73jn/td-fpga-developing-board/documents/Presentation_final/assembly.jpg

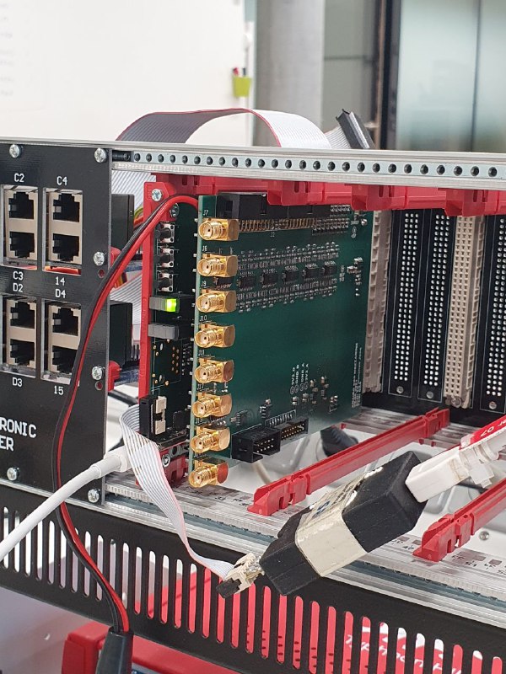
documents/Presentation_final/assembly.jpg
