73jn/td-fpga-developing-board/FPGA-POETIC/ReferenceBoards/FPGA-Rack_v1/01_Doc/Intern/Whiteboard_schematic.jpg

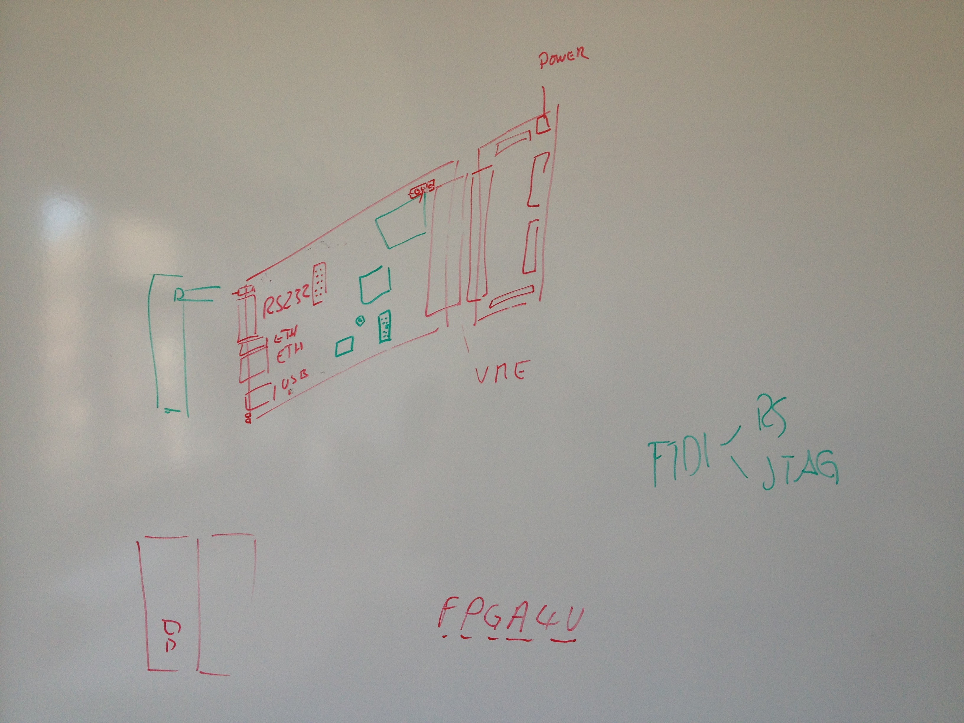
FPGA-POETIC/ReferenceBoards/FPGA-Rack_v1/01_Doc/Intern/Whiteboard_schematic.jpg
