73jn/td-fpga-developing-board/README.md

# td-fpga-developing-board
FPGA developing board for power electronics
