73jn/td-fpga-developing-board/documents/Rapport_intermédiaire/Rapport.docx

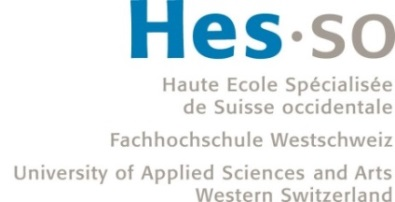
[picture p86: figure]

Filière Systèmes industriels

Orientation Infotronics

Travail de bachelor

Diplôme 2021

Alexandre Figueiredo

Cadeau

| Professeur Dr. Francesco Carrino
| Expert Alain Gruet
| Date de la remise du rapport 20.08.2021, 12 :00

Ce rapport est l'original remis par l'étudiant.
Il n'a pas été corrigé et peut donc contenir des inexactitudes ou des erreurs

HES-SO Valais-Wallis • rte du Rawil 47 • C.P. • 1950 Sion 2 +41 27 606 85 23 • info.ete@hevs.ch • www.hevs.ch/ete Page | 3

HES-SO Valais-Wallis • rte du Rawil 47 • C.P. • 1950 Sion 2 +41 27 606 85 23 • info.ete@hevs.ch • www.hevs.ch/ete
