73jn/td-fpga-developing-board/Schema_bloc/SchemaBlocV2.pdf

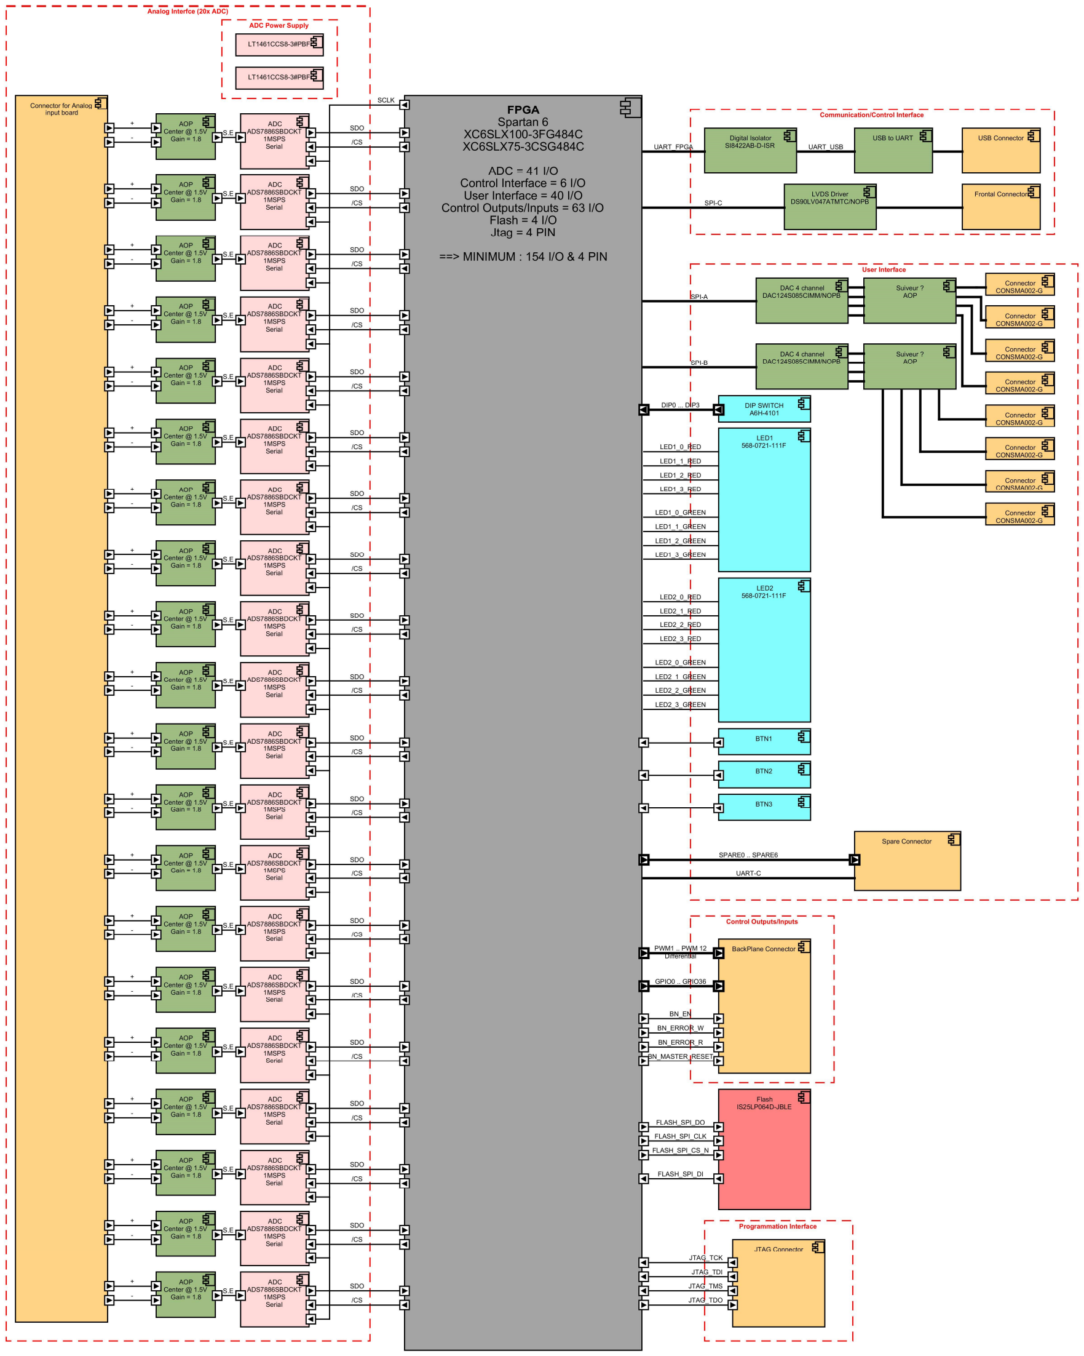
[picture p87: page 1]
