73jn/td-fpga-developing-board/Simulations/SimulationAnalogDifferential.pdf

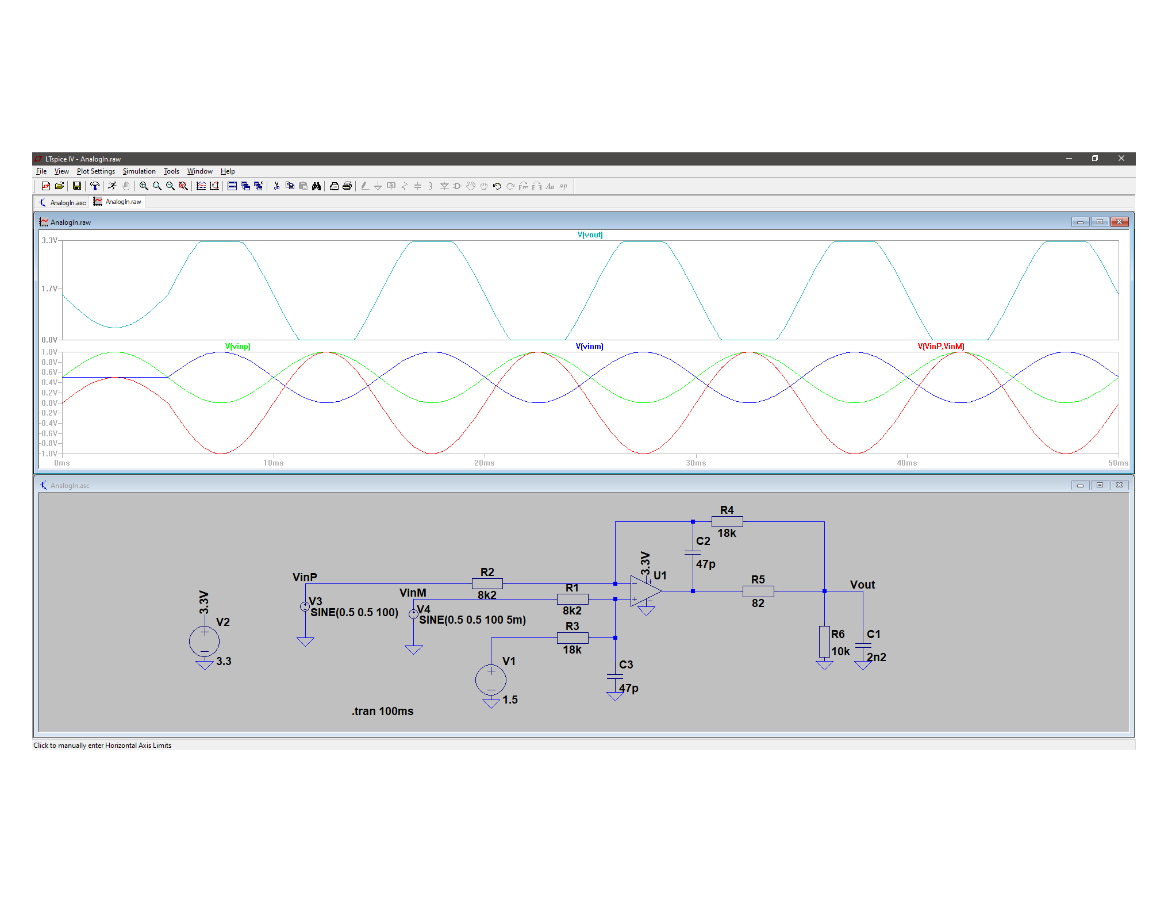
[picture p88: page 1]
