73jn/td-fpga-developing-board/Simulations/200k_0_7MSPS.pdf

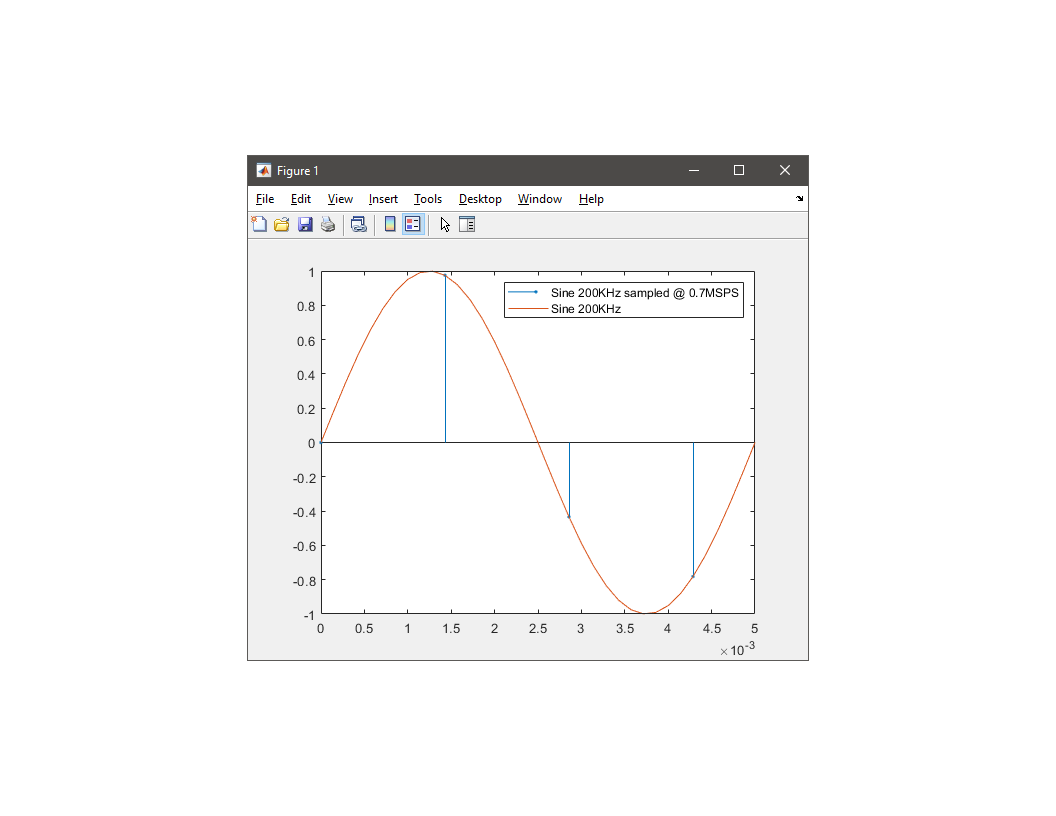
[picture p89: page 1]
