73jn/td-fpga-developing-board/Simulations/Sine200k_14MSPS.pdf

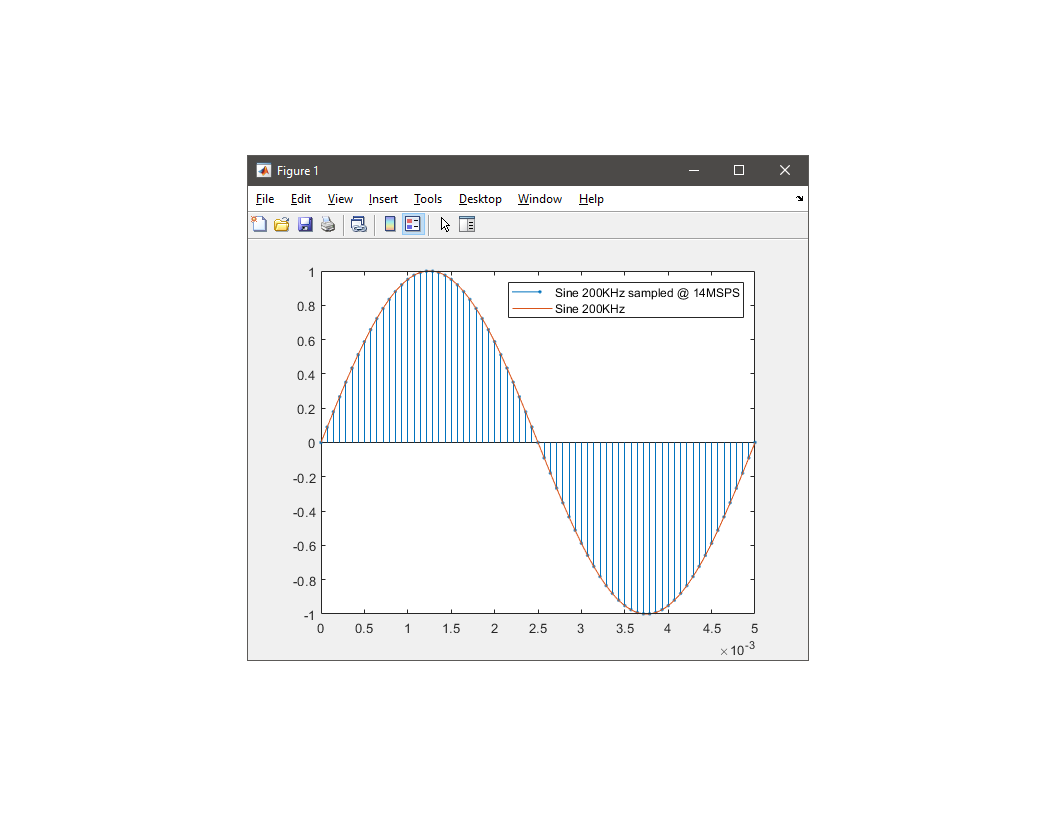
[picture p90: page 1]
