73jn/td-fpga-developing-board/Simulations/Sine200k_20MSPS.pdf

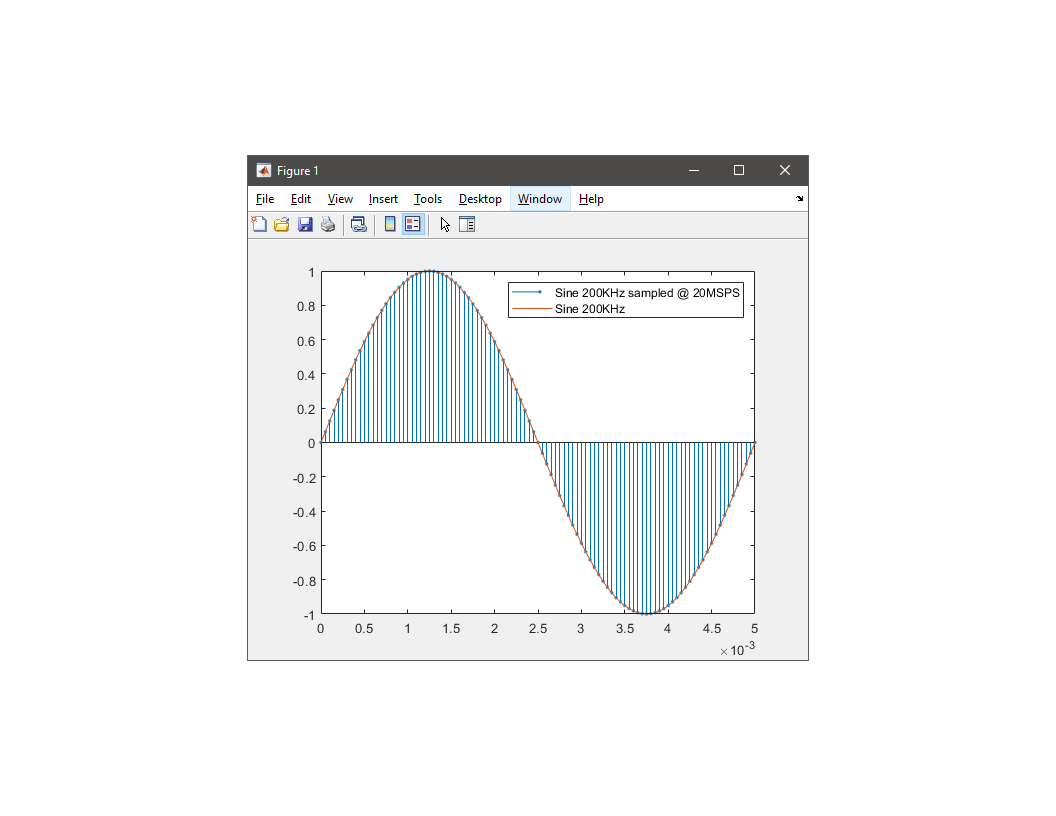
[picture p91: page 1]
