73jn/td-fpga-developing-board/Simulations/Sine200k_25MSPS.pdf

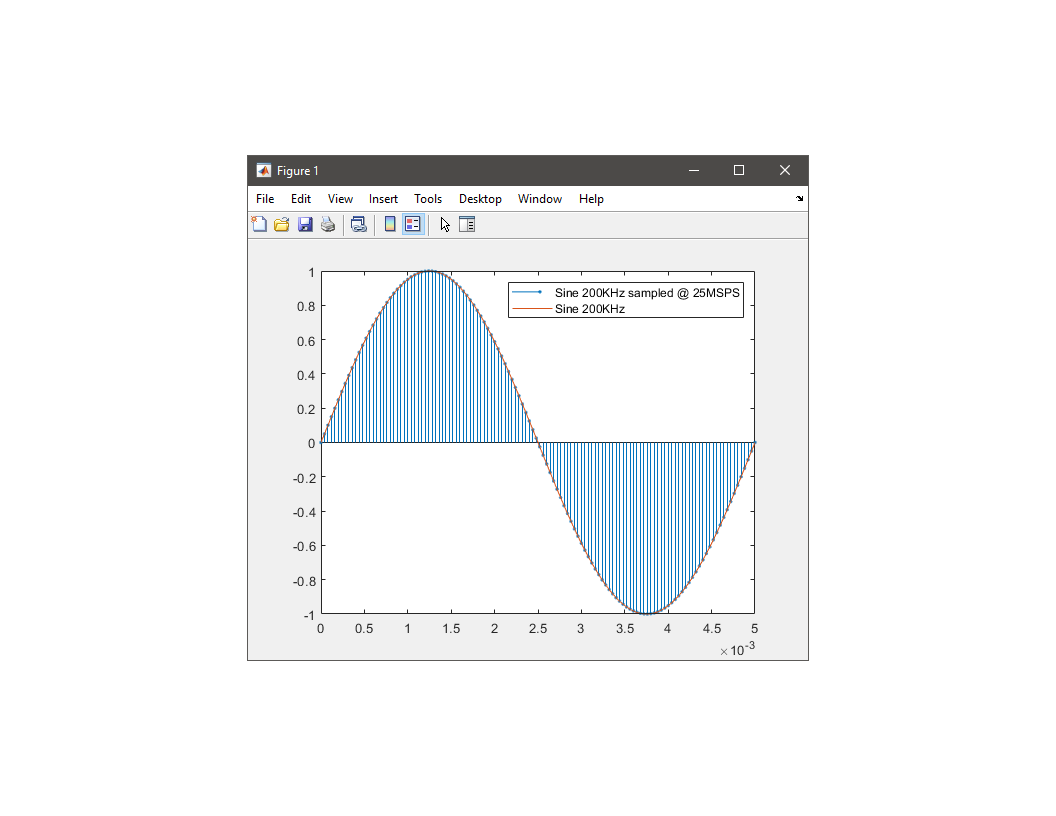
[picture p92: page 1]
