73jn/td-fpga-developing-board/Simulations/Sine200k_65MSPS.pdf

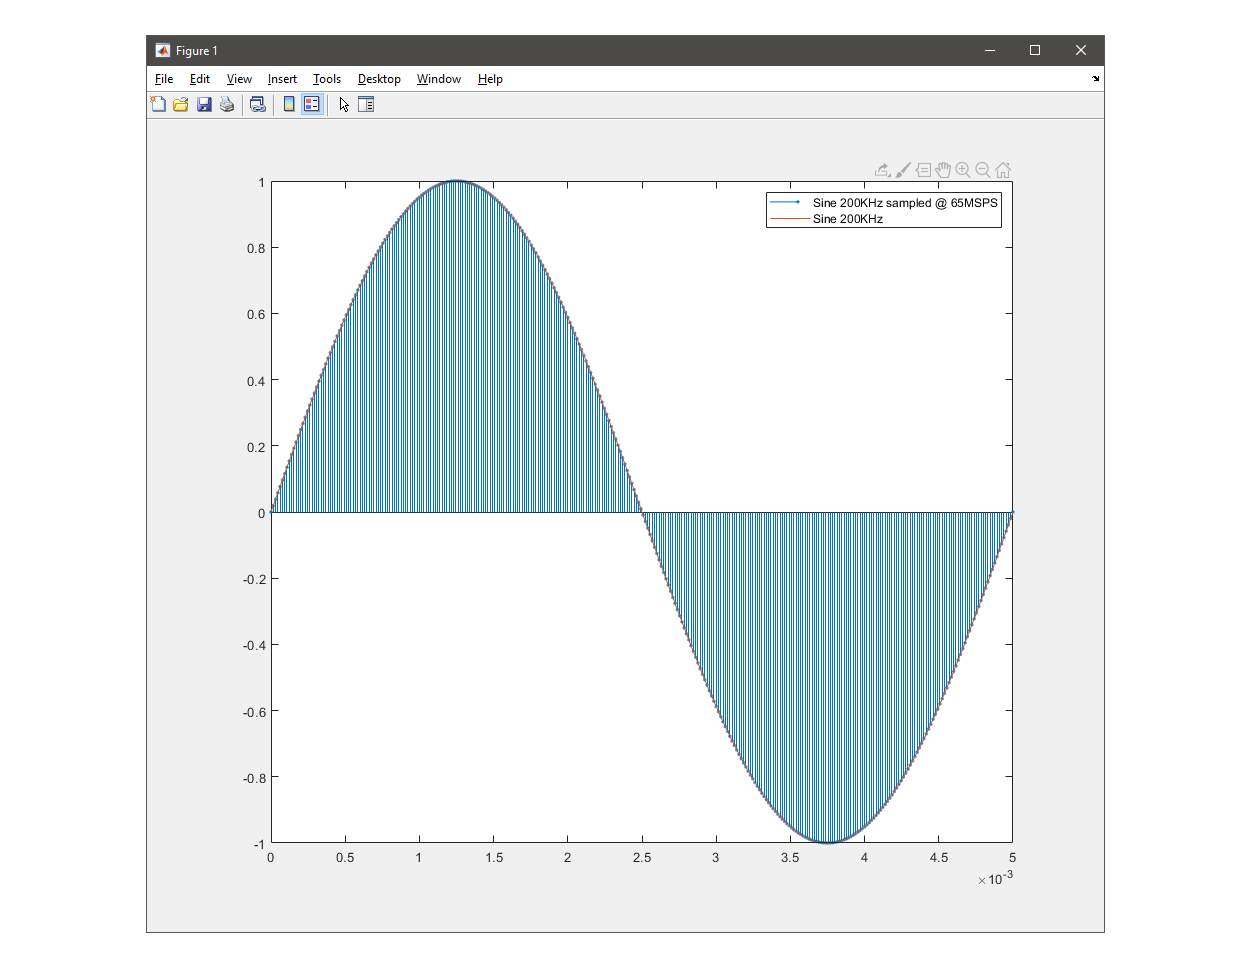
[picture p93: page 1]
