73jn/td-fpga-developing-board/Schema_bloc/SchemaBlocV1.pdf

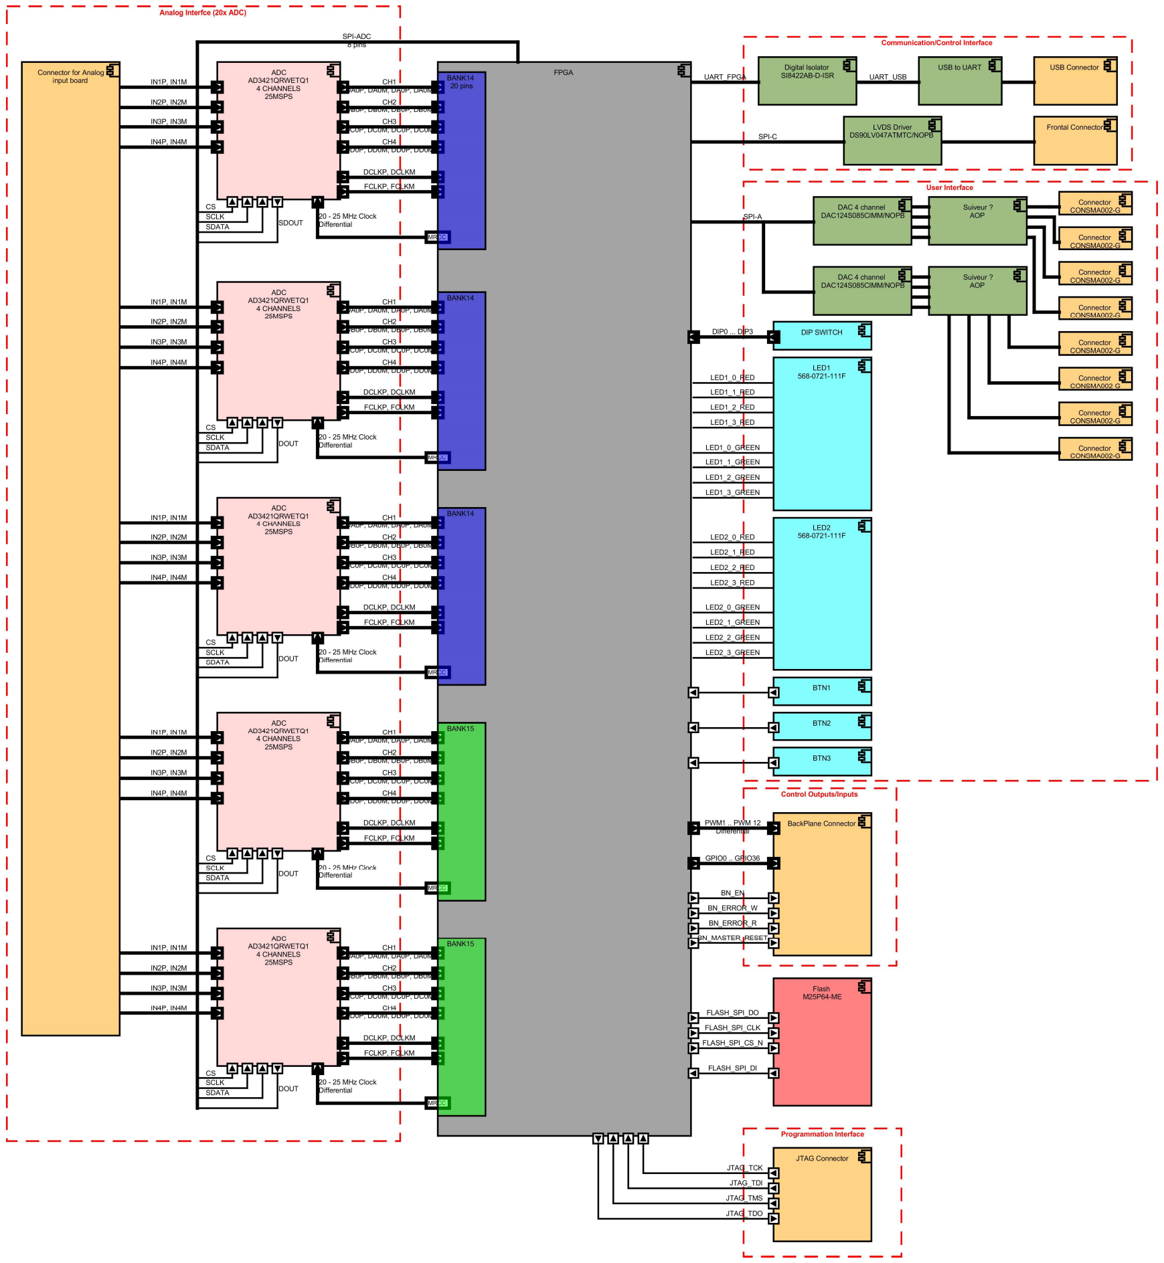
[picture p94: page 1]
