73jn/td-fpga-developing-board/documents/Presentation_final/bloc_rack.png

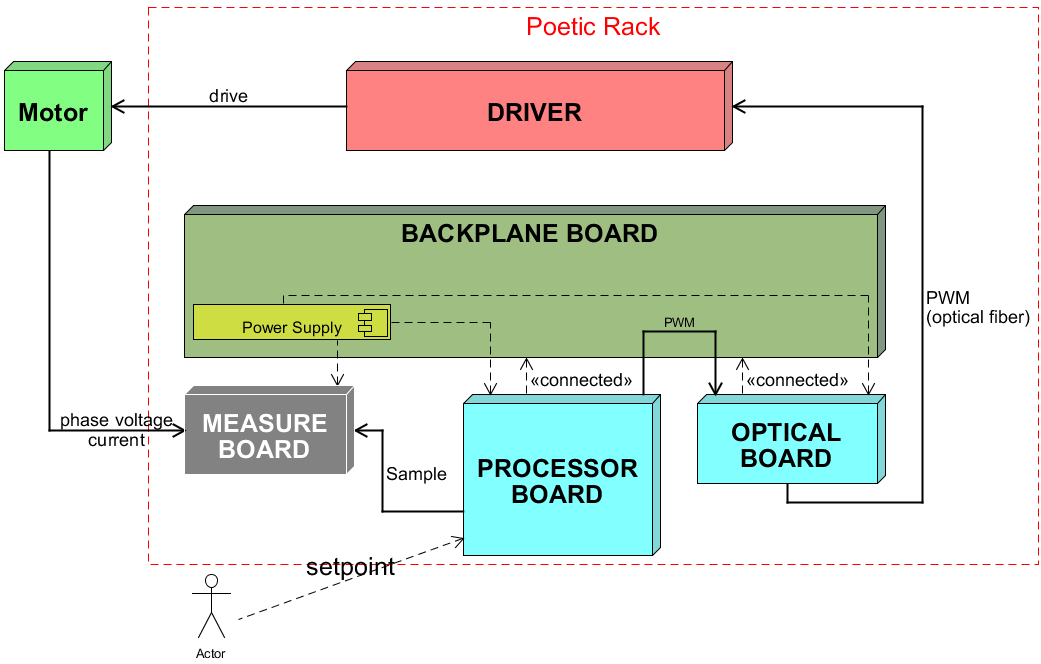
documents/Presentation_final/bloc_rack.png
