73jn/td-fpga-developing-board/documents/Presentation_final/hil.gif

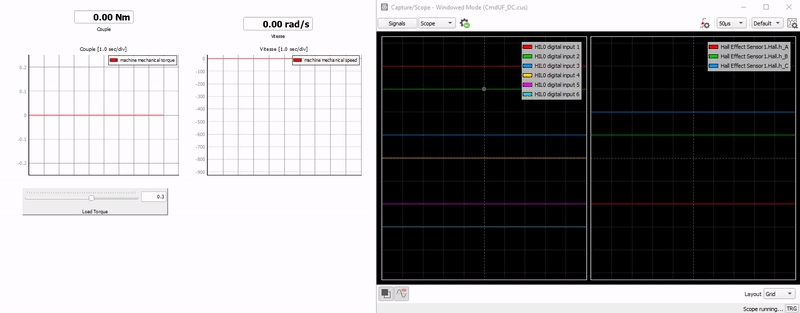
documents/Presentation_final/hil.gif
