73jn/td-fpga-developing-board/documents/Presentation_final/t1k.jpg

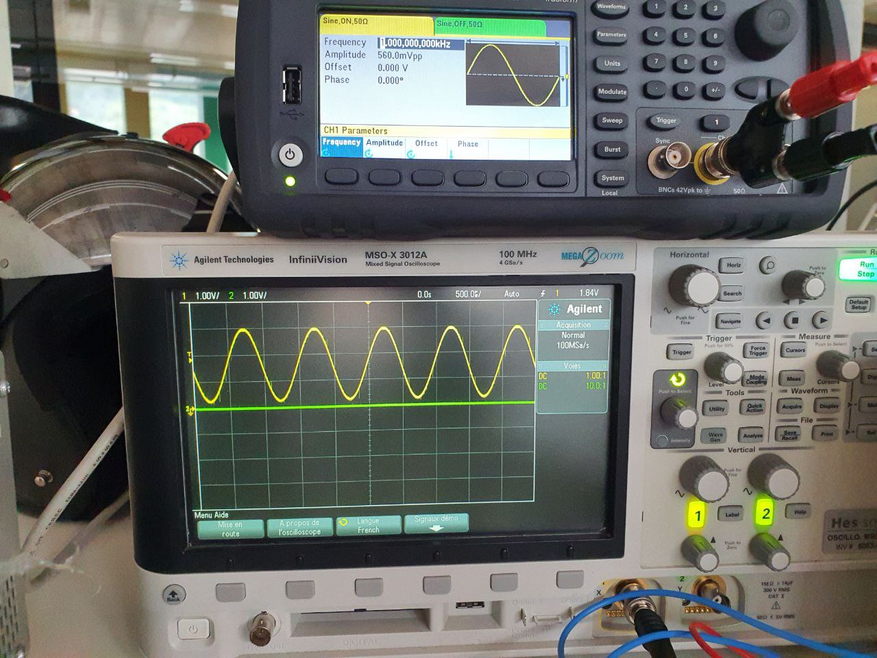
documents/Presentation_final/t1k.jpg
