73jn/td-fpga-developing-board/documents/Presentation_final/t25k.jpg

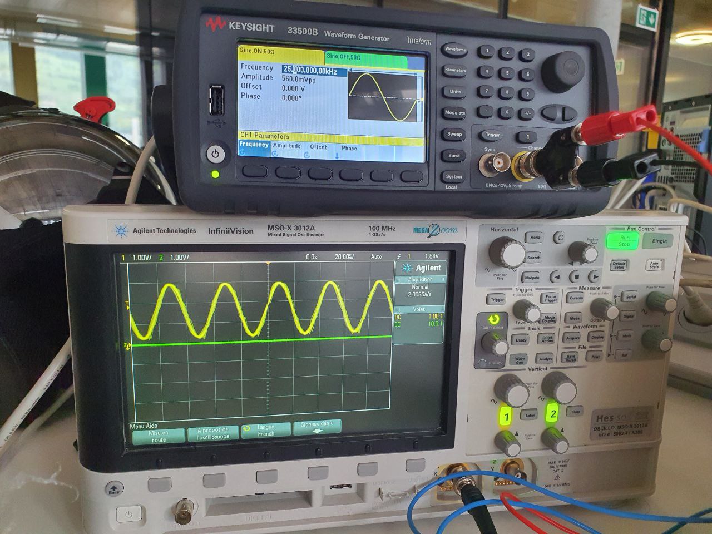
documents/Presentation_final/t25k.jpg
