73jn/td-fpga-developing-board/documents/Presentation_final/t50k.jpg

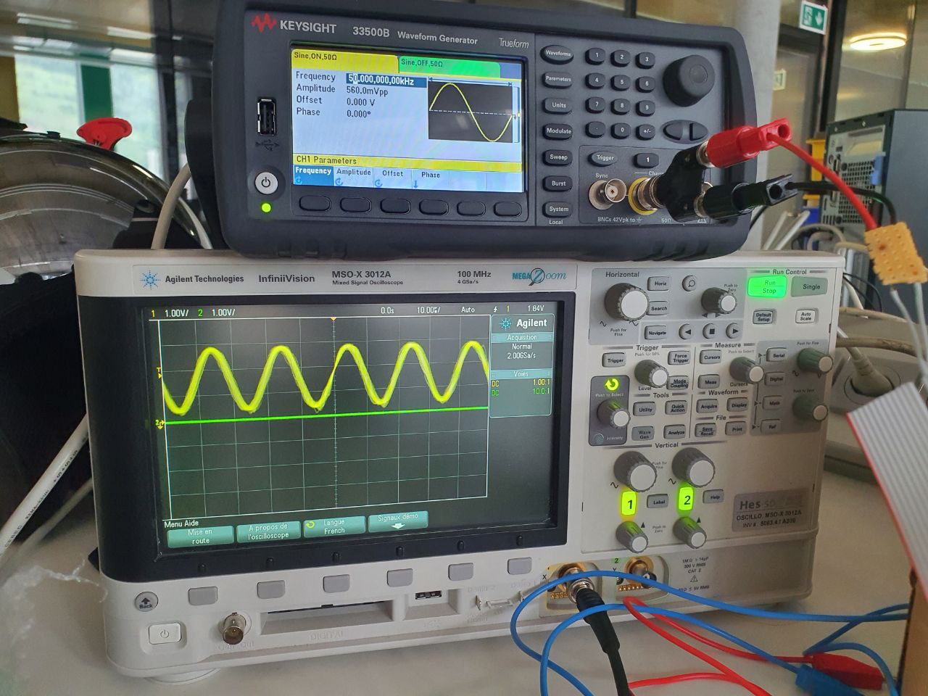
documents/Presentation_final/t50k.jpg
