73jn/td-fpga-developing-board/FPGA-POETIC/ReferenceBoards/FPGA-Rack_v1/01_Doc/Intern/fpga_rack_system.png

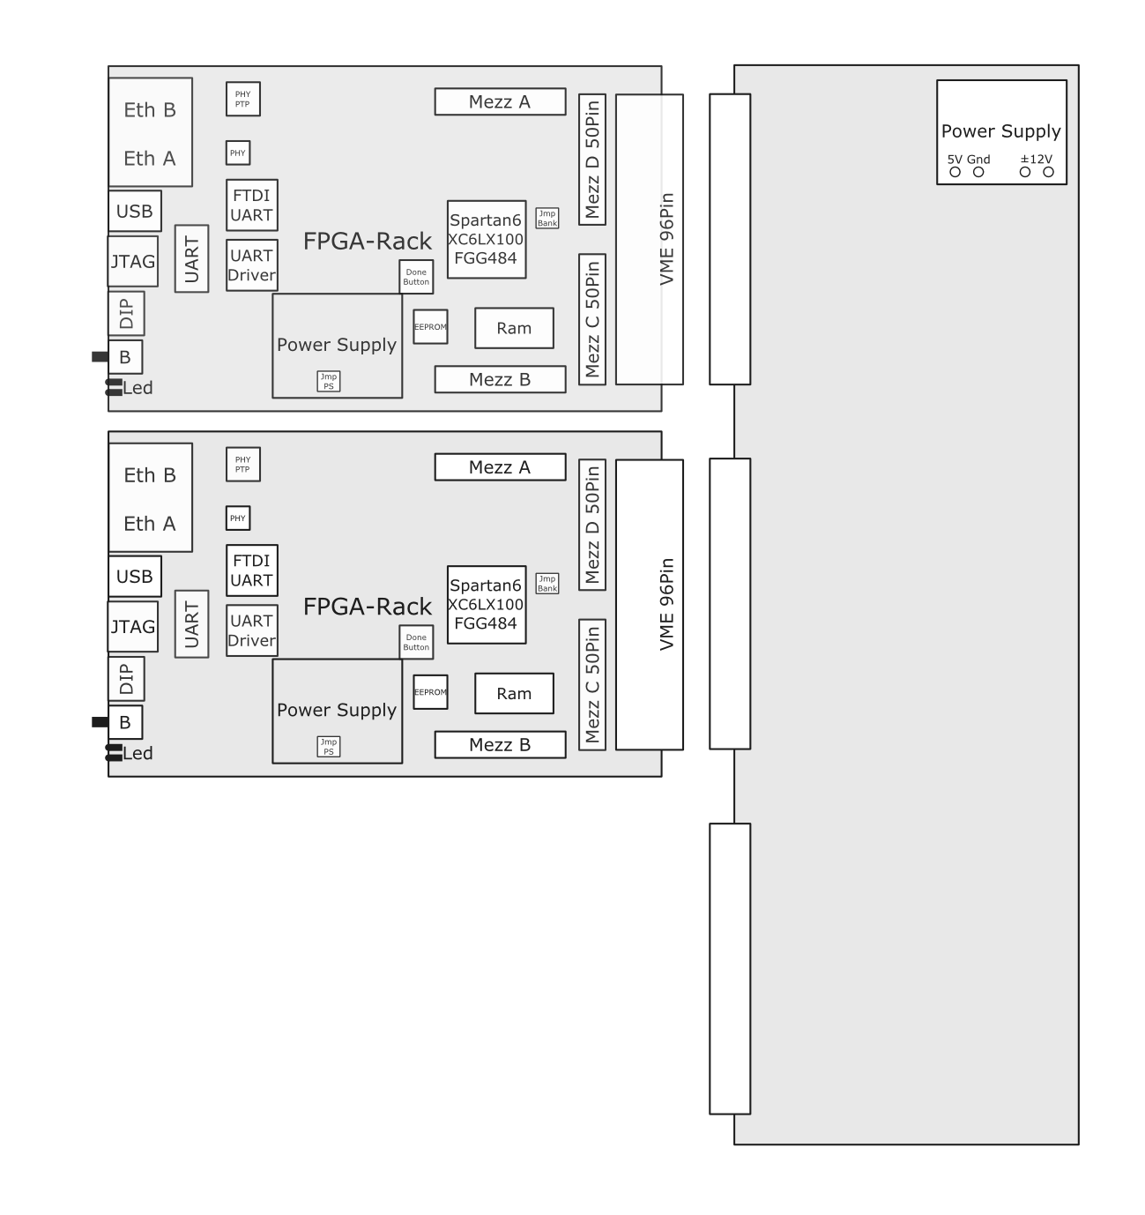
FPGA-POETIC/ReferenceBoards/FPGA-Rack_v1/01_Doc/Intern/fpga_rack_system.png
