73jn/td-fpga-developing-board/FPGA-POETIC/ReferenceBoards/FPGA-Rack_v1/04_PCB/FPGA_Rack_v1_0.jpg

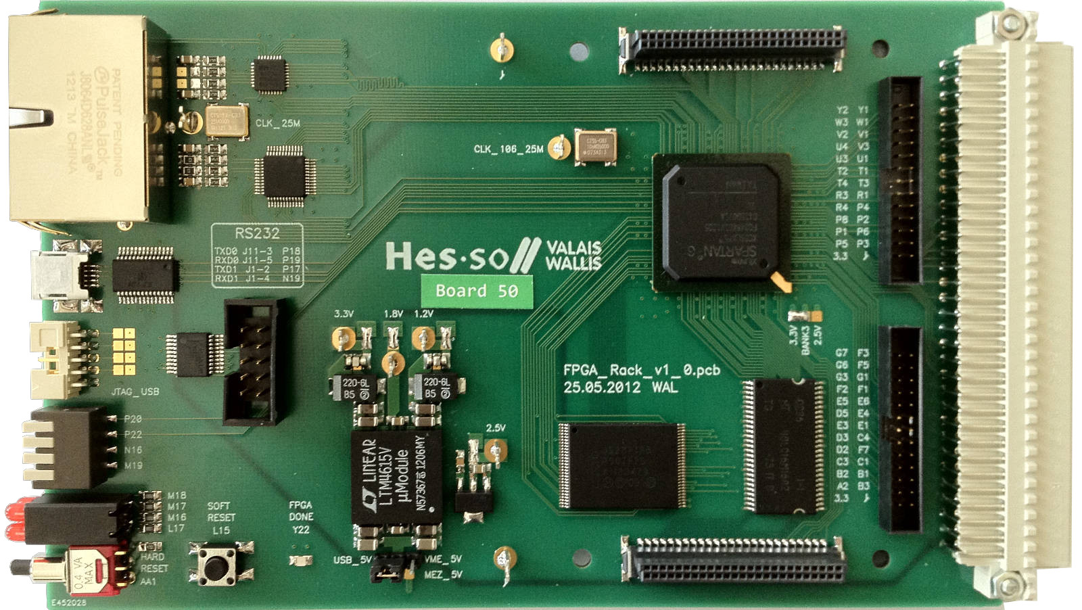
FPGA-POETIC/ReferenceBoards/FPGA-Rack_v1/04_PCB/FPGA_Rack_v1_0.jpg
