73jn/td-fpga-developing-board/FPGA-POETIC/ReferenceBoards/FPGA-Rack_v1/FPGARack_LedsnButtons.png

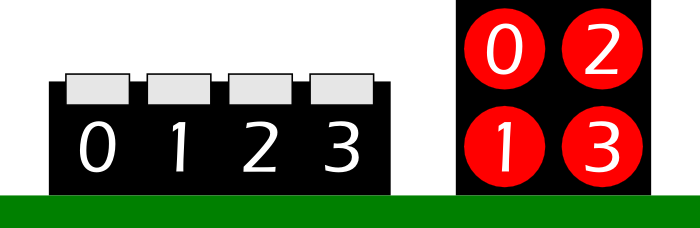
FPGA-POETIC/ReferenceBoards/FPGA-Rack_v1/FPGARack_LedsnButtons.png
