73jn/td-fpga-developing-board/FPGA-POETIC/ReferenceBoards/FPGA-Rack_v1/FPGARack_LedsnButtonspage.png

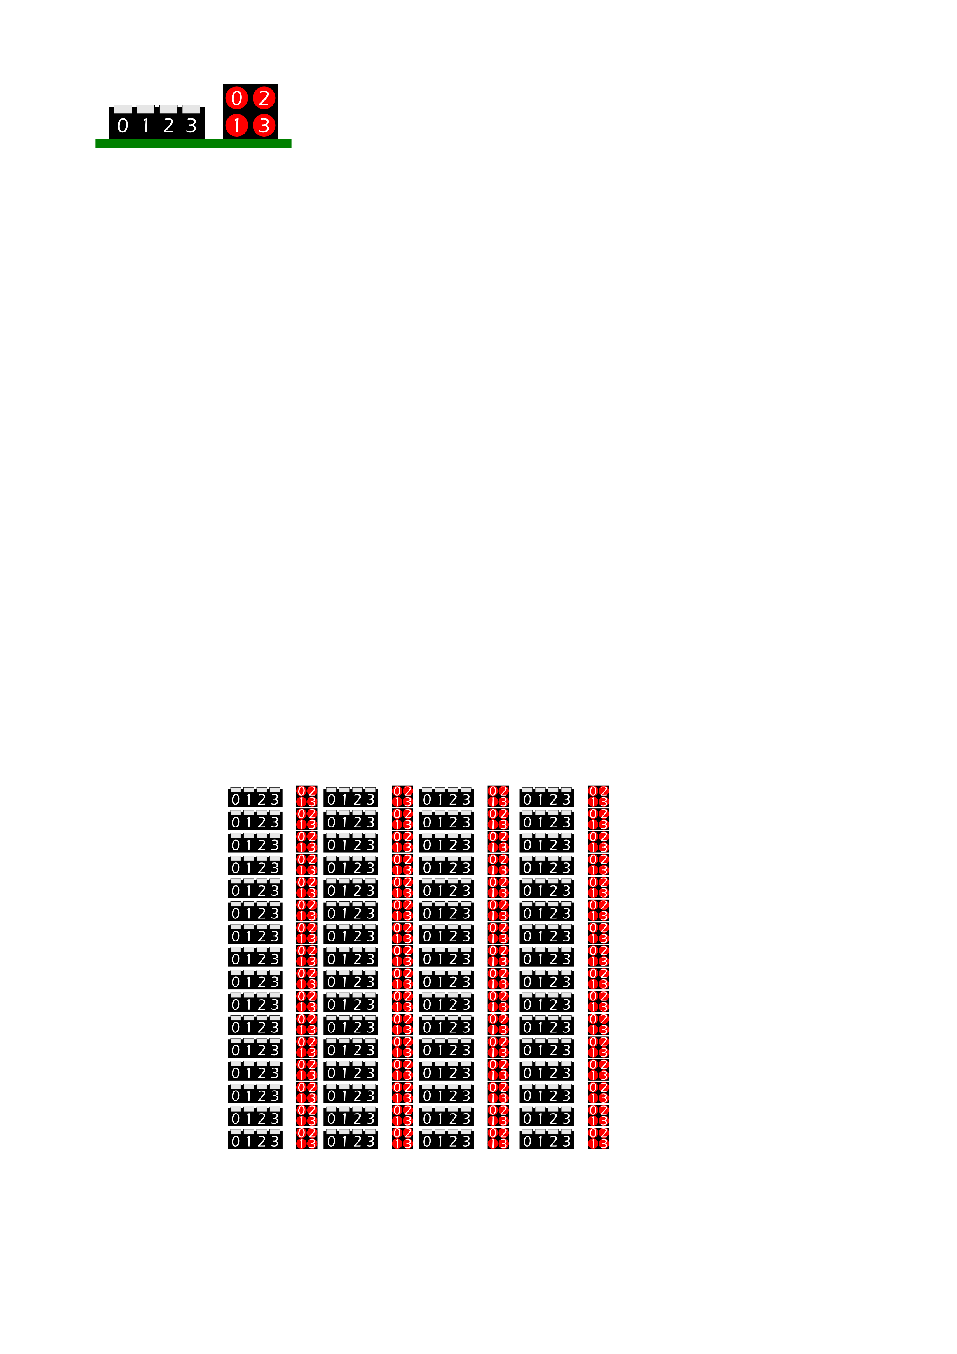
FPGA-POETIC/ReferenceBoards/FPGA-Rack_v1/FPGARack_LedsnButtonspage.png
