73jn/td-fpga-developing-board/summary.png

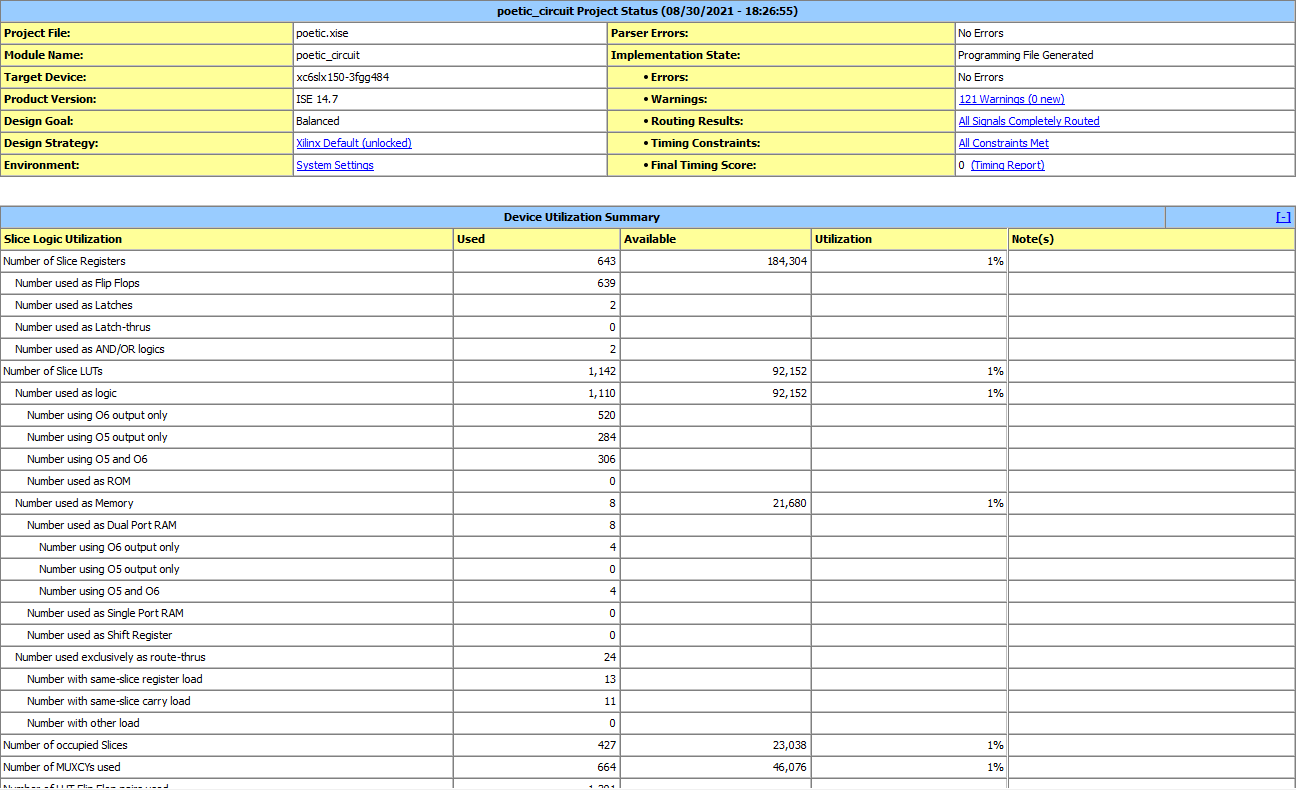
summary.png
