73jn/td-fpga-developing-board/order_files/FichierDeCommandeFpgaDevelopingBoard.xls

Sheet: Sheet1
Personne concernée: | Jean Nanchen
Mandat no.: | TD FPGA DEVELOPING BOARD | Chef de projet / professeur: | Corthay
Salle: | 321 | Délai désiré | 2021-05-19
Mouser |  |  | Monnaie
Quantity | Reference | Designation | Unit Price
1 | 217-C6SLX150-3FG484C | XC6SLX150-3FG484C | 267.00 | 267.00 | UNE LX100 OU LX75 IS OK
1 | 710-150060VS75000 | LED Verte FPGA DONE 2V 20mA | 0.14 | 0.14
2 | 653-B3U-1000P-B | Push buttons Reset | 0.90 | 1.80
1 | 710-831022731 | Quartz 100MHz FPGA | 2.43 | 2.43
1 | 998-KSZ8041TL | Ethernet PHY | 2.39 | 2.39
2 | 78-1N4148WS-HG3-08 | 1N4141 SOD323-2 | 0.36 | 0.73
1 | 710-831019170 | Quartz 25MHz ETH | 1.22 | 1.22
1 | 673-J0011D01BNL | Ethernet RJ45 Connector without EMI Fingers | 8.51 | 8.51
1 | 727-S25FL064LABMA000 | 64Mb flash | 2.20 | 2.20
3 | 506-FSMRA4JH04 | Right angle button FSMRA4JH04 | 0.23 | 0.70
1 | 653-A6H-4101 | Dip Switch | 2.20 | 2.20
1 | 848-RP402N501F-TR-FE | DC/DC 5V 800mA Boost | 1.48 | 1.48
1 | 963-NRS5020T2R2NMGJ | Bobine 2.2uH 5020 | 0.32 | 0.32
1 | 584-ADP2119ACPZ1.2R7 | DC/DC 1.2V Buck | 3.00 | 3.00
1 | 710-74437334015 | Bobine 1.5uH 5020 | 2.32 | 2.32
1 | 947-SC189ZSKTRT | DC/DC 3.3V 1.5A | 1.14 | 1.14
1 | 710-74437334022 | Bobine 2.2uH 5020 3.5A | 2.32 | 2.32
2 | 305-234199 | MEZZANINE 13.65mm FEMALE | 7.40 | 14.80 | MANQUE LA MEZZA, PAS DE STOCK
10 | 81-GRM21BZ70J226ME4L | Capa X7R 22uF 6.3V | 0.46 | 4.60
2 | 645-568-0721-111F | 4 LEDs Bipolar Red-Green Stacked | 3.88 | 7.76
1 | 617-09-03-196-6921 | Connecteur DIN 41612 Backplane | 3.98 | 3.98
2 | 604-AA1608SURSK | LED RED 1.95V | 0.43 | 0.86
1 | 649-98464-G6110ULF | JTAG Right angle Connector | 1.85 | 1.85
1 | 523-12402054M611A | USB C Right angle up | 1.60 | 1.60
1 | 895-FT232RQ | USB Interface to UART FT232RL | 4.31 | 4.31
10 | 81-GRM31CR60J107ME9K | Capa X5R 100uF 3216 | 1.00 | 10.00
15 | 80-C0805X475K9R | Capa X7R 4.7uF 6.3V 0805 | 0.70 | 10.50
30 | 80-C0402C474K9RACTU | Capa X7R 470nF 0402 | 0.46 | 13.80
2 | 754-RG1608P-6491-BT5 | 6.49kOhm 1608 | 0.40 | 0.80
5 | 754-RG1608P-49R9-BT5 | 49.9 Ohm 1608 | 0.40 | 2.00
 |  |  |  | 376.76
Eurocircuit |  |  | Monnaie | CHF
Quantity | Reference | Designation | Unit Price
3 |  | PCB | 83.33 | 250.00
 |  |  |  | 250.00

Sheet: Compatibility Report
Compatibility Report for moule_cmd.xls
Run on 18.10.2017 14:31
If the workbook is saved in an earlier file format or opened in an earlier version of Microsoft Excel, the listed features will not be available.
Minor loss of fidelity | # of occurrences | Version
Some cells or styles in this workbook contain formatting that is not supported by the selected file format. These formats will be converted to the closest format available. | 10 | Excel 97-2003
