73jn/td-fpga-developing-board/order_files/Mezza_FichierDeCommandeFpgaDevelopingBoard.xls

Sheet: Sheet1
Personne concernée: | Jean Nanchen
Mandat no.: | TD Nanchen Jean | Chef de projet / professeur: | Corthay
Salle: | 321 | Délai désiré | 2021-06-18
Mouser |  |  | Monnaie
Quantity | Reference | Designation | Unit Price
20 | 595-ADS7886SBDBVR | AD 1MSPS Serial 1CH 12bits | 4.08 | 81.60
1 | 584-LT1461CCS8-3#PBF | 3V Reference 100mA | 4.31 | 4.31
2 | 926-DAC124S085CIMMNO | DAC 4CH 12bits SPI | 6.87 | 13.74
2 | 200-TSS11004LDRA | Connecteur Cable Plat Signaux | 3.75 | 7.50
1 | 584-AD8646ARZ | AOP 2 CH Rail-to-Rail AD8646ARZ | 2.47 | 2.47
7 | 584-AD8648ARZ-R | AOP 4 CH Rail-to-Rail AD8648ARZ-REEL | 2.69 | 18.83
8 | 712-CONSMA002-G | SMA Right Angle | 5.89 | 47.12
1 | 200-TST10501GD | SPIC LVDS Connector 2.54mm | 2.43 | 2.43
1 | 200-STMM10902GDSM | Connecteur SPARE | 6.84 | 6.84
3 | 595-REF3130AIDBZR | Référence tension 3V | 2.80 | 8.40
2 | 305-244856 | Mezzanine MALE 3.65mm | 7.55 | 15.10
1 | 926-DS90LV018ATMNOPB | Receiver LVDS 1 CH | 1.68 | 1.68
1 | 926-DS90LV047ATMTCNO | Interface LVDS DS90LV047ATMTC/NOPB | 3.40 | 3.40
 |  |  |  | 213.42
Eurocircuit |  |  | Monnaie | CHF
Quantity | Reference | Designation | Unit Price
3 |  | PCB | 71.67 | 215.00
 |  |  |  | 215.00

Sheet: Compatibility Report
Compatibility Report for moule_cmd.xls
Run on 18.10.2017 14:31
If the workbook is saved in an earlier file format or opened in an earlier version of Microsoft Excel, the listed features will not be available.
Minor loss of fidelity | # of occurrences | Version
Some cells or styles in this workbook contain formatting that is not supported by the selected file format. These formats will be converted to the closest format available. | 10 | Excel 97-2003
