73jn/td-fpga-developing-board/POETIC_FILES/POETIC_AD_input_V2/POETIC_AD_Input_V2_BOM.xls

Carte | Approvisionnement | Montage | Boîtier | Name | Description | Designator | Quantity | Manufacturer 1 | Manufacturer Part Number 1 | Manufacturer Lifecycle 1 | Supplier 1 | Supplier Part Number 1 | Supplier Unit Price 1 | Supplier Subtotal 1
AD_Input | Telsa | Telsa | smd | 4p7 | Capacitor X7R 50V 2012(0805) | C1, C2, C3, C4, C5, C6, C7, C8, C9, C10, C11, C12, C13, C14, C15, C16, C17, C18, C19, C20 | 20 |  |  |  |  |  | 0 | 0
AD_Input | Telsa | Telsa | smd | 1k8 | Resistor 1% 50V 125mW 2012(0805) | R1, R2, R3, R4, R5, R6, R7, R8, R9, R10, R11, R12, R13, R14, R15, R16, R17, R18, R19, R20 | 20 |  |  |  |  |  | 0 | 0
AD_Input | Telsa | Telsa | smd | 10k | Resistor 1% 50V 125mW 2012(0805) | R21, R22, R23, R24, R25, R26, R27, R28, R29, R30, R31, R32, R33, R34, R35, R36, R37, R38, R39, R40 | 20 |  |  |  |  |  | 0 | 0
AD_Input | Hes-so | Telsa | traversant | E5908-4V0S54-L | RJ45 2X1 8P8C Ethernet Connectors CONN 30u Au THT | J1, J2, J3, J4, J5 | 5 | Pulse Electronics | E5908-4V0S54-L | Volume Production | Mouser | 673-E5908-4V0S54-L | 3.68 | 18.4
AD_Input | Hes-so | Telsa | traversant | 43045-0412 | Micro-Fit 3.0 Vertical Header, 3.00mm Pitch, Dual Row, 4 Circuits | J9 | 1 | Molex | 43045-0412 | Volume Production | Mouser | 538-43045-0412 | 1.26 | 1.26
AD_Input | Hes-so | Telsa | traversant | 61202021621 | FlatCable2x10 2.54mm Straight TH | J11 | 1 | Wurth Electronics | 61202021621 | Volume Production | Mouser | 710-61202021621 | 0.89 | 0.89
AD_Input | Hes-so | Telsa | traversant | 890-18-036-10-803 | JUMPER 2 POS | JP1, JP2, JP3, JP4, JP5, JP6, JP7, JP8, JP9, JP10, JP11, JP12, JP13, JP14, JP15, JP16, JP17, JP18, JP19, JP20 | 20 | Preci-Dip | 890-18-036-10-803 | Manual Solution | Distrelec | 143-83-920 | 1.46 | 29.2
 |  |  |  |  | Nombre de Circuit |  | 32
AD_Input | Telsa | Telsa | smd | 4p7 | Capacitor X7R 50V 2012(0805) | C1, C2, C3, C4, C5, C6, C7, C8, C9, C10, C11, C12, C13, C14, C15, C16, C17, C18, C19, C20 | 640 |  |  |  |  |  | 0 | 0
AD_Input | Telsa | Telsa | smd | 1k8 | Resistor 1% 50V 125mW 2012(0805) | R1, R2, R3, R4, R5, R6, R7, R8, R9, R10, R11, R12, R13, R14, R15, R16, R17, R18, R19, R20 | 640 |  |  |  |  |  | 0 | 0
AD_Input | Telsa | Telsa | smd | 10k | Resistor 1% 50V 125mW 2012(0805) | R21, R22, R23, R24, R25, R26, R27, R28, R29, R30, R31, R32, R33, R34, R35, R36, R37, R38, R39, R40 | 640 |  |  |  |  |  | 0 | 0
AD_Input | Hes-so | Telsa | traversant | E5908-4V0S54-L | RJ45 2X1 8P8C Ethernet Connectors CONN 30u Au THT | J1, J2, J3, J4, J5 | 160 | Pulse Electronics | E5908-4V0S54-L | Volume Production | Mouser | 673-E5908-4V0S54-L | 3.68 | 588.8
AD_Input | Hes-so | Telsa | traversant | 43045-0412 | Micro-Fit 3.0 Vertical Header, 3.00mm Pitch, Dual Row, 4 Circuits | J9 | 32 | Molex | 43045-0412 | Volume Production | Mouser | 538-43045-0412 | 1.26 | 40.32
AD_Input | Hes-so | Telsa | traversant | 61202021621 | FlatCable2x10 2.54mm Straight TH | J11 | 32 | Wurth Electronics | 61202021621 | Volume Production | Mouser | 710-61202021621 | 0.89 | 28.48
AD_Input | Hes-so | Telsa | traversant | 890-18-036-10-803 | JUMPER 2 POS | JP1, JP2, JP3, JP4, JP5, JP6, JP7, JP8, JP9, JP10, JP11, JP12, JP13, JP14, JP15, JP16, JP17, JP18, JP19, JP20 | 640 | Preci-Dip | 890-18-036-10-803 | Manual Solution | Distrelec | 143-83-920 | 1.46 | 934.4
