73jn/td-fpga-developing-board/POETIC_FILES/POETIC_Backplane_V2/POETIC_Backplane_V2_BOM.xls

Carte | Approvisionnement | Montage | Boîtier | Name | Description | Designator | Quantity | Manufacturer 1 | Manufacturer Part Number 1 | Supplier 1 | Supplier Part Number 1 | Supplier Unit Price 1 | Supplier Subtotal 1
Backplane | Hes-so | Telsa | traversant | 100u / 50V | Capacitor polarized | C1, C3, C5 | 3 | Panasonic | EEUFR1H101 | Mouser | 667-EEU-FR1H101 | 0.44 | 1.32
Backplane | Hes-so | Telsa | traversant | 100n / 35V | Capacitor | C2, C4, C6 | 3 | Vishay BCcomponents | K104K15X7RF53L2 | Mouser | 594-K104K15X7RF53L2 | 0.17 | 0.51
Backplane | Hes-so | Telsa | traversant | 22u / 50V | Capacitor polarized | C7, C8, C9 | 3 | Panasonic | EEU-FR1H220 | Mouser | 667-EEU-FR1H220 | 0.31 | 0.93
Backplane | Hes-so | Telsa | traversant | 1A | Fuse Cartridge 5x20 | F1 | 1 |  |  |  |  | 0 | 0
Backplane | Hes-so | Telsa | traversant | 09032967824 | DIN41612 FEM 3X32 ABC STRAIGHT | J3, J6, J8, J10, J18, J20, J22, J24, J26 | 9 | Harting | 9032967824 | Mouser | 617-09032967824 | 4.28 | 38.52
Backplane | Hes-so | Telsa | traversant | 1790351 | Phoenix Contact PCB terminal block - FFKDSA/H1-7,62 - 1790351 | J11, J12, J13 | 3 | Phoenix Contact | 1790351 | Mouser | 651-1790351 | 1.83 | 5.49
Backplane | Hes-so | Telsa | traversant | 43045-0412 | Micro-Fit 3.0 Vertical Header, 3.00mm Pitch, Dual Row, 4 Circuits | J14, J15, J16 | 3 | Molex | 43045-0412 | Mouser | 538-43045-0412 | 1.26 | 3.78
Backplane | Hes-so | Telsa | traversant | 98414-G06-14ULF | FlatCable2x7 | J27 | 1 | Amphenol FCI | 98414-G06-14ULF | Mouser | 649-98414-G06-14ULF | 1.35 | 1.35
Backplane | Hes-so | Telsa | traversant | 43045-0612 | Micro-Fit 3.0 Vertical Header, 3.00mm Pitch, Dual Row, 6 Circuits | J28 | 1 | Molex | 43045-0612 | Mouser | 538-43045-0612 | 1.43 | 1.43
Backplane | Hes-so | Telsa | traversant | 2u2, 6A, R=10m | Inductor | L1, L2, L3 | 3 | Fastron | 07HCP-2R2M-50 | Mouser | 434-07HCP-2R2M | 0.81713 | 2.45139
Backplane | Hes-so | Telsa | traversant | IRM20-24 | AC-DC 20W Single Output Encapsulated Type Converter | U1 | 1 | Mean Well | IRM-20-24 | Mouser | 709-IRM20-24 | 9.13 | 9.13
Backplane | Hes-so | Telsa | traversant | IRM20-3.3 | AC-DC 20W Single Output Encapsulated Type Converter | U2 | 1 | Mean Well | IRM-20-3.3 | Mouser | 709-IRM20-3.3 | 10.38 | 10.38
Backplane | Hes-so | Telsa | traversant | IRM20-5 | AC-DC 20W Single Output Encapsulated Type Converter | U3 | 1 | Mean Well | IRM-20-5 | Mouser | 709-IRM20-5 | 9.13 | 9.13
 |  |  |  |  | Nombre de Circuit |  | 12
Backplane | Hes-so | Telsa | traversant | 100u / 50V | Capacitor polarized | C1, C3, C5 | 36 | Panasonic | EEUFR1H101 | Mouser | 667-EEU-FR1H101 | 0.44 | 15.84
Backplane | Hes-so | Telsa | traversant | 100n / 35V | Capacitor | C2, C4, C6 | 36 | Vishay BCcomponents | K104K15X7RF53L2 | Mouser | 594-K104K15X7RF53L2 | 0.17 | 6.12
Backplane | Hes-so | Telsa | traversant | 22u / 50V | Capacitor polarized | C7, C8, C9 | 36 | Panasonic | EEU-FR1H220 | Mouser | 667-EEU-FR1H220 | 0.31 | 11.16
Backplane | Hes-so | Telsa | traversant | 1A | Fuse Cartridge 5x20 | F1 | 12 |  |  |  |  | 0 | 0
Backplane | Hes-so | Telsa | traversant | 09032967824 | DIN41612 FEM 3X32 ABC STRAIGHT | J3, J6, J8, J10, J18, J20, J22, J24, J26 | 108 | Harting | 9032967824 | Mouser | 617-09032967824 | 4.28 | 462.24
Backplane | Hes-so | Telsa | traversant | 1790351 | Phoenix Contact PCB terminal block - FFKDSA/H1-7,62 - 1790351 | J11, J12, J13 | 36 | Phoenix Contact | 1790351 | Mouser | 651-1790351 | 1.83 | 65.88
Backplane | Hes-so | Telsa | traversant | 43045-0412 | Micro-Fit 3.0 Vertical Header, 3.00mm Pitch, Dual Row, 4 Circuits | J14, J15, J16 | 36 | Molex | 43045-0412 | Mouser | 538-43045-0412 | 1.26 | 45.36
Backplane | Hes-so | Telsa | traversant | 98414-G06-14ULF | FlatCable2x7 | J27 | 12 | Amphenol FCI | 98414-G06-14ULF | Mouser | 649-98414-G06-14ULF | 1.35 | 16.2
Backplane | Hes-so | Telsa | traversant | 43045-0612 | Micro-Fit 3.0 Vertical Header, 3.00mm Pitch, Dual Row, 6 Circuits | J28 | 12 | Molex | 43045-0612 | Mouser | 538-43045-0612 | 1.43 | 17.16
Backplane | Hes-so | Telsa | traversant | 2u2, 6A, R=10m | Inductor | L1, L2, L3 | 36 | Fastron | 07HCP-2R2M-50 | Mouser | 434-07HCP-2R2M | 0.81713 | 29.41668
Backplane | Hes-so | Telsa | traversant | IRM20-24 | AC-DC 20W Single Output Encapsulated Type Converter | U1 | 12 | Mean Well | IRM-20-24 | Mouser | 709-IRM20-24 | 9.13 | 109.56
Backplane | Hes-so | Telsa | traversant | IRM20-3.3 | AC-DC 20W Single Output Encapsulated Type Converter | U2 | 12 | Mean Well | IRM-20-3.3 | Mouser | 709-IRM20-3.3 | 10.38 | 124.56
Backplane | Hes-so | Telsa | traversant | IRM20-5 | AC-DC 20W Single Output Encapsulated Type Converter | U3 | 12 | Mean Well | IRM-20-5 | Mouser | 709-IRM20-5 | 9.13 | 109.56
