73jn/td-fpga-developing-board/POETIC_FILES/POETIC_Processor_V2/POETIC_Processor_V2_BOM.xls

Carte | Approvisionnement | Montage | Boîtier | Name | Description | Footprint | Designator | Quantity | Manufacturer 1 | Manufacturer Part Number 1 | Manufacturer Lifecycle 1 | Supplier 1 | Supplier Part Number 1 | Supplier Unit Price 1 | Supplier Subtotal 1
PROCESSOR | Telsa | Telsa | smd | 15p | Capacitor X7R 10% 50V 1608(0603) | CAPACITOR 1608 REFLOW | C1, C2 | 2 |  |  |  |  |  | 0 | 0
PROCESSOR | Telsa | Telsa | smd | 47p | Capacitor X7R 10% 50V 1608(0603) | CAPACITOR 1608 REFLOW | C88, C89, C92, C93, C94, C95, C98, C99, C100, C101, C104, C105, C106, C107, C110, C111, C114, C115, C118, C119, C120, C121, C124, C125, C126, C127, C130, C131, C132, C133, C136, C137, C140, C142, C143, C145, C146, C148, C149, C151 | 40 |  |  |  |  |  | 0 | 0
PROCESSOR | Telsa | Telsa | smd | 2n2 | Capacitor X7R 10% 50V 1608(0603) | CAPACITOR 1608 REFLOW | C90, C91, C96, C97, C102, C103, C108, C109, C116, C117, C122, C123, C128, C129, C134, C135, C141, C144, C147, C150 | 20 |  |  |  |  |  | 0 | 0
PROCESSOR | Telsa | Telsa | smd | 100n | Capacitor X7R 10% 50V 1608(0603) | CAPACITOR 1608 REFLOW | C3, C4, C5, C6, C7, C8, C9, C10, C11, C12, C13, C19, C20, C21, C22, C23, C24, C25, C26, C27, C28, C29, C30, C31, C37, C38, C39, C59, C61, C62, C63, C64, C66, C68, C72, C73, C74, C75, C76, C77, C78, C79, C80, C81, C82, C83, C84, C85, C86, C87, C112, C113, C138, C139, C152, C161, C165, C166 | 58 |  |  |  |  |  | 0 | 0
PROCESSOR | Telsa | Telsa | smd | 2u2 | Capacitor X7R 10% 10V 1608(0603) | CAPACITOR 1608 REFLOW | C14, C15, C16, C17, C18, C32, C33, C34, C35, C36 | 10 |  |  |  |  |  | 0 | 0
PROCESSOR | Telsa | Telsa | smd | 100p | Capacitor X7R 10% 50V 2012(0805) | CAPACITOR 2012 REFLOW | C154, C156, C160, C163 | 4 |  |  |  |  |  | 0 | 0
PROCESSOR | Telsa | Telsa | smd | 150p | Capacitor X7R 10% 50V 2012(0805) | CAPACITOR 2012 REFLOW | C155, C157, C162, C164 | 4 |  |  |  |  |  | 0 | 0
PROCESSOR | Telsa | Telsa | smd | 100n | Capacitor X7R 10% 50V 2012(0805) | CAPACITOR 2012 REFLOW | C43, C48, C51, C69, C70, C71, C153, C158 | 8 |  |  |  |  |  | 0 | 0
PROCESSOR | Telsa | Telsa | smd | 1u | Capacitor X7R 10% 10V 2012(0805) | CAPACITOR 2012 REFLOW | C55, C159 | 2 |  |  |  |  |  | 0 | 0
PROCESSOR | Telsa | Telsa | smd | 3u3 | Capacitor X7R 10% 10V 2012(0805) | CAPACITOR 2012 REFLOW | C41, C45, C54 | 3 |  |  |  |  |  | 0 | 0
PROCESSOR | Telsa | Telsa | smd | 4u7 | Capacitor X7R 10% 10V 2012(0805) | CAPACITOR 2012 REFLOW | C56, C65, C67 | 3 |  |  |  |  |  | 0 | 0
PROCESSOR | Telsa | Telsa | smd | 10u | Capacitor X7R 10% 10V 2012(0805) | CAPACITOR 2012 REFLOW | C42, C44, C47, C49, C50, C53, C57, C58 | 8 |  |  |  |  |  | 0 | 0
PROCESSOR | Telsa | Telsa | smd | 4u7 | Capacitor Tantalum 10 % 10V 3528(1311-TAJ-B) | CAPACITOR POL 3528-21 REFLOW | C60 | 1 |  |  |  |  |  | 0 | 0
PROCESSOR | Telsa | Telsa | smd | nm | Resistor 1% 50V 100mW 1608(0603) | RESISTOR 1608 REFLOW | R4, R5 | 2 |  |  |  |  |  | 0 | 0
PROCESSOR | Telsa | Telsa | smd | 0 | Resistor 1% 50V 100mW 1608(0603) | RESISTOR 1608 REFLOW | R28 | 1 |  |  |  |  |  | 0 | 0
PROCESSOR | Telsa | Telsa | smd | 56R | Resistor 1% 50V 100mW 1608(0603) | RESISTOR 1608 REFLOW | R12, R19 | 2 |  |  |  |  |  | 0 | 0
PROCESSOR | Telsa | Telsa | smd | 82R | Resistor 1% 50V 100mW 1608(0603) | RESISTOR 1608 REFLOW | R51, R52, R63, R64, R75, R76, R87, R88, R99, R100, R111, R112, R123, R124, R135, R136, R145, R151, R157, R163 | 20 |  |  |  |  |  | 0 | 0
PROCESSOR | Telsa | Telsa | smd | 100R | Resistor 1% 50V 100mW 1608(0603) | RESISTOR 1608 REFLOW | R7 | 1 |  |  |  |  |  | 0 | 0
PROCESSOR | Telsa | Telsa | smd | 120R | Resistor 1% 50V 100mW 1608(0603) | RESISTOR 1608 REFLOW | R39, R40, R41, R42, R43, R44, R45, R46 | 8 |  |  |  |  |  | 0 | 0
PROCESSOR | Telsa | Telsa | smd | 220R | Resistor 1% 50V 100mW 1608(0603) | RESISTOR 1608 REFLOW | R24 | 1 |  |  |  |  |  | 0 | 0
PROCESSOR | Telsa | Telsa | smd | 560R | Resistor 1% 50V 100mW 1608(0603) | RESISTOR 1608 REFLOW | R14, R22 | 2 |  |  |  |  |  | 0 | 0
PROCESSOR | Telsa | Telsa | smd | 820R | Resistor 1% 50V 100mW 1608(0603) | RESISTOR 1608 REFLOW | R1, R2 | 2 |  |  |  |  |  | 0 | 0
PROCESSOR | Telsa | Telsa | smd | 1k | Resistor 1% 50V 100mW 1608(0603) | RESISTOR 1608 REFLOW | R25, R26, R27, R29 | 4 |  |  |  |  |  | 0 | 0
PROCESSOR | Telsa | Telsa | smd | 1k5 | Resistor 1% 50V 100mW 1608(0603) | RESISTOR 1608 REFLOW | R23 | 1 |  |  |  |  |  | 0 | 0
PROCESSOR | Telsa | Telsa | smd | 2k2 | Resistor 1% 50V 100mW 1608(0603) | RESISTOR 1608 REFLOW | R6 | 1 |  |  |  |  |  | 0 | 0
PROCESSOR | Telsa | Telsa | smd | 4k7 | Resistor 1% 50V 100mW 1608(0603) | RESISTOR 1608 REFLOW | R11, R15 | 2 |  |  |  |  |  | 0 | 0
PROCESSOR | Telsa | Telsa | smd | 8k2 | Resistor 1% 50V 100mW 1608(0603) | RESISTOR 1608 REFLOW | R49, R50, R53, R54, R61, R62, R65, R66, R73, R74, R77, R78, R85, R86, R89, R90, R97, R98, R101, R102, R109, R110, R113, R114, R121, R122, R125, R126, R133, R134, R137, R138, R144, R146, R150, R152, R156, R158, R162, R164 | 40 |  |  |  |  |  | 0 | 0
PROCESSOR | Telsa | Telsa | smd | 10k | Resistor 1% 50V 100mW 1608(0603) | RESISTOR 1608 REFLOW | R3, R9, R10, R13, R16, R20, R55, R56, R67, R68, R79, R80, R91, R92, R103, R104, R115, R116, R127, R128, R139, R140, R147, R153, R159, R165 | 26 |  |  |  |  |  | 0 | 0
PROCESSOR | Telsa | Telsa | smd | 18k | Resistor 1% 50V 100mW 1608(0603) | RESISTOR 1608 REFLOW | R47, R48, R57, R58, R59, R60, R69, R70, R71, R72, R81, R82, R83, R84, R93, R94, R95, R96, R105, R106, R107, R108, R117, R118, R119, R120, R129, R130, R131, R132, R141, R142, R143, R148, R149, R154, R155, R160, R161, R166 | 40 |  |  |  |  |  | 0 | 0
PROCESSOR | Telsa | Telsa | smd | 1Meg | Resistor 1% 50V 100mW 1608(0603) | RESISTOR 1608 REFLOW | R8 | 1 |  |  |  |  |  | 0 | 0
PROCESSOR | Telsa | Telsa | smd | 10k | Resistor 0.1% 50V 100mW 1608(0603) | RESISTOR 1608 REFLOW | R18, R21 | 2 |  |  |  |  |  | 0 | 0
PROCESSOR | Telsa | Telsa | smd | 470R | Resistor 1% 50V 125mW 2012(0805) | RESISTOR 2012 REFLOW | R30, R31, R32 | 3 |  |  |  |  |  | 0 | 0
PROCESSOR | Telsa | Telsa | smd | 3k3 | Resistor 1% 50V 125mW 2012(0805) | RESISTOR 2012 REFLOW | R167, R169, R171, R173 | 4 |  |  |  |  |  | 0 | 0
PROCESSOR | Telsa | Telsa | smd | 3k6 | Resistor 1% 50V 125mW 2012(0805) | RESISTOR 2012 REFLOW | R168, R170, R172, R174 | 4 |  |  |  |  |  | 0 | 0
PROCESSOR | Telsa | Telsa | smd | 10k | Resistor 1% 50V 125mW 2012(0805) | RESISTOR 2012 REFLOW | R33, R34, R35, R36, R37, R38 | 6 |  |  |  |  |  | 0 | 0
PROCESSOR | Tesla | Telsa | smd | Green | LED generic | LED 2012 REFLOW | LD1, LD2, LD3 | 3 |  |  |  |  |  | 0 | 0
PROCESSOR | Hes-so | Telsa | smd | DR73-2R2-R | Inductor 2u2, 4.15A, 16mΩ | DR73 | L1 | 1 | Eaton Cooper | DR73-2R2-R | Volume Production | Mouser | 704-DR73-2R2-R | 1.13 | 1.13
PROCESSOR | Hes-so | Telsa | smd | MH2029-221Y | Inductor | INDUCTOR 2012 REFLOW | L2 | 1 | Bourns | MH2029-221Y | Volume Production | Mouser | 652-MH2029-221Y | 0.1 | 0.1
PROCESSOR | Hes-so | Telsa | smd | TMS320F28377SPTPT | TMS320F28377S-176P | PQFP176 P0.5 C24.2X24.2 H1.5 | U1 | 1 | Texas Instruments | TMS320F28377SPTPT | Not Recommended for New Design | Mouser | 595-MS320F28377SPTPT | 20.29 | 20.29
PROCESSOR | Hes-so | Telsa | smd | XC2C256-7PQG208C | XC2C256 CoolRunner-II CPLD | PQFP208 P0.5 C28.0X28.0 H3.7 | U8 | 1 | Xilinx | XC2C256-7PQG208C | Volume Production | Digi-Key | 122-1411-ND | 22 | 22
PROCESSOR | Hes-so | Telsa | smd | CP2102N-A01-GQFN28 | USBXpress | QFN28 P0.5 T3.4X3.4 C5.0X5.0 H0.8 | U7 | 1 | Silicon Labs | CP2102N-A01-GQFN28 | Unknown | Mouser | 634-CP2102NA01GQFN28 | 1.77 | 1.77
PROCESSOR | Hes-so | Telsa | smd | 20MHz | Quartz HC49/4H SMX | Quartz HC49/4H SMX | X1 | 1 |  |  |  |  |  | 0 | 0
PROCESSOR | Hes-so | Telsa | smd | AD8648ARZ-REEL7 | Generic quad OPA 14 pins | SO14 P1.27 C4.0X8.8 H1.75 | U9, U10, U11, U13, U20 | 5 | Analog Devices | AD8648ARZ-REEL7 | Volume Production | Mouser | 584-AD8648ARZ-R7 | 2.58 | 12.9
PROCESSOR | Hes-so | Telsa | smd | AD8646ARZ-REEL7 | Generic dual OPA 8 pins | SO8 P1.27 C4.0X5.0 H1.75 | U3, U12, U14 | 3 | Analog Devices | AD8646ARZ-REEL7 | Volume Production | Mouser | 584-AD8646ARZ-R7 | 2.34 | 7.02
PROCESSOR | Hes-so | Telsa | smd | TPS76618DR | Ultra Low Quiescent Current 250mA, Low Dropout Regulator | SO8 P1.27 C4.0X5.0 H1.75 | U5 | 1 | Texas Instruments | TPS76618DR | Volume Production | Mouser | 595-TPS76618DR | 1.31 | 1.31
PROCESSOR | Hes-so | Telsa | smd | SI8422AB-D-ISR | Optocoupler | SO8 P1.27 C4.0X5.0 H1.75 | U6 | 1 | Silicon Labs | SI8422AB-D-ISR | Volume Production | Mouser | 634-SI8422AB-D-ISR | 1 | 1
PROCESSOR | Hes-so | Telsa | smd | REF3130AIDBZTG4 | Generic Positive Voltage Reference | SOT23 P0.95 C1.6x3.0 H1.3 | U2, U22 | 2 | Texas Instruments | REF3130AIDBZTG4 | Volume Production | Mouser | 595-REF3130AIDBZTG4 | 2.65 | 5.3
PROCESSOR | Hes-so | Telsa | smd | TPS62262DDCT | 2.25-MHz 600-mA Step Down Converter in 2 x 2 SOT Package | SOT23-5 P0.95 C1.6x3.0 H1.3 | U4 | 1 | Texas Instruments | TPS62262DDCT | Volume Production | Mouser | 595-TPS62262DDCT | 1.6 | 1.6
PROCESSOR | Hes-so | Telsa | smd | DS90LV047ATMTC/NOPB | DS90LV047A 3-V LVDS Quad CMOS Differential Line Driver | TSSOP16 P0.65 C5.0x4.5 H1.1 | U19 | 1 | TI National Semiconductor | DS90LV047ATMTC/NOPB | Volume Production | Mouser | 926-DS90LV047ATMTCNO | 3.05 | 3.05
PROCESSOR | Hes-so | Telsa | smd | DAC124S085CIMM/NOPB | DAC124S085 12-Bit Micro Power Quad Digital-to-Analog Converter With Rail-to-Rail Output | VSSOP10 P0.5 C3.1X3.1 H1.1 | U21 | 1 | TI National Semiconductor | DAC124S085CIMM/NOPB | Volume Production | Mouser | 926-DAC124S085CIMMNO | 6.28 | 6.28
PROCESSOR | Hes-so | Telsa | traversant | 09031966921 | DIN41612 MALE 3X32 ABC R90 | DIN41612 MALE 3X32 ABC R90 | J5 | 1 | HARTING Technology | 09031966921 | Volume Production | Mouser | 617-09-03-196-6921 | 3.51 | 3.51
PROCESSOR | Hes-so | Telsa | traversant | 61202021621 | FlatCable2x10 | FlatCable2x10 2.54MM Straight TH | J2, J3 | 2 | Wurth Electronics | 61202021621 | Volume Production | Mouser | 710-61202021621 | 0.89 | 1.78
PROCESSOR | Hes-so | Telsa | traversant | 61201021721 | FlatCable2x5 | FlatCable2x5 2.54MM RIGHT ANGLE TH | J9 | 1 | Wurth Electronics | 61201021721 | Volume Production | Mouser | 710-61201021721 | 0.68 | 0.68
PROCESSOR | Hes-so | Telsa | traversant | 98464-G61-10ULF | FlatCable2x5 | FlatCable2x5 2MM Right Angle TH FCI 98614-G61-10ULF | J7 | 1 | Amphenol FCI | 98464-G61-10ULF | Volume Production | Mouser | 649-98464-G6110ULF | 1.74 | 1.74
PROCESSOR | Hes-so | Telsa | traversant | 61201421621 | FlatCable2x7 | FlatCable2x7 2.54MM Straight TH | J1 | 1 | Wurth Electronics | 61201421621 | Volume Production | Mouser | 710-61201421621 | 1.17 | 1.17
PROCESSOR | Hes-so | Telsa | traversant | 98464-G61-18ULF | FlatCable2x9 | FlatCable2x9 2MM Right Angle TH FCI 98614-G61-18ULF | J8 | 1 | Amphenol FCI | 98464-G61-18ULF | Volume Production | Mouser | 649-98464-G61-18ULF | 1.66 | 1.66
PROCESSOR | Hes-so | Telsa | traversant | {Value} | JUMPER 3 POS | JUMPER3 TH | JP5, JP6, JP7, JP8, JP9, JP10 | 6 |  |  |  |  |  | 0 | 0
PROCESSOR | Hes-so | Telsa | traversant | 568-0721-111F | LED Dialight 568-0721-111F | LED Dialight 568-0721-111 | LD4, LD5 | 2 | Dialight | 568-0721-111F | Volume Production | Mouser | 645-568-0721-111F | 4.14 | 8.28
PROCESSOR | Hes-so | Telsa | traversant |  | Plug connector | PinHeader2x11 P2.54 A | J4, J10 | 2 |  |  |  |  |  | 0 | 0
PROCESSOR | Hes-so | Telsa | traversant | FSM2JSMA | Push Button, 4 pins, 2 poles parrallèle | Push Button C6.0x6.0 TE FSM-2J-SMA | S1 | 1 | TE Connectivity | FSM2JSMA | Volume Production | Mouser | 506-FSM2JSMA | 0.29 | 0.29
PROCESSOR | Hes-so | Telsa | traversant | FSMRA4JH04 | Push Button, 2 pins | Push Button C7.1x3.7 TE FSMRA4JH | S2, S3, S4 | 3 | TE Connectivity | FSMRA4JH04 | Volume Production | Arrow | FSMRA4JH04 | 0.2113 | 0.6339
PROCESSOR | Hes-so | Telsa | traversant | CONSMA002-G | SMA TH RIGHT ANGLE LINX CONSMA002 | SMA TH Right Angle Linx CONSMA002 | J11, J12, J13, J14 | 4 | Linx | CONSMA002-G | Volume Production | Mouser | 712-CONSMA002-G | 6.14 | 24.56
PROCESSOR | Hes-so | Telsa | traversant |  | Test Point | Test Point Keystone Miniature BLACK | TP1, TP2, TP4 | 3 |  |  |  |  |  | 0 | 0
PROCESSOR | Hes-so | Telsa | traversant | UE27-BC54-130 | USB-B-TH-AMPHENOL UE27-BC54-130 | USB-B TH AMPHENOL UE27-BC54-130 | J6 | 1 |  |  |  |  |  | 0 | 0
 |  |  |  |  | Nombre de Circuit |  |  | 13
PROCESSOR | Telsa | Telsa | smd | 15p | Capacitor X7R 10% 50V 1608(0603) | CAPACITOR 1608 REFLOW | C1, C2 | 26 |  |  |  |  |  | 0 | 0
PROCESSOR | Telsa | Telsa | smd | 47p | Capacitor X7R 10% 50V 1608(0603) | CAPACITOR 1608 REFLOW | C88, C89, C92, C93, C94, C95, C98, C99, C100, C101, C104, C105, C106, C107, C110, C111, C114, C115, C118, C119, C120, C121, C124, C125, C126, C127, C130, C131, C132, C133, C136, C137, C140, C142, C143, C145, C146, C148, C149, C151 | 520 |  |  |  |  |  | 0 | 0
PROCESSOR | Telsa | Telsa | smd | 2n2 | Capacitor X7R 10% 50V 1608(0603) | CAPACITOR 1608 REFLOW | C90, C91, C96, C97, C102, C103, C108, C109, C116, C117, C122, C123, C128, C129, C134, C135, C141, C144, C147, C150 | 260 |  |  |  |  |  | 0 | 0
PROCESSOR | Telsa | Telsa | smd | 100n | Capacitor X7R 10% 50V 1608(0603) | CAPACITOR 1608 REFLOW | C3, C4, C5, C6, C7, C8, C9, C10, C11, C12, C13, C19, C20, C21, C22, C23, C24, C25, C26, C27, C28, C29, C30, C31, C37, C38, C39, C59, C61, C62, C63, C64, C66, C68, C72, C73, C74, C75, C76, C77, C78, C79, C80, C81, C82, C83, C84, C85, C86, C87, C112, C113, C138, C139, C152, C161, C165, C166 | 754 |  |  |  |  |  | 0 | 0
PROCESSOR | Telsa | Telsa | smd | 2u2 | Capacitor X7R 10% 10V 1608(0603) | CAPACITOR 1608 REFLOW | C14, C15, C16, C17, C18, C32, C33, C34, C35, C36 | 130 |  |  |  |  |  | 0 | 0
PROCESSOR | Telsa | Telsa | smd | 100p | Capacitor X7R 10% 50V 2012(0805) | CAPACITOR 2012 REFLOW | C154, C156, C160, C163 | 52 |  |  |  |  |  | 0 | 0
PROCESSOR | Telsa | Telsa | smd | 150p | Capacitor X7R 10% 50V 2012(0805) | CAPACITOR 2012 REFLOW | C155, C157, C162, C164 | 52 |  |  |  |  |  | 0 | 0
PROCESSOR | Telsa | Telsa | smd | 100n | Capacitor X7R 10% 50V 2012(0805) | CAPACITOR 2012 REFLOW | C43, C48, C51, C69, C70, C71, C153, C158 | 104 |  |  |  |  |  | 0 | 0
PROCESSOR | Telsa | Telsa | smd | 1u | Capacitor X7R 10% 10V 2012(0805) | CAPACITOR 2012 REFLOW | C55, C159 | 26 |  |  |  |  |  | 0 | 0
PROCESSOR | Telsa | Telsa | smd | 3u3 | Capacitor X7R 10% 10V 2012(0805) | CAPACITOR 2012 REFLOW | C41, C45, C54 | 39 |  |  |  |  |  | 0 | 0
PROCESSOR | Telsa | Telsa | smd | 4u7 | Capacitor X7R 10% 10V 2012(0805) | CAPACITOR 2012 REFLOW | C56, C65, C67 | 39 |  |  |  |  |  | 0 | 0
PROCESSOR | Telsa | Telsa | smd | 10u | Capacitor X7R 10% 10V 2012(0805) | CAPACITOR 2012 REFLOW | C42, C44, C47, C49, C50, C53, C57, C58 | 104 |  |  |  |  |  | 0 | 0
PROCESSOR | Telsa | Telsa | smd | 4u7 | Capacitor Tantalum 10 % 10V 3528(1311-TAJ-B) | CAPACITOR POL 3528-21 REFLOW | C60 | 13 |  |  |  |  |  | 0 | 0
PROCESSOR | Telsa | Telsa | smd | nm | Resistor 1% 50V 100mW 1608(0603) | RESISTOR 1608 REFLOW | R4, R5 | 26 |  |  |  |  |  | 0 | 0
PROCESSOR | Telsa | Telsa | smd | 0 | Resistor 1% 50V 100mW 1608(0603) | RESISTOR 1608 REFLOW | R28 | 13 |  |  |  |  |  | 0 | 0
PROCESSOR | Telsa | Telsa | smd | 56R | Resistor 1% 50V 100mW 1608(0603) | RESISTOR 1608 REFLOW | R12, R19 | 26 |  |  |  |  |  | 0 | 0
PROCESSOR | Telsa | Telsa | smd | 82R | Resistor 1% 50V 100mW 1608(0603) | RESISTOR 1608 REFLOW | R51, R52, R63, R64, R75, R76, R87, R88, R99, R100, R111, R112, R123, R124, R135, R136, R145, R151, R157, R163 | 260 |  |  |  |  |  | 0 | 0
PROCESSOR | Telsa | Telsa | smd | 100R | Resistor 1% 50V 100mW 1608(0603) | RESISTOR 1608 REFLOW | R7 | 13 |  |  |  |  |  | 0 | 0
PROCESSOR | Telsa | Telsa | smd | 120R | Resistor 1% 50V 100mW 1608(0603) | RESISTOR 1608 REFLOW | R39, R40, R41, R42, R43, R44, R45, R46 | 104 |  |  |  |  |  | 0 | 0
PROCESSOR | Telsa | Telsa | smd | 220R | Resistor 1% 50V 100mW 1608(0603) | RESISTOR 1608 REFLOW | R24 | 13 |  |  |  |  |  | 0 | 0
PROCESSOR | Telsa | Telsa | smd | 560R | Resistor 1% 50V 100mW 1608(0603) | RESISTOR 1608 REFLOW | R14, R22 | 26 |  |  |  |  |  | 0 | 0
PROCESSOR | Telsa | Telsa | smd | 820R | Resistor 1% 50V 100mW 1608(0603) | RESISTOR 1608 REFLOW | R1, R2 | 26 |  |  |  |  |  | 0 | 0
PROCESSOR | Telsa | Telsa | smd | 1k | Resistor 1% 50V 100mW 1608(0603) | RESISTOR 1608 REFLOW | R25, R26, R27, R29 | 52 |  |  |  |  |  | 0 | 0
PROCESSOR | Telsa | Telsa | smd | 1k5 | Resistor 1% 50V 100mW 1608(0603) | RESISTOR 1608 REFLOW | R23 | 13 |  |  |  |  |  | 0 | 0
PROCESSOR | Telsa | Telsa | smd | 2k2 | Resistor 1% 50V 100mW 1608(0603) | RESISTOR 1608 REFLOW | R6 | 13 |  |  |  |  |  | 0 | 0
PROCESSOR | Telsa | Telsa | smd | 4k7 | Resistor 1% 50V 100mW 1608(0603) | RESISTOR 1608 REFLOW | R11, R15 | 26 |  |  |  |  |  | 0 | 0
PROCESSOR | Telsa | Telsa | smd | 8k2 | Resistor 1% 50V 100mW 1608(0603) | RESISTOR 1608 REFLOW | R49, R50, R53, R54, R61, R62, R65, R66, R73, R74, R77, R78, R85, R86, R89, R90, R97, R98, R101, R102, R109, R110, R113, R114, R121, R122, R125, R126, R133, R134, R137, R138, R144, R146, R150, R152, R156, R158, R162, R164 | 520 |  |  |  |  |  | 0 | 0
PROCESSOR | Telsa | Telsa | smd | 10k | Resistor 1% 50V 100mW 1608(0603) | RESISTOR 1608 REFLOW | R3, R9, R10, R13, R16, R20, R55, R56, R67, R68, R79, R80, R91, R92, R103, R104, R115, R116, R127, R128, R139, R140, R147, R153, R159, R165 | 338 |  |  |  |  |  | 0 | 0
PROCESSOR | Telsa | Telsa | smd | 18k | Resistor 1% 50V 100mW 1608(0603) | RESISTOR 1608 REFLOW | R47, R48, R57, R58, R59, R60, R69, R70, R71, R72, R81, R82, R83, R84, R93, R94, R95, R96, R105, R106, R107, R108, R117, R118, R119, R120, R129, R130, R131, R132, R141, R142, R143, R148, R149, R154, R155, R160, R161, R166 | 520 |  |  |  |  |  | 0 | 0
PROCESSOR | Telsa | Telsa | smd | 1Meg | Resistor 1% 50V 100mW 1608(0603) | RESISTOR 1608 REFLOW | R8 | 13 |  |  |  |  |  | 0 | 0
PROCESSOR | Telsa | Telsa | smd | 10k | Resistor 0.1% 50V 100mW 1608(0603) | RESISTOR 1608 REFLOW | R18, R21 | 26 |  |  |  |  |  | 0 | 0
PROCESSOR | Telsa | Telsa | smd | 470R | Resistor 1% 50V 125mW 2012(0805) | RESISTOR 2012 REFLOW | R30, R31, R32 | 39 |  |  |  |  |  | 0 | 0
PROCESSOR | Telsa | Telsa | smd | 3k3 | Resistor 1% 50V 125mW 2012(0805) | RESISTOR 2012 REFLOW | R167, R169, R171, R173 | 52 |  |  |  |  |  | 0 | 0
PROCESSOR | Telsa | Telsa | smd | 3k6 | Resistor 1% 50V 125mW 2012(0805) | RESISTOR 2012 REFLOW | R168, R170, R172, R174 | 52 |  |  |  |  |  | 0 | 0
PROCESSOR | Telsa | Telsa | smd | 10k | Resistor 1% 50V 125mW 2012(0805) | RESISTOR 2012 REFLOW | R33, R34, R35, R36, R37, R38 | 78 |  |  |  |  |  | 0 | 0
PROCESSOR | Telsa | Telsa | smd | Green | LED generic | LED 2012 REFLOW | LD1, LD2, LD3 | 39 |  |  |  |  |  | 0 | 0
PROCESSOR | Hes-so | Telsa | smd | DR73-2R2-R | Inductor 2u2, 4.15A, 16mΩ | DR73 | L1 | 13 | Eaton Cooper | DR73-2R2-R | Volume Production | Mouser | 704-DR73-2R2-R | 1.13 | 14.69
PROCESSOR | Hes-so | Telsa | smd | MH2029-221Y | Inductor | INDUCTOR 2012 REFLOW | L2 | 13 | Bourns | MH2029-221Y | Volume Production | Mouser | 652-MH2029-221Y | 0.1 | 1.3
PROCESSOR | Hes-so | Telsa | smd | TMS320F28377SPTPT | TMS320F28377S-176P | PQFP176 P0.5 C24.2X24.2 H1.5 | U1 | 13 | Texas Instruments | TMS320F28377SPTPT | Not Recommended for New Design | Mouser | 595-MS320F28377SPTPT | 20.29 | 263.77
PROCESSOR | Hes-so | Telsa | smd | XC2C256-7PQG208C | XC2C256 CoolRunner-II CPLD | PQFP208 P0.5 C28.0X28.0 H3.7 | U8 | 13 | Xilinx | XC2C256-7PQG208C | Volume Production | Digi-Key | 122-1411-ND | 22 | 286
PROCESSOR | Hes-so | Telsa | smd | CP2102N-A01-GQFN28 | USBXpress | QFN28 P0.5 T3.4X3.4 C5.0X5.0 H0.8 | U7 | 13 | Silicon Labs | CP2102N-A01-GQFN28 | Unknown | Mouser | 634-CP2102NA01GQFN28 | 1.77 | 23.01
PROCESSOR | Hes-so | Telsa | smd | 20MHz | Quartz HC49/4H SMX | Quartz HC49/4H SMX | X1 | 13 |  |  |  |  |  | 0 | 0
PROCESSOR | Hes-so | Telsa | smd | AD8648ARZ-REEL7 | Generic quad OPA 14 pins | SO14 P1.27 C4.0X8.8 H1.75 | U9, U10, U11, U13, U20 | 65 | Analog Devices | AD8648ARZ-REEL7 | Volume Production | Mouser | 584-AD8648ARZ-R7 | 2.58 | 167.7
PROCESSOR | Hes-so | Telsa | smd | AD8646ARZ-REEL7 | Generic dual OPA 8 pins | SO8 P1.27 C4.0X5.0 H1.75 | U3, U12, U14 | 39 | Analog Devices | AD8646ARZ-REEL7 | Volume Production | Mouser | 584-AD8646ARZ-R7 | 2.34 | 91.26
PROCESSOR | Hes-so | Telsa | smd | TPS76618DR | Ultra Low Quiescent Current 250mA, Low Dropout Regulator | SO8 P1.27 C4.0X5.0 H1.75 | U5 | 13 | Texas Instruments | TPS76618DR | Volume Production | Mouser | 595-TPS76618DR | 1.31 | 17.03
PROCESSOR | Hes-so | Telsa | smd | SI8422AB-D-ISR | Optocoupler | SO8 P1.27 C4.0X5.0 H1.75 | U6 | 13 | Silicon Labs | SI8422AB-D-ISR | Volume Production | Mouser | 634-SI8422AB-D-ISR | 1 | 13
PROCESSOR | Hes-so | Telsa | smd | REF3130AIDBZTG4 | Generic Positive Voltage Reference | SOT23 P0.95 C1.6x3.0 H1.3 | U2, U22 | 26 | Texas Instruments | REF3130AIDBZTG4 | Volume Production | Mouser | 595-REF3130AIDBZTG4 | 2.65 | 68.9
PROCESSOR | Hes-so | Telsa | smd | TPS62262DDCT | 2.25-MHz 600-mA Step Down Converter in 2 x 2 SOT Package | SOT23-5 P0.95 C1.6x3.0 H1.3 | U4 | 13 | Texas Instruments | TPS62262DDCT | Volume Production | Mouser | 595-TPS62262DDCT | 1.6 | 20.8
PROCESSOR | Hes-so | Telsa | smd | DS90LV047ATMTC/NOPB | DS90LV047A 3-V LVDS Quad CMOS Differential Line Driver | TSSOP16 P0.65 C5.0x4.5 H1.1 | U19 | 13 | TI National Semiconductor | DS90LV047ATMTC/NOPB | Volume Production | Mouser | 926-DS90LV047ATMTCNO | 3.05 | 39.65
PROCESSOR | Hes-so | Telsa | smd | DAC124S085CIMM/NOPB | DAC124S085 12-Bit Micro Power Quad Digital-to-Analog Converter With Rail-to-Rail Output | VSSOP10 P0.5 C3.1X3.1 H1.1 | U21 | 13 | TI National Semiconductor | DAC124S085CIMM/NOPB | Volume Production | Mouser | 926-DAC124S085CIMMNO | 6.28 | 81.64
PROCESSOR | Hes-so | Telsa | traversant | 09031966921 | DIN41612 MALE 3X32 ABC R90 | DIN41612 MALE 3X32 ABC R90 | J5 | 13 | HARTING Technology | 09031966921 | Volume Production | Mouser | 617-09-03-196-6921 | 3.51 | 45.63
PROCESSOR | Hes-so | Telsa | traversant | 61202021621 | FlatCable2x10 | FlatCable2x10 2.54MM Straight TH | J2, J3 | 26 | Wurth Electronics | 61202021621 | Volume Production | Mouser | 710-61202021621 | 0.89 | 23.14
PROCESSOR | Hes-so | Telsa | traversant | 61201021721 | FlatCable2x5 | FlatCable2x5 2.54MM RIGHT ANGLE TH | J9 | 13 | Wurth Electronics | 61201021721 | Volume Production | Mouser | 710-61201021721 | 0.68 | 8.84
PROCESSOR | Hes-so | Telsa | traversant | 98464-G61-10ULF | FlatCable2x5 | FlatCable2x5 2MM Right Angle TH FCI 98614-G61-10ULF | J7 | 13 | Amphenol FCI | 98464-G61-10ULF | Volume Production | Mouser | 649-98464-G6110ULF | 1.74 | 22.62
PROCESSOR | Hes-so | Telsa | traversant | 61201421621 | FlatCable2x7 | FlatCable2x7 2.54MM Straight TH | J1 | 13 | Wurth Electronics | 61201421621 | Volume Production | Mouser | 710-61201421621 | 1.17 | 15.21
PROCESSOR | Hes-so | Telsa | traversant | 98464-G61-18ULF | FlatCable2x9 | FlatCable2x9 2MM Right Angle TH FCI 98614-G61-18ULF | J8 | 13 | Amphenol FCI | 98464-G61-18ULF | Volume Production | Mouser | 649-98464-G61-18ULF | 1.66 | 21.58
PROCESSOR | Hes-so | Telsa | traversant | {Value} | JUMPER 3 POS | JUMPER3 TH | JP5, JP6, JP7, JP8, JP9, JP10 | 78 |  |  |  |  |  | 0 | 0
PROCESSOR | Hes-so | Telsa | traversant | 568-0721-111F | LED Dialight 568-0721-111F | LED Dialight 568-0721-111 | LD4, LD5 | 26 | Dialight | 568-0721-111F | Volume Production | Mouser | 645-568-0721-111F | 4.14 | 107.64
PROCESSOR | Hes-so | Telsa | traversant |  | Plug connector | PinHeader2x11 P2.54 A | J4, J10 | 26 |  |  |  |  |  | 0 | 0
PROCESSOR | Hes-so | Telsa | traversant | FSM2JSMA | Push Button, 4 pins, 2 poles parrallèle | Push Button C6.0x6.0 TE FSM-2J-SMA | S1 | 13 | TE Connectivity | FSM2JSMA | Volume Production | Mouser | 506-FSM2JSMA | 0.29 | 3.77
PROCESSOR | Hes-so | Telsa | traversant | FSMRA4JH04 | Push Button, 2 pins | Push Button C7.1x3.7 TE FSMRA4JH | S2, S3, S4 | 39 | TE Connectivity | FSMRA4JH04 | Volume Production | Arrow | FSMRA4JH04 | 0.2113 | 8.2407
PROCESSOR | Hes-so | Telsa | traversant | CONSMA002-G | SMA TH RIGHT ANGLE LINX CONSMA002 | SMA TH Right Angle Linx CONSMA002 | J11, J12, J13, J14 | 52 | Linx | CONSMA002-G | Volume Production | Mouser | 712-CONSMA002-G | 6.14 | 319.28
PROCESSOR | Hes-so | Telsa | traversant |  | Test Point | Test Point Keystone Miniature BLACK | TP1, TP2, TP4 | 39 |  |  |  |  |  | 0 | 0
PROCESSOR | Hes-so | Telsa | traversant | UE27-BC54-130 | USB-B-TH-AMPHENOL UE27-BC54-130 | USB-B TH AMPHENOL UE27-BC54-130 | J6 | 13 |  |  |  |  |  | 0 | 0
