73jn/td-fpga-developing-board/FPGA-POETIC/ReferenceBoards/FPGA-Rack_v1/01_Doc/Commandes/component_list.xlsx

Sheet: Component List
Quant. | Description | Package | Manufacturer | Supplier | Command Nbr | Unit Price [Euro] | Total Price [SFr.] | Sum Total [SFr.] | In Stock @ HESSO
0 | development board LX45
1 | development board LX100
0 | development board LX150
Power |  |  |  |  |  |  | 50.65 | 50.65
1 | LTM4615EV Triple DC-DC | 144LGA | Linear Technology | Digikey | LTM4615EV#PBF-ND (http://www.digikey.ch/product-detail/de/LTM4615EV%23PBF/LTM4615EV%23PBF-ND/2136229) | 31.96 | 38.45
1 | LDO 2.5V LD1117S25TR | SOT-223 | STMicroelectronics | Digikey | 497-7309-1-ND (http://www.digikey.ch/product-detail/de/LD1117S25TR/497-7309-1-ND/1883984) | 0.40 | 0.48
1 | RES 1.43k 1% | 0603 | Panasonic | Digikey | P1.43KHCT-ND (http://www.digikey.ch/product-detail/de/ERJ-3EKF1431V/P1.43KHCT-ND/198086) | 0.03 | 0.04
2 | RES 1.6k 1% | 0603 | Panasonic | Digikey | P1.60KHCT-ND (http://www.digikey.ch/product-detail/en/ERJ-3EKF1601V/P1.60KHCT-ND/1746732) | 0.03 | 0.07
4 | RES 10k 1% | 0805 | Panasonic | Digikey | P10.0KHCT-ND (http://www.digikey.ch/product-detail/en/ERJ-3EKF1002V/P10.0KHCT-ND/198102) | 0.03 | 0.14 |  | yes
3 | CAP 10uF 6.3V | 0805 | Murata | Digikey | 490-1718-1-ND (http://www.digikey.ch/product-detail/en/GRM21BR60J106ME19L/490-1718-1-ND/587425) | 0.27 | 0.97 |  | yes
3 | CAP 100nF | 0805 | Murata | Digikey | 490-1726-1-ND (http://www.digikey.ch/product-detail/en/GRM216F51E104ZA01D/490-1726-1-ND/587612) | 0.07 | 0.25 |  | yes
2 | CAP 100uF | 1206 | Murata | Digikey | 490-4539-1-ND (http://www.digikey.ch/product-detail/en/GRM31CR60J107ME39L/490-4539-1-ND/1033313) | 0.84 | 2.02
6 | CAP 22uF X7R | 1206 | Taiyo Yuden | Digikey | 587-1334-1-ND (http://www.digikey.ch/product-detail/en/JMK316B7226ML-T/587-1334-1-ND/931111) | 0.48 | 3.46
2 | CAP 220uF 6.3V low esr | 2917 | Vishay Spranque | Digikey | 718-1106-1-ND (http://www.digikey.ch/product-detail/en/593D227X96R3D2TE3/718-1106-1-ND/1559600) | 1.41 | 3.39
2 | FILTER LC HIGH FREQ 2200PF NFE31PT222Z1E9L | 1206 | Murata | Digikey | 490-2547-1-ND (http://www.digikey.ch/product-detail/de/NFE31PT222Z1E9L/490-2547-1-ND/600020) | 0.57 | 1.37
FPGA Power & 1 & 2 & Config |  |  |  |  |  |  | 155.73 | 206.38
0 | FPGA Spartan 6 XC6SLX45-2FGG484C | 484-FBGA | Xilinx | Digikey | 122-1674-ND (http://www.digikey.ch/product-detail/de/XC6SLX45-2FGG484C/122-1674-ND/2408284) | 50.00 | 0.00
1 | FPGA Spartan 6 XC6SLX100-3FGG484C | 484-FBGA | Xilinx | Digikey | 122-1759-ND (http://www.digikey.ch/product-detail/de/XC6SLX100-3FGG484C/122-1759-ND/2339779) | 107.93 | 129.84
0 | FPGA Spartan 6 XC6SLX150-2FGG484C | 484-FBGA | Xilinx | Digikey | 122-1750-ND | 132.19 | 0.00
7 | CAP 100uF 20% X5R GRM31CR60J107ME39L | 1206 | Murata | Digikey | 490-4539-1-ND (http://www.digikey.ch/product-detail/en/GRM31CR60J107ME39L/490-4539-1-ND/1033313) | 0.84 | 7.07
9 | CAP 4.7uF 10% X5R | 0805 | AVX Corporation | Digikey | 478-1416-1-ND (http://www.digikey.ch/product-detail/en/08056D475KAT2A/478-1416-1-ND/564448) | 0.15 | 1.62 |  | yes
22 | CAP 0.47uF 10% X5R | 0603 | TDK Corporation | Digikey | 445-1320-1-ND (http://www.digikey.ch/product-detail/en/C1608X5R1A474K/445-1320-1-ND/567693) | 0.05 | 1.32
1 | Oscillator 106.25MHz +/-50ppm CB3LV-3I-106M2500 | 4-SMD | CTS Frequency Controls | Digikey | CTX718LVCT-ND (http://www.digikey.ch/product-detail/de/CB3LV-3I-106M2500/CTX718LVCT-ND/1638173) | 2.78 | 3.34
1 | CONN HEADER 2x5PoS DL 2MM | 2x5 2mm | Minitek | Digikey | 609-2961-ND | 1.40 | 1.68
1 | SWITCH PUSH SPST-NO 0.4VA 20V TPB11CGRA004 |  | Te Connectivity | Digikey | 450-1376-ND (http://www.digikey.ch/product-detail/de/TPB11CGRA004/450-1376-ND/969186) | 4.19 | 5.04
1 | Pushbutton | SMD | Schurter 1301.9315 | Farnell | 1217764 | 0.860 | 1.03 |  | yes
1 | LED green 20mA 2.2V | 0805 | Lumex Opto | Digikey | 67-1687-1-ND (http://www.digikey.ch/product-detail/de/SML-LX0805SUGC-TR/67-1687-1-ND/467621) | 0.360 | 0.43 |  | yes
1 | LED 2X2 3MM HI DENSITY RED PCMNT |  | Dialight | Digikey | 350-1778-ND (http://www.digikey.ch/product-detail/de/569-0101-111F/350-1778-ND/809174) | 2.49 | 3.00
1 | SWITCH DIP 4POS SIDE ACT SMT | SMD | CTS Electrocomponents | Digikey | CT1934MS-ND (http://www.digikey.ch/product-detail/de/193-4MS/CT1934MS-ND/267293) | 1.02 | 1.23
1 | RES 0 | 0805 |  |  |  |  | 0.00 |  | yes
1 | RES 27 | 0805 |  |  |  |  | 0.00 |  | yes
1 | RES 100 | 0805 |  |  |  |  | 0.00 |  | yes
1 | RES 330 | 0805 |  |  |  |  | 0.00 |  | yes
2 | RES 4.7k | 0805 |  |  |  |  | 0.00 |  | yes
3 | RES 10k | 0805 | Panasonic | Digikey | P10.0KHCT-ND (http://www.digikey.ch/product-detail/en/ERJ-3EKF1002V/P10.0KHCT-ND/198102) | 0.03 | 0.11 |  | yes
1 | CAP 100nF | 0805 |  |  |  |  | 0.00 |  | yes
Memory |  |  |  |  |  |  | 17.38 | 223.76
1 | SDRAM MT48LC16M16A2P 256MBit 133MHz | 54-TSOP | Micron | Digikey | 557-1059-1-ND (http://www.digikey.ch/product-detail/en/MT48LC16M16A2P-75:D%20TR/557-1059-1-ND/721979) | 6.41 | 7.71 |  | yes
1 | IC FLASH 128MBIT 65NM 56TSOP 75ns | 56-TFSOP | Axcell | Digikey | JS28F128P30TF75A-ND (http://www.digikey.ch/product-detail/de/JS28F128P30TF75A/JS28F128P30TF75A-ND/2552508) | 6.19 | 7.45
7 | RES 1k | 0805 |  |  |  |  | 0.00 |  | yes
1 | RES 10k | 0805 | Panasonic | Digikey | P10.0KHCT-ND (http://www.digikey.ch/product-detail/en/ERJ-3EKF1002V/P10.0KHCT-ND/198102) | 0.03 | 0.04 |  | yes
2 | CAP 10uF 6.3V | 0805 | Murata | Digikey | 490-1718-1-ND (http://www.digikey.ch/product-detail/en/GRM21BR60J106ME19L/490-1718-1-ND/587425) | 0.27 | 0.65 |  | yes
11 | CAP 100nF | 0805 | Murata | Digikey | 490-1726-1-ND (http://www.digikey.ch/product-detail/en/GRM216F51E104ZA01D/490-1726-1-ND/587612) | 0.07 | 0.93 |  | yes
1 | IC GATE AND 2-INPUT UHS SC70-5 | SC-70-5 | Fairchild | Digikey | NC7SZ08P5XCT-ND (http://www.digikey.ch/product-detail/de/NC7SZ08P5X/NC7SZ08P5XCT-ND/673391) | 0.51 | 0.61
Mezzanine & VME |  |  |  |  |  |  | 55.58 | 279.34
2 | Mezzanine Female | 2x25Pos | Erni | Distrelec | 120627 | 11.12 | 26.75 |  | x
2 | Mezzanine Male | 2x25Pos | Erni | Distrelec | 120636 | 8.75 | 21.05 |  | yes 7boards
1 | VME DIN41612 Female Right Angle 96Pin Connector | 3x32Pos | Te Connectivity | Digikey | A29038-ND (http://www.digikey.ch/product-detail/de/650461-4/A29038-ND/297683) | 4.50 | 5.41
2 | Conn Header 26PS 2mm | 2*13Pos | ASSmann | Digikey | AE10565-ND (http://www.digikey.ch/product-detail/de/AWHW2-26G-0202-T-R/AE10565-ND/2272523) | 0.98 | 2.36
Ethernet |  |  |  |  |  |  | 37.67 | 317.02
1 | CONN PULSEJACK 1x2 Port 10/100B-TX |  | PulseJack | Digikey | 553-1353-ND (http://www.digikey.ch/product-detail/de/J8064D628ANL/553-1353-ND/1036969) | 9.15 | 11.01
1 | IC TXRX PHY 10/100 LV/LP | 32-MLF | Micrel Inc | Digikey | 576-1645-2-ND (http://www.digikey.ch/product-detail/de/KSZ8041NL%20TR/576-1645-2-ND/1616707) | 1.06 | 1.28
1 | TXRX PHY IEEE 1PORT 1588 48-LQFP | 48-LQFP | National Semiconductor | Digikey | DP83640TVV-ND (http://www.digikey.ch/product-detail/de/DP83640TVV%2FNOPB/DP83640TVV-ND/1870790) | 10.27 | 12.35
1 | OSC 25.0000MHZ 3.3V | SMD | CTS Frequency | Digikey | CTX308LVCT-ND (http://www.digikey.ch/product-detail/en/CB3LV-3I-25M0000/CTX308LVCT-ND/663683) | 2.45 | 2.95
3 | RES 10k | 0805 | Panasonic | Digikey | P10.0KHCT-ND (http://www.digikey.ch/product-detail/en/ERJ-3EKF1002V/P10.0KHCT-ND/198102) | 0.03 | 0.11 |  | yes
2 | CAP 10uF 6.3V | 0805 | Murata | Digikey | 490-1718-1-ND (http://www.digikey.ch/product-detail/en/GRM21BR60J106ME19L/490-1718-1-ND/587425) | 0.27 | 0.65 |  | yes
13 | CAP 100nF | 0805 | Murata | Digikey | 490-1726-1-ND (http://www.digikey.ch/product-detail/en/GRM216F51E104ZA01D/490-1726-1-ND/587612) | 0.07 | 1.09 |  | yes
2 | CAP 22uF X7R | 1206 | Taiyo Yuden | Digikey | 587-1334-1-ND (http://www.digikey.ch/product-detail/en/JMK316B7226ML-T/587-1334-1-ND/931111) | 0.48 | 1.15
2 | L 1uH 150mA | 0805 | Abracon Corporation | Digikey | 535-10513-1-ND (http://www.digikey.ch/product-detail/de/AISC-0805-1R0J-T/535-10513-1-ND/2335470) | 0.20 | 0.48
2 | Diode BAS16 1N4148 | SOT-23 | FAIRCHILD SEMICONDUCTOR | Farnell | 9843957 | 0.258 | 0.62 |  | yes 5boards
8 | RES 49.9 1% | 0805 | Panasonic | Digikey | P49.9CCT-ND (http://www.digikey.ch/product-detail/de/ERJ-6ENF49R9V/P49.9CCT-ND/118581) | 0.06 | 0.58
1 | RES 4.87k 1% | 0805 | Panasonic | Digikey | P4.87KCCT-ND (http://www.digikey.ch/product-detail/de/ERJ-6ENF4871V/P4.87KCCT-ND/119158) | 0.06 | 0.07
1 | RES 6.49k 1% | 0805 | Panasonic | Digikey | P6.49KCCT-ND (http://www.digikey.ch/product-detail/de/ERJ-6ENF6491V/P6.49KCCT-ND/110962) | 0.06 | 0.07 |  | yes 9boards
2 | CAP 10nF 50V | 0805 | Taiyo Yuden | Digikey | 587-2238-1-ND (http://www.digikey.ch/product-detail/de/UMK105B7103KV-F/587-2238-1-ND/2002936) | 0.07 | 0.17 |  | yes
2 | CAP 100nF 50V | 0805 | TDK Corporation | Digikey | 445-7534-1-ND (http://www.digikey.ch/product-detail/de/C2012X7R1H104K%2F0.85/445-7534-1-ND/2733606) | 0.06 | 0.13 |  | yes
4 | CAP 10uF Tantalum | 0805 | AVX Corporation | Digikey | 478-3273-1-ND (http://www.digikey.ch/product-detail/de/TAJR106K006RNJ/478-3273-1-ND/930065) | 1.03 | 4.96
4 | RES 180 | 0805 |  |  |  |  | 0.00 |  | yes
UART & FTDI |  |  |  |  |  |  | 14.04 | 331.05
1 | FT232RL USB UART JTAG | 28-SSOP | FTDI | Digikey | 768-1007-1-ND (http://www.digikey.ch/product-detail/de/FT232RL-REEL/768-1007-1-ND/1836402) | 3.75 | 4.51
1 | MAX3224ECAP | SSOP20 | MAXIM | Digikey | MAX3224ECAP+-ND (http://www.digikey.ch/product-detail/en/MAX3224ECAP%2B/MAX3224ECAP%2B-ND/947900) | 4.49 | 5.40
1 | USB Mini CONN RECEPT MINI USB2.0 5POS | 5 POS | Hirose Electric | Digikey | H2959CT-ND (http://www.digikey.ch/product-detail/de/UX60-MB-5ST/H2959CT-ND/597538) | 1.03 | 1.24
1 | FERRITE CHIP 120 OHM 2000MA BLM18PG121SN1D | 0603 | Murata | Digikey | 490-1037-1-ND (http://www.digikey.ch/product-detail/de/BLM18PG121SN1D/490-1037-1-ND/584485) | 0.27 | 0.32
3 | CAP 4.7uF 10V | 0805 | Taiyo Yuden | Digikey | 587-1311-1-ND (http://www.digikey.ch/product-detail/en/LMK212F475ZG-T/587-1311-1-ND/931088) | 0.32 | 1.15 |  | yes
1 | CAP 100pF | 0805 |  |  |  |  | 0.00 |  | yes
5 | CAP 100nF | 0805 | Murata | Digikey | 490-1726-1-ND (http://www.digikey.ch/product-detail/en/GRM216F51E104ZA01D/490-1726-1-ND/587612) | 0.07 | 0.42 |  | yes
1 | CONNB 2x5Pos 2.54mm | 2x5 | Te Connectivity | Digieky | OR896-ND (http://www.digikey.ch/product-detail/en/XG4C-1031/OR896-ND/1787190) | 0.82 | 0.99
TOTAL |  |  |  |  |  |  |  | 331.05

Sheet: Component Choice
Quant. | Description | Package | Manufacturer | Supplier | Command Nbr | Schema Nbr | Unit Price [Euro] | Total Price [SFr.] | Sum Total [SFr.]
1 | development boards
FPGA |  |  |  |  |  |  |  | 374.52 | 374.52
1 | FPGA Spartan 6 XC6SLX45-2FGG484C | 484-FBGA | Xilinx | Digikey | 122-1674-ND (http://www.digikey.ch/product-detail/de/XC6SLX45-2FGG484C/122-1674-ND/2408284) |  | 50.00 | 60.15
1 | FPGA Spartan 6 XC6SLX75-3FGG484I | 484-FBGA | Xilinx | Digikey | 122-1739-ND (http://www.digikey.ch/product-detail/de/XC6SLX75-3FGG484I/122-1739-ND/2339901) |  | 98.60 | 118.62
1 | FPGA Spartan 6 XC6SLX45-2FGG646C | 676-FGBGA | Xilinx | Digikey | 122-1675-ND (http://www.digikey.ch/product-detail/de/XC6SLX45-2FGG676C/122-1675-ND/2408285) |  | 56.72 | 68.23
1 | FPGA Spartan 6 XC6SLX75-3FGG676I | 676-FGBGA | Xilnx | Digikey | 122-1740-ND (http://www.digikey.ch/product-detail/de/XC6SLX75-3FGG676I/122-1740-ND/2339903) |  | 106.00 | 127.52
Memory |  |  |  |  |  |  |  | 41.76 | 416.28
1 | Platform Flash 32Mb XCF32P | 48-TSOP | Xilinx | Digikey | 122-1458-ND (http://www.digikey.ch/product-detail/de/XCF32PVOG48C/122-1458-ND/966639) |  | 21.65 | 26.04
1 | SDRAM MT48LC8M16A2P 128MBit 133MHz | 54-TSOP | Micron | Digikey | 557-1100-2-ND |  | 3.07 | 3.69
1 | IC FLASH 256MBIT 100NS 64EZBGA | 64-EZBGA | Axcell non-Stocking | Digikey | RC28F256P30TFA-ND (http://www.digikey.ch/product-detail/de/RC28F256P30TFA/RC28F256P30TFA-ND/1996835) |  | 9.99 | 12.02
1 | IC FLASH 128MBIT 65NM 56TSOP 75ns | 56-TFSOP | Axcell | Digikey | JS28F128P30TF75A-ND (http://www.digikey.ch/product-detail/de/JS28F128P30TF75A/JS28F128P30TF75A-ND/2552508)
Connectors |  |  |  |  |  |  |  | 42.14 | 458.42
1 | USB Mini CONN RECEPT MINI USB2.0 5POS | 5 POS | Hirose Electric | Digikey | H2959CT-ND (http://www.digikey.ch/product-detail/de/UX60-MB-5ST/H2959CT-ND/597538) |  | 1.03 | 1.24
1 | CONN PULSEJACK 1x2 Port 10/100B-TX |  | PulseJack | Digikey | 553-1353-ND (http://www.digikey.ch/product-detail/de/J8064D628ANL/553-1353-ND/1036969) |  | 9.15 | 9.90
1 | CONN HEADER 2x5PoS DL 2MM | 2x5 2mm | Minitek | Digikey | 609-2961-ND |  | 1.40 | 1.68
1 | Mezzanine Female | 2x25Pos | Erni | Distrelec | 120627 |  | 11.12 | 13.38
1 | Mezzanine Male | 2x25Pos | Erni | Distrelec | 120636 |  | 8.75 | 10.53
1 | VME DIN41612 Female Right Angle 96Pin Connector | 3x96Pos | Te Connectivity | Digikey | A29038-ND (http://www.digikey.ch/product-detail/de/650461-4/A29038-ND/297683) |  | 4.50 | 5.41
1 |  |  |  |  |  |  |  | 0.00
1 |  |  |  |  |  |  |  | 0.00
1 |  |  |  |  |  |  |  | 0.00
 |  |  |  |  |  |  |  | 0.00
Switch & Leds |  |  |  |  |  |  |  | 9.26 | 467.68
1 | SWITCH PUSH SPST-NO 0.4VA 20V |  | Te Connectivity | Digikey | 450-1376-ND (http://www.digikey.ch/product-detail/de/TPB11CGRA004/450-1376-ND/969186) |  | 4.19 | 5.04
1 | LED 2X2 3MM HI DENSITY RED PCMNT |  | Dialight | Digikey | 350-1778-ND (http://www.digikey.ch/product-detail/de/569-0101-111F/350-1778-ND/809174) |  | 2.49 | 3.00
1 | SWITCH DIP 4POS SIDE ACT SMT | SMD | CTS Electrocomponents | Digikey | CT1934MS-ND (http://www.digikey.ch/product-detail/de/193-4MS/CT1934MS-ND/267293) |  | 1.02 | 1.23
 |  |  |  |  |  |  |  | 0.00
Power |  |  |  |  |  |  |  | 38.45 | 506.13
1 | LTM4615EV Triple DC-DC | 144LGA | Linear Technology | Digikey | LTM4615EV#PBF-ND (http://www.digikey.ch/product-detail/de/LTM4615EV%23PBF/LTM4615EV%23PBF-ND/2136229) |  | 31.96 | 38.45
Driver |  |  |  |  |  |  |  | 23.20 | 529.32
1 | FT232HQ IC HS USB TO UART/FIFO | 48-LQFP | FTDI | Digikey | 768-1101-2-ND (http://www.digikey.ch/product-detail/de/FT232HL-REEL/768-1101-2-ND/2614627) |  | 2.24 | 2.69
1 | FT230XQ-R IC USB SERIAL BASIC UART | 16-SSOP | FTDI | Digikey | 768-1135-1-ND (http://www.digikey.ch/product-detail/de/FT230XS-R/768-1135-1-ND/3029155) |  | 1.96 | 2.36
1 | FT232RL USB UART JTAG | 28-SSOP | FTDI | Digikey | 768-1007-1-ND (http://www.digikey.ch/product-detail/de/FT232RL-REEL/768-1007-1-ND/1836402) |  | 3.75 | 4.51
1 | IC TXRX PHY 10/100 LV/LP | 32-MLF | Micrel Inc | Digikey | 576-1645-2-ND (http://www.digikey.ch/product-detail/de/KSZ8041NL%20TR/576-1645-2-ND/1616707) |  | 1.06 | 1.28
1 | TXRX PHY IEEE 1PORT 1588 48-LQFP | 48-LQFP | National Semiconductor | Digikey | DP83640TVV-ND (http://www.digikey.ch/product-detail/de/DP83640TVV%2FNOPB/DP83640TVV-ND/1870790) |  | 10.27 | 12.35
Total |  |  |  |  |  |  |  |  | 529.32
