73jn/td-fpga-developing-board/FPGA-POETIC/ReferenceBoards/FPGA-Rack_v1/01_Doc/Commandes/20120427_FPGARack_command1.xls

Personne concernée: | Zahno Silvan / Walpen Oliver
Mandat no.: | 26145 | Chef de projet / professeur: | Moerschell Joseph
Salle: | A307 / AE01
Digikey |  |  | Monnaie | CHF
Quantity | Reference | Designation | Unit Price [EUR]
2 | 122-1674-ND (http://www.digikey.ch/product-detail/de/XC6SLX45-2FGG484C/122-1674-ND/2408284) | FPGA Spartan 6 XC6SLX45-2FGG484C | EUR 50.00 | CHF 120.00
3 | 122-1759-ND (http://www.digikey.ch/product-detail/de/XC6SLX100-3FGG484C/122-1759-ND/2339779) | FPGA Spartan 6 XC6SLX100-3FGG484C | EUR 107.93 | CHF 388.55
1 | 122-1759-ND (http://www.digikey.ch/product-detail/de/XC6SLX100-3FGG484C/122-1759-ND/2339779) | FPGA Spartan 6 XC6SLX150-2FGG484C | EUR 132.19 | CHF 158.63
10 | LTM4615EV#PBF-ND (http://www.digikey.ch/product-detail/de/LTM4615EV%23PBF/LTM4615EV%23PBF-ND/2136229) | LTM4615EV Triple DC-DC | EUR 31.96 | CHF 383.52
10 | 497-7309-1-ND (http://www.digikey.ch/product-detail/de/LD1117S25TR/497-7309-1-ND/1883984) | LDO 2.5V LD1117S25TR | EUR 0.40 | CHF 4.80
1 | P10.0KCTR-ND (http://www.digikey.ch/product-detail/en/ERJ-6ENF1002V/P10.0KCTR-ND/111474) | Res 10k 1% 0805 5000pcs | EUR 18.99 | CHF 22.79
1 | P1.00KCTR-ND (http://www.digikey.ch/product-detail/en/ERJ-6ENF1001V/P1.00KCTR-ND/111281) | Res 1k 1% 0805 5000pcs | EUR 18.99 | CHF 22.79
15 | P1.43KHCT-ND (http://www.digikey.ch/product-detail/de/ERJ-3EKF1431V/P1.43KHCT-ND/198086) | RES 1.43k 1% | EUR 0.03 | CHF 0.54
20 | P1.60KHCT-ND (http://www.digikey.ch/product-detail/en/ERJ-3EKF1601V/P1.60KHCT-ND/1746732) | RES 1.6k 1% | EUR 0.08 | CHF 1.92
70 | P49.9CCT-ND | RES 49.9 1% | EUR 0.02 | CHF 1.93
15 | P4.87KCCT-ND | RES 4.87k 1% | EUR 0.06 | CHF 1.08
100 | 490-4539-1-ND (http://www.digikey.ch/product-detail/en/GRM31CR60J107ME39L/490-4539-1-ND/1033313) | CAP 100uF | EUR 0.74 | CHF 88.80
60 | 587-1334-1-ND (http://www.digikey.ch/product-detail/en/JMK316B7226ML-T/587-1334-1-ND/931111) | CAP 22uF X7R | EUR 0.28 | CHF 20.16
20 | 718-1106-1-ND (http://www.digikey.ch/product-detail/en/593D227X96R3D2TE3/718-1106-1-ND/1559600) | CAP 220uF 6.3V low esr | EUR 1.16 | CHF 27.72
160 | 445-1320-1-ND (http://www.digikey.ch/product-detail/en/C1608X5R1A474K/445-1320-1-ND/567693) | CAP 0.47uF 10% X5R | EUR 0.02 | CHF 4.40
30 | 478-3273-1-ND | CAP 10uF Tantalum | EUR 0.86 | CHF 30.96
20 | 490-2547-1-ND (http://www.digikey.ch/product-detail/de/NFE31PT222Z1E9L/490-2547-1-ND/600020) | FILTER LC HIGH FREQ 2200PF NFE31PT222Z1E9L | EUR 0.51 | CHF 12.24
20 | 535-10513-1-ND | L 1uH 150mA | EUR 0.19 | CHF 4.56
8 | CTX718LVCT-ND (http://www.digikey.ch/product-detail/de/CB3LV-3I-106M2500/CTX718LVCT-ND/1638173) | Oscillator 106.25MHz +/-50ppm CB3LV-3I-106M2500 | EUR 2.78 | CHF 26.69
10 | 609-2961-ND | CONN HEADER 2x5PoS DL 2MM | EUR 1.09 | CHF 13.08
8 | 350-1778-ND | LED 2X2 3MM HI DENSITY RED PCMNT | EUR 2.49 | CHF 23.90
10 | CT1934MS-ND (http://www.digikey.ch/product-detail/de/193-4MS/CT1934MS-ND/267293) | SWITCH DIP 4POS SIDE ACT SMT | EUR 1.02 | CHF 12.24
10 | JS28F128P30TF75A-ND | IC FLASH 128MBIT 65NM 56TSOP 75ns | EUR 5.67 | CHF 68.04
10 | NC7SZ08P5XCT-ND | IC GATE AND 2-INPUT UHS SC70-5 | EUR 0.28 | CHF 3.36
8 | A29038-ND | VME DIN41612 Female Right Angle 96Pin Connector | EUR 4.50 | CHF 43.20
20 | AE10565-ND | Conn Header 26PS 2mm | EUR 0.86 | CHF 20.64
8 | 553-1353-ND | CONN PULSEJACK 1x2 Port 10/100B-TX | EUR 9.15 | CHF 87.84
8 | 576-1645-2-ND | IC TXRX PHY 10/100 LV/LP | EUR 1.06 | CHF 10.20
8 | DP83640TVV-ND | TXRX PHY IEEE 1PORT 1588 48-LQFP | EUR 10.27 | CHF 98.59
8 | CTX308LVCT-ND | OSC 25.0000MHZ 3.3V | EUR 1.54 | CHF 14.78
10 | 768-1007-1-ND | FT232RL USB UART JTAG | EUR 3.38 | CHF 40.50
10 | H2959CT-ND | USB Mini CONN RECEPT MINI USB2.0 5POS | EUR 0.85 | CHF 10.20
10 | 490-1037-1-ND | FERRITE CHIP 120 OHM 2000MA BLM18PG121SN1D | EUR 0.19 | CHF 2.24
10 | BAS16FSCT-ND | BAS16 DIODE ULTRAFAST HI COND SOT-23 | EUR 0.14 | CHF 1.73
10 | OR896-ND | CONNB 2x5Pos 2.54mm | EUR 0.82 | CHF 9.84
 |  |  |  | CHF 1782.46
