73jn/td-fpga-developing-board/FPGA-POETIC/ReferenceBoards/FPGA-Rack_v1/01_Doc/Intern/FPGA_comparison.xlsx

Manufacturer | Chip | Package | Farnell | Farnell Price | Digikey | Digikey Price | Description | Cells | I/O
Spartan 3
Xilinx | XC3S500E | FGG320 |  |  | 122-1526-ND | 28.85 |  | 500000 Gates ~= 10476 | 232
Xilinx | XC3S1200E | FGG320 | 1605832 | 94 | 122-1516-ND | 39.99 |  | 1200000 Gates ~= 19512 | 250
Xilinx | XC3S1600E | FGG484 | 1762480 | 205.15 | XC3S1600E-4FGG320I-ND | 64 |  | 1600000 ~= 33192 | 250
Spartan 6
Xilinx | XC6SLX45 | 324CSBGA | 1762496 | 178.85 | 122-1732-ND | 47.18 |  | 24051 | 190
Xilinx | XC6SLX45T | 324CSBGA |  |  | 122-1774-ND | 55.02 | With Transceiver & PCI Express | 43661 | 190
Xilinx | XC6SLX45T | FGG484 | 1762498 | 274 | 122-1737-ND | 69 | With Transceiver & PCI Express | 43661 | 296
Xilinx | XC6SLX75 | FGG484 |  |  | 122-1739-ND | 98 |  | 74637 | 280
Xilinx | XC6SLX75T | FGG484 |  |  | 122-1777-ND | 93 | With Transceiver & PCI Express | 74637 | 268
Xilinx | XC6SLX100T | FGG484C |  |  | 122-1761-ND | 117 | With Transceiver & PCI Express | 101261 | 296
Artix7 | not yet available
Zynq | not yet available
