73jn/td-fpga-developing-board/FPGA-POETIC/ReferenceBoards/FPGA-Rack_v1/04_PCB/Commandes/20140714_FPGARack_command.xls

Personne concernée: | Oliver Gubler
Mandat no.: | Réparation | Chef de projet / professeur: | Corthay François
Salle: | A306
Digikey |  |  | Monnaie | USD
Quantity | Reference | Designation | Unit Price
1 | 122-1674-ND (http://www.digikey.ch/product-detail/de/XC6SLX45-2FGG484C/122-1674-ND/2408284) | FPGA Spartan 6 XC6SLX45-2FGG484C | USD 59.78 | USD 59.78
4 | 122-1759-ND (http://www.digikey.ch/product-detail/de/XC6SLX100-3FGG484C/122-1759-ND/2339779) | FPGA Spartan 6 XC6SLX100-3FGG484C | USD 129.61 | USD 518.44
3 | 122-1526-ND (http://www.digikey.ch/product-detail/en/XC3S500E-4FGG320C/122-1526-ND/1642502) | FPGA Spartan 3 XC3S55E-4FGG320C | USD 28.18 | USD 84.54
 |  |  |  | USD 662.76
