73jn/td-fpga-developing-board/FPGA-POETIC/ToBeDeleted/AltiumLib/User Guide/Exercice/Exercice.docx

Exercice Altium Designer

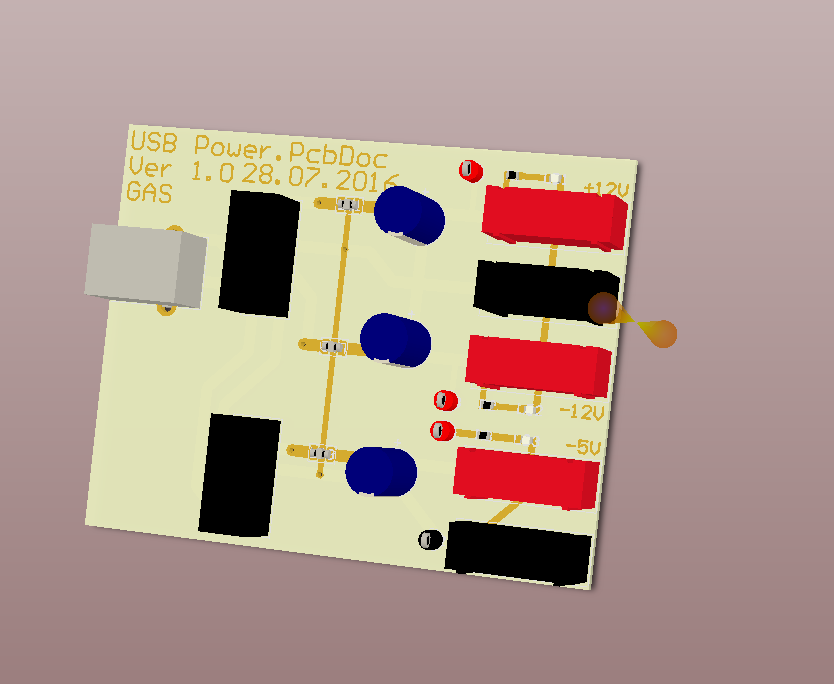
[picture p105: figure]

# 1. Schematic

## Schematic Redraw exactly this 2 sheets of schematic.

# 2. PCB

## Routing Route all the nets of the board, run Design rules check and observe the pcb.

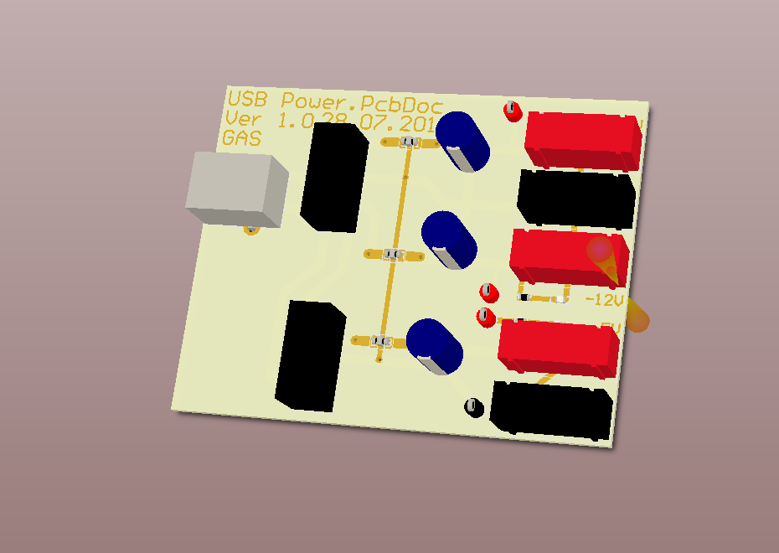
[picture p106: figure]

# 3. Net identifier scope

## Net identifier scope

Try the different connection method in Project->Project Options->Options->Net Identifier Scope

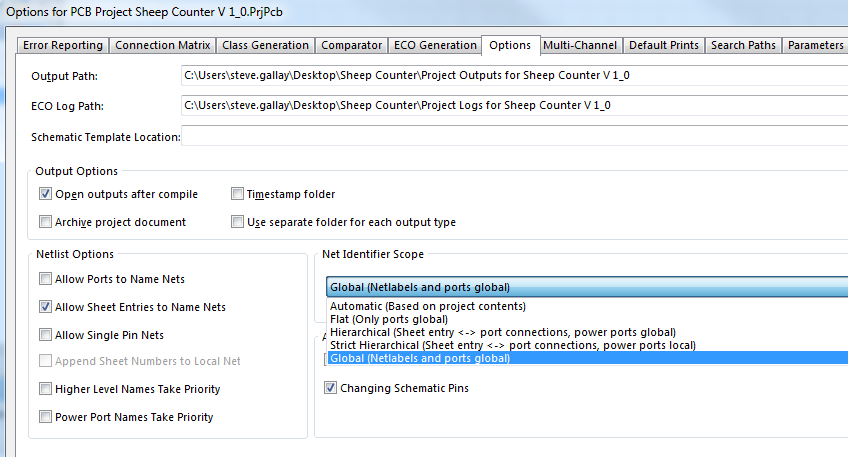
[picture p107: figure]

# 4. Hierarchical schematic

## Hierarchical schematic

Add a new sheet and make a hierarchical schematic.

Document Version 1.0 6 /6

Altium Designer
