73jn/td-fpga-developing-board/FPGA-POETIC/ToBeDeleted/AltiumLib/User Guide/Exercice.pdf

# Exercice Altium Designer

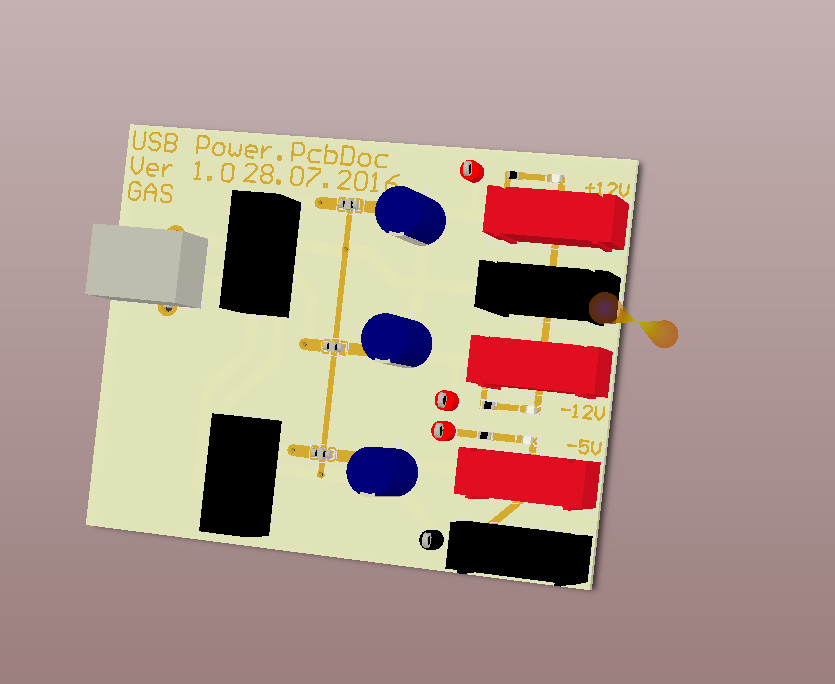
[picture p108: figure]
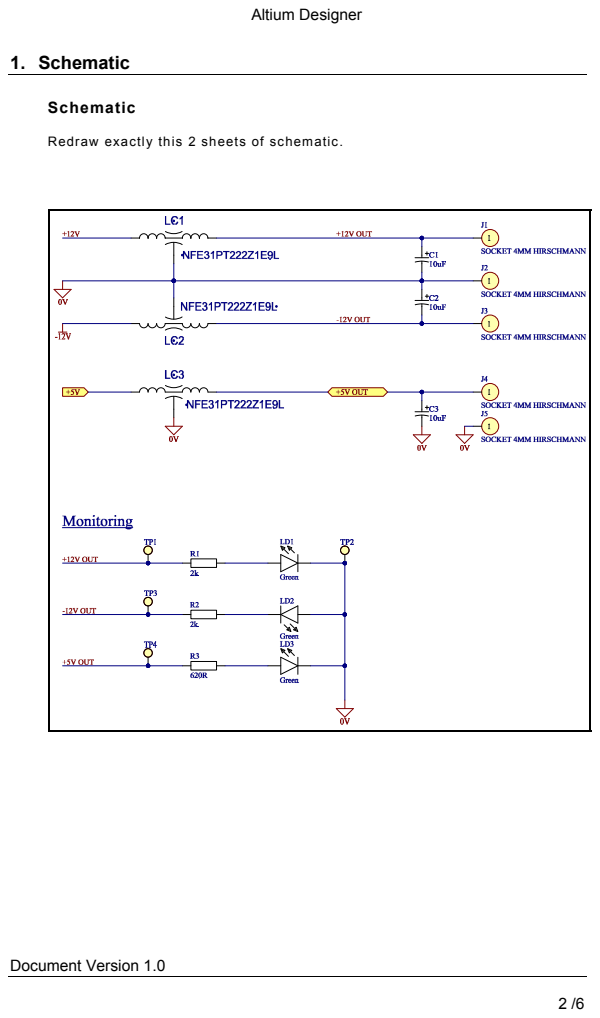
[picture p109: page 2]
Altium Designer; Document Version 1.0; 1. Schematic; Schematic

Redraw exactly this 2 sheets of schematic.

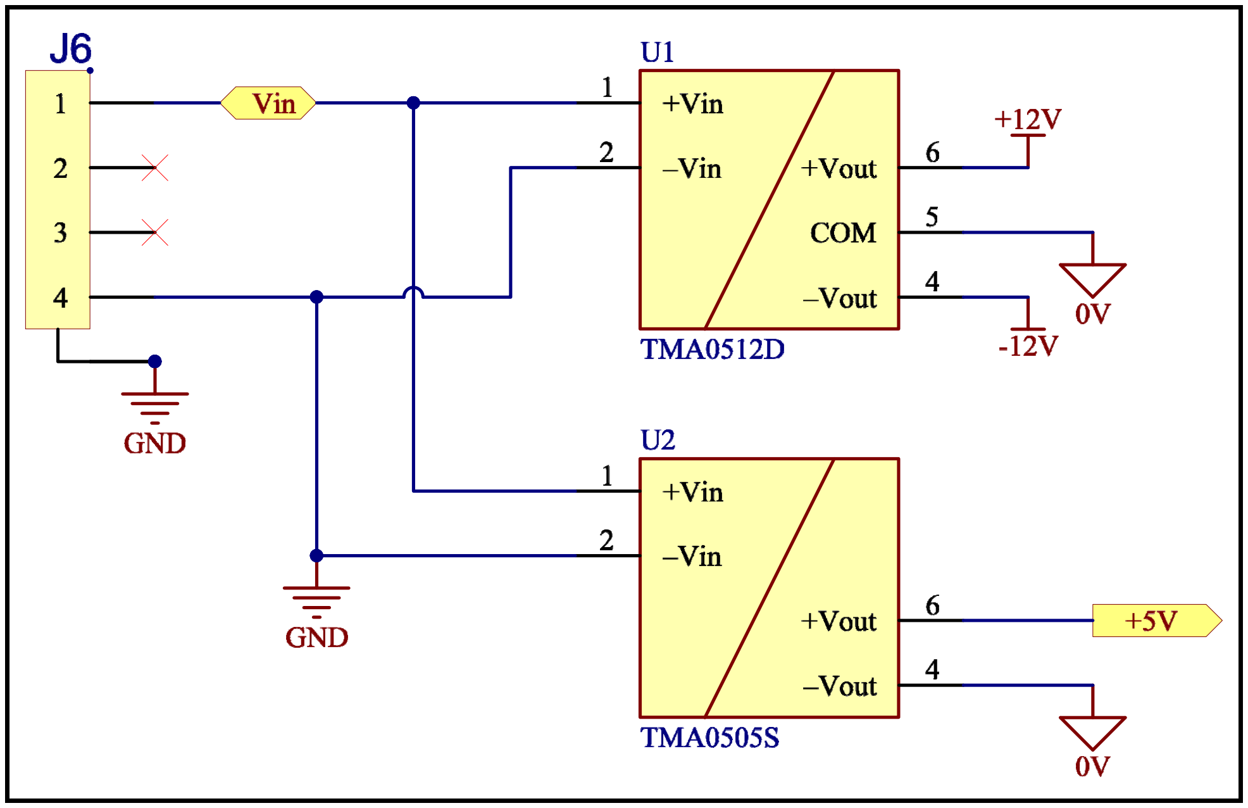
[picture p110: figure]

Document Version 1.0

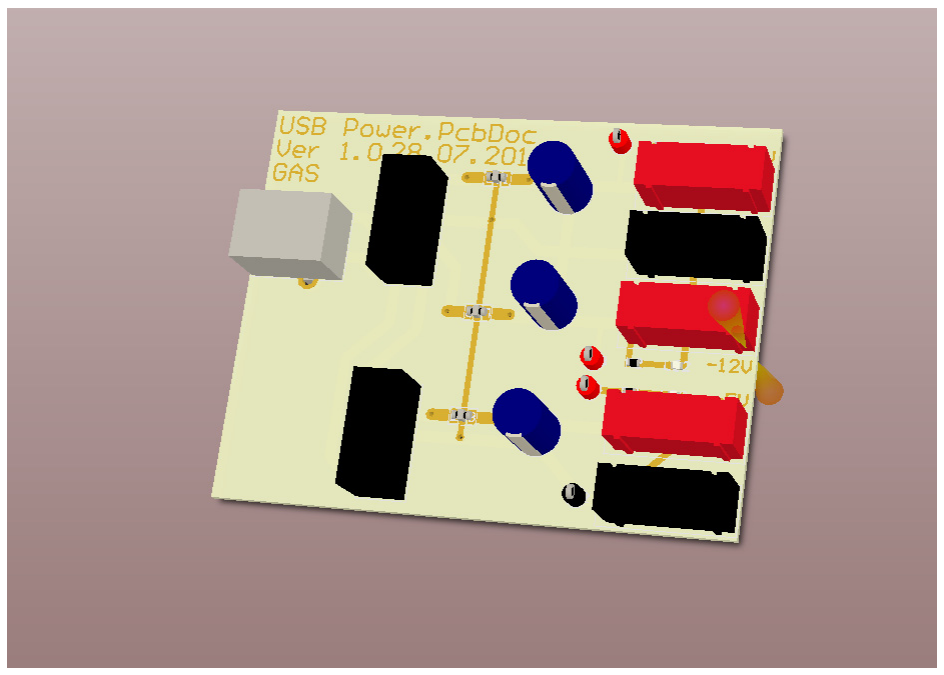
[picture p111: figure]

Document Version 1.0

### 2. PCB

### 2.1 Routing

Route all the nets of the board, run Design rules check and observe the pcb.

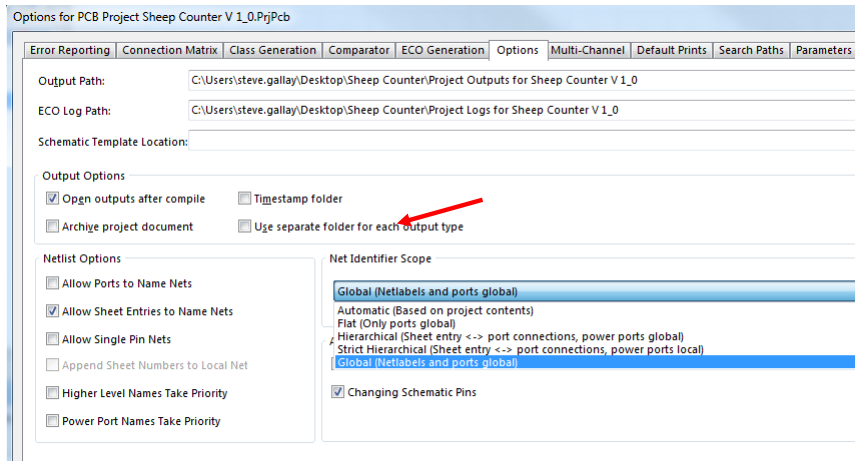
[picture p112: figure]

Document Version 1.0

3. Net identifier scope

### 3.1 Net identifier scope

Try the different connection method in Project->Project Options->Options->Net Identifier Scope

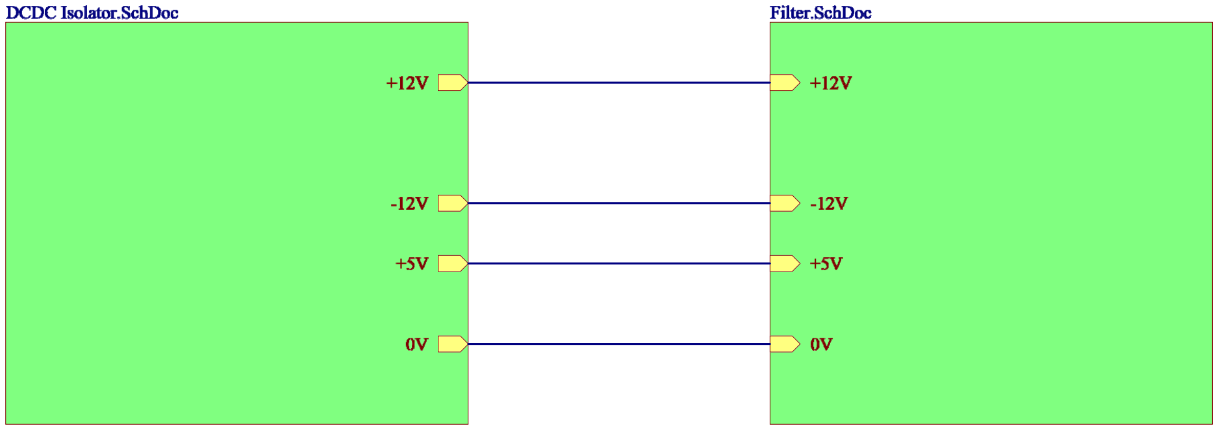
[picture p113: figure]

Document Version 1.0

### 4. Hierarchical schematic

### 4.1 Hierarchical schematic

Add a new sheet and make a hierarchical schematic.
