73jn/td-fpga-developing-board/FPGA/Board/ise/poetic/par_usage_statistics.html

Par Statistics

Total Non-vccgnd Signals=1717

Total Non-vccgnd Design Pins=4697

Total Non-vccgnd Conns=4697

Total Non-vccgnd Timing Constrained Conns=4579

Phase 1 CPU=7.5 sec

Phase 2 CPU=9.2 sec

Phase 3 CPU=11.7 sec

Phase 4 CPU=15.5 sec

Phase 5 CPU=17.5 sec

Phase 6 CPU=17.5 sec

Phase 7 CPU=17.5 sec

Phase 8 CPU=17.5 sec

Phase 9 CPU=17.5 sec

Phase 10 CPU=17.8 sec

AvgWirelenPerPin Fanout 1=5.0

AvgWirelenPerPin Fanout 2=5.5

AvgWirelenPerPin Fanout 3=2.7

AvgWirelenPerPin Fanout 4=3.3

AvgWirelenPerPin Fanout 10=3.4

AvgWirelenPerPin Fanout 50=3.8

AvgWirelenPerPin Fanout 100=8.1

AvgWirelenPerPin Fanout 500=11.5

AvgWirelenPerPin Fanout 5000=0.0

AvgWirelenPerPin Fanout 20000=0.0

AvgWirelenPerPin Fanout 50000=0.0

AvgWirelenPerPin Fanout 100000=0.0

IRR Gamma=1.0976
