73jn/td-fpga-developing-board/FPGA/Board/ise/poetic/usage_statistics_webtalk.html

### Device Usage Page (usage_statistics_webtalk.html)

This HTML page displays the device usage statistics that will be sent to Xilinx.

Software Version and Target Device
Product Version: | ISE:14.7 (ISE) - P.20131013 | Target Family: | Spartan6
OS Platform: | NT64 | Target Device: | xc6slx150
Project ID (random number) | a0b00f1d05e14e2f90e3da3fe5e04dc6.A054BAA6162249A7B48F4653C0F18C4E.82 | Target Package: | fgg484
Registration ID | 174116386_174116387_210720312_167 | Target Speed: | -3
Date Generated | 2021-08-30T18:26:53 | Tool Flow | ISE

User Environment
OS Name | Microsoft , 64-bit | OS Release | major release (build 9200)
CPU Name | Intel(R) Core(TM) i7-8700 CPU @ 3.20GHz | CPU Speed | 3192 MHz
OS Name | Microsoft , 64-bit | OS Release | major release (build 9200)
CPU Name | Intel(R) Core(TM) i7-8700 CPU @ 3.20GHz | CPU Speed | 3192 MHz

Device Usage Statistics
Macro Statistics | Miscellaneous Statistics | Net Statistics | Site Usage

Accumulators=1

33-bit up accumulator=1

Adders/Subtractors=20

13-bit subtractor=1

14-bit adder=1

19-bit adder=1

3-bit adder=1

32-bit adder=14

32-bit subtractor=2

Comparators=12

10-bit comparator greater=1

12-bit comparator greater=1

19-bit comparator greater=2

3-bit comparator equal=1

30-bit comparator greater=3

32-bit comparator equal=2

32-bit comparator greater=2

Counters=11

10-bit up counter=1

11-bit up counter=1

12-bit up counter=1

14-bit up counter=1

2-bit up counter=1

3-bit up counter=2

30-bit up counter=3

4-bit up counter=1

FSMs=6 Multiplexers=108

1-bit 12-to-1 multiplexer=2

1-bit 2-to-1 multiplexer=49

10-bit 2-to-1 multiplexer=1

12-bit 2-to-1 multiplexer=2

14-bit 2-to-1 multiplexer=2

3-bit 2-to-1 multiplexer=1

32-bit 2-to-1 multiplexer=25

8-bit 12-to-1 multiplexer=1

8-bit 2-to-1 multiplexer=25

Multipliers=11

32x5-bit multiplier=10

33x3-bit multiplier=1

RAMs=1

8x8-bit dual-port distributed RAM=1

Registers=550

Flip-Flops=550

Xors=1

1-bit xor2=1

MiscellaneousStatistics

AGG_BONDED_IO=21

AGG_IO=21

AGG_LOCED_IO=21

AGG_SLICE=427

NUM_BONDED_IOB=21

NUM_BSFULL=377

NUM_BSLUTONLY=765

NUM_BSREGONLY=159

NUM_BSUSED=1301

NUM_BUFG=1

NUM_DPRAM_O5ANDO6=4

NUM_DPRAM_O6ONLY=4

NUM_DSP48A1=10

NUM_LOCED_IOB=21

NUM_LOGIC_O5ANDO6=306

NUM_LOGIC_O5ONLY=284

NUM_LOGIC_O6ONLY=520

NUM_LUT_RT_DRIVES_CARRY4=11

NUM_LUT_RT_DRIVES_FLOP=13

NUM_LUT_RT_EXO5=13

NUM_LUT_RT_EXO6=11

NUM_LUT_RT_O6=284

NUM_SLICEL=192

NUM_SLICEM=2

NUM_SLICEX=233

NUM_SLICE_CARRY4=166

NUM_SLICE_CONTROLSET=40

NUM_SLICE_CYINIT=1766

NUM_SLICE_F7MUX=26

NUM_SLICE_FF=639

NUM_SLICE_LATCH=2

NUM_SLICE_LATCHLOGIC=2

NUM_SLICE_UNUSEDCTRL=232

NUM_UNUSABLE_FF_BELS=99

NetStatistics

NumNets_Active=1739

NumNets_Gnd=1

NumNets_Vcc=1

NumNodesOfType_Active_BOUNCEACROSS=20

NumNodesOfType_Active_BOUNCEIN=150

NumNodesOfType_Active_BUFGOUT=1

NumNodesOfType_Active_BUFHINP2OUT=10

NumNodesOfType_Active_CLKPIN=193

NumNodesOfType_Active_CLKPINFEED=10

NumNodesOfType_Active_CNTRLPIN=321

NumNodesOfType_Active_DOUBLE=2112

NumNodesOfType_Active_GENERIC=26

NumNodesOfType_Active_GLOBAL=106

NumNodesOfType_Active_INPUT=306

NumNodesOfType_Active_IOBIN2OUT=19

NumNodesOfType_Active_IOBOUTPUT=19

NumNodesOfType_Active_LUTINPUT=3542

NumNodesOfType_Active_OUTBOUND=1774

NumNodesOfType_Active_OUTPUT=1764

NumNodesOfType_Active_PADINPUT=13

NumNodesOfType_Active_PADOUTPUT=7

NumNodesOfType_Active_PINBOUNCE=852

NumNodesOfType_Active_PINFEED=4071

NumNodesOfType_Active_QUAD=2332

NumNodesOfType_Active_REGINPUT=322

NumNodesOfType_Active_SINGLE=2502

NumNodesOfType_Vcc_CLKPIN=2

NumNodesOfType_Vcc_CNTRLPIN=2

NumNodesOfType_Vcc_HVCCOUT=173

NumNodesOfType_Vcc_INPUT=30

NumNodesOfType_Vcc_KVCCOUT=18

NumNodesOfType_Vcc_LUTINPUT=598

NumNodesOfType_Vcc_PINBOUNCE=16

NumNodesOfType_Vcc_PINFEED=630

NumNodesOfType_Vcc_REGINPUT=14

SiteStatistics

BUFG-BUFGMUX=1

IOB-IOBM=8

IOB-IOBS=13

SLICEL-SLICEM=113

SLICEX-SLICEL=44

SLICEX-SLICEM=39

SiteSummary

BUFG=1

BUFG_BUFG=1

CARRY4=166

DSP48A1=10

DSP48A1_DSP48A1=10

FF_SR=137

HARD0=21

HARD1=9

INVERTER=1

IOB=21

IOB_IMUX=7

IOB_INBUF=7

IOB_OUTBUF=14

LUT5=603

LUT6=1121

LUT_OR_MEM5=4

LUT_OR_MEM6=8

PAD=21

PULL_OR_KEEP1=1

REG_SR=506

SELMUX2_1=26

SLICEL=192

SLICEM=2

SLICEX=233

Configuration Data

DSP48A1

CEA=[CEA_INV:0] [CEA:10]

CEB=[CEB_INV:0] [CEB:10]

CEC=[CEC:10] [CEC_INV:0]

CECARRYIN=[CECARRYIN_INV:0] [CECARRYIN:10]

CED=[CED_INV:0] [CED:10]

CEM=[CEM_INV:0] [CEM:10]

CEOPMODE=[CEOPMODE_INV:0] [CEOPMODE:10]

CEP=[CEP:10] [CEP_INV:0]

CLK=[CLK:10] [CLK_INV:0]

RSTA=[RSTA:10] [RSTA_INV:0]

RSTB=[RSTB:10] [RSTB_INV:0]

RSTC=[RSTC_INV:0] [RSTC:10]

RSTCARRYIN=[RSTCARRYIN_INV:0] [RSTCARRYIN:10]

RSTD=[RSTD_INV:0] [RSTD:10]

RSTM=[RSTM:10] [RSTM_INV:0]

RSTOPMODE=[RSTOPMODE_INV:0] [RSTOPMODE:10]

RSTP=[RSTP_INV:0] [RSTP:10]

DSP48A1_DSP48A1

A0REG=[0:10]

A1REG=[0:10]

B0REG=[0:10]

B1REG=[0:10]

B_INPUT=[DIRECT:10]

CARRYINREG=[0:10]

CARRYINSEL=[OPMODE5:10]

CARRYOUTREG=[0:10]

CEA=[CEA_INV:0] [CEA:10]

CEB=[CEB_INV:0] [CEB:10]

CEC=[CEC:10] [CEC_INV:0]

CECARRYIN=[CECARRYIN_INV:0] [CECARRYIN:10]

CED=[CED_INV:0] [CED:10]

CEM=[CEM_INV:0] [CEM:10]

CEOPMODE=[CEOPMODE_INV:0] [CEOPMODE:10]

CEP=[CEP:10] [CEP_INV:0]

CLK=[CLK:10] [CLK_INV:0]

CREG=[0:10]

DREG=[0:10]

MREG=[0:10]

OPMODEREG=[0:10]

PREG=[0:10]

RSTA=[RSTA:10] [RSTA_INV:0]

RSTB=[RSTB:10] [RSTB_INV:0]

RSTC=[RSTC_INV:0] [RSTC:10]

RSTCARRYIN=[RSTCARRYIN_INV:0] [RSTCARRYIN:10]

RSTD=[RSTD_INV:0] [RSTD:10]

RSTM=[RSTM:10] [RSTM_INV:0]

RSTOPMODE=[RSTOPMODE_INV:0] [RSTOPMODE:10]

RSTP=[RSTP_INV:0] [RSTP:10]

RSTTYPE=[SYNC:10]

FF_SR

CK=[CK:137] [CK_INV:0]

SRINIT=[SRINIT0:132] [SRINIT1:5]

SYNC_ATTR=[ASYNC:137]

IOB_OUTBUF

DRIVEATTRBOX=[12:14]

SLEW=[SLOW:14]

SUSPEND=[3STATE:14]

LUT_OR_MEM5

CLK=[CLK:4] [CLK_INV:0]

LUT_OR_MEM=[RAM:4]

RAMMODE=[DPRAM32:4]

LUT_OR_MEM6

CLK=[CLK:8] [CLK_INV:0]

LUT_OR_MEM=[RAM:8]

RAMMODE=[DPRAM32:4] [DPRAM64:4]

PULL_OR_KEEP1

PULLTYPE=[PULLUP:1]

REG_SR

CK=[CK:502] [CK_INV:4]

LATCH_OR_FF=[FF:502] [LATCH:2] [AND2L:2]

SRINIT=[SRINIT0:478] [SRINIT1:28]

SYNC_ATTR=[ASYNC:506]

SLICEL

CLK=[CLK:47] [CLK_INV:2]

SLICEM

CLK=[CLK:2] [CLK_INV:0]

SLICEX

CLK=[CLK:142] [CLK_INV:2]

Pin Data

BUFG

I0=1

O=1

BUFG_BUFG

I0=1

O=1

CARRY4

CIN=132

CO0=2

CO1=2

CO2=3

CO3=132

CYINIT=34

DI0=155

DI1=146

DI2=143

DI3=131

O0=145

O1=137

O2=130

O3=130

S0=166

S1=156

S2=147

S3=143

DSP48A1

A0=10

A1=10

A10=10

A11=10

A12=10

A13=10

A14=10

A15=10

A16=10

A17=10

A2=10

A3=10

A4=10

A5=10

A6=10

A7=10

A8=10

A9=10

B0=10

B1=10

B10=10

B11=10

B12=10

B13=10

B14=10

B15=10

B16=10

B17=10

B2=10

B3=10

B4=10

B5=10

B6=10

B7=10

B8=10

B9=10

C0=10

C1=10

C10=10

C11=10

C12=10

C13=10

C14=10

C15=10

C16=10

C17=10

C18=10

C19=10

C2=10

C20=10

C21=10

C22=10

C23=10

C24=10

C25=10

C26=10

C27=10

C28=10

C29=10

C3=10

C30=10

C31=10

C32=10

C33=10

C34=10

C35=10

C36=10

C37=10

C38=10

C39=10

C4=10

C40=10

C41=10

C42=10

C43=10

C44=10

C45=10

C46=10

C47=10

C5=10

C6=10

C7=10

C8=10

C9=10

CEA=10

CEB=10

CEC=10

CECARRYIN=10

CED=10

CEM=10

CEOPMODE=10

CEP=10

CLK=10

D0=10

D1=10

D10=10

D11=10

D12=10

D13=10

D14=10

D15=10

D16=10

D17=10

D2=10

D3=10

D4=10

D5=10

D6=10

D7=10

D8=10

D9=10

M0=10

M1=10

M10=10

M11=10

M12=10

M13=10

M14=10

M15=10

M16=10

M2=10

M3=10

M4=10

M5=10

M6=10

M7=10

M8=10

M9=10

OPMODE0=10

OPMODE1=10

OPMODE2=10

OPMODE3=10

OPMODE4=10

OPMODE5=10

OPMODE6=10

OPMODE7=10

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

par -w -intstyle ise -ol high -mt off <fname>.ncd <fname>.ncd <fname>.pcf

trce -intstyle ise -v 3 -s 3 -n 3 -fastpaths -xml <fname>.twx <fname>.ncd -o <fname>.twr <fname>.pcf

bitgen -intstyle ise -f <fname>.ut <fname>.ncd

xst -intstyle ise -ifn <ise_file>

ngdbuild -intstyle ise -dd _ngo -nt timestamp -uc <fname>.ucf -p xc6slx150-fgg484-3 <fname>.ngc <fname>.ngd

map -intstyle ise -p xc6slx150-fgg484-3 -w -logic_opt off -ol high -t 1 -xt 0 -register_duplication off -r 4 -global_opt off -mt off -ir off -pr off -lc off -power off -o <fname>.ncd <fname>.ngd <fname>.pcf

par -w -intstyle ise -ol high -mt off <fname>.ncd <fname>.ncd <fname>.pcf

trce -intstyle ise -v 3 -s 3 -n 3 -fastpaths -xml <fname>.twx <fname>.ncd -o <fname>.twr <fname>.pcf

bitgen -intstyle ise -f <fname>.ut <fname>.ncd

xst -intstyle ise -ifn <ise_file>

ngdbuild -intstyle ise -dd _ngo -nt timestamp -uc <fname>.ucf -p xc6slx150-fgg484-3 <fname>.ngc <fname>.ngd

map -intstyle ise -p xc6slx150-fgg484-3 -w -logic_opt off -ol high -t 1 -xt 0 -register_duplication off -r 4 -global_opt off -mt off -ir off -pr off -lc off -power off -o <fname>.ncd <fname>.ngd <fname>.pcf

par -w -intstyle ise -ol high -mt off <fname>.ncd <fname>.ncd <fname>.pcf

trce -intstyle ise -v 3 -s 3 -n 3 -fastpaths -xml <fname>.twx <fname>.ncd -o <fname>.twr <fname>.pcf

bitgen -intstyle ise -f <fname>.ut <fname>.ncd

xst -intstyle ise -ifn <ise_file>

ngdbuild -intstyle ise -dd _ngo -nt timestamp -uc <fname>.ucf -p xc6slx150-fgg484-3 <fname>.ngc <fname>.ngd

map -intstyle ise -p xc6slx150-fgg484-3 -w -logic_opt off -ol high -t 1 -xt 0 -register_duplication off -r 4 -global_opt off -mt off -ir off -pr off -lc off -power off -o <fname>.ncd <fname>.ngd <fname>.pcf

par -w -intstyle ise -ol high -mt off <fname>.ncd <fname>.ncd <fname>.pcf

trce -intstyle ise -v 3 -s 3 -n 3 -fastpaths -xml <fname>.twx <fname>.ncd -o <fname>.twr <fname>.pcf

bitgen -intstyle ise -f <fname>.ut <fname>.ncd

Software Quality
Run Statistics
Program Name | Runs Started | Runs Finished | Errors | Fatal Errors | Internal Errors | Exceptions | Core Dumps
_impact | 42 | 30 | 0 | 0 | 0 | 0 | 0
bitgen | 129 | 129 | 0 | 0 | 0 | 0 | 0
map | 145 | 138 | 0 | 0 | 0 | 0 | 0
ngdbuild | 149 | 149 | 0 | 0 | 0 | 0 | 0
par | 138 | 138 | 0 | 0 | 0 | 0 | 0
trce | 137 | 137 | 0 | 0 | 0 | 0 | 0
xps | 1 | 1 | 0 | 0 | 0 | 0 | 0
xst | 158 | 158 | 0 | 0 | 0 | 0 | 0

Help Statistics
Help files

/doc/usenglish/isehelp/ise_c_overview.htm ( 1 )

Project Statistics
PROP_Enable_Message_Filtering=false | PROP_FitterReportFormat=HTML
PROP_LastAppliedGoal=Balanced | PROP_LastAppliedStrategy=Xilinx Default (unlocked)
PROP_ManualCompileOrderImp=false | PROP_PropSpecInProjFile=Store non-default values only
PROP_Simulator=Modelsim-SE VHDL | PROP_SynthTopFile=changed
PROP_Top_Level_Module_Type=HDL | PROP_UseSmartGuide=false
PROP_UserConstraintEditorPreference=Text Editor | PROP_VHDLSourceAnalysisStandard=VHDL-200X
PROP_intProjectCreationTimestamp=2021-07-14T15:49:25 | PROP_intWbtProjectID=A054BAA6162249A7B48F4653C0F18C4E
PROP_intWbtProjectIteration=82 | PROP_intWorkingDirLocWRTProjDir=Same
PROP_intWorkingDirUsed=No | PROP_AutoTop=true
PROP_DevFamily=Spartan6 | PROP_DevDevice=xc6slx150
PROP_DevFamilyPMName=spartan6 | PROP_DevPackage=fgg484
PROP_Synthesis_Tool=XST (VHDL/Verilog) | PROP_DevSpeed=-3
PROP_PreferredLanguage=VHDL | FILE_UCF=1

FILE_VHDL=1

Unisim Statistics
NGDBUILD_PRE_UNISIM_SUMMARY
NGDBUILD_NUM_BUFGP=1 | NGDBUILD_NUM_DSP48A1=10 | NGDBUILD_NUM_FD=6 | NGDBUILD_NUM_FDC=133
NGDBUILD_NUM_FDCE=469 | NGDBUILD_NUM_FDE=3 | NGDBUILD_NUM_FDP=7 | NGDBUILD_NUM_FDPE=21
NGDBUILD_NUM_GND=1 | NGDBUILD_NUM_IBUF=6 | NGDBUILD_NUM_INV=129 | NGDBUILD_NUM_LD=2
NGDBUILD_NUM_LUT1=298 | NGDBUILD_NUM_LUT2=234 | NGDBUILD_NUM_LUT3=132 | NGDBUILD_NUM_LUT4=100
NGDBUILD_NUM_LUT5=125 | NGDBUILD_NUM_LUT6=268 | NGDBUILD_NUM_MUXCY=585 | NGDBUILD_NUM_MUXF7=26
NGDBUILD_NUM_OBUF=14 | NGDBUILD_NUM_RAM16X1D=2 | NGDBUILD_NUM_RAM32M=1 | NGDBUILD_NUM_VCC=1

NGDBUILD_NUM_XORCY=541
NGDBUILD_POST_UNISIM_SUMMARY
NGDBUILD_NUM_BUFG=1 | NGDBUILD_NUM_DSP48A1=10 | NGDBUILD_NUM_FD=6 | NGDBUILD_NUM_FDC=133
NGDBUILD_NUM_FDCE=469 | NGDBUILD_NUM_FDE=3 | NGDBUILD_NUM_FDP=7 | NGDBUILD_NUM_FDPE=21
NGDBUILD_NUM_GND=1 | NGDBUILD_NUM_IBUF=6 | NGDBUILD_NUM_IBUFG=1 | NGDBUILD_NUM_INV=129
NGDBUILD_NUM_LD=2 | NGDBUILD_NUM_LUT1=298 | NGDBUILD_NUM_LUT2=234 | NGDBUILD_NUM_LUT3=132
NGDBUILD_NUM_LUT4=100 | NGDBUILD_NUM_LUT5=125 | NGDBUILD_NUM_LUT6=268 | NGDBUILD_NUM_MUXCY=585
NGDBUILD_NUM_MUXF7=26 | NGDBUILD_NUM_OBUF=14 | NGDBUILD_NUM_PULLUP=1 | NGDBUILD_NUM_RAM32M=1
NGDBUILD_NUM_VCC=1 | NGDBUILD_NUM_XORCY=541

XST Command Line Options
XST_OPTION_SUMMARY
-ifn=<fname>.prj | -ofn=<design_top> | -ofmt=NGC | -p=xc6slx150-3-fgg484
-top=<design_top> | -opt_mode=Speed | -opt_level=1 | -power=NO
-iuc=NO | -keep_hierarchy=No | -netlist_hierarchy=As_Optimized | -rtlview=Yes
-glob_opt=AllClockNets | -read_cores=YES | -write_timing_constraints=NO | -cross_clock_analysis=NO
-bus_delimiter=<> | -slice_utilization_ratio=100 | -bram_utilization_ratio=100 | -dsp_utilization_ratio=100
-reduce_control_sets=Auto | -fsm_extract=YES | -fsm_encoding=Auto | -safe_implementation=No
-fsm_style=LUT | -ram_extract=Yes | -ram_style=Auto | -rom_extract=Yes
-shreg_extract=YES | -rom_style=Auto | -auto_bram_packing=NO | -resource_sharing=YES
-async_to_sync=NO | -use_dsp48=Auto | -iobuf=YES | -max_fanout=100000
-bufg=16 | -register_duplication=YES | -register_balancing=No | -optimize_primitives=NO
-use_clock_enable=Auto | -use_sync_set=Auto | -use_sync_reset=Auto | -iob=Auto
-equivalent_register_removal=YES | -slice_utilization_ratio_maxmargin=5
