73jn/td-fpga-developing-board/FPGA-POETIC/ToBeDeleted/AltiumLib/Altium_launching_with_copy_lib/Install_Altium_launching_with_copy_lib.docx

Copier le répertoire : AltiumLib

P:\Public\Altium_launching_with_copy_lib

Sous C:\

Modifiez les droits pour qu’il soit en « Full control »

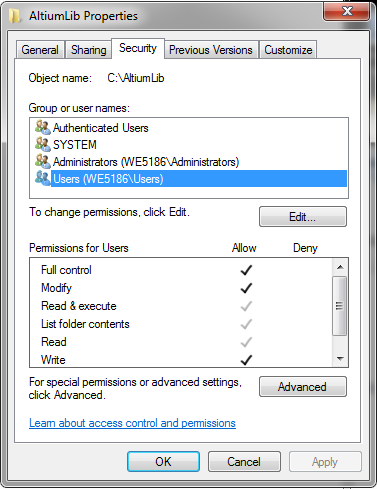
[picture p114: figure]

Sélectionnez le raccourci Altium Designer

Clic droit, Sélectionner Properties

Copier, coller la ligne suivante dans le champ target selon la photo ci-dessous

C:\AltiumLib\Copy_Library.cmd

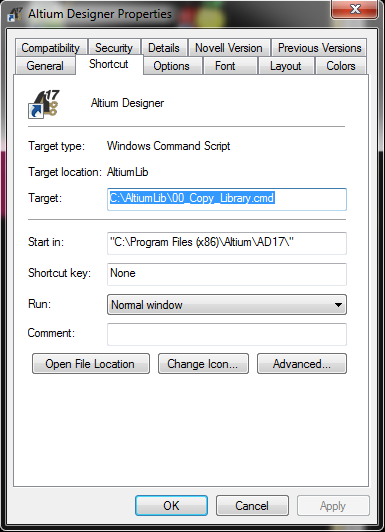
[picture p115: figure]

Modifier l’Icone

Lancez Altium Designer, une copie des librairies doit se faire sous

C:\AltiumLib\
