73jn/td-fpga-developing-board/JournalDeBord.md

# Journal de Bord
## 10.05.2021
Séance avec Mr. Corthay. Revue du schéma de la board FPGA de l'école. Entretien avec Alain Germanier pour discuter du schéma de la carte processeur, il veut plus que 4 DAC, FPGA doit être énorme. Entretien avec Steve Gallay.
Googler les FPGA, j'ai compris les bank. Il faudrait prendre la version SPARTAN 7. Il y a un processeur dans le SPARTAN 7 incroyable !

## 11.05.2021
J'ai été voir Carmine, il faut échantillonner des signaux de 200KHz, ==> ADC rapides !
Donc ca part sur 20 ADC LTC1420 ou 12 et 8 autres sur les entrées analogiques du spartan 7. Les LTC1420 echantillonnes a 10MHz (10MSPS) et sortent du parallele donc 20 x (12 bits de data + 1 bit overflow + 1 bit de clock) = 280 bits pour des ADC !

Finalement on part sur un ADS805 pour que ce soit enorme ! 20MSPS

La il va falloir partir sur le spartant 7 avec 400 IO minimum !

## 12.05.2021
J'ai discuté avec Corthay. Il faudrait connecter tous les ADC sur le même bus ==> OUTPUT ENABLE (tri state). Le problème c'est que l'ADS805 à un TOE de 40ns ce qui est bien trop long !
Je regarde alors pour partir sur un ADC12020, plus récent avec un TOE de 4ns.

Plot twist !
Le ADC12020 indique (j'imagine que c'est la même chose pour l'ADS805) qu'il faut utiliser un driver de ligne externe !
SN74ABT5402A pour le driver de ligne !
74LVC16241A ==> Fastest
==> Cooooooooooooooool
==> Plus besoin d'une grosse FPGA !
J'ai effectué des calculs. On peut au MAX regroupper 3 ADC avec le 74LVC16241A... Car il y a des delais dans les portes TRI-STATE. On commence a parler de nano secondes...
Donc la FPGA devrais tourner encore plus vite pour être plus précise. Ce n'est pas la bonne solution.

Plot plot twist !
LVDS est un bus série bas voltage. Souvent utilisé pour transmettre des infos a haute vitesse.
ADC12QS065 Quad 12-Bit 65 MSPS A/D Converter with LVDS Serialized Outputs datasheet (Rev. I)

## 13.05.2021
ferié (brunière)

## 14.05.2021
Plot plot plot twist :AD3421QRWETQ1, 25MSPS, 4 channel, spi, output en LVDS ! Il est en 2 wire LVDS de base !
Le ADC12QS065 n'est pas en stock !

Selon : https://www.reddit.com/r/FPGA/comments/kryxny/how_to_interface_an_lvds_adc_with_a_zynq_fpga/
Il faut connecter le clock de l'ADC sur une pin de la FPGA.
Il faut aussi connecter le clock des data qui vient depuis l'ADC sur un clock capable pin, donc un MRCC (multiple region clock capable) ou un SRCC (single region clock capable) (https://forums.xilinx.com/t5/Implementation/How-to-find-clock-compatible-pin/td-p/767038)
Le DFO (celui qui indique quand une nouvelle trame de data est envoyé) doit être connecté sur la même bank

## 17.05.2021

Schéma bloc le matin ! Ca rends bien. Les CLOCKs des ADC sont en différentiel.
Il faut que j'aille voir Alain !
Il faut mettre une flash, une ram je pense pour stocker les valeurs mesurées peut etre

Alors, 25MSPS est beaucoup trop. Chaque 400ns le processeur effectues 4 mesures ou une, ==> donc il faudrait echantillonner 500KSPS par canal au minimum.
==>>>>>>>>>>ADS7886SBDCKT, 1MSPS, 1 canal, serie ==> peu de connexions
en stock sur mouser, environ 4CHF/pce

## 18.05.2021

J'ai commencé a refaire le schéma block avec ADS7886SBDCKT.
J'ai connecté les clocks ensemble car ils ont tous besoin de 20MHz constamment.
Pour leur alimentation, il faut utiliser une référence de tension de préférence. J'ai trouvé LT1461CCS8-3#PBF sur mouser qui est ultra précis et qui pourrait alimenter tous les chips. Un chip consomme 1.5mA. Il faut donc 30mA en tout.
Il en faudrait deux en tout pour limiter les erreurs de tensions.
Il faut l'alimenter en 5V !
Mettre pleins de condos !

Pour les 8 sorties DAC, on peut intervertir des connecteurs SMA traversant; un fois au top une fois au bot. Il faudra peut etre changer l'USBA en micro USB

J'ai cherché des FPGA, aucun stock pour les SPARTAN 7...
Chez mouser il n'y a que le 
XC6SLX100-3FG484C (n° mouser : 217-C6SLX100-3FG484C)
en stock...

https://octopart.com/search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

La FPGA drive 24mA au max !

## 19.05.2021
J'ai cherché FPGA, discuté avec Alain, Fabien Matter, Silvan Zahno

## 20.05.2021
Les référence de 3V doivent être alimentés en 5V
La FPGA doit avoir du 1.2V et le 3.3V des banks
Les Ampli-Op doivent être alimenté en 3.3V
Les AD sont alimenté par la référence de tension et le niveau n'a pas besoin d'être adapté : https://datasheet.lcsc.com/szlcsc/XILINX-XC6SLX16-2FTG256C_C39313.pdf

J'ai fait la schématique

## 21.05.2021
Il faut ajouter un 3.3 to 1.2 : https://www.mouser.ch/ProductDetail/Texas-Instruments/LM2852YMXAX-12-NOPB?qs=X1J7HmVL2ZHkGMFREL3tMQ%3D%3D
LM2852YMXAX-1.2/NOPB

## 25.05.2021
 Oscillateur 
831022731
HCMOS, 100MHz, 5.2mm * 7.2mm

DEMANDER A STEVE DE FAIRE LE SC189CULTRT EN SOCKET RELOU A SOUDER
C'est le seul, 2.5MHz switching ==> Plus petits composants, moins de noise
1.2V, la bobine est indiquée dans le dataaaaasheeezt

mettre deS trous avec des entretoises
garder les autres trous fpga rack
Attention mezzannines espacement

## 26.01.2021
Schématique finie de la mezzanine
Connecteur mezzanine : https://www.erni.com/de/produkte-und-loesungen/detail/234208/
On peut passer dessus le connecteur 

LVDS to TTL : SN65LVDS2DR  https://www.mouser.ch/ProductDetail/Texas-Instruments/SN65LVDS2DR?qs=QViXGNcIEAuNo4UJspnA0g%3D%3D
ou bien
DS90LV018ATMX/NOPB : https://www.mouser.ch/ProductDetail/Texas-Instruments/DS90LV018ATMX-NOPB?qs=X1J7HmVL2ZGhGuL83KQT5g%3D%3D

## 27.05.2021
J'ai ajouté le receiver LVDS (DS90LV018ATMX)
J'ai été voir Steve
Et maintenant je fais la schématique de la board FPGA

Alors :
- 3V3 to 5V : RP402N501F-TR-FE    800mA ==> bobine environ 1A - 1.5A
- 5V to 3V3 : SC189ZSKTRT      1.5A

bobine : 74437334022 (2.2uH en 5020)

- 5V - 3V3 to 1V2 : SC189CULTRT      1.5A   ==> Remplacé par ADP2119ACPZ-1.2-R7

ADP2119
The inductor value is determined by the operating frequency,
input voltage, output voltage, and ripple current. A small inductor
value leads to a larger inductor current ripple and provides a
faster transient response; however, it degrades efficiency. A
large inductor value leads to a smaller current ripple and good
efficiency but slows the transient response. As a guideline, the
inductor current ripple, ΔIL, is typically set to 1/3 of the maximum
load current trade-off between the transient response and efficiency.
The inductor value can be calculated using the following equation:

En gros : petite inductance, temps de réponse rapide mais efficence = nul

Il faut 1.5uH j'ai calculé dans le datasheet ! (3v3 et 5V)
Bobine => 74437334015, 5020

## 28.05.2021
Les buck et les boost

998-KSZ8041TL SUR MOUSER !!!

## 31.05.2021

Je fais l'ethernet
831019170 pour le quartz 25 MHz
1N4148 en SOD323

Je dois modifier le pinout du connecteur des mezzanines... Car il faut séparer analog et digital

## 01.06.2021
Demander a Alain pourquoi jumper sur les spares.
## 02.06.2021
rapport
## 04.06.2021
planning et rapport

## 07.06.2021
Présentation des copaîns

## 08.06.2021
Présentation de Jean Nanchen

## 10.06.2021
Placement des connecteurs sur le PCB
Modif de la schematique
Mettre ca : https://www.mouser.ch/ProductDetail/Amphenol-Commercial-Products/12402054M611A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
Un USB C UPRight
J'ai fait un assemblage sur fusion pour bien tout contrôler si ca joue les connecteurs, ca passe au poil *****

## 11.06.2021
Commande des composants, il n'y a plus de deac j'ai de prendre rapidement un autre en 8bit mais il y avait des 10 bits fuck
Vendredi de la honte

# Sources
Passe bas 2 ème ordre  http://www.bedwani.ch/electro/ch9/

ADC AD3421QRWETQ1 : https://www.ti.com/lit/ds/symlink/adc3421-q1.pdf

# Pour le rapport
Mesure sur la référence de tension !
Expliquer pourquoi pas besoin d'un adapteur de tension entre AD et FPGA

Dire qu'on utilise toutes les pins dans le rapport

https://www.xilinx.com/support/documentation/user_guides/ug385.pdf
P92 : On voit que le LX75 et le LX100 et le LX150 sont compatible : il n'y a jamais nc LX100 tout seul ==> Compatible

Buck : différence entre une petite et grosse bobine.

https://www.xilinx.com/support/documentation/user_guides/ug393.pdf
https://resources.ultralibrarian.com/wp-content/uploads/2020/06/0402-table-750x339.png
COMMANDER LES CONDOS
P15-16 capacitor
Ils peuvent etre plus petit mais pas plus grands....
1005 pour les 470nF
2012 pour 4.7uF
3216 pour les 100uF

ADC TI : https://www.ti.com/europe/downloads/Choose%20the%20right%20data%20converter%20for%20your%20application.pdf

## presentation

- C'est quoi le projet ?
- Expliquer comment fonctionne le RACK en gros (photos), comment sont connectés les modules entre eux
- Faire un tour de la carte processeur
- Expliquer que je dois remplacer le processeur par un FPGA
- Je dois rajouter des ADC, plus de DAC
- J'i fait en sorte que la mezzanine peut se clipper sur la board de l'école
- Ce que j'ai fait durant ces 4 semaines
-
