73jn/td-fpga-developing-board/FPGA-POETIC/FPGA_Board/FPGA_POETIC_V1_01.pdf

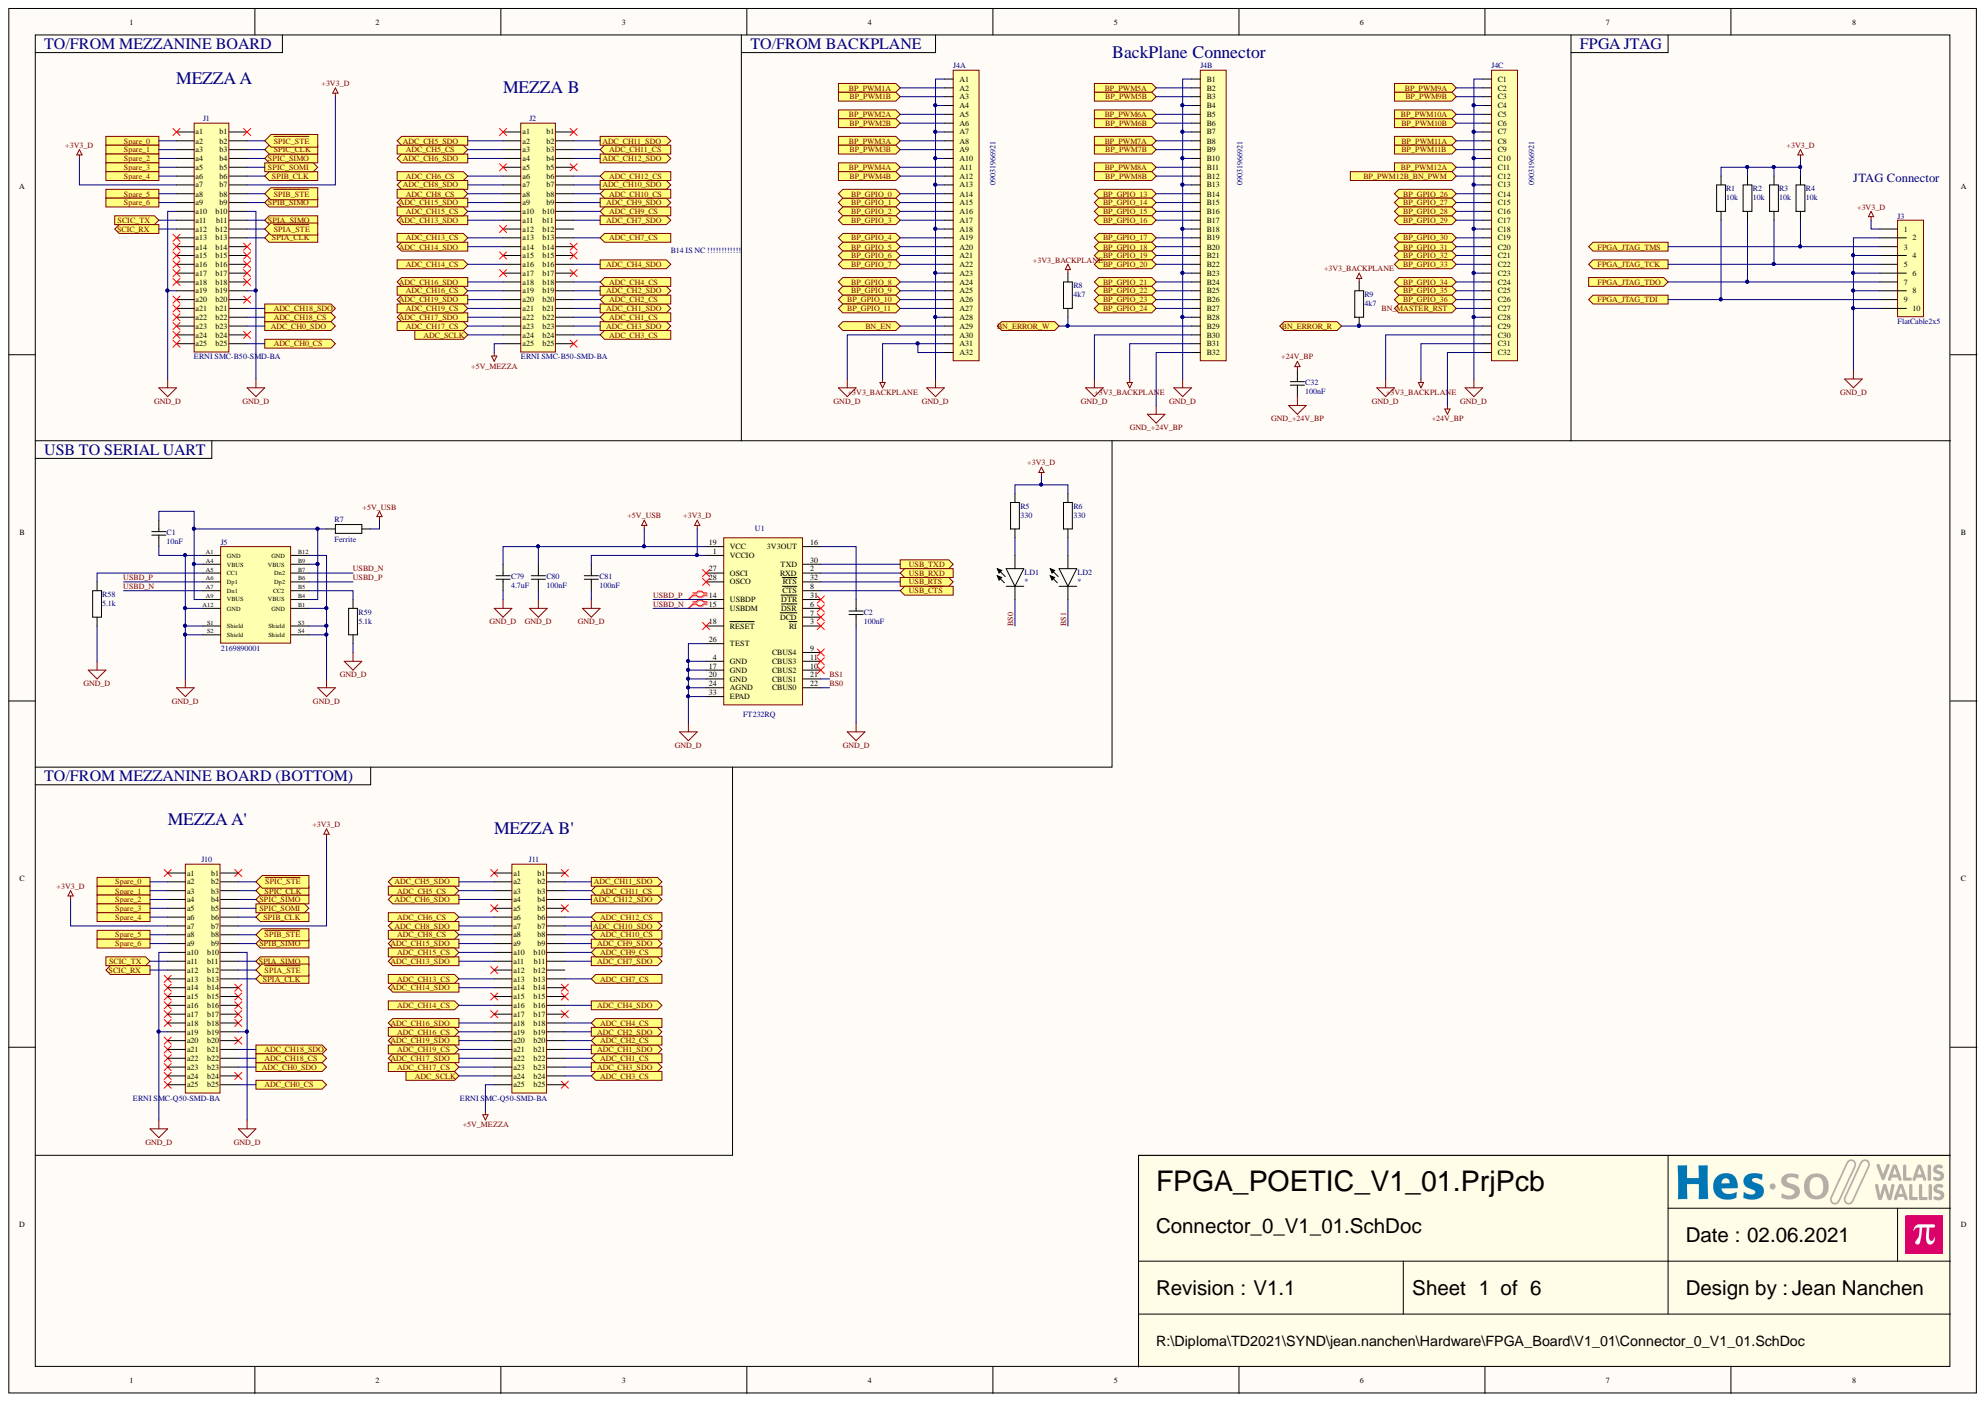
[picture p120: page 1]

USB TO SERIAL UART

TO/FROM MEZZANINE BOARD (BOTTOM)

ERNI SMC-Q50-SMD-BA

FPGA_POETIC_V1_01.PrjPcb Connector_0_V1_01.SchDoc

Date : 02.06.2021

Revision : V1.1 | Sheet 1 of 6 | Design by : Jean Nanchen

R:\Diploma\TD2021\SYND\jean.nanchen\Hardware\FPGA_Board\V1_01\Connector_0_V1_01.SchDoc

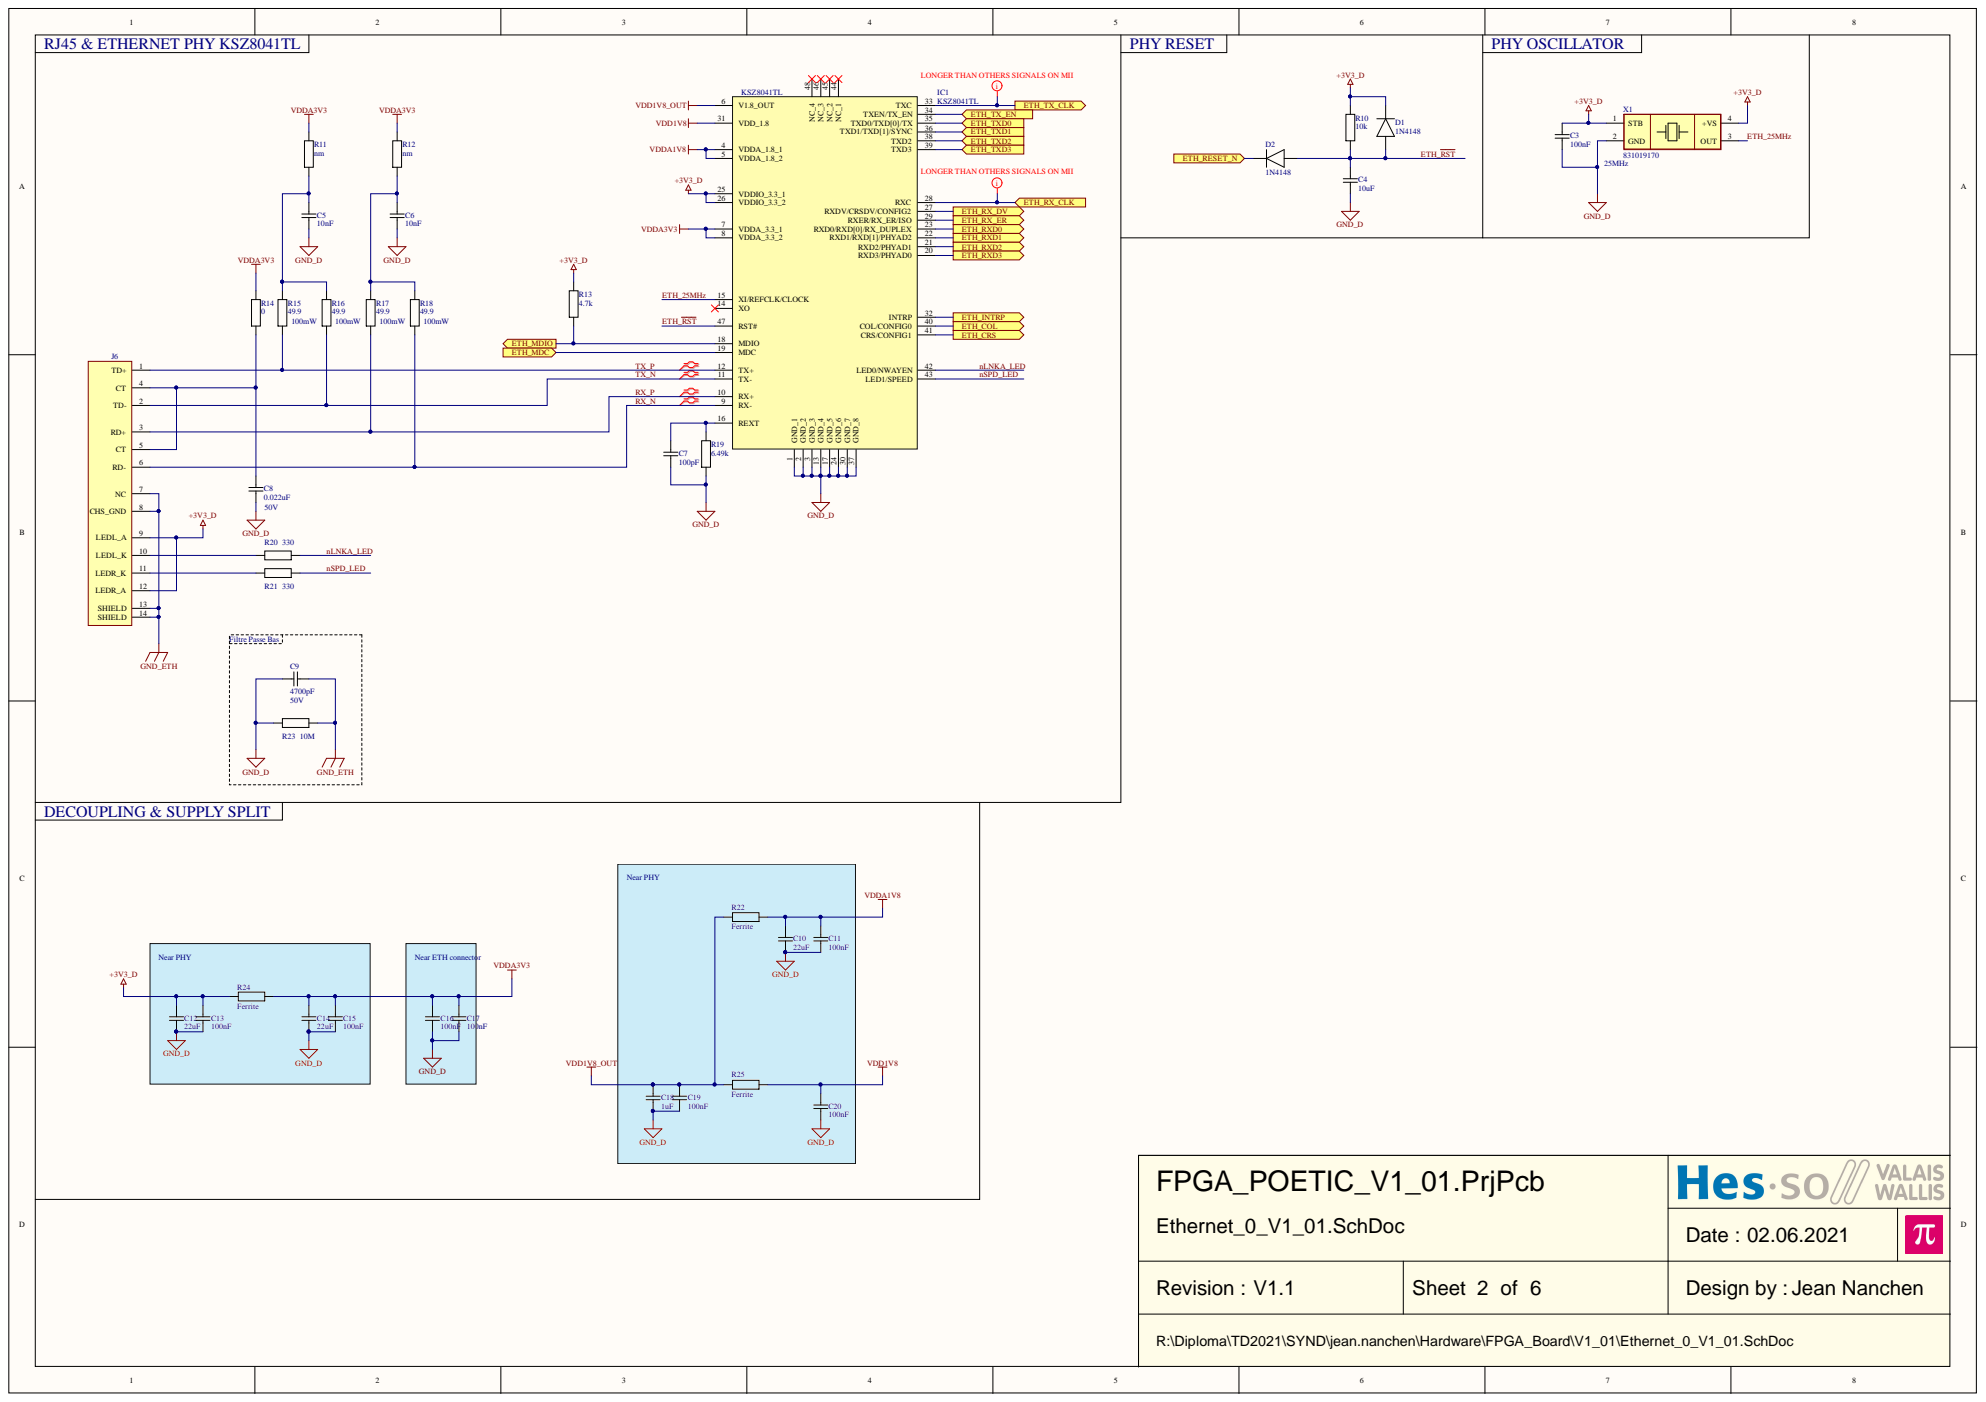
[picture p121: page 2]

LONGER THAN OTHERS SIGNALS ON MII

GND_6 24 TXD1/TXD[1]/SYNC 36 TXD0/TXD[0]/TX 35 TXEN/TX_EN 34 TXC 33

RX_P | RX- 9 RX+ 10
RX_N

FPGA_POETIC_V1_01.PrjPcb Ethernet_0_V1_01.SchDoc

Date : 02.06.2021

Revision : V1.1 | Sheet 2 of 6 | Design by : Jean Nanchen

R:\Diploma\TD2021\SYND\jean.nanchen\Hardware\FPGA_Board\V1_01\Ethernet_0_V1_01.SchDoc

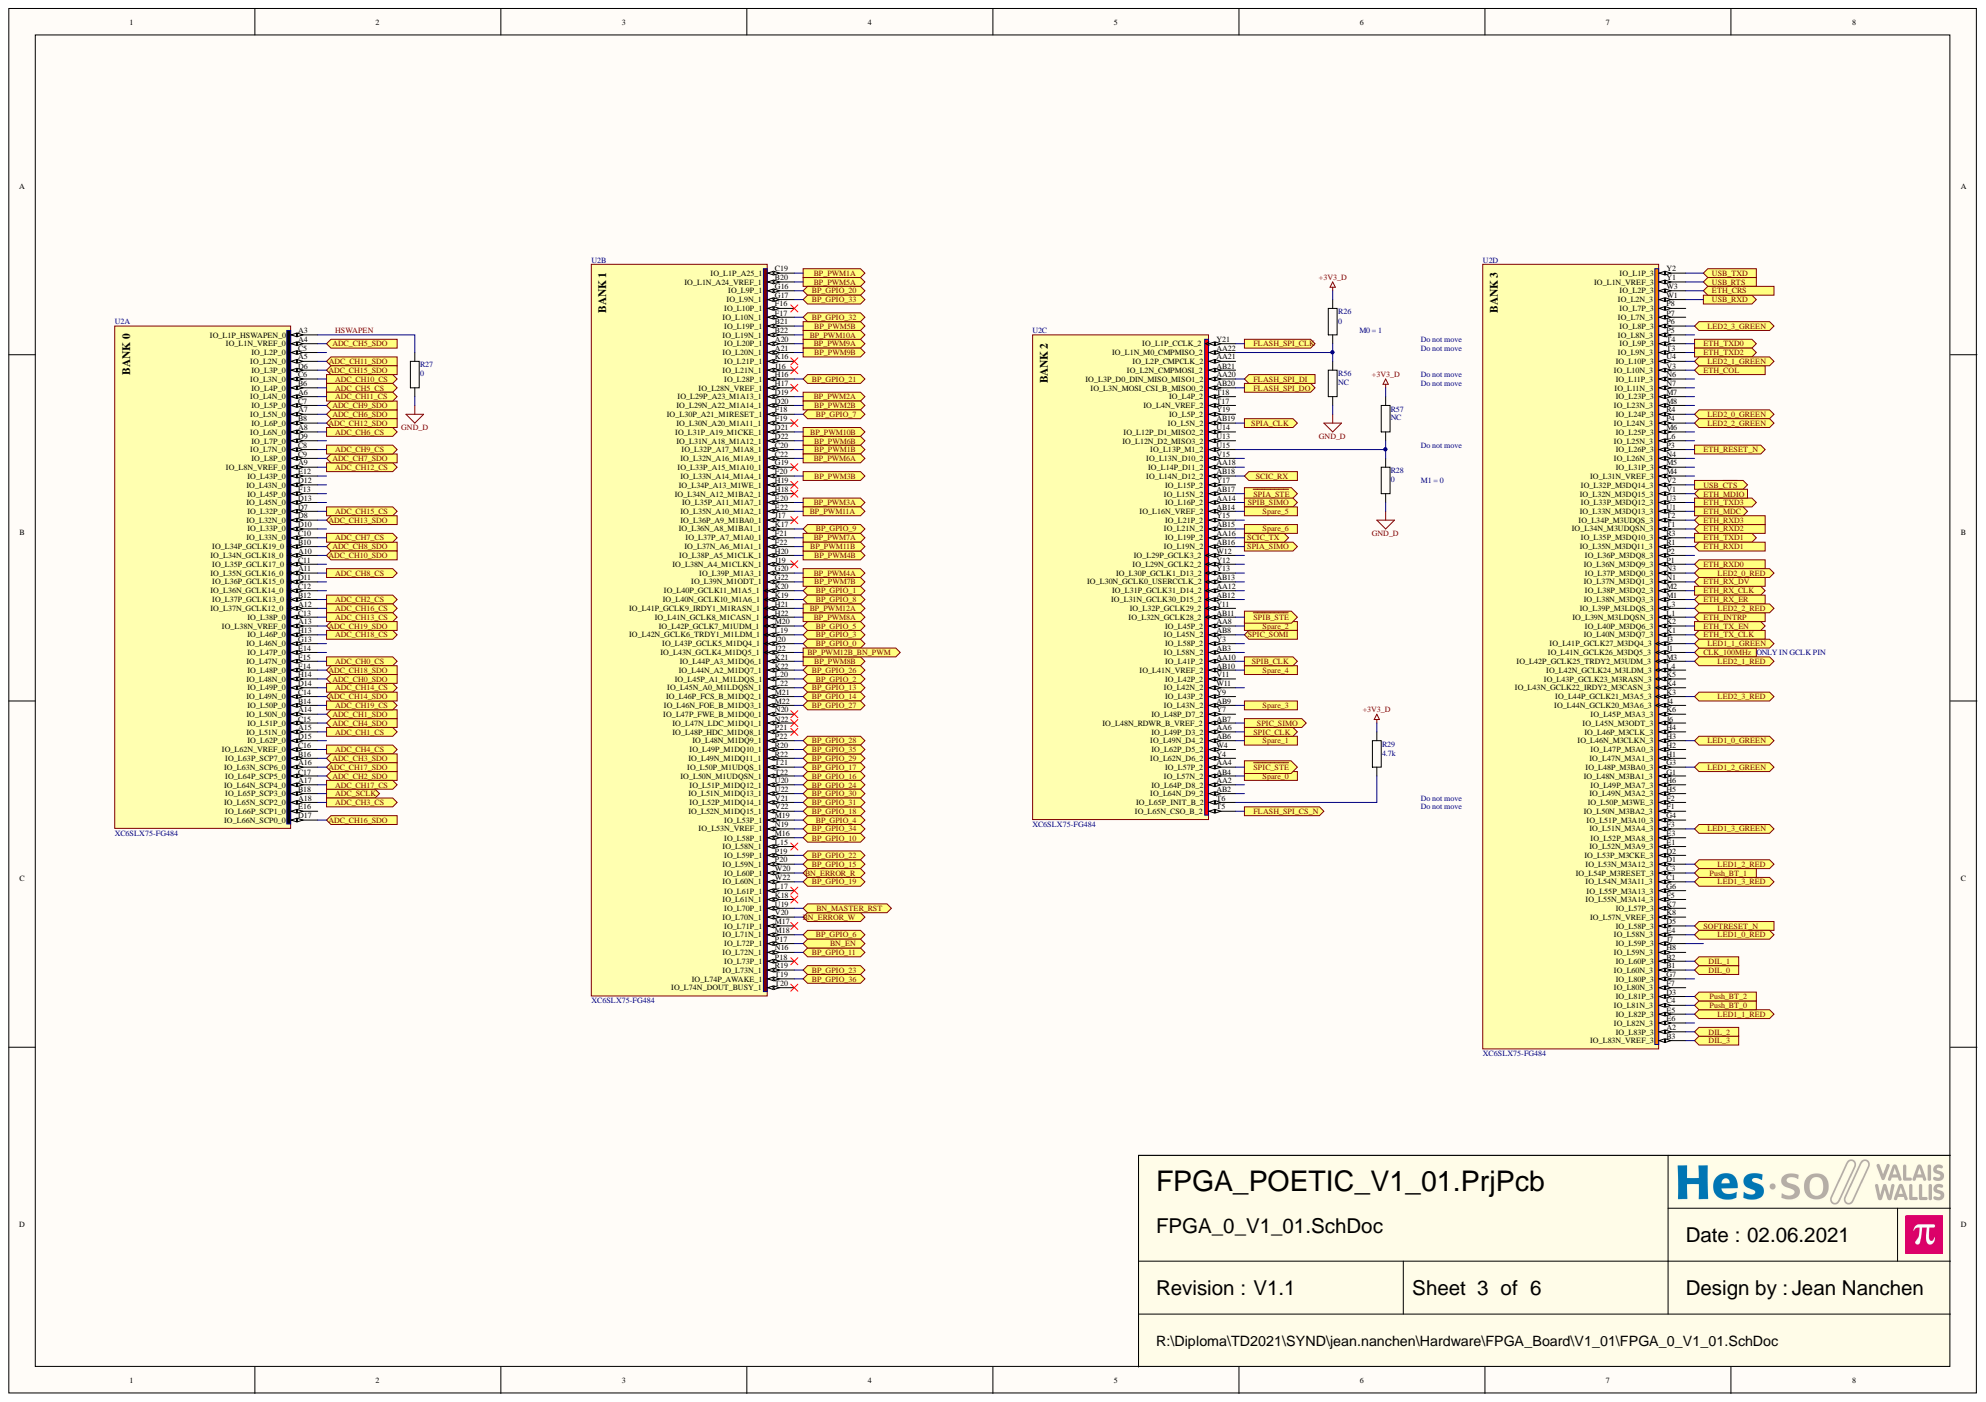
[picture p122: page 3]

FPGA_POETIC_V1_01.PrjPcb FPGA_0_V1_01.SchDoc

Date : 02.06.2021

Revision : V1.1 | Sheet 3 of 6 | Design by : Jean Nanchen

YND\jean.nanchen\Hardware\F

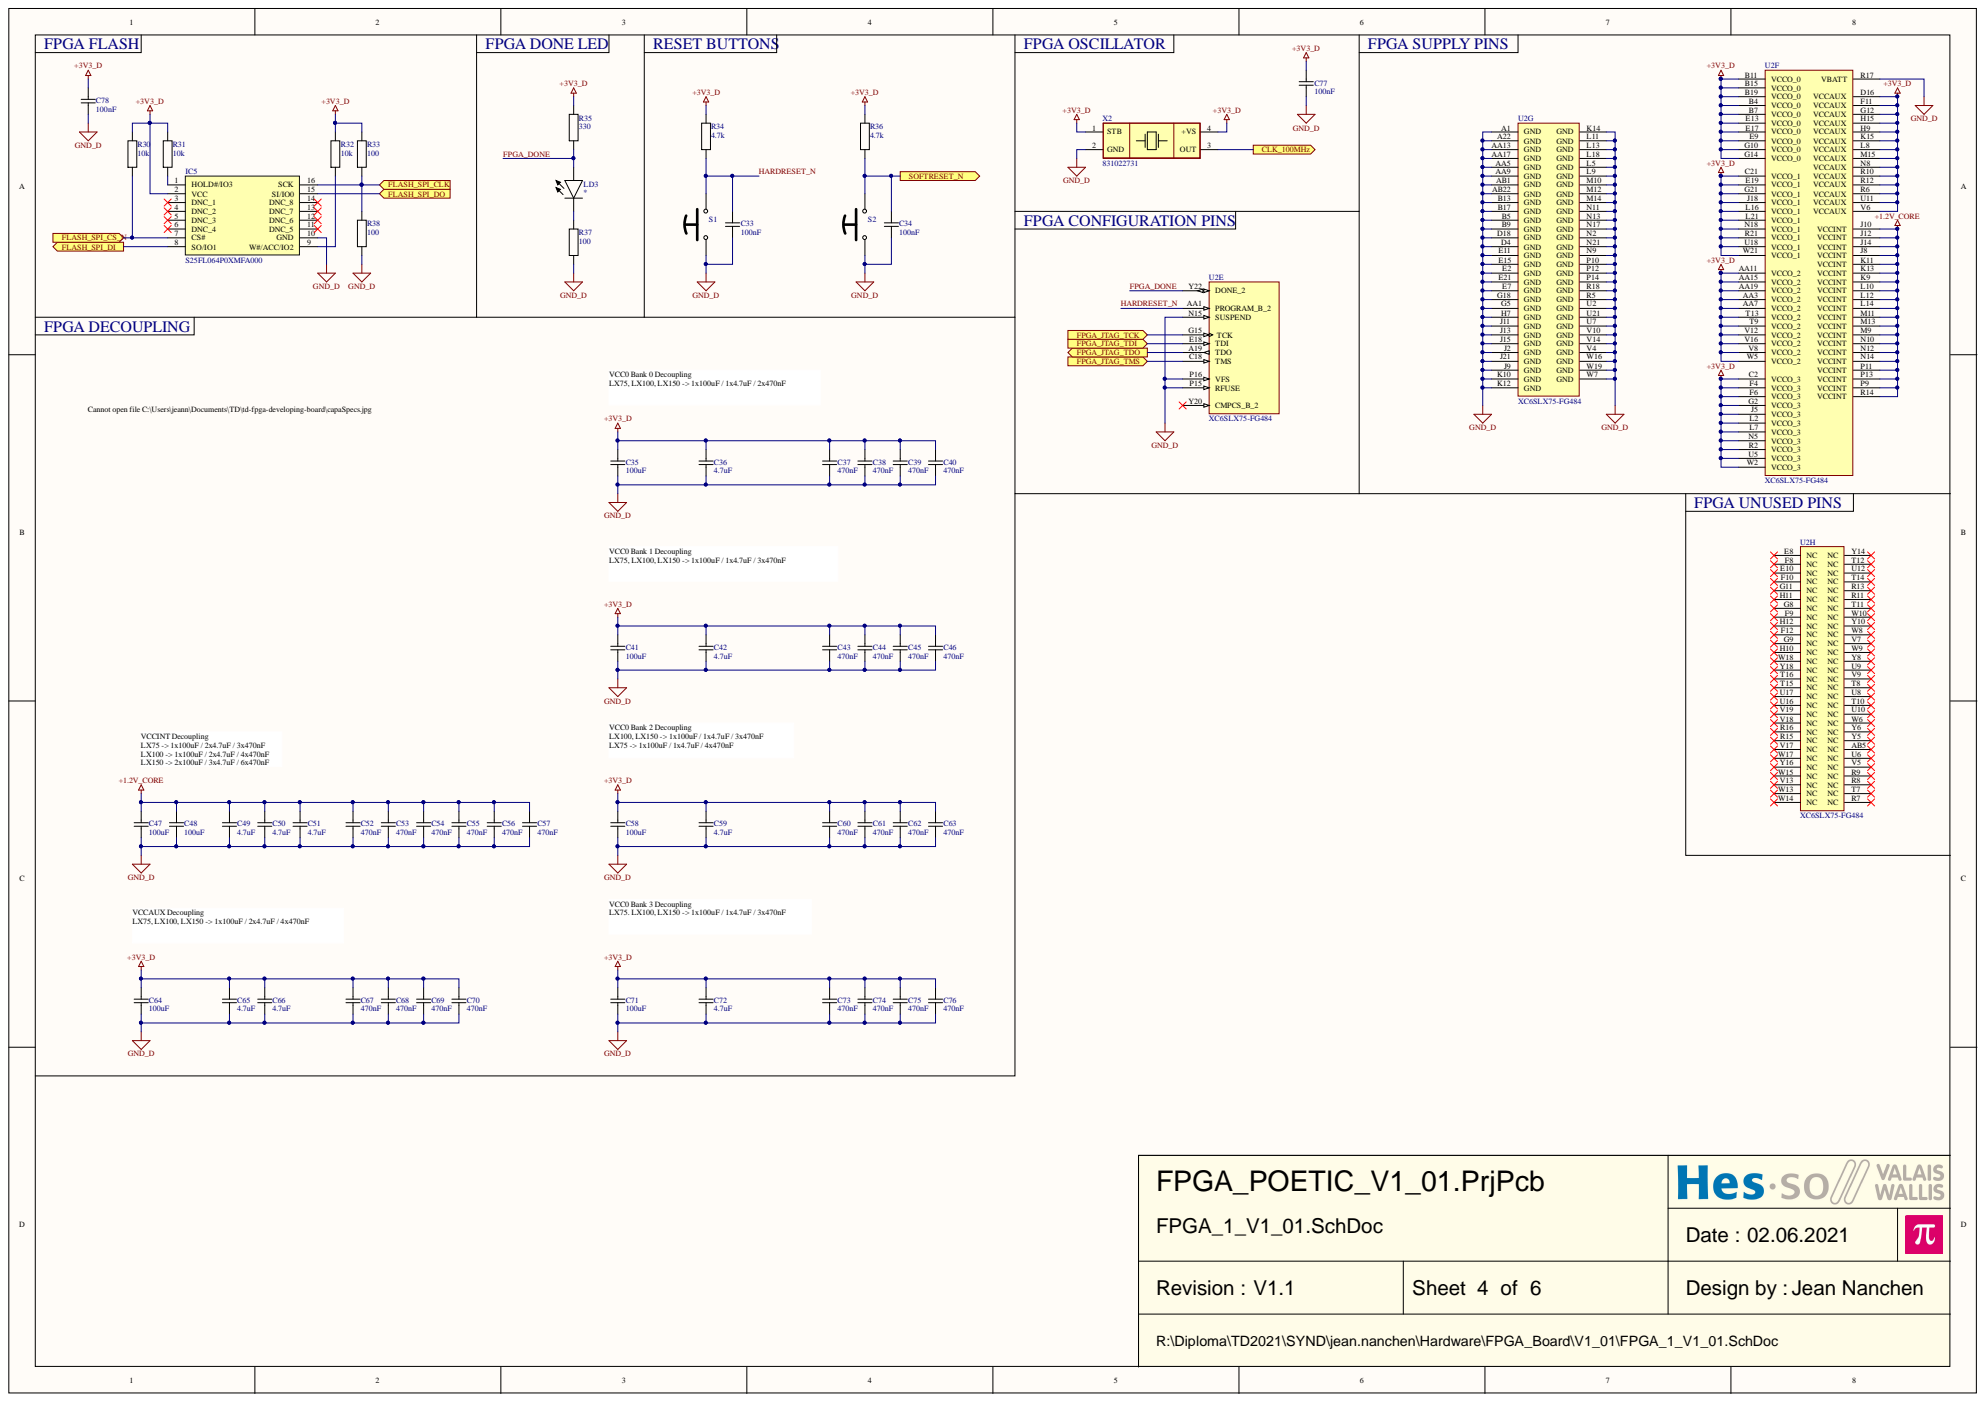
[picture p123: page 4]

FPGA FLASH | FPGA DONE LED | RESET BUTTONS | FPGA OSCILLATOR | C77 100nF +3V3_D | FPGA SUPPLY PINS

C78 100nF | LD3 * | | +3V3_D X2 GND_D SOFTRESET_N

Cannot open file C:\Users\jeann\Documents\TD\td-fpga-developing-board\capaSpecs.jpg

FPGA_POETIC_V1_01.PrjPcb FPGA_1_V1_01.SchDoc

Date : 02.06.2021

Revision : V1.1 | Sheet 4 of 6 | Design by : Jean Nanchen

R:\Diploma\TD2021\SYND\jean.nanchen\Hardware\FPGA_Board\V1_01\FPGA_1_V1_01.SchDoc

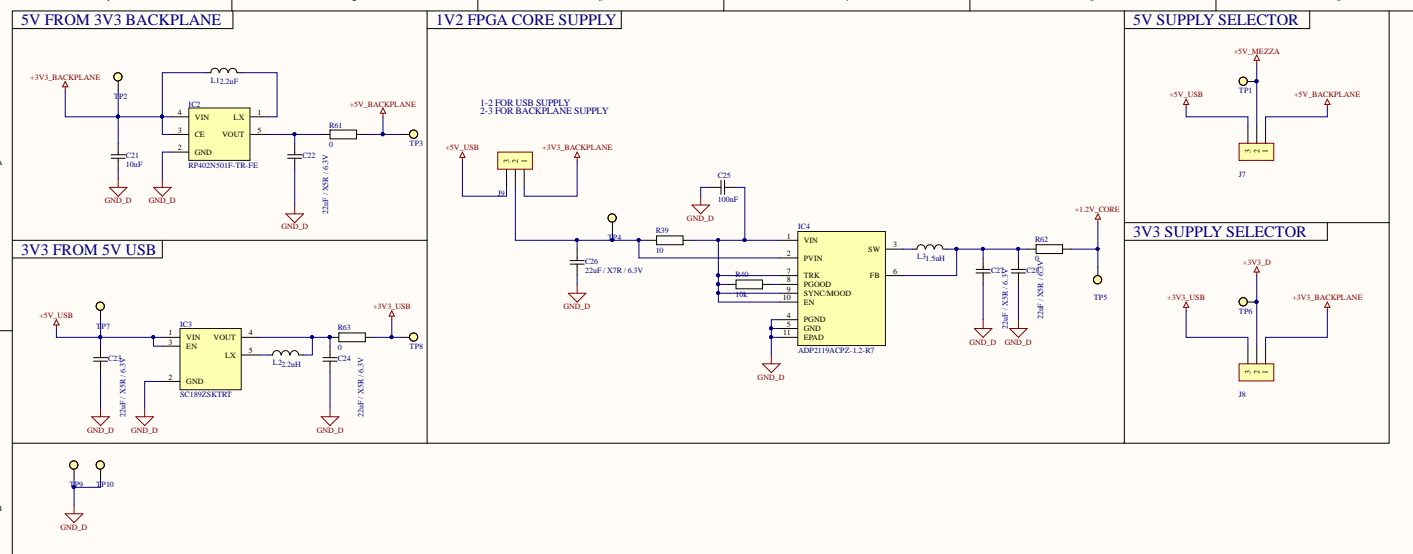
[picture p124: page 5]

5V F ROM 3V3 BACKPLANE | | 1V2 F PGA CORE SUP P LY | 5V SUP P LY SELECTOR

1 -2 F O R U S B S U P PLY 2 -3 F O R B A C KPL A N E S U P PLY +5V_US B +3V3_BACKP LANE | +5V_M | E Z Z A

3 | C E GND

FPGA_POETIC_V1_01.PrjPcb Supply_0_V1_01.SchDoc

Date : 02.06.2021

Revision : V1.1 | Sheet 5 of 6 | Design by : Jean Nanchen

YND\jean.nanchen\Hardware\F

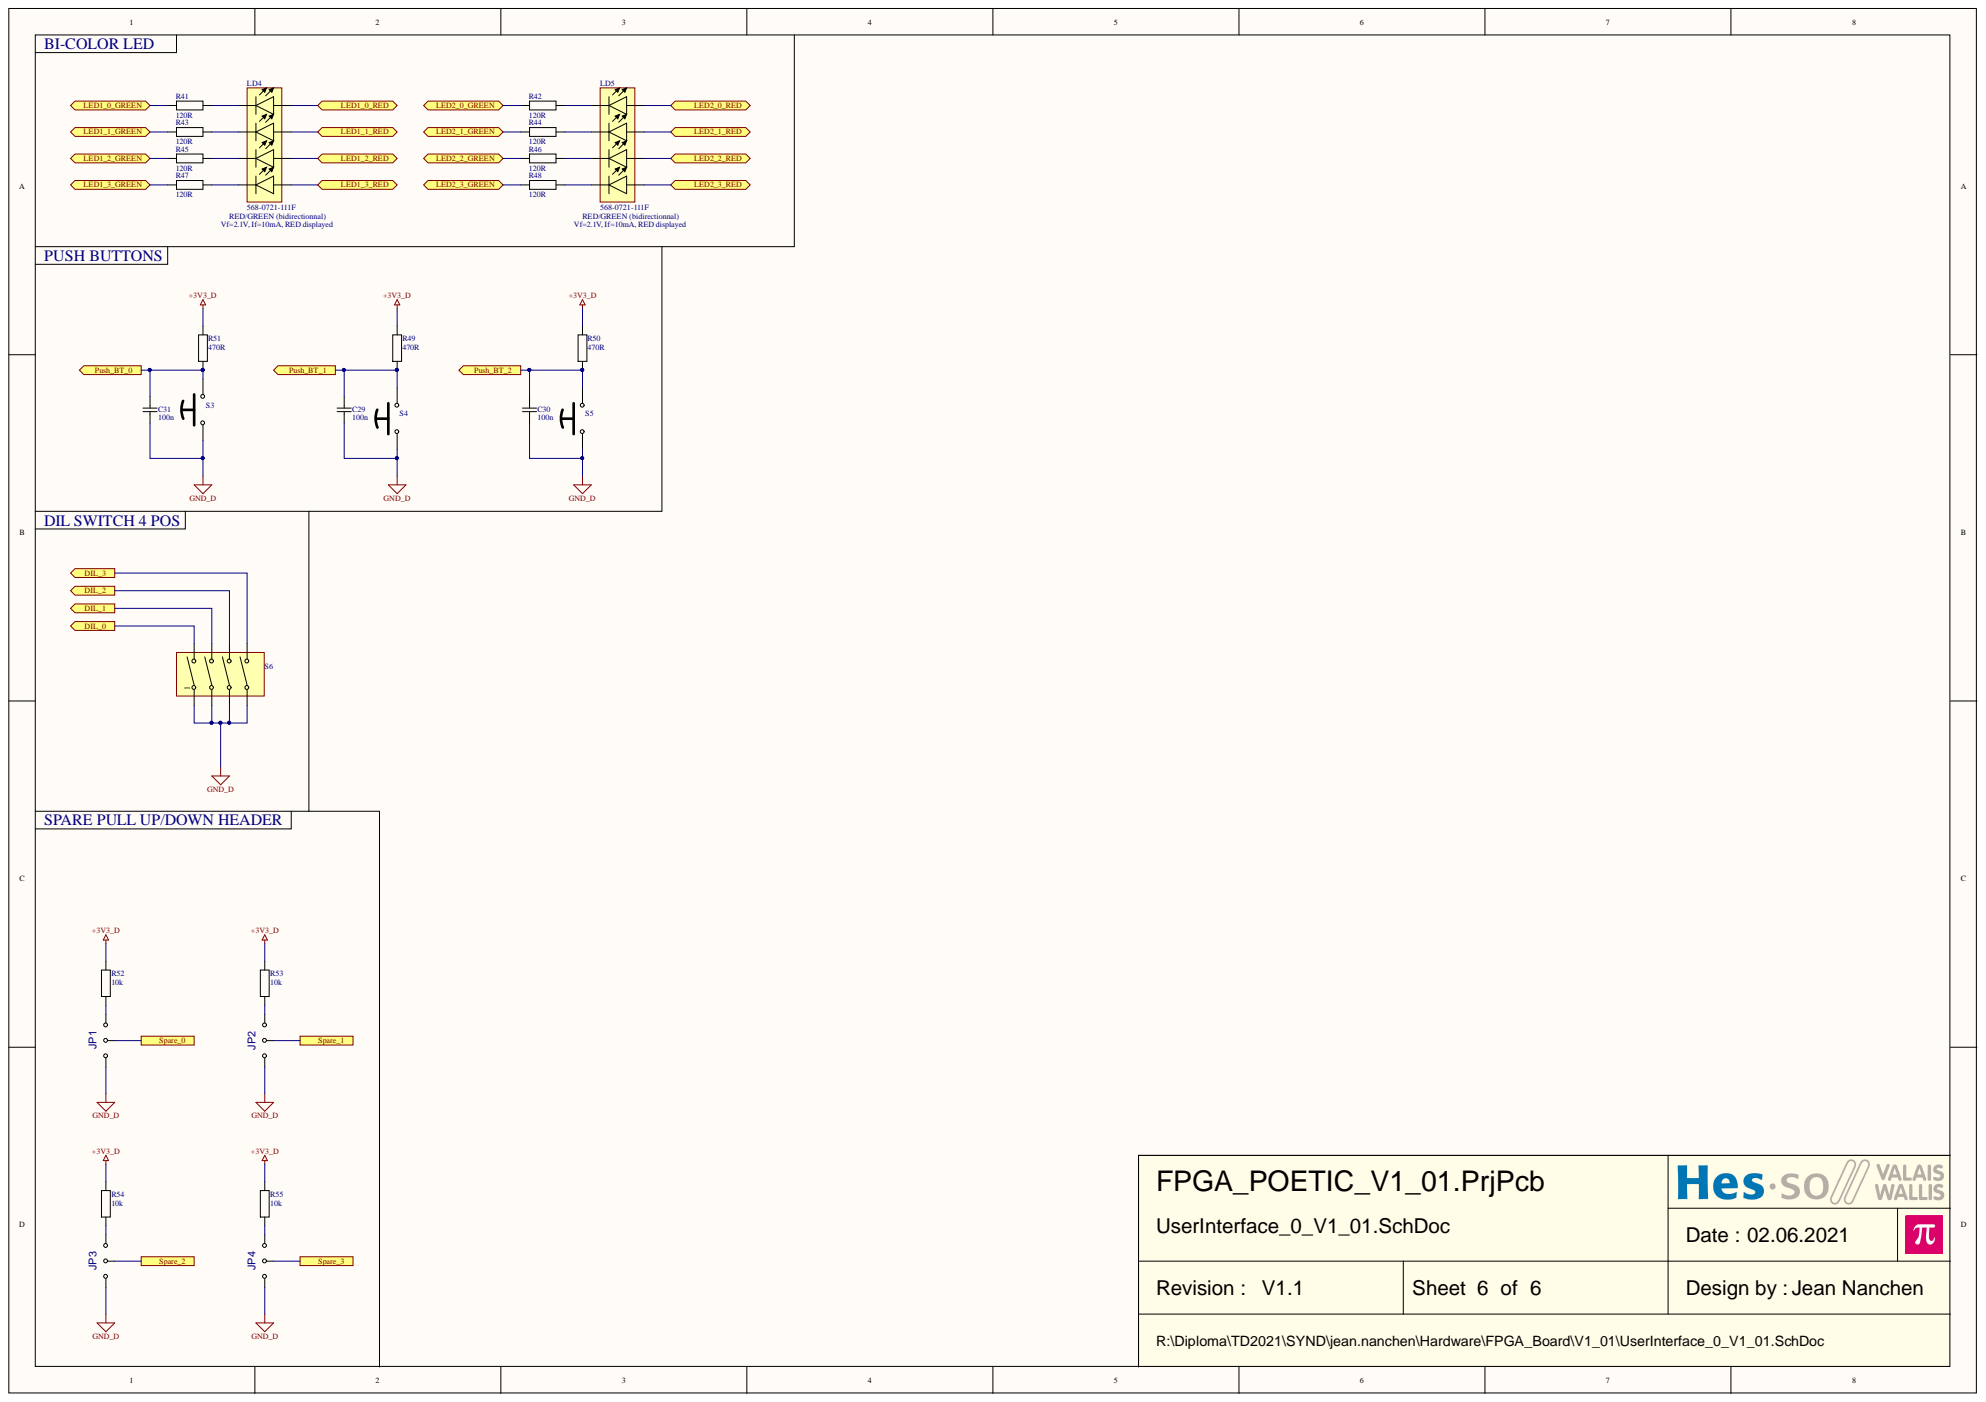
[picture p125: page 6]

RED/GREEN (bidirectionnal)
Vf=2.1V, If=10mA, RED displayed

SPARE PULL UP/DOWN HEADER

FPGA_POETIC_V1_01.PrjPcb UserInterface_0_V1_01.SchDoc

Date : 02.06.2021

Revision : V1.1 | Sheet 6 of 6 | Design by : Jean Nanchen

R:\Diploma\TD2021\SYND\jean.nanchen\Hardware\FPGA_Board\V1_01\UserInterface_0_V1_01.SchDoc

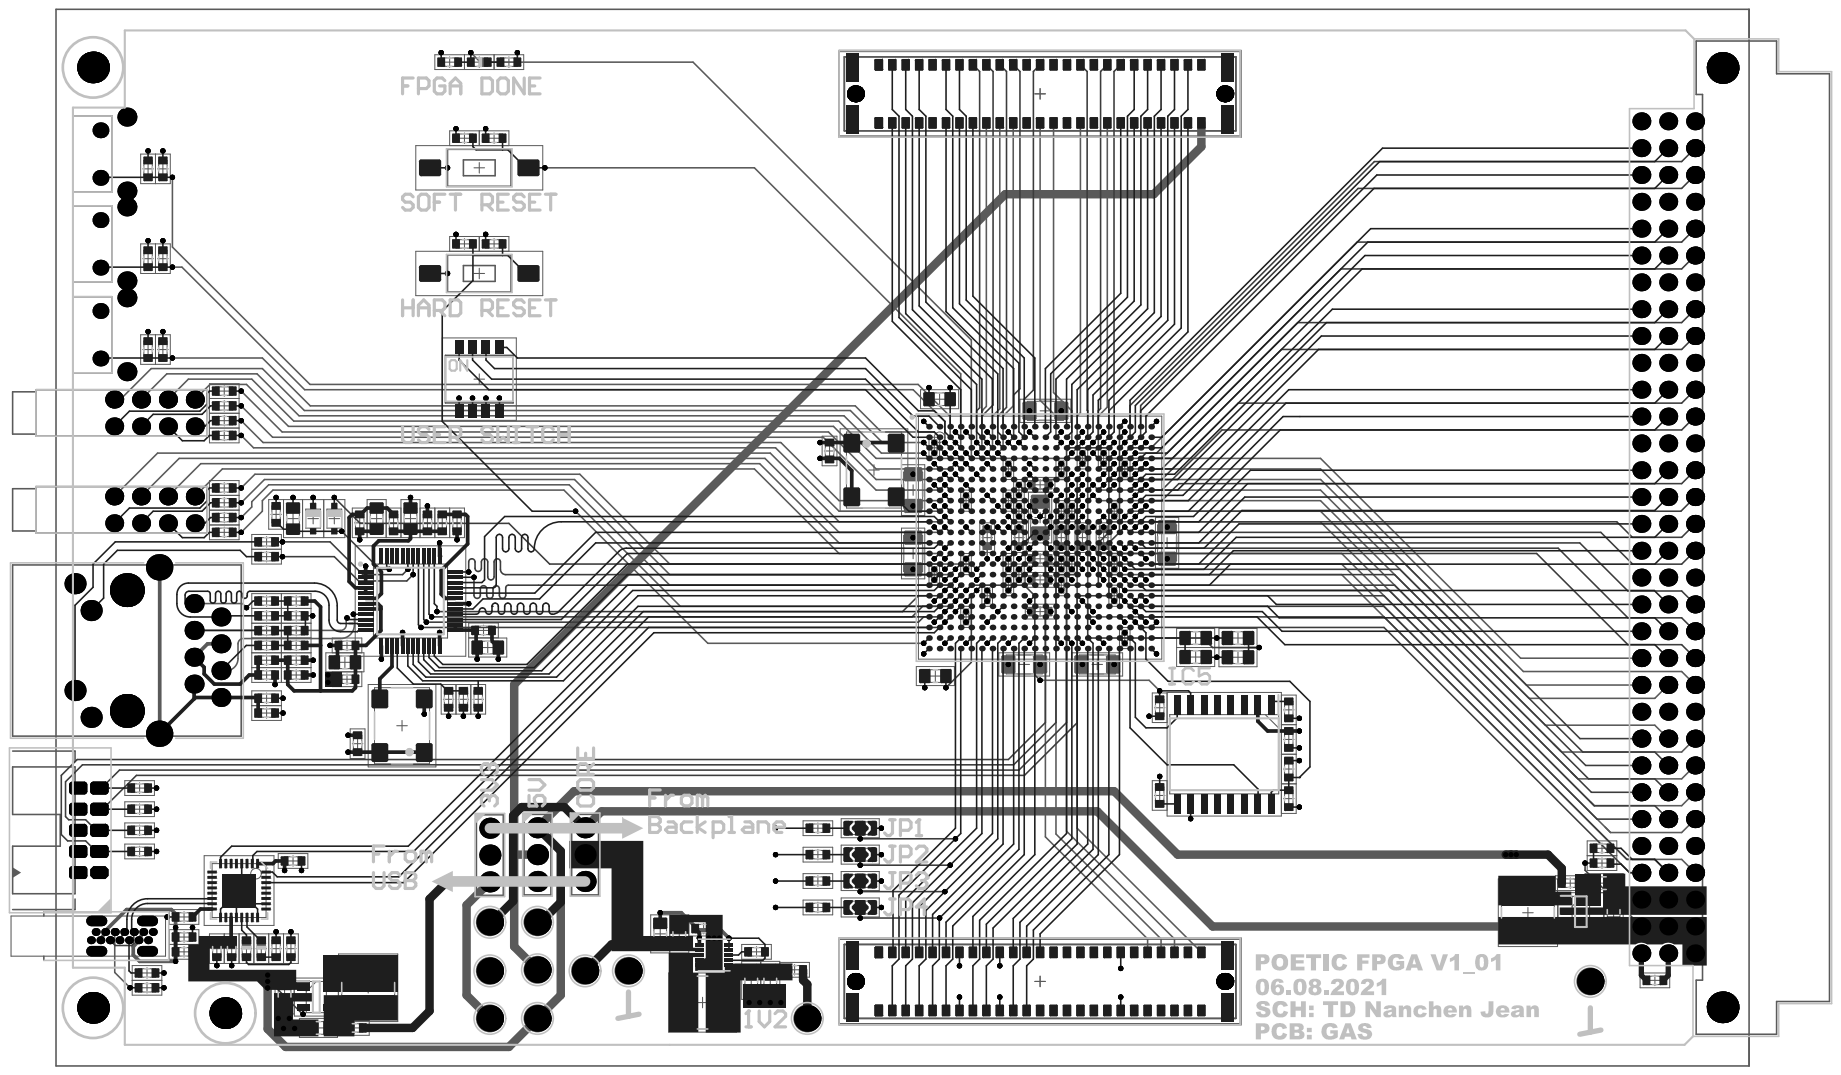
[picture p126: page 7]
