73jn/td-fpga-developing-board/FPGA-POETIC/Mezzanine_Board/ANAlOG_MEZZANINE.pdf

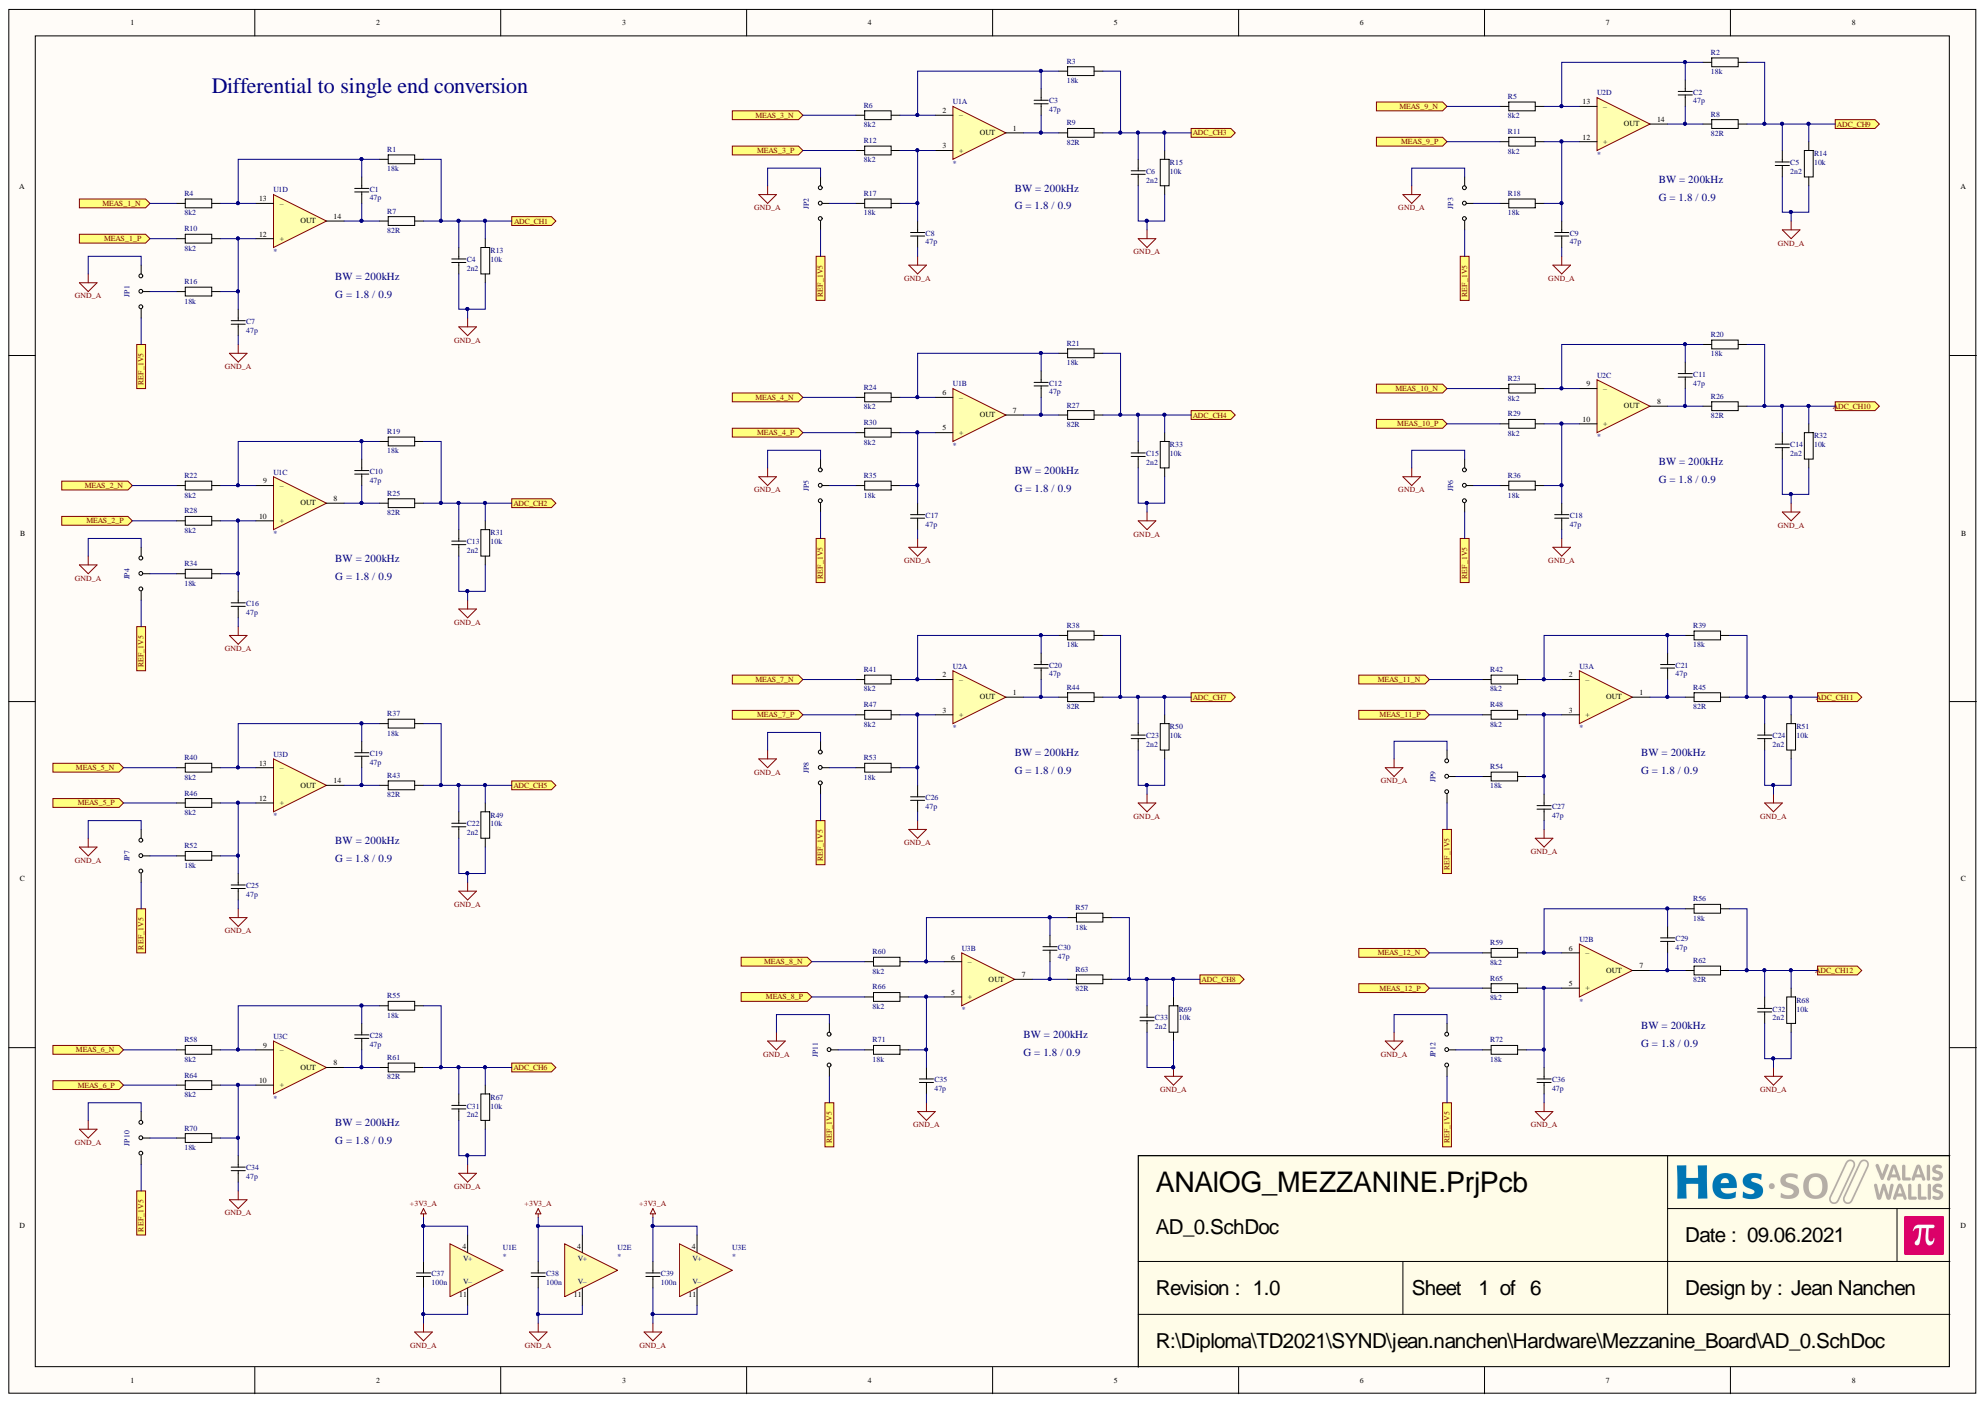
[picture p127: page 1]

ANAl O G _ MEZZANINE.PrjPcb A D _ 0.Sch D o c

D ate : 0 9.0 6.2 0 2 1

R ev isi o n : 1.0 | S h e et 1 of 6 | D esi g n b y : Je a n N a nch e n

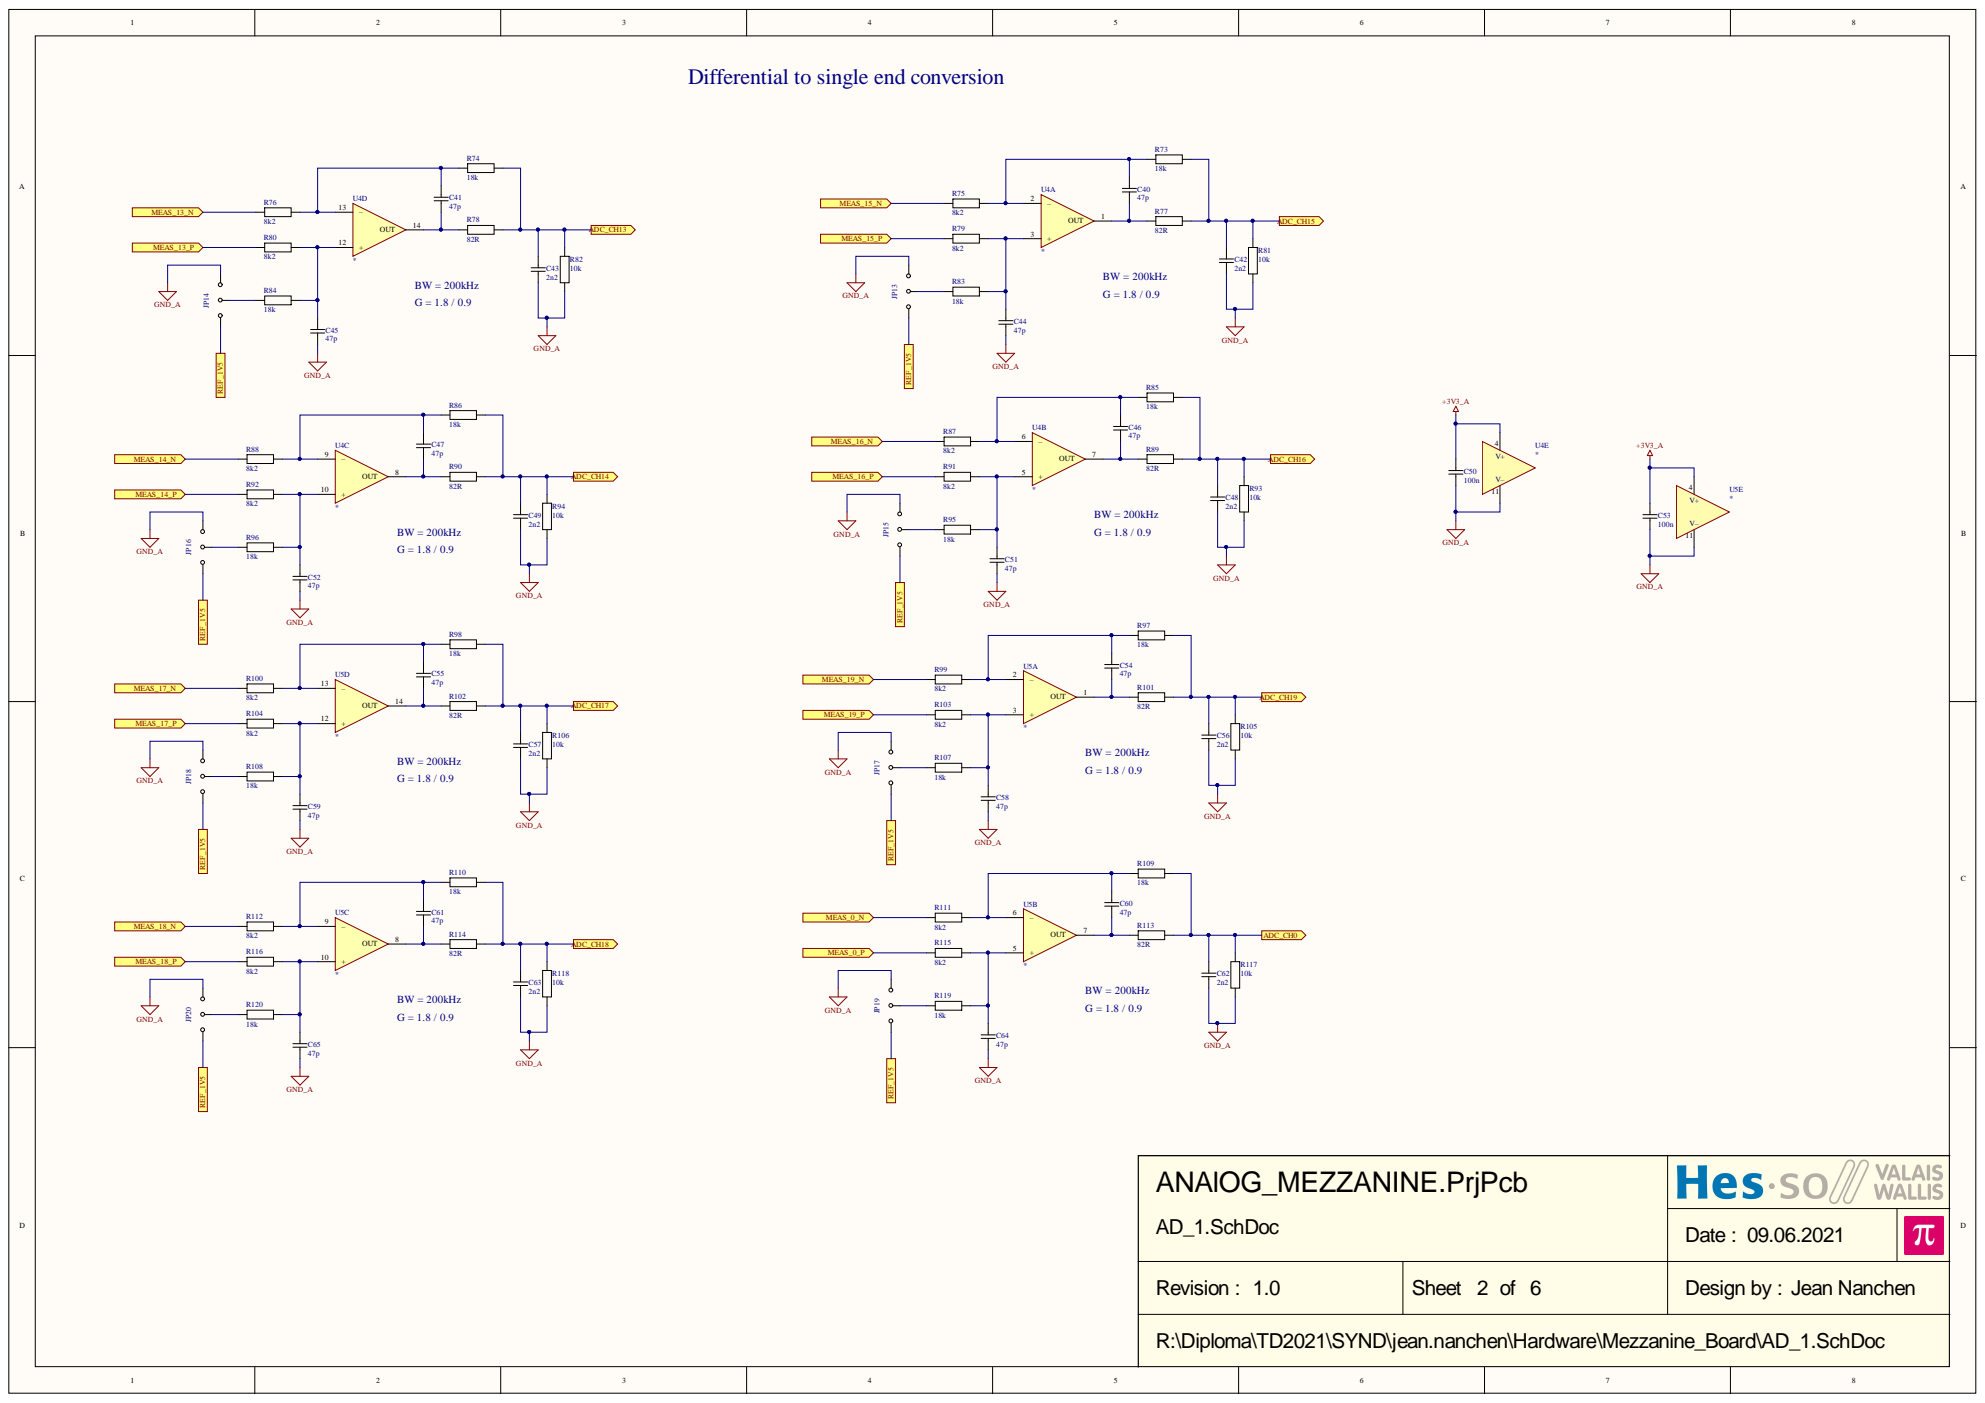
[picture p128: page 2]

ANAl O G _ MEZZANINE.PrjPcb A D _ 1.Sch D o c

D ate : 0 9.0 6.2 0 2 1

R ev isi o n : 1.0 | S h e et 2 of 6 | D esi g n b y : Je a n N a nch e n

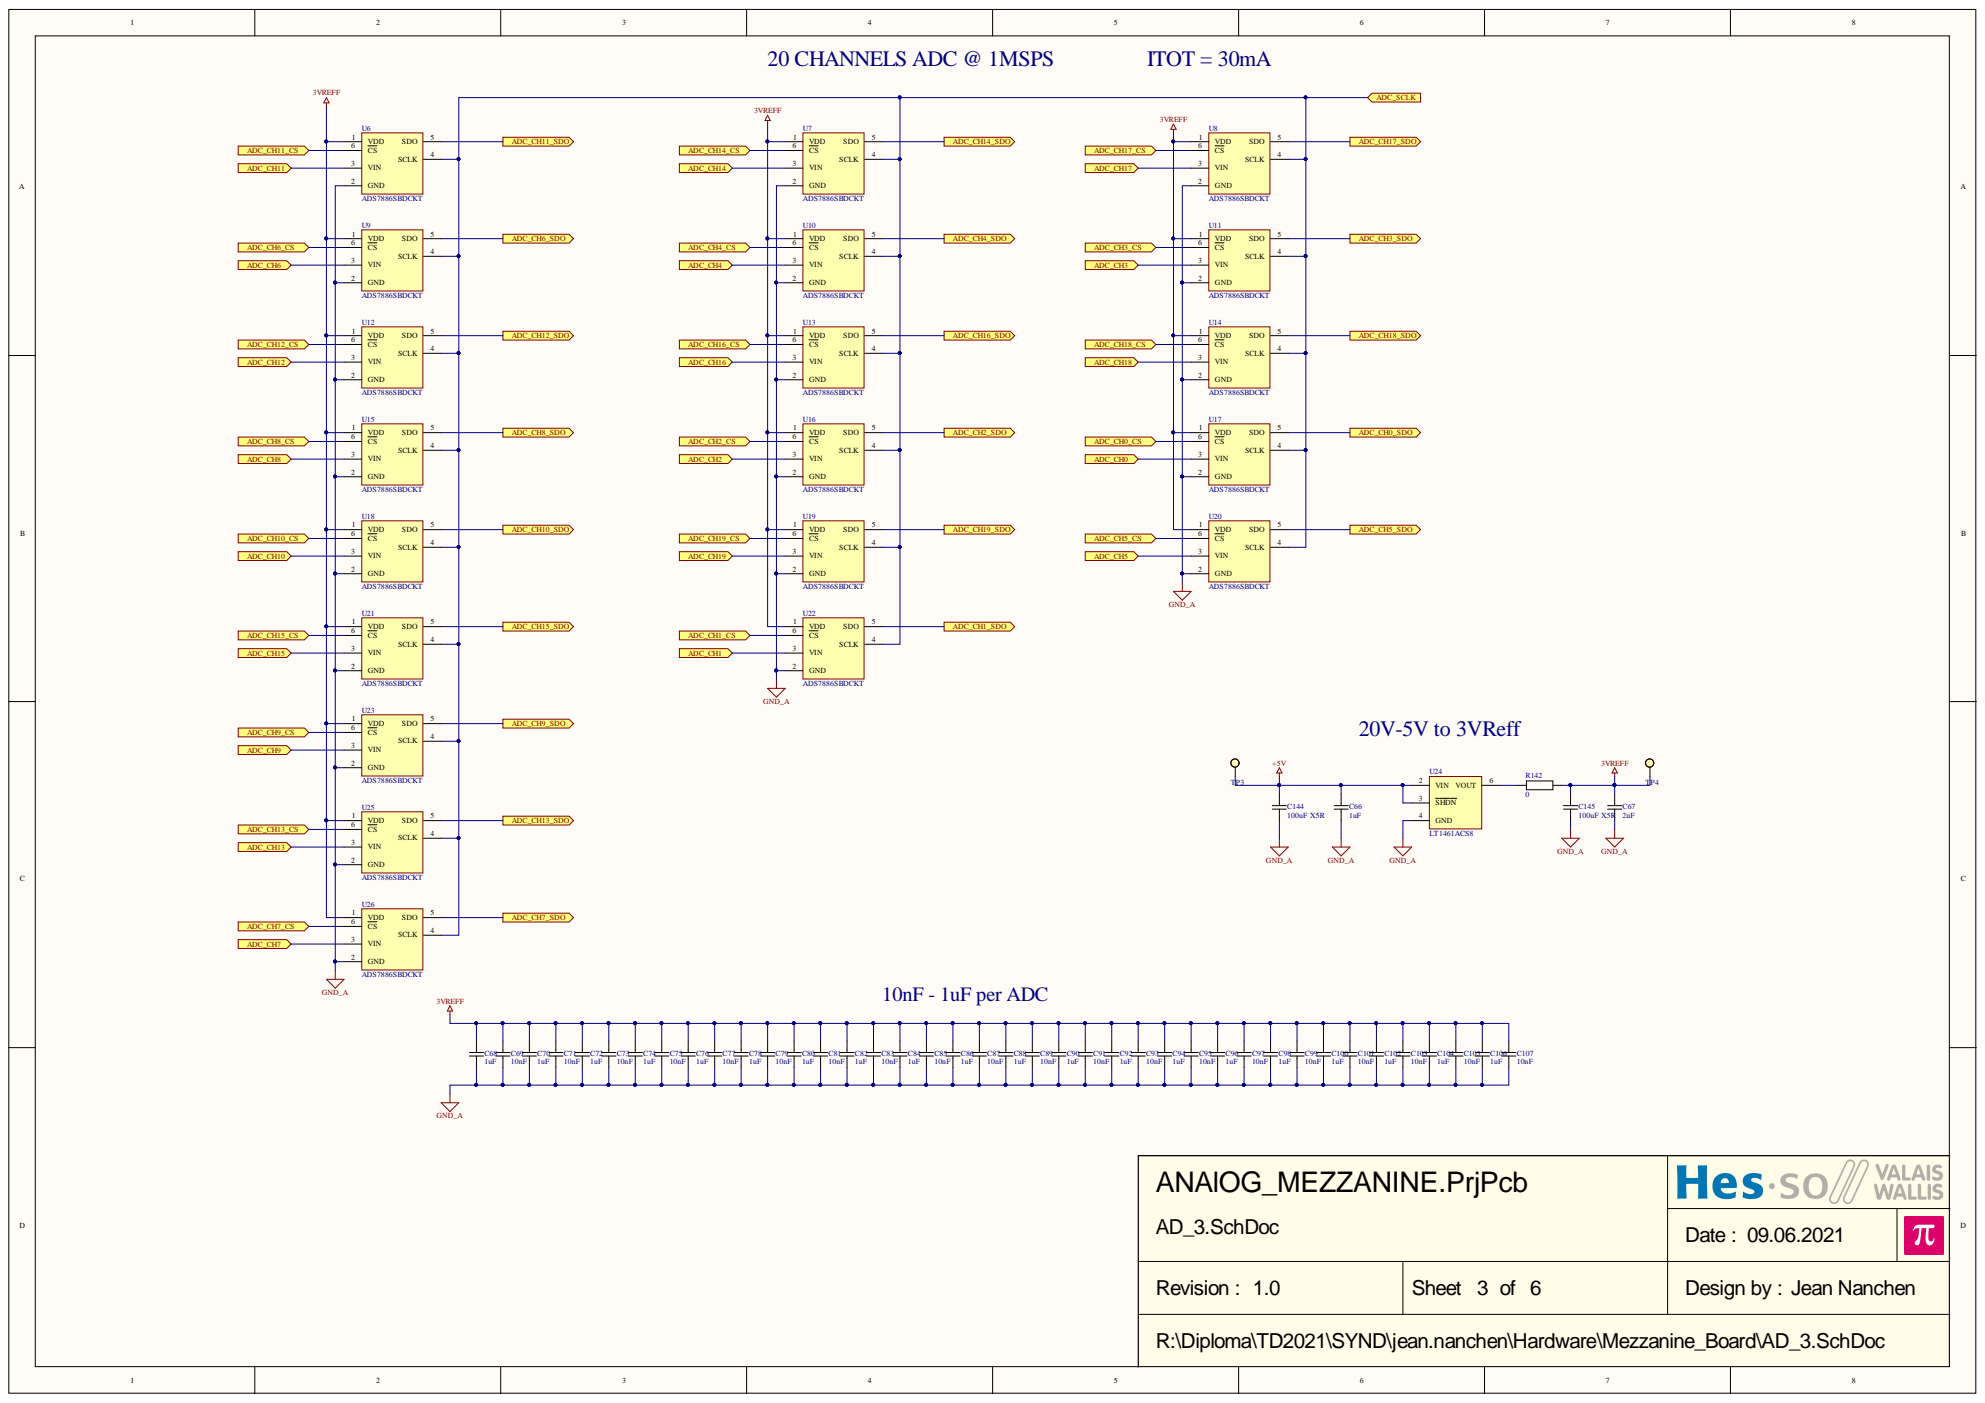
[picture p129: page 3]

VIN 3 GND 2

VIN 3 GND 2 | VIN 3

GND 2

ANAlOG_MEZZANINE.PrjPcb AD_3.SchDoc

Date : 09.06.2021

Revision : 1.0 | Sheet 3 of 6 | Design by : Jean Nanchen

R:\Diploma\TD2021\SYND\jean.nanchen\Hardware\Mezzanine_Board\AD_3.SchDoc

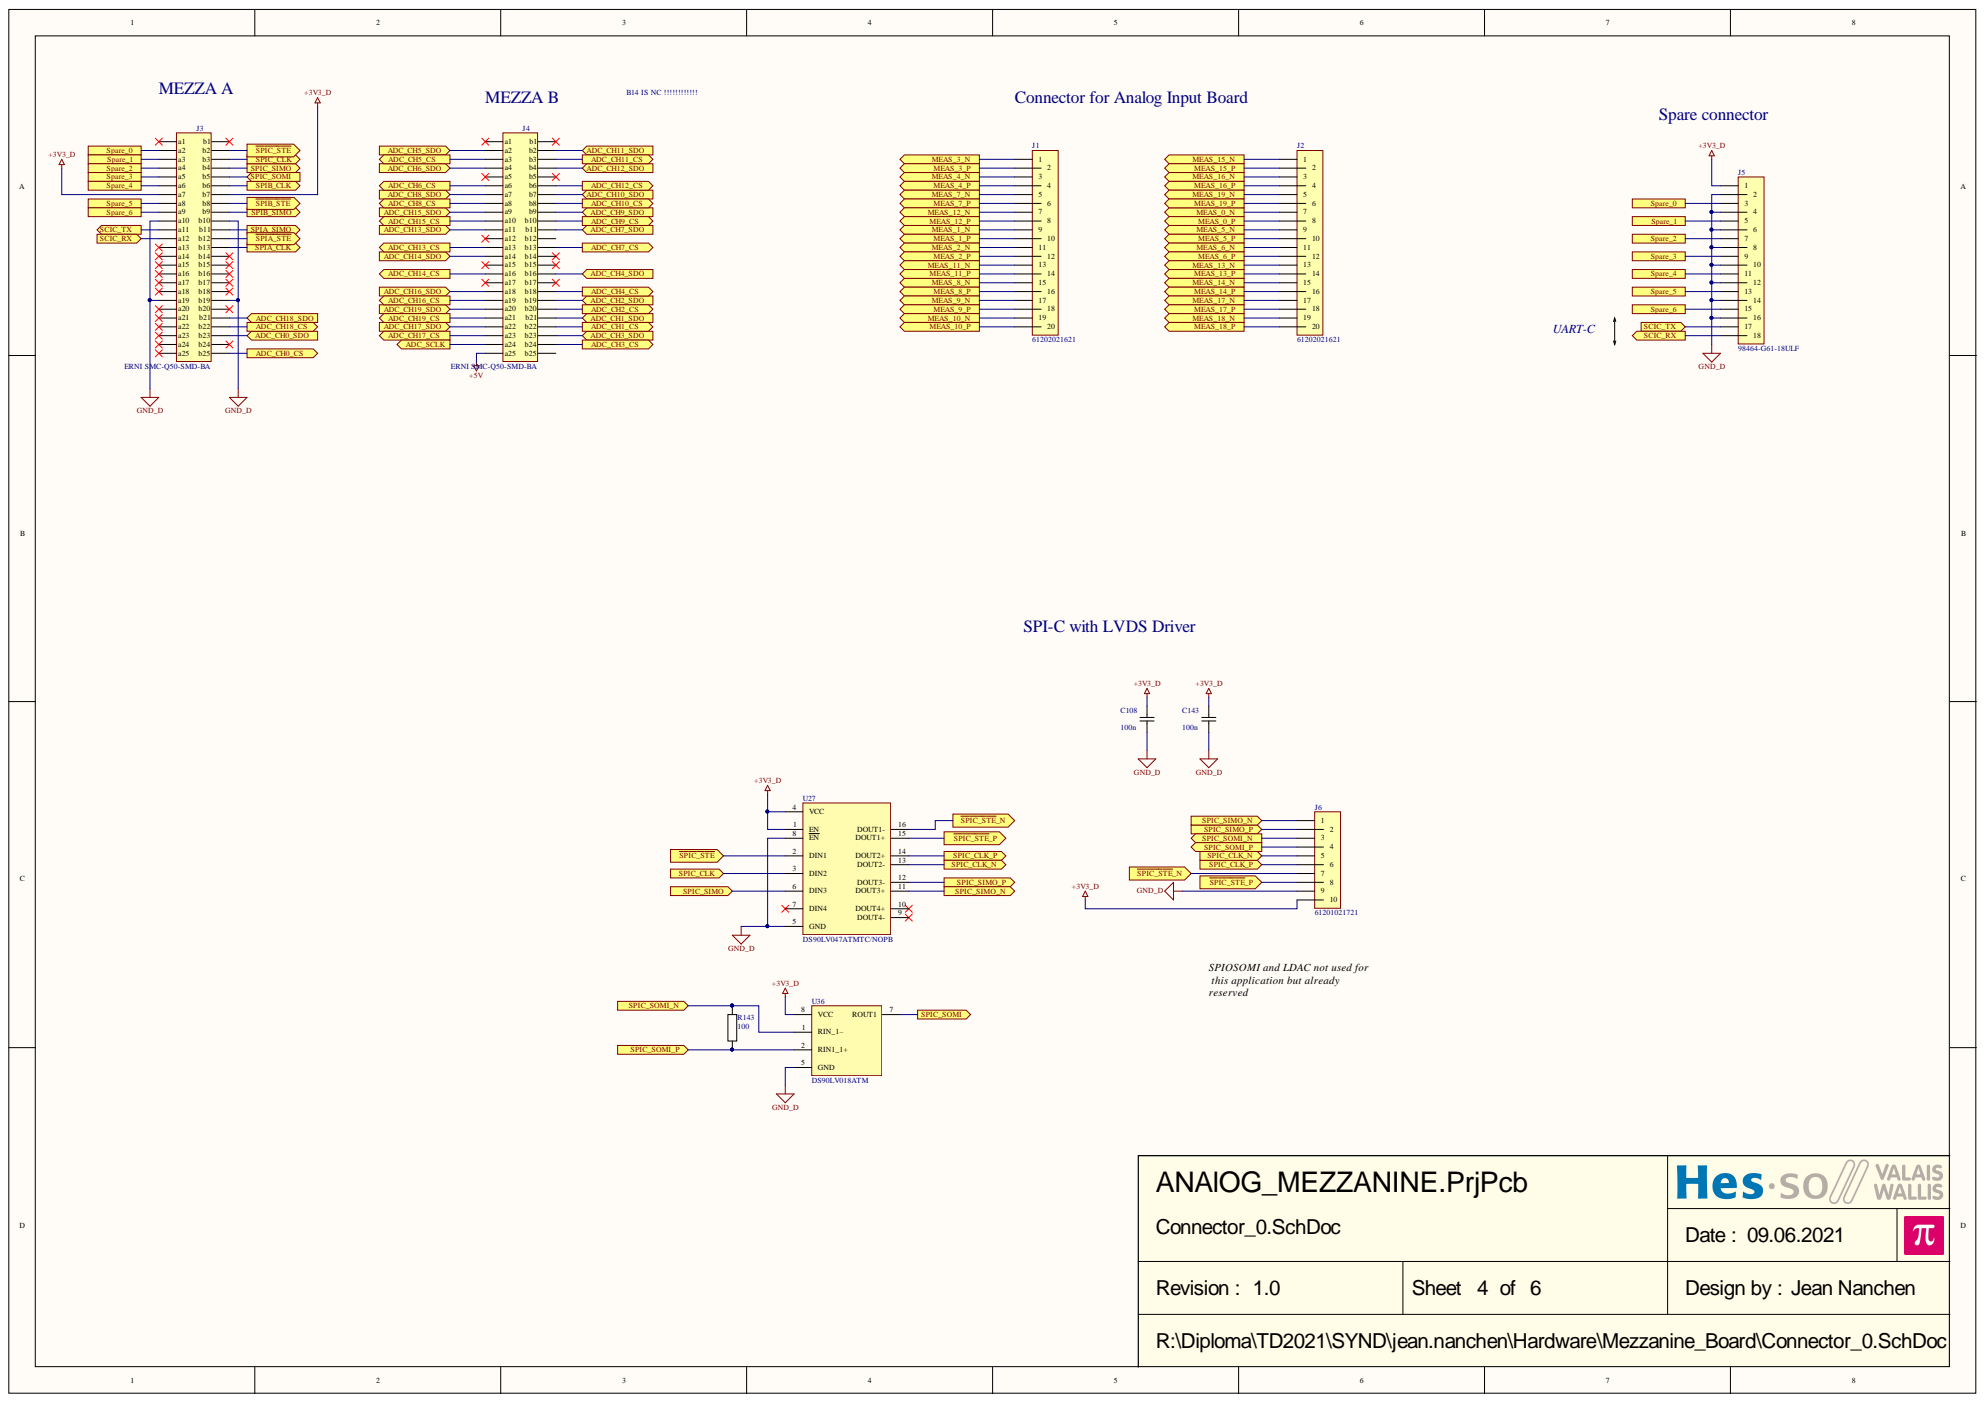
[picture p130: page 4]

Connector for Analog Input Board

ERNI SMC-Q50-SMD-BA

SPI-C with LVDS Driver

DIN2 3

DIN3 6

SPIOSOMI and LDAC not used for
this application but already
reserved

ANAlOG_MEZZANINE.PrjPcb Connector_0.SchDoc

Date : 09.06.2021

Revision : 1.0 | Sheet 4 of 6 | Design by : Jean Nanchen

R:\Diploma\TD2021\SYND\jean.nanchen\Hardware\Mezzanine_Board\Connector_0.SchDoc

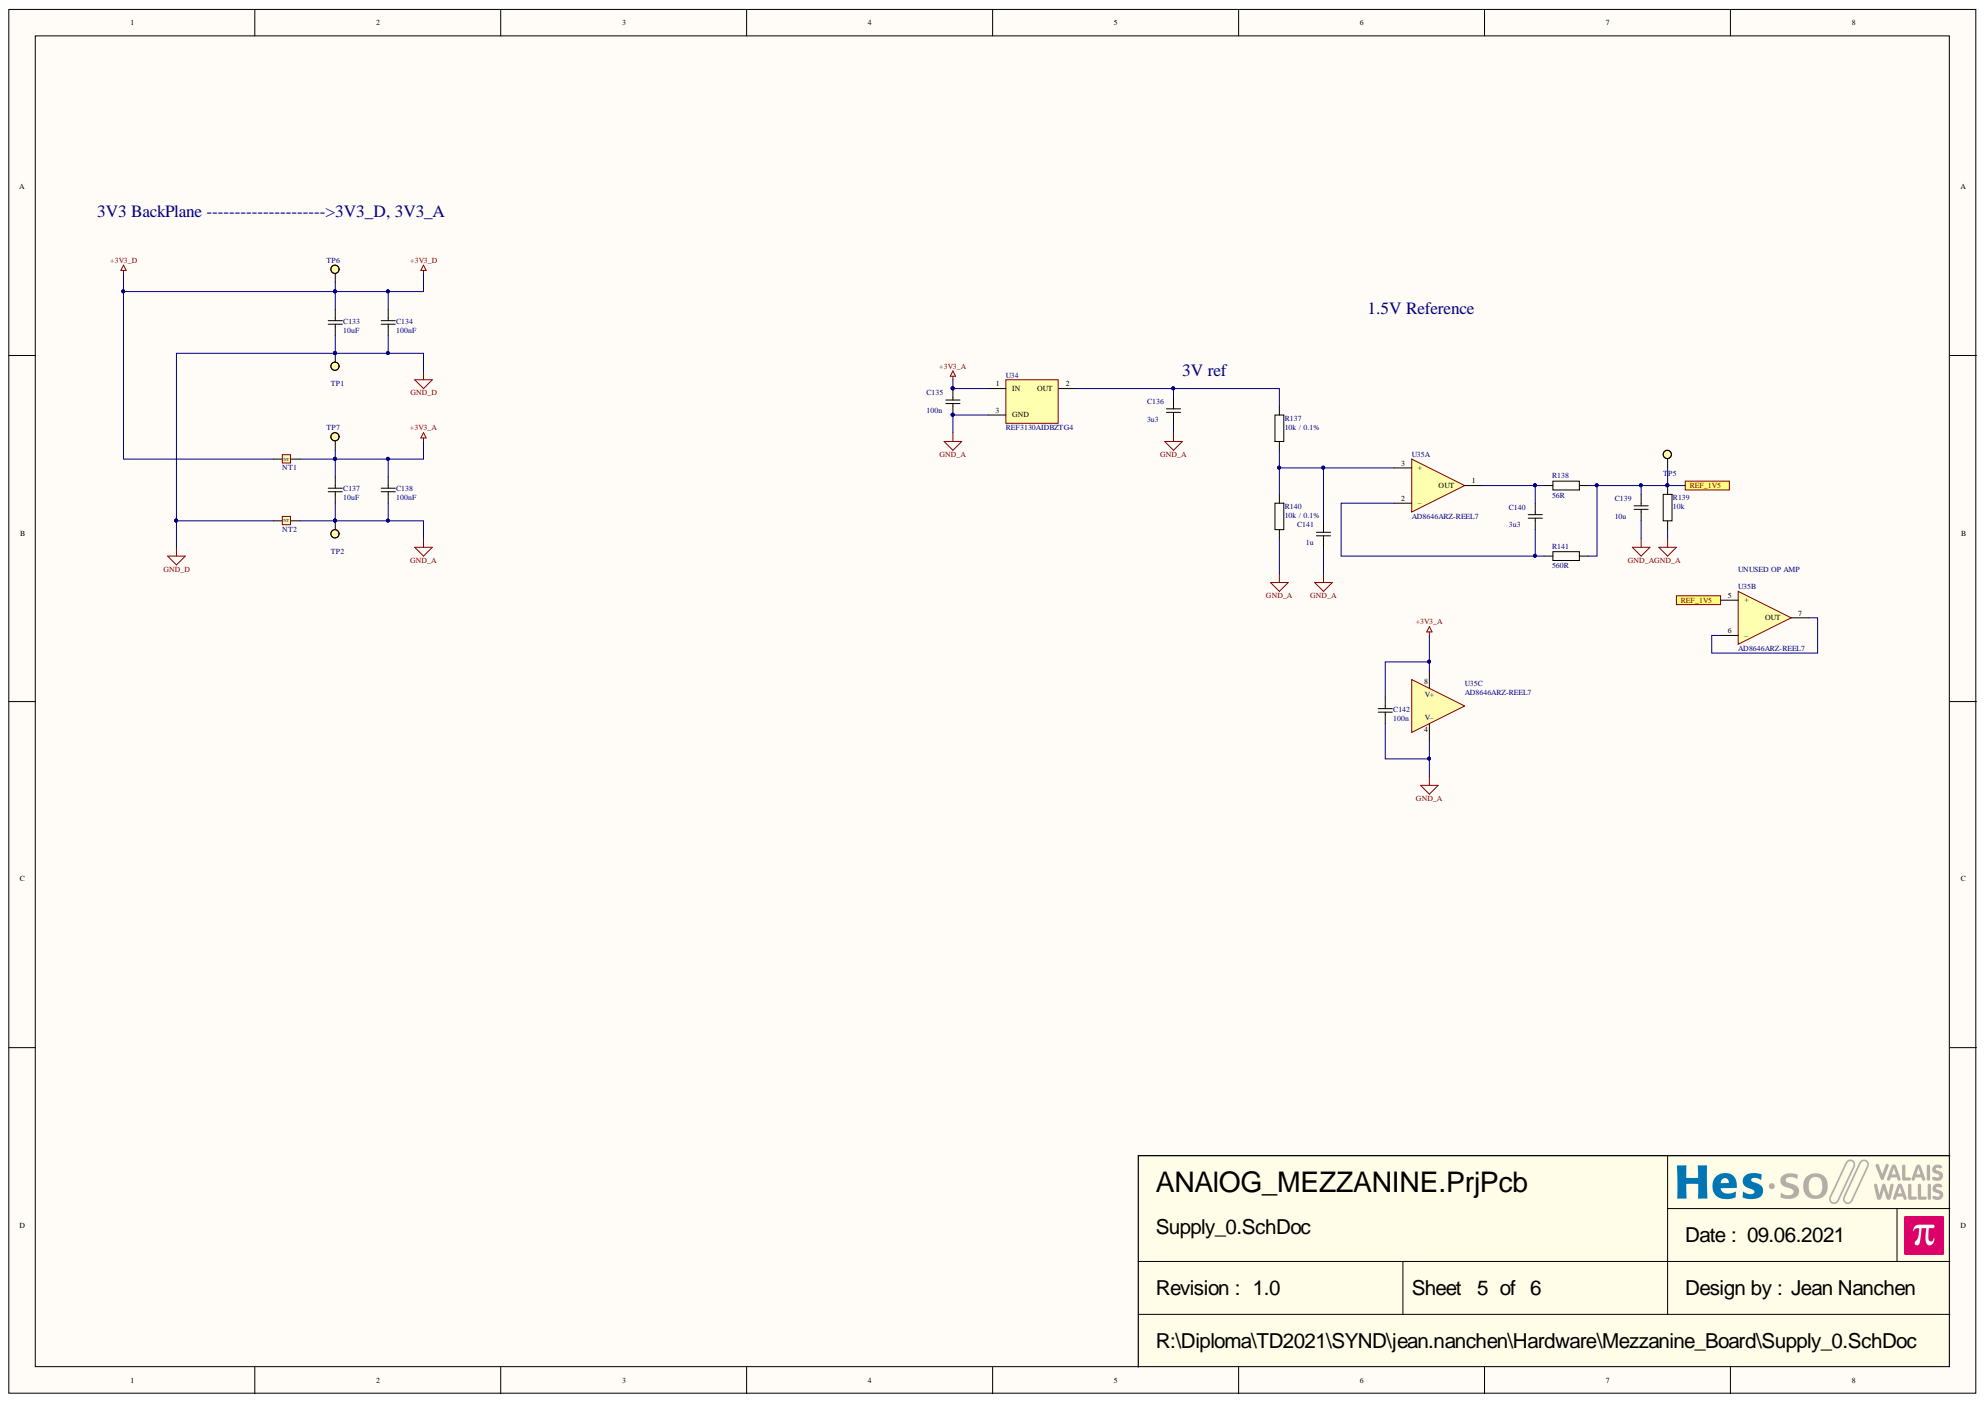
[picture p131: page 5]

ANAl O G _ MEZZANINE.PrjPcb S u p p l y_ 0.Sch D o c

D ate : 0 9.0 6.2 0 2 1

R ev isi o n : 1.0 | S h e et 5 of 6 | D esi g n b y : Je a n N a nch e n

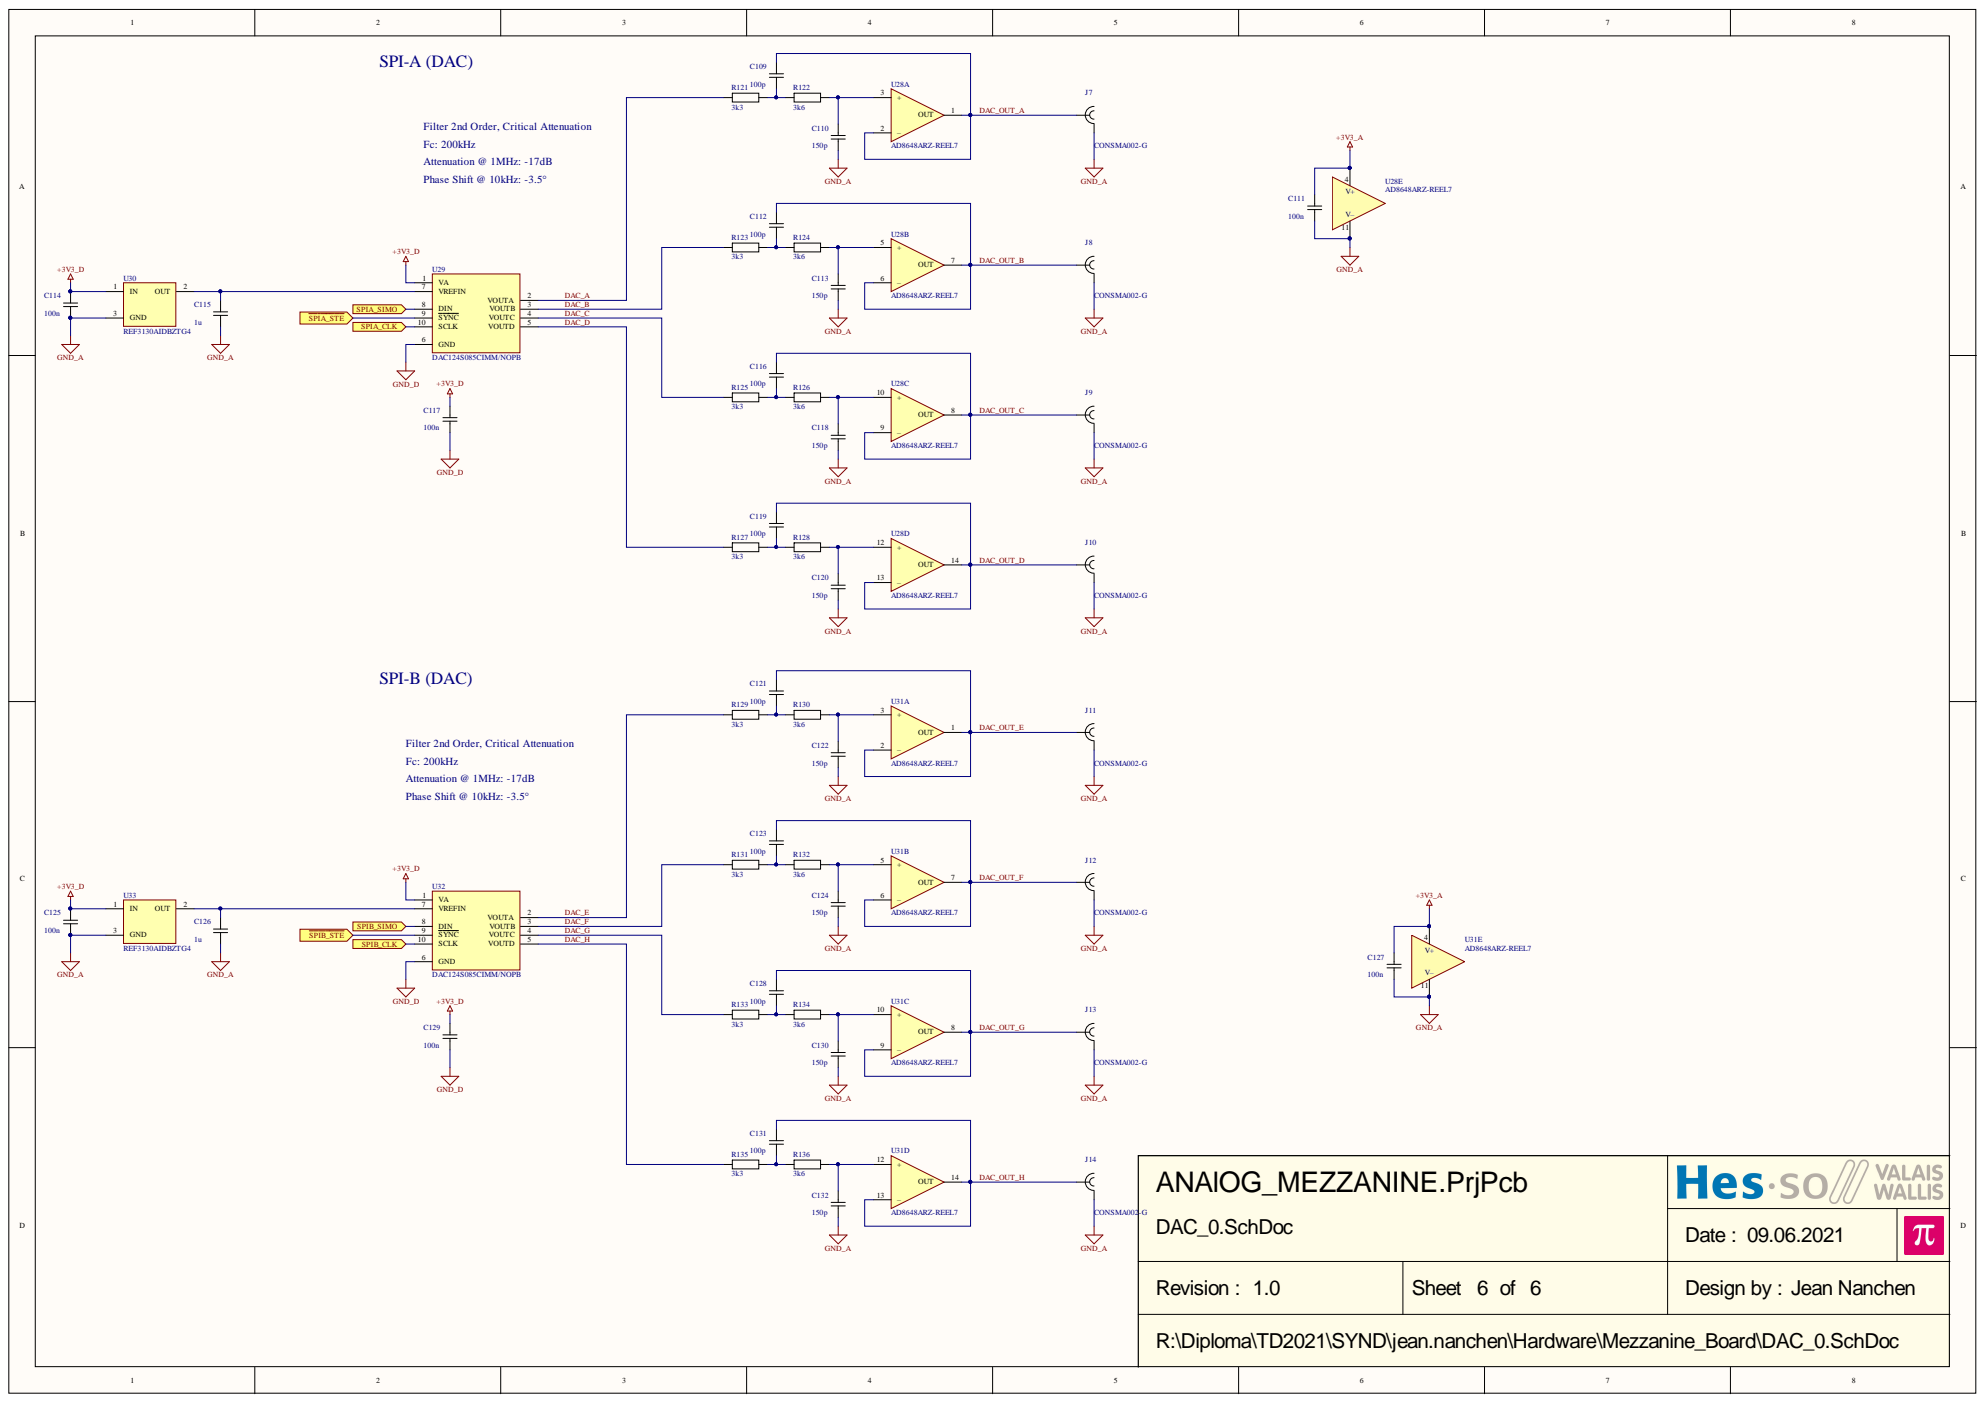
[picture p132: page 6]

ANAl O G _ MEZZANINE.PrjPcb 2 -G D A C _ 0.Sch D o c

D ate : 0 9.0 6.2 0 2 1

R ev isi o n : 1.0 | S h e et 6 of 6 | D esi g n b y : Je a n N a nch e n
