73jn/td-fpga-developing-board/documents/Planning/PlanningInPdf.pdf

# Rapport Routage (STEVE)

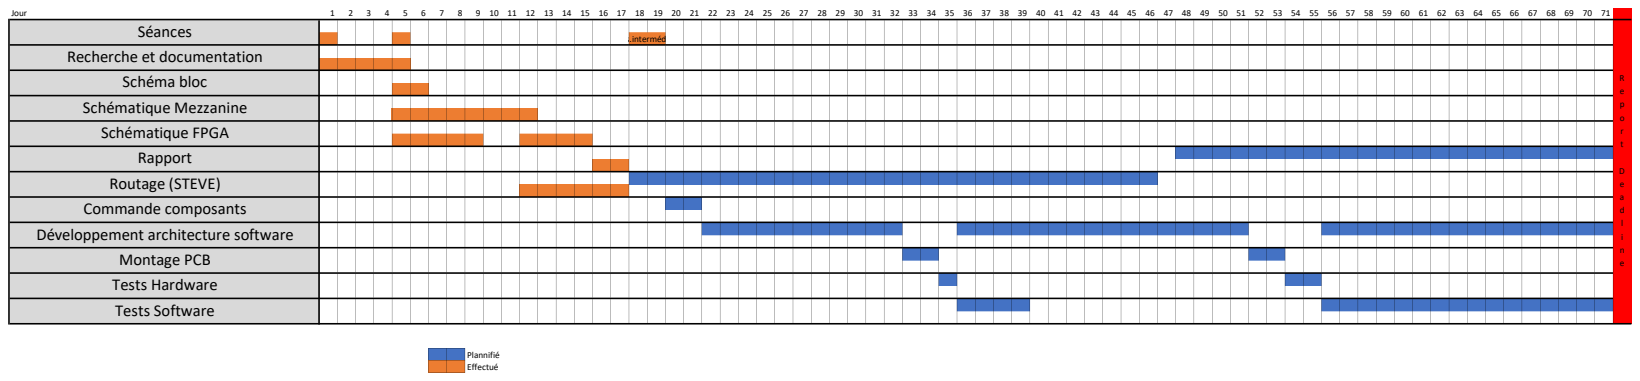
[picture p133: page 1]
Jour; Plannifié Effectué; ReportDeadline; Prés.intermédiaire; Tests Software; Montage PCB Tests Hardware; Séances

Recherche et documentation
Schéma bloc
Schématique Mezzanine
Schématique FPGA

Commande composants
Développement architecture software
