73jn/td-fpga-developing-board/POETIC_FILES/POETIC_AD_input_V2/POETIC_AD_Input_V2.pdf

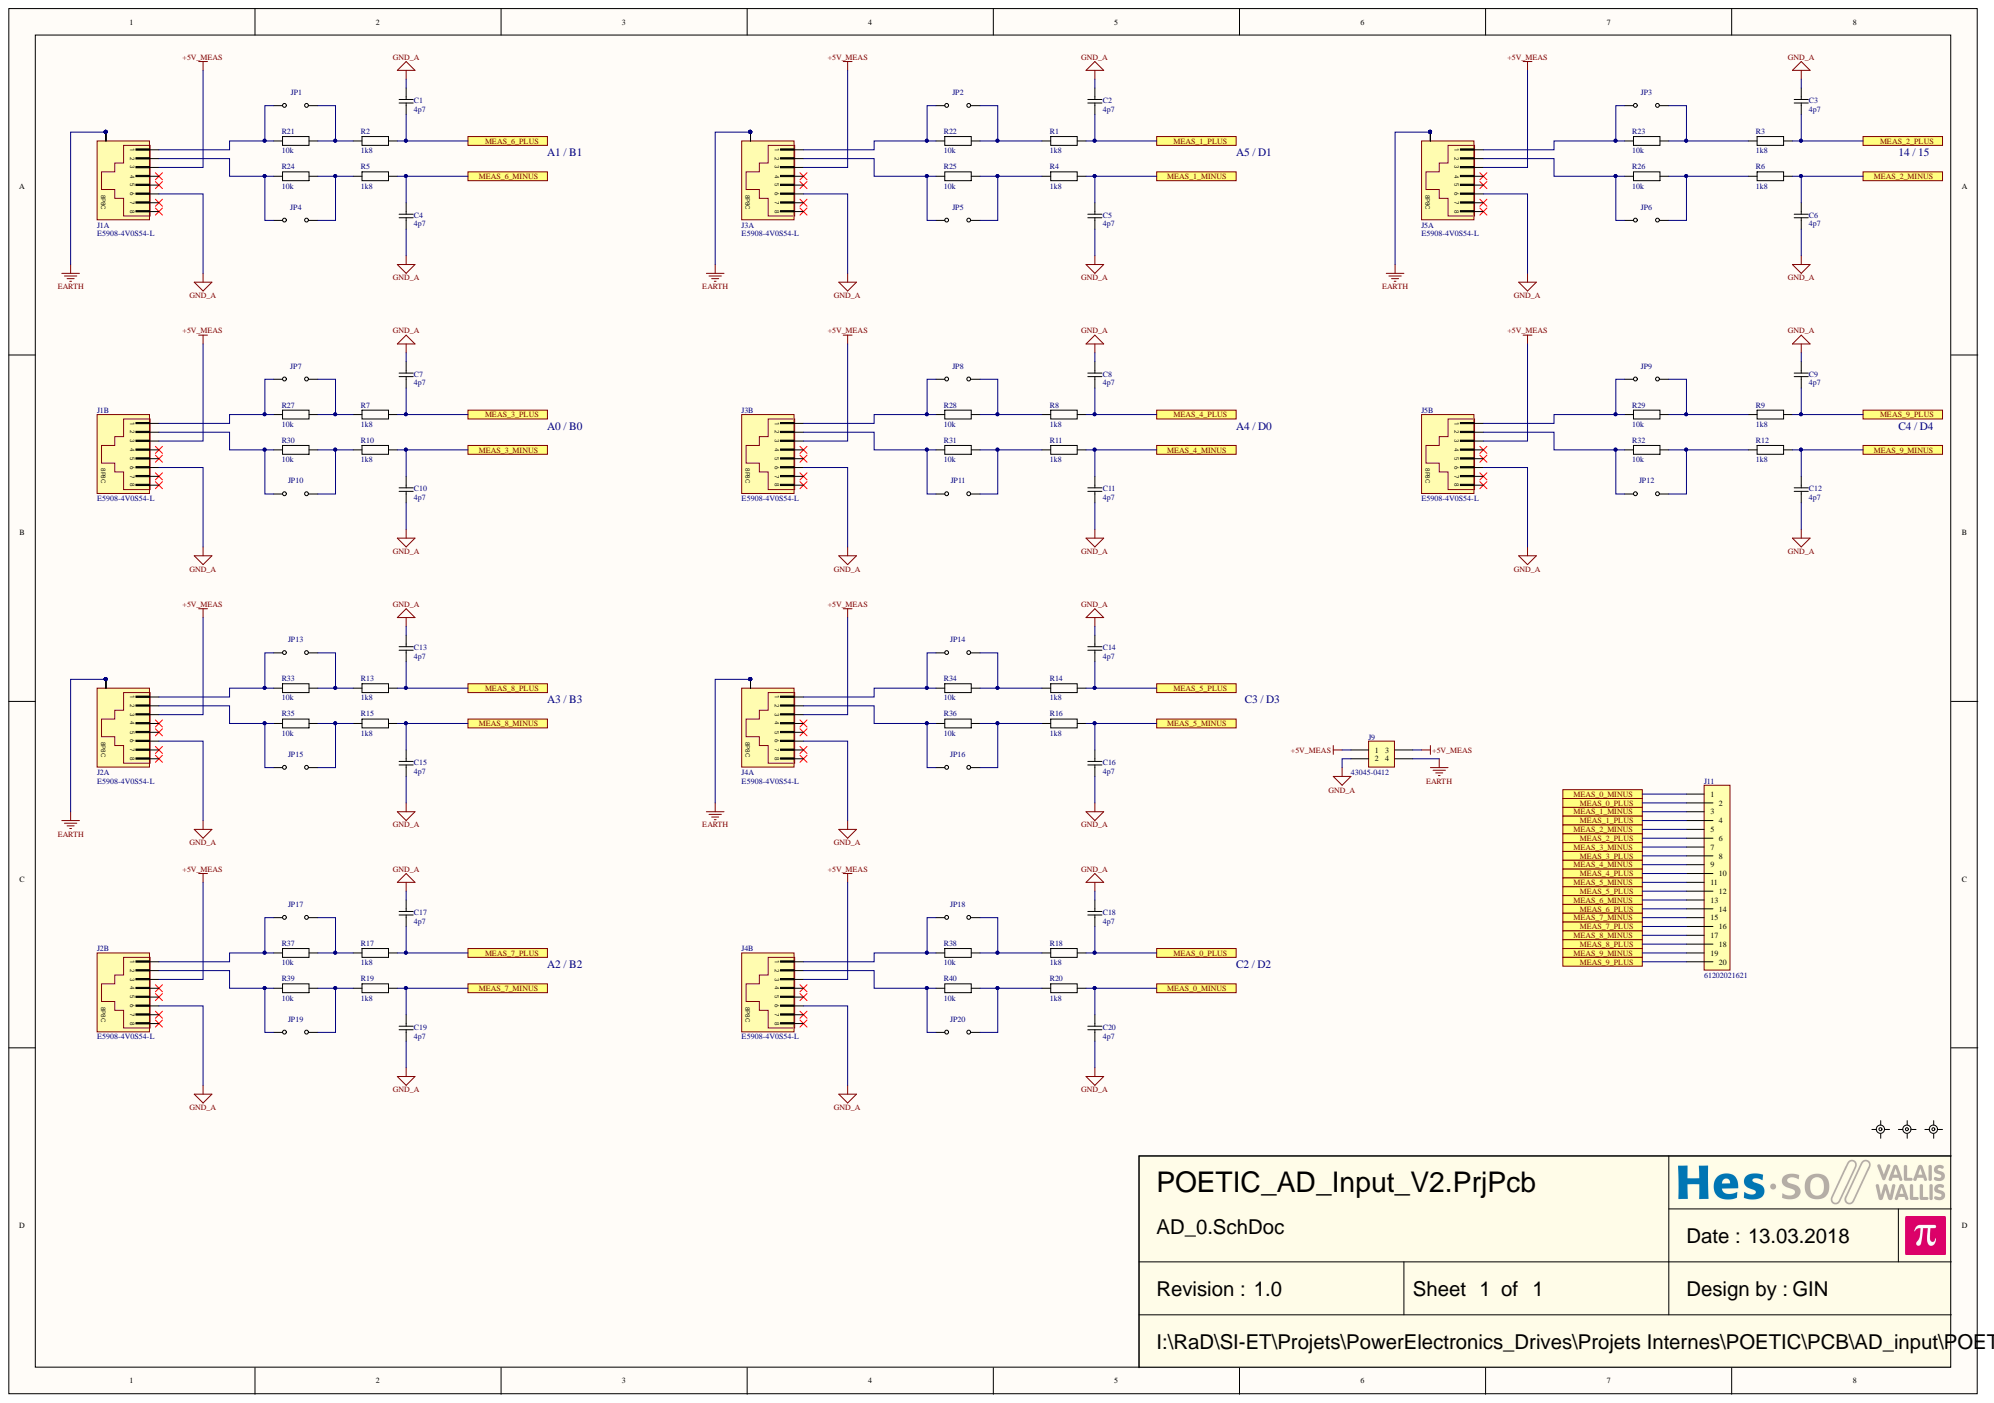
[picture p134: page 1]

POETIC_AD_Input_V2.PrjPcb AD_0.SchDoc

Date : 13.03.2018

Revision : 1.0 | Sheet 1 of 1 | Design by : GIN

I:\RaD\SI-ET\Projets\PowerElectronics_Drives\Projets Internes\POETIC\PCB\AD_input\POETIC_AD_input_V2\AD_0.SchDoc

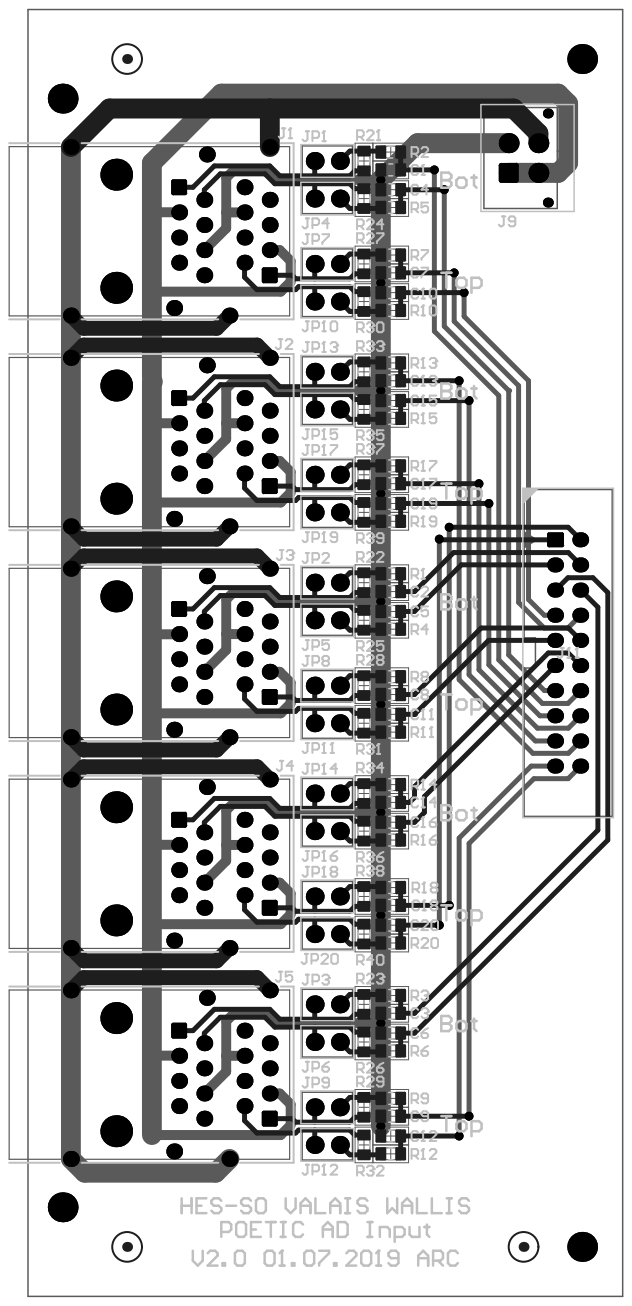
[picture p135: page 2]

# Board Stack Report
