73jn/td-fpga-developing-board/FPGA-POETIC/Mezzanine_Board/V1_01/ANAlOG_MEZZANINE1.01.pdf

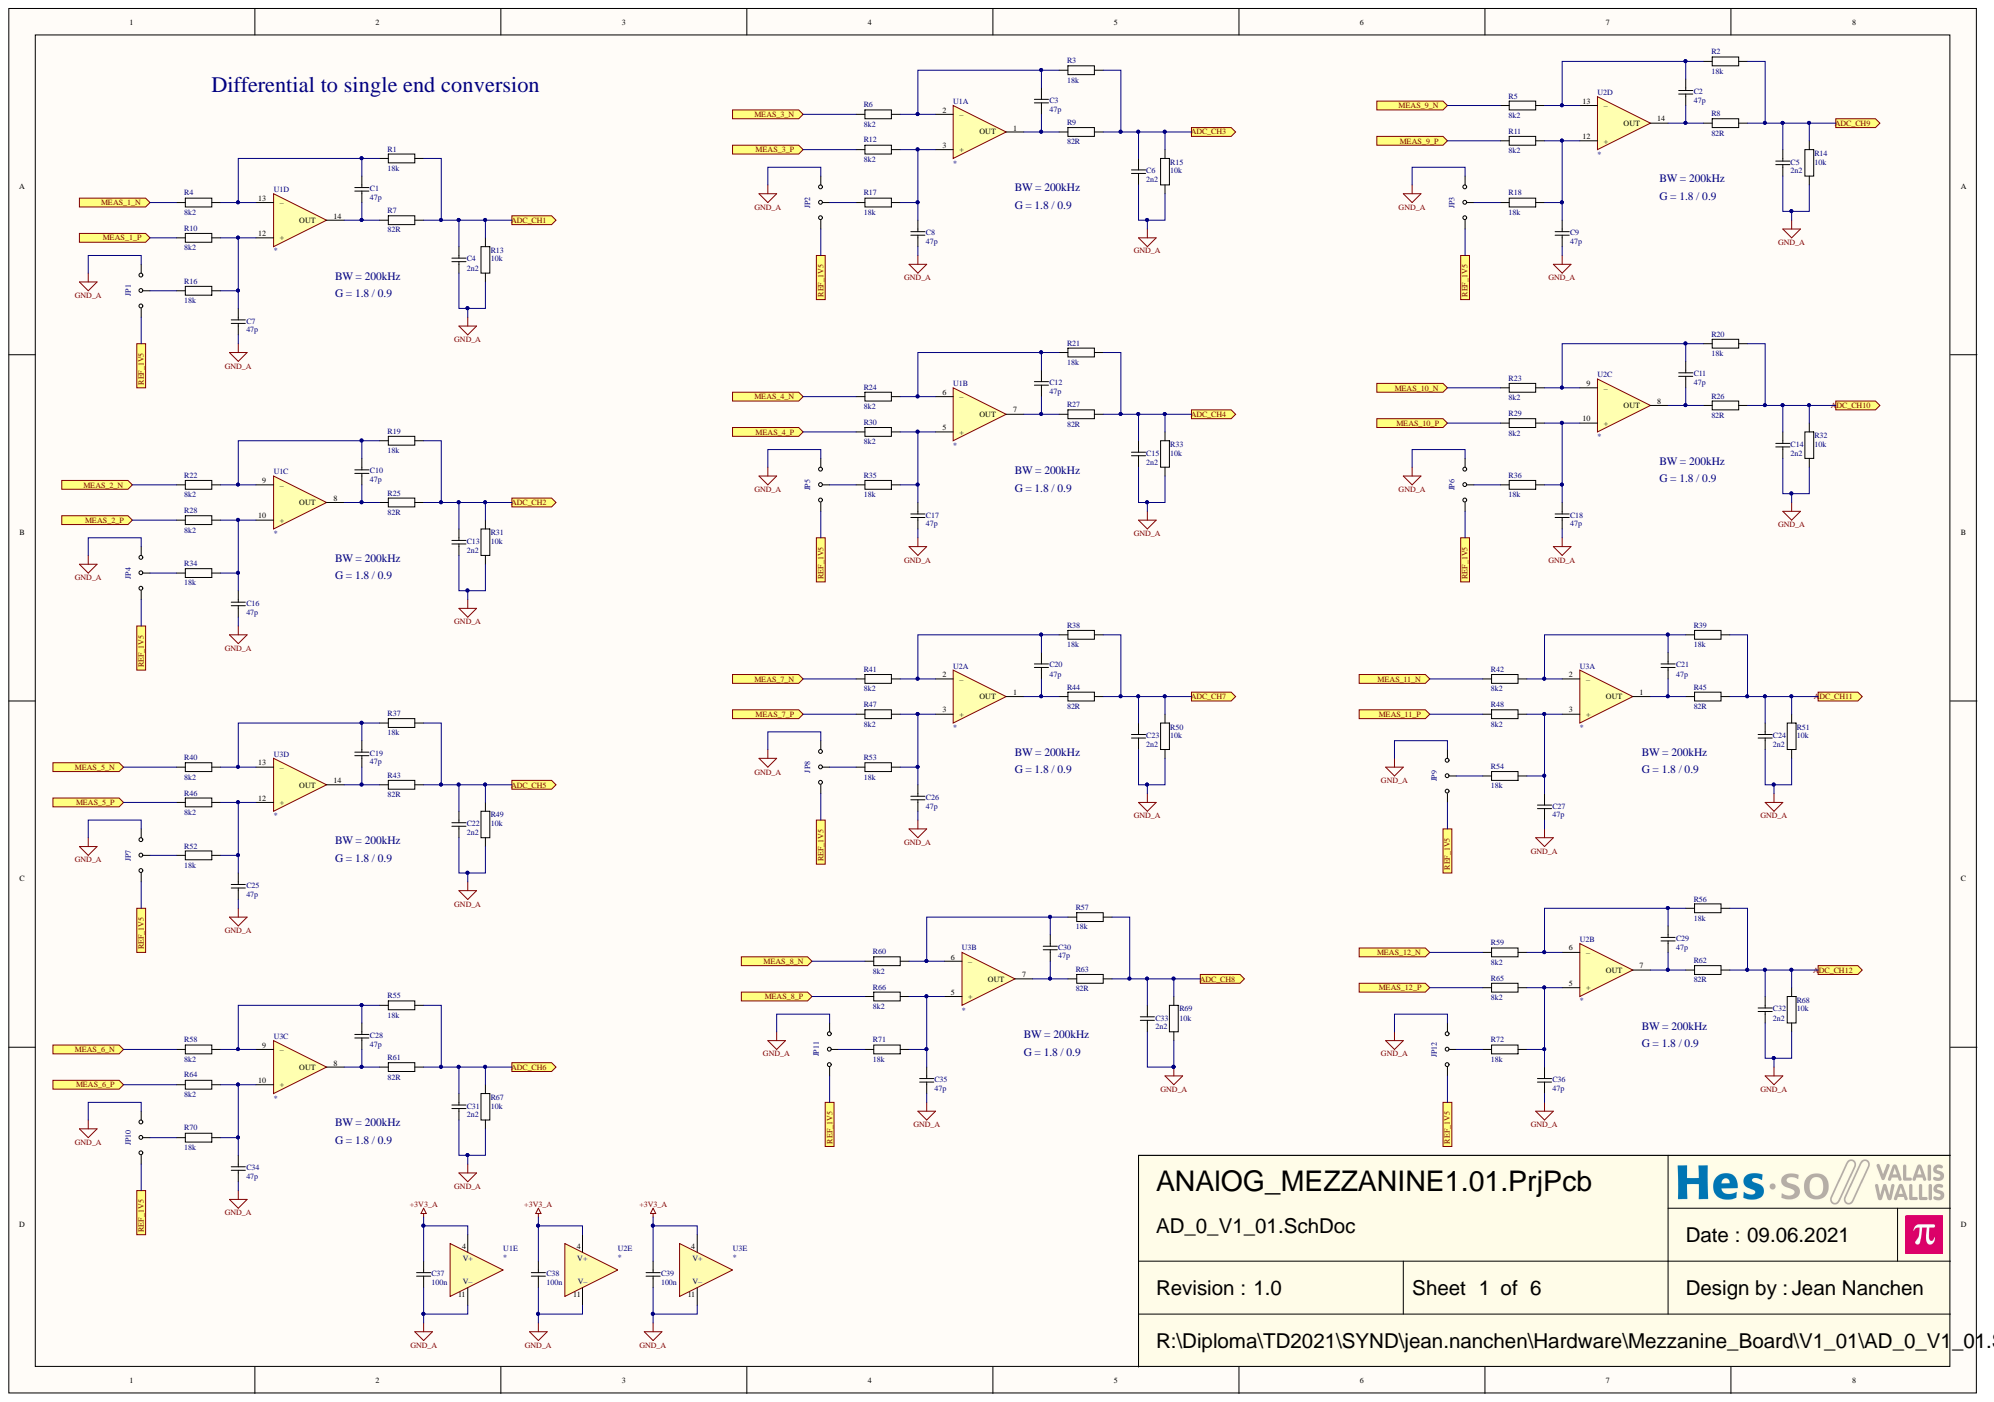
[picture p136: page 1]

ANAlOG_MEZ ZANINE1.01.PrjPcb AD_0_V1_01.SchDoc

Date : 09.06.2021

Revision : 1.0 | Sheet 1 of 6 | Design by : Jean Nanchen

R:\Diploma\TD2021\SYND\jean.nanchen\Hardware\Mezzanine_Board\V1_01\AD_0_V1_01.SchDoc

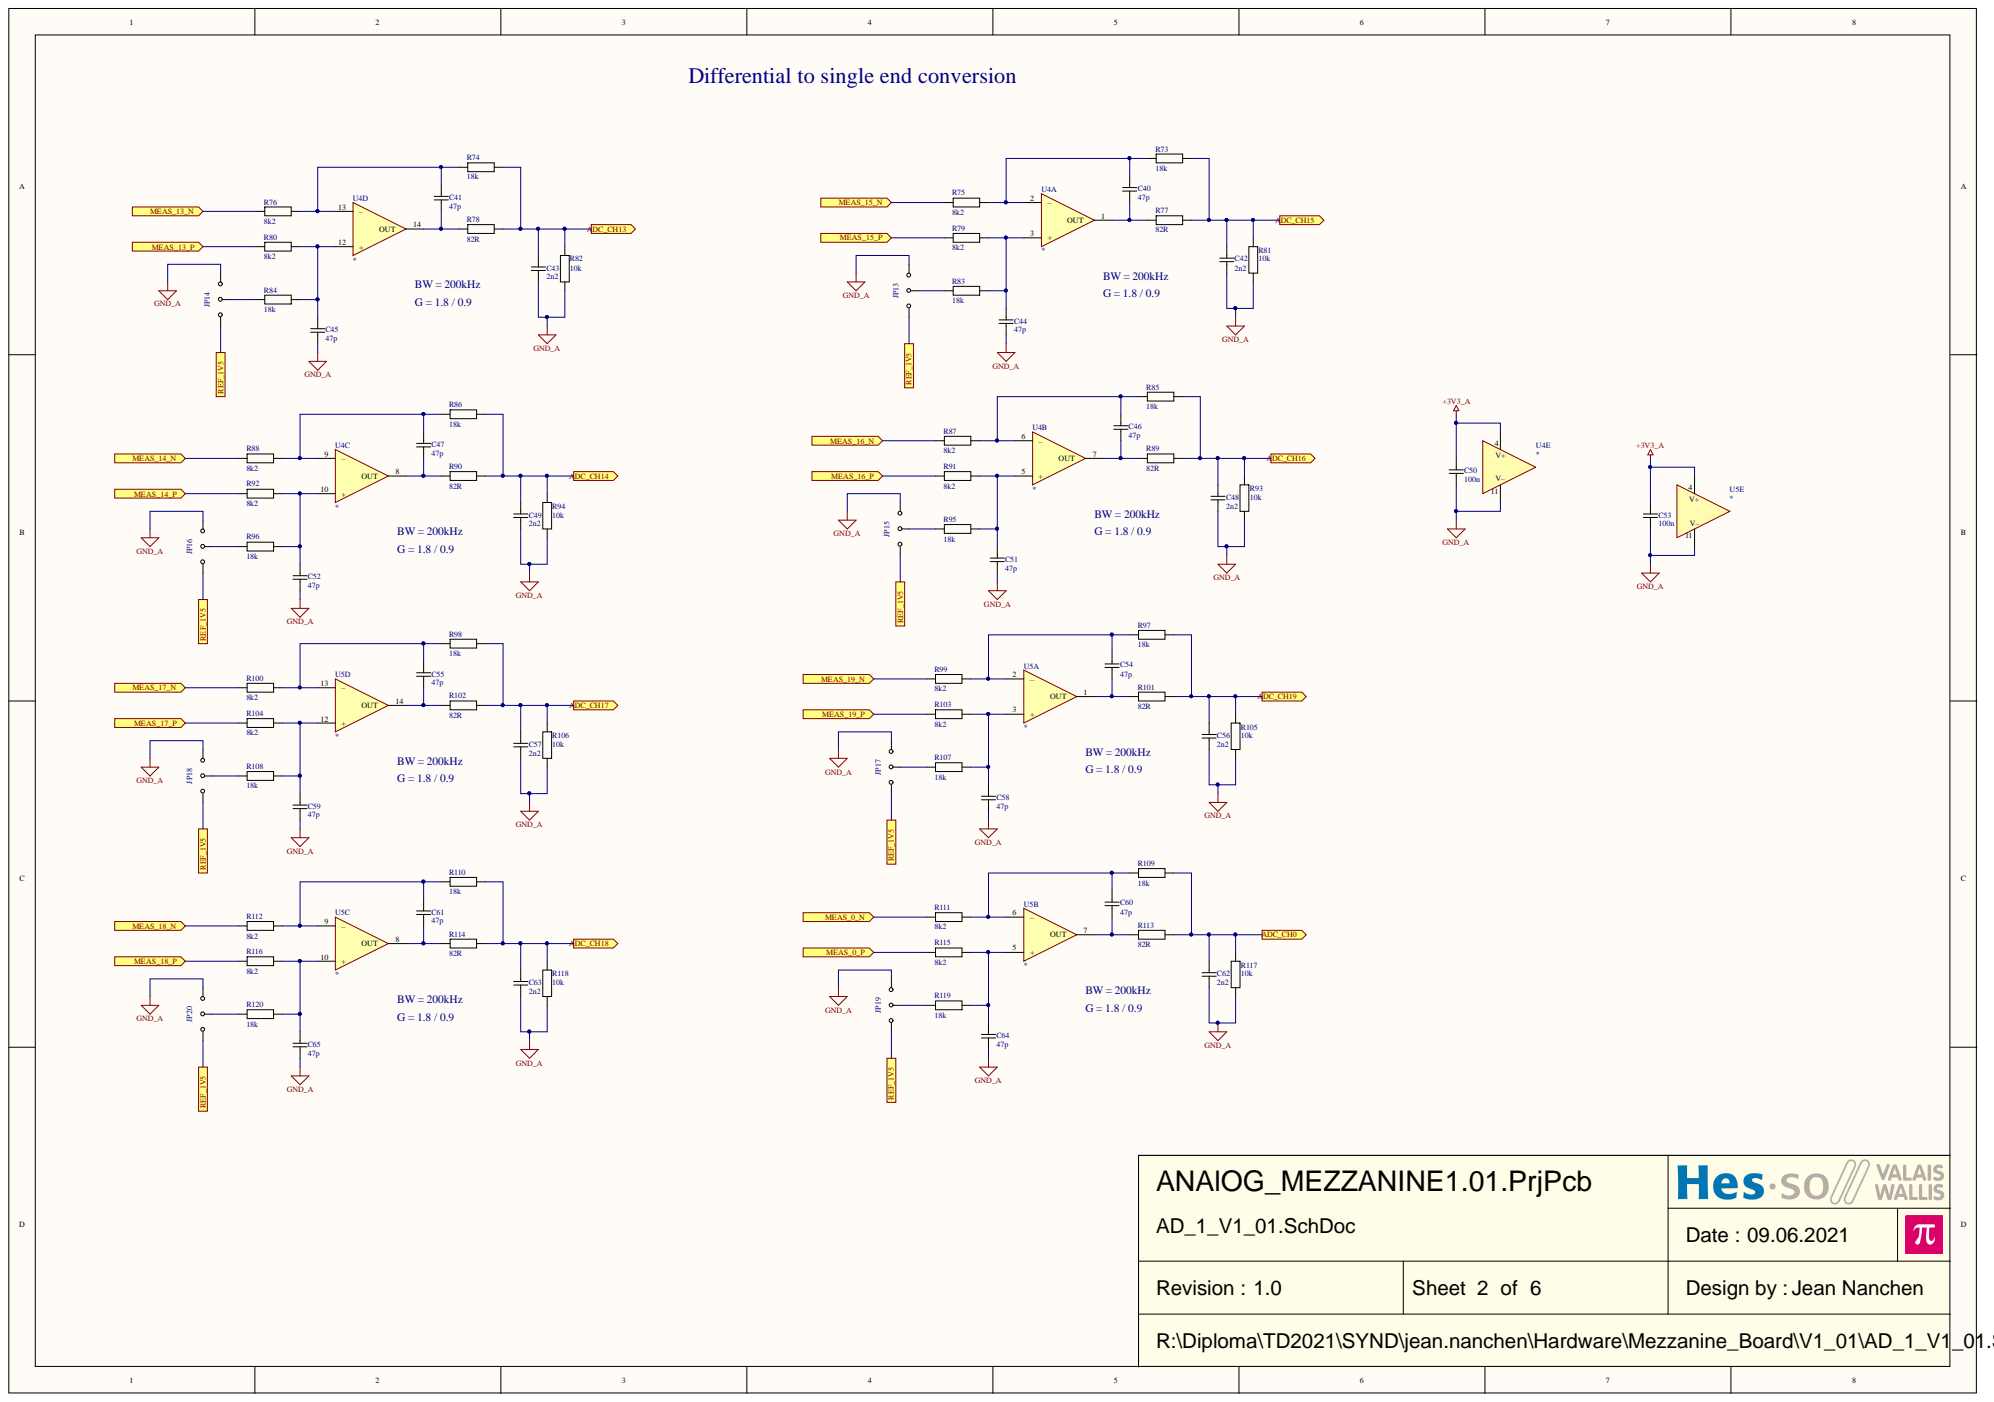
[picture p137: page 2]

ANAlOG_MEZ ZANINE1.01.PrjPcb AD_1_V1_01.SchDoc

Date : 09.06.2021

Revision : 1.0 | Sheet 2 of 6 | Design by : Jean Nanchen

R:\Diploma\TD2021\SYND\jean.nanchen\Hardware\Mezzanine_Board\V1_01\AD_1_V1_01.SchDoc

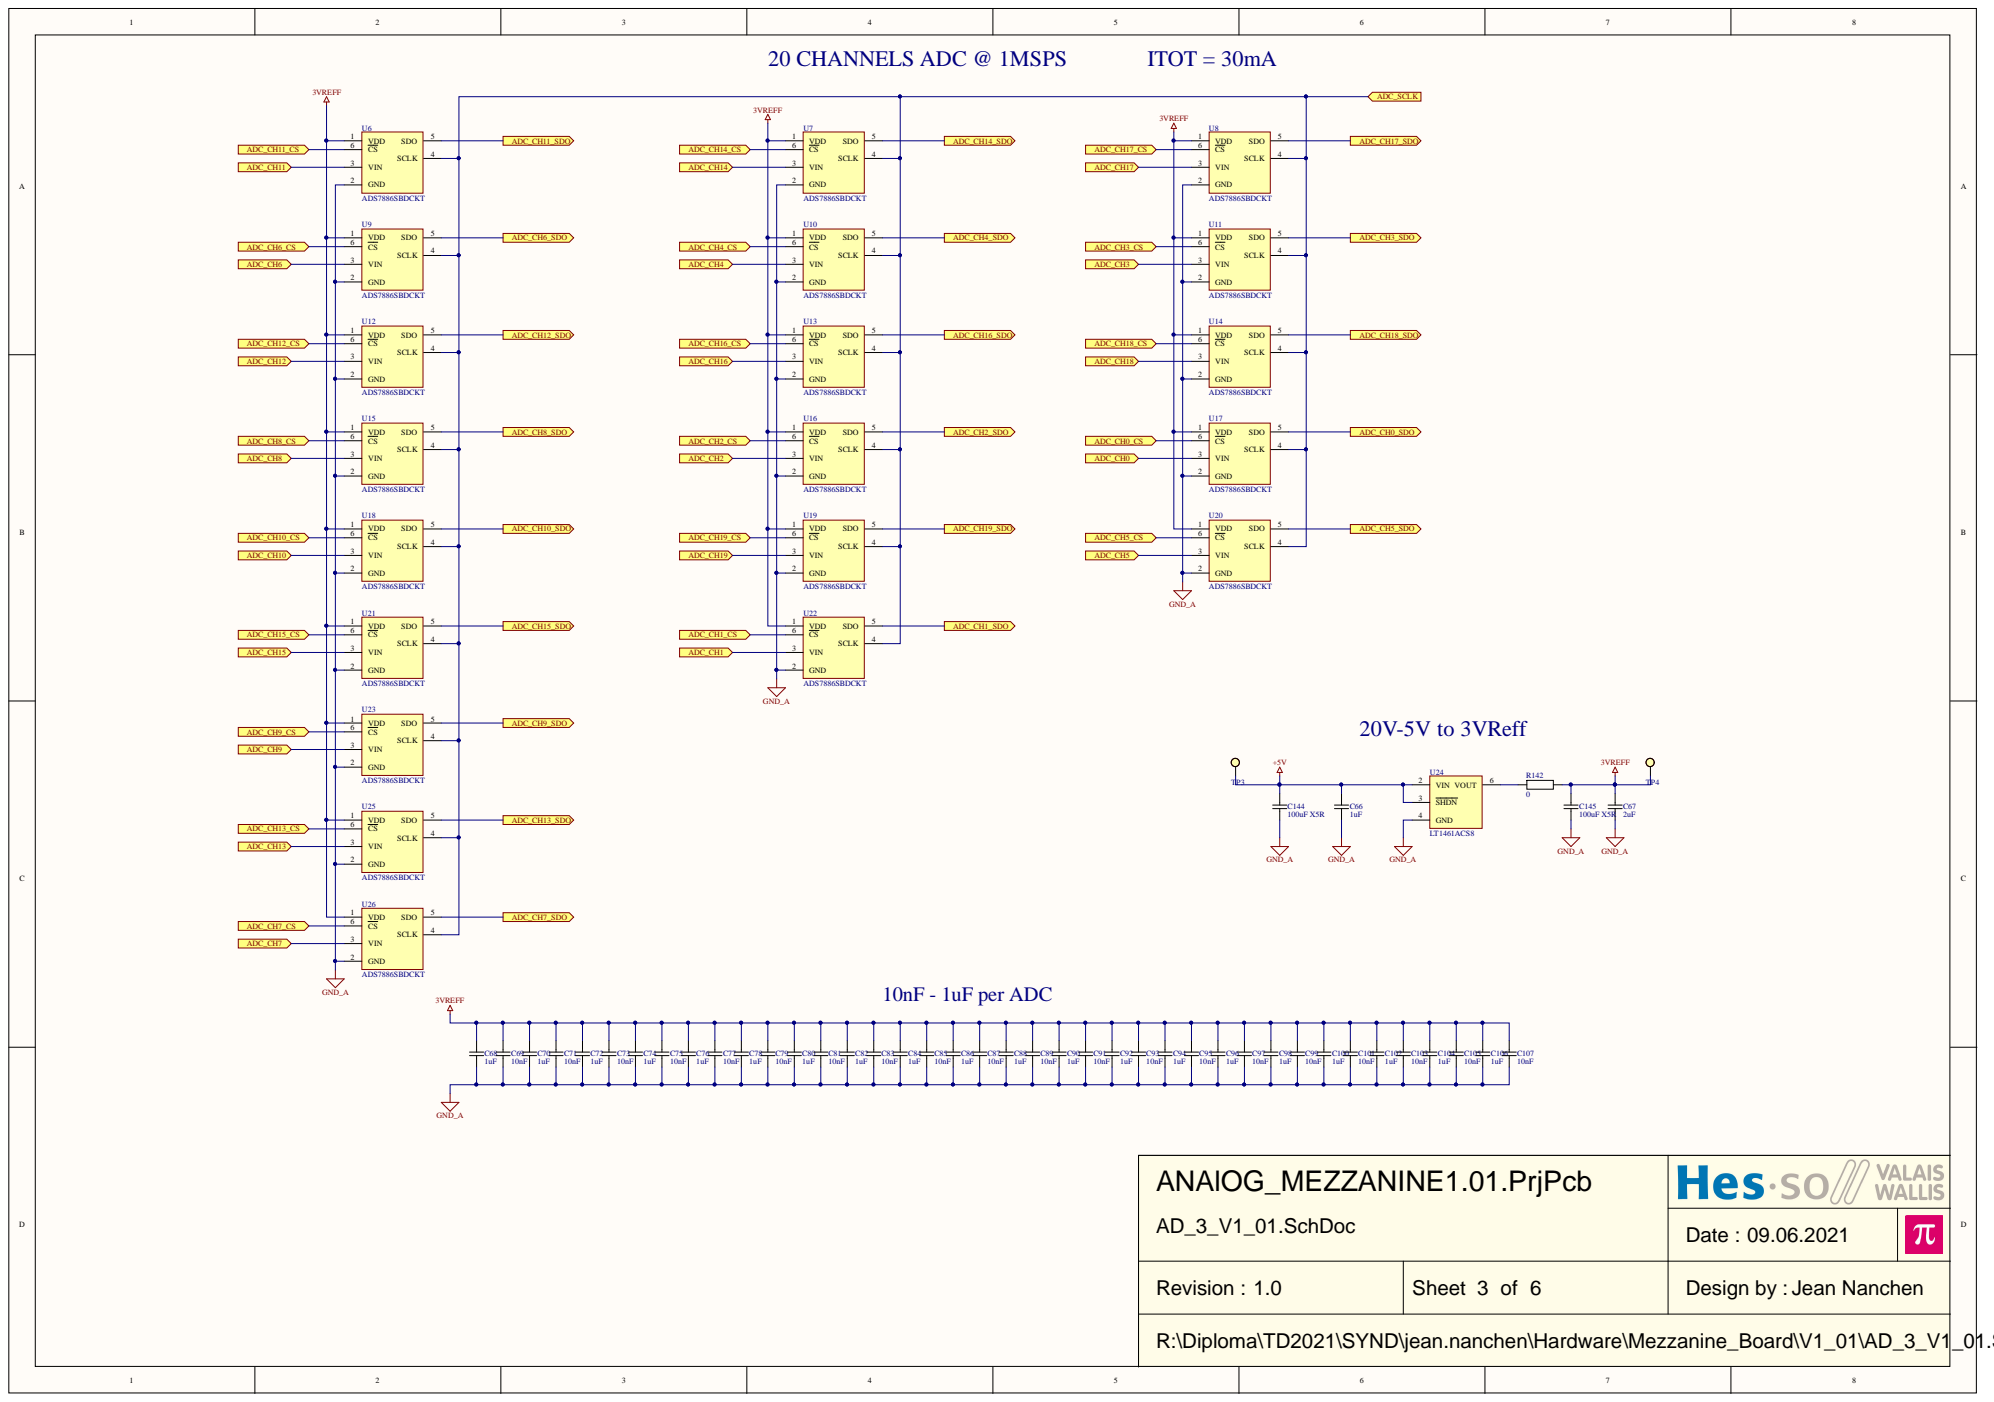
[picture p138: page 3]

VIN 3 GND 2

VIN 3 GND 2 | VIN 3

GND 2

ANAlOG_MEZZANINE1.01.PrjPcb AD_3_V1_01.SchDoc

Date : 09.06.2021

Revision : 1.0 | Sheet 3 of 6 | Design by : Jean Nanchen

R:\Diploma\TD2021\SYND\jean.nanchen\Hardware\Mezzanine_Board\V1_01\AD_3_V1_01.SchDoc

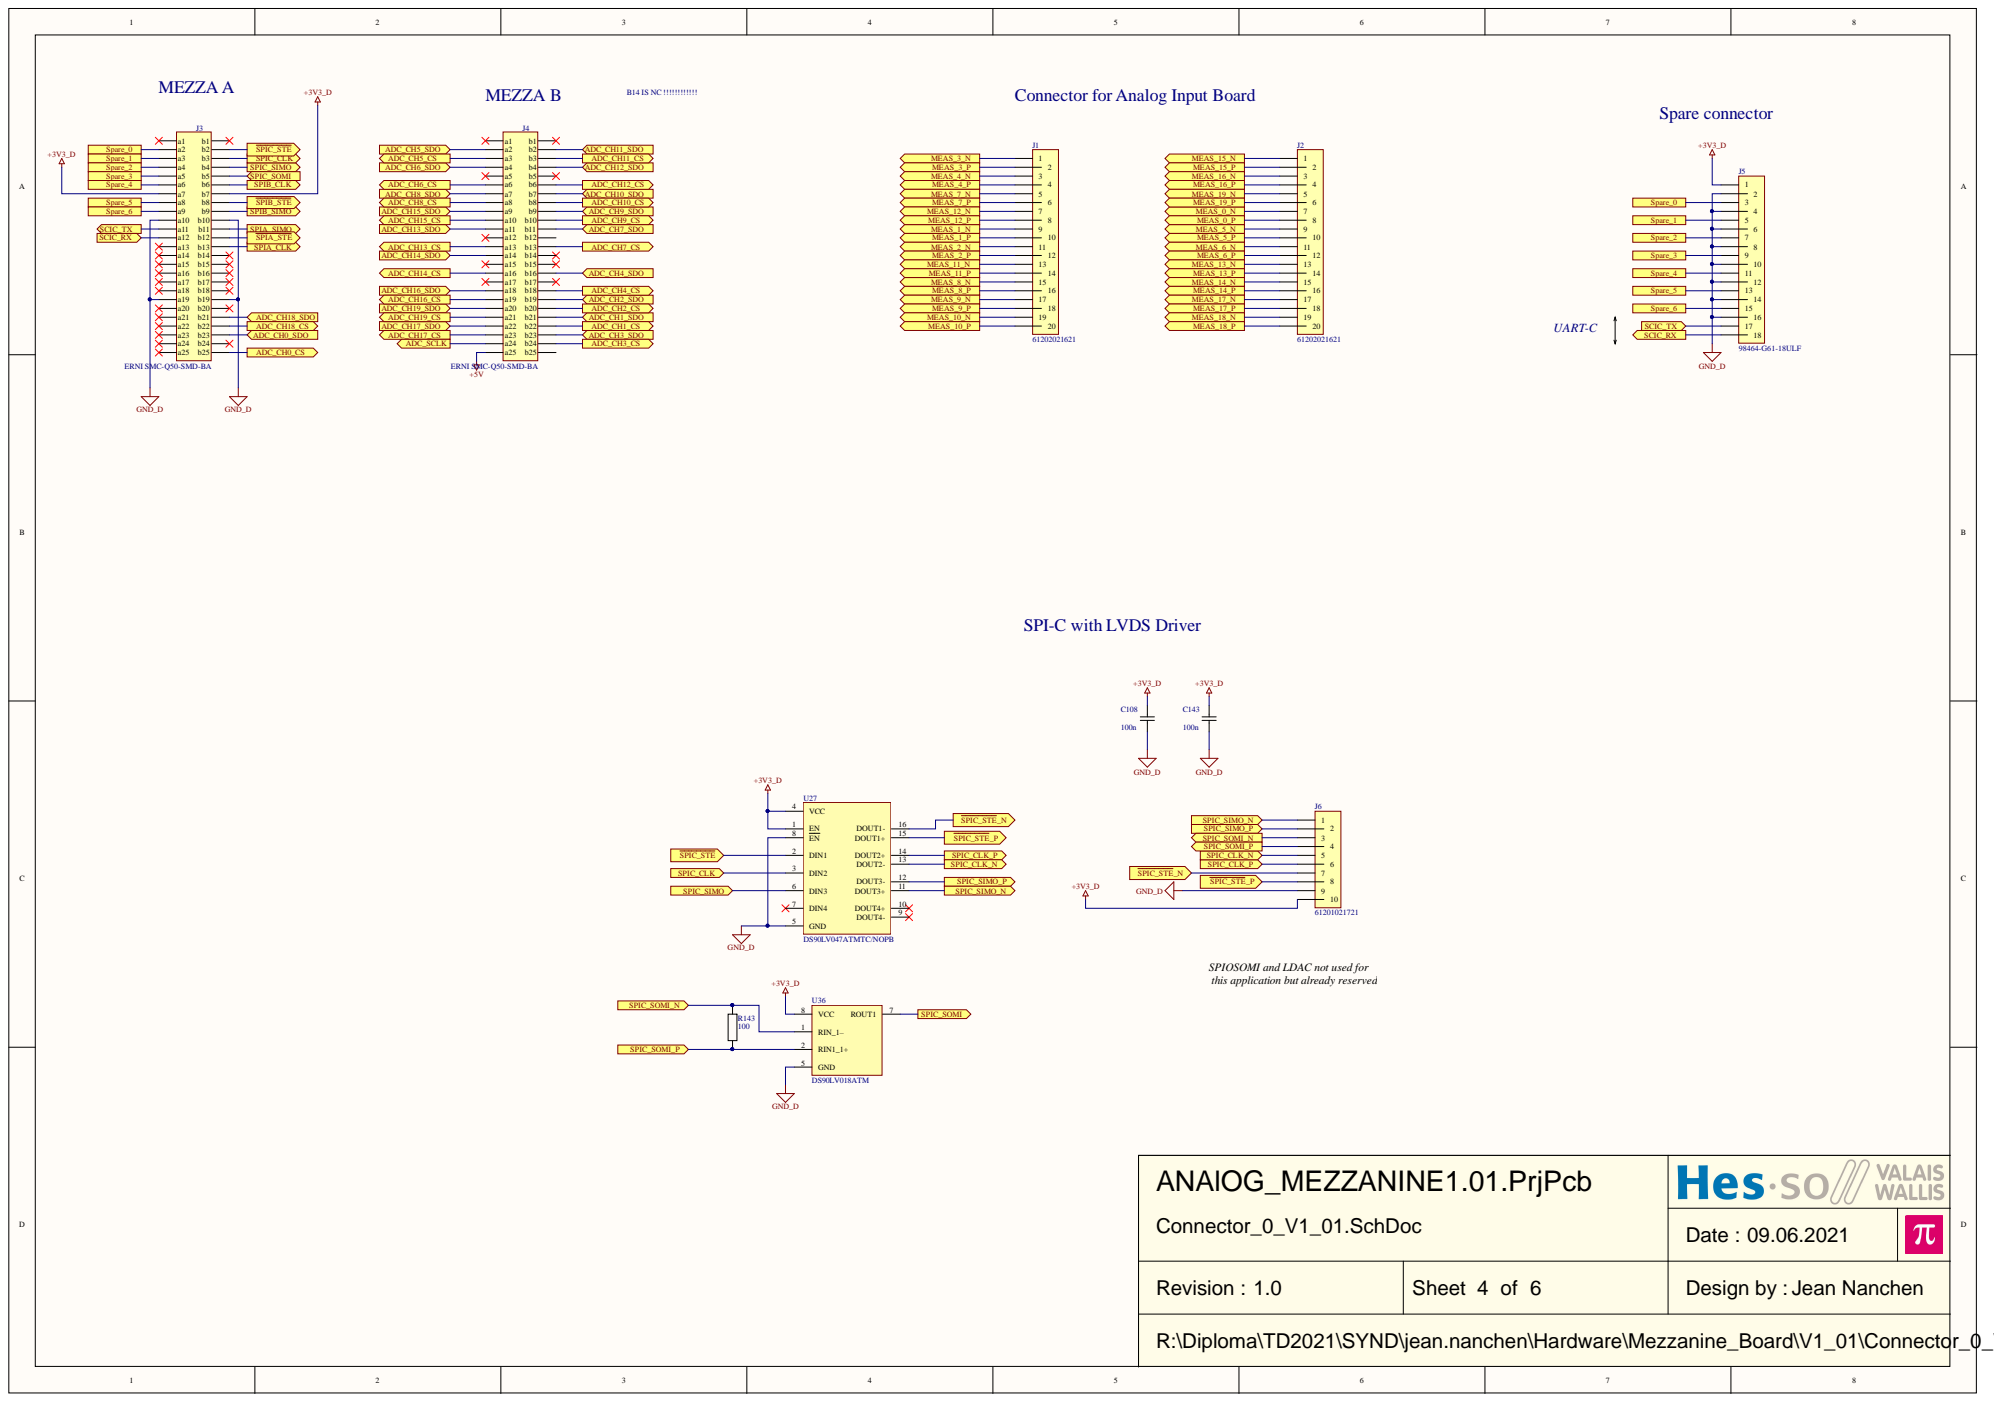
[picture p139: page 4]

Connector for Analog Input Board

ERNI SMC-Q50-SMD-BA

SPI-C with LVDS Driver

SPIOSOMI and LDAC not used for
this application but already reserved

ANAlOG_MEZZANINE1.01.PrjPcb Connector_0_V1_01.SchDoc

Date : 09.06.2021

Revision : 1.0 | Sheet 4 of 6 | Design by : Jean Nanchen

R:\Diploma\TD2021\SYND\jean.nanchen\Hardware\Mezzanine_Board\V1_01\Connector_0_V1_01.SchDoc

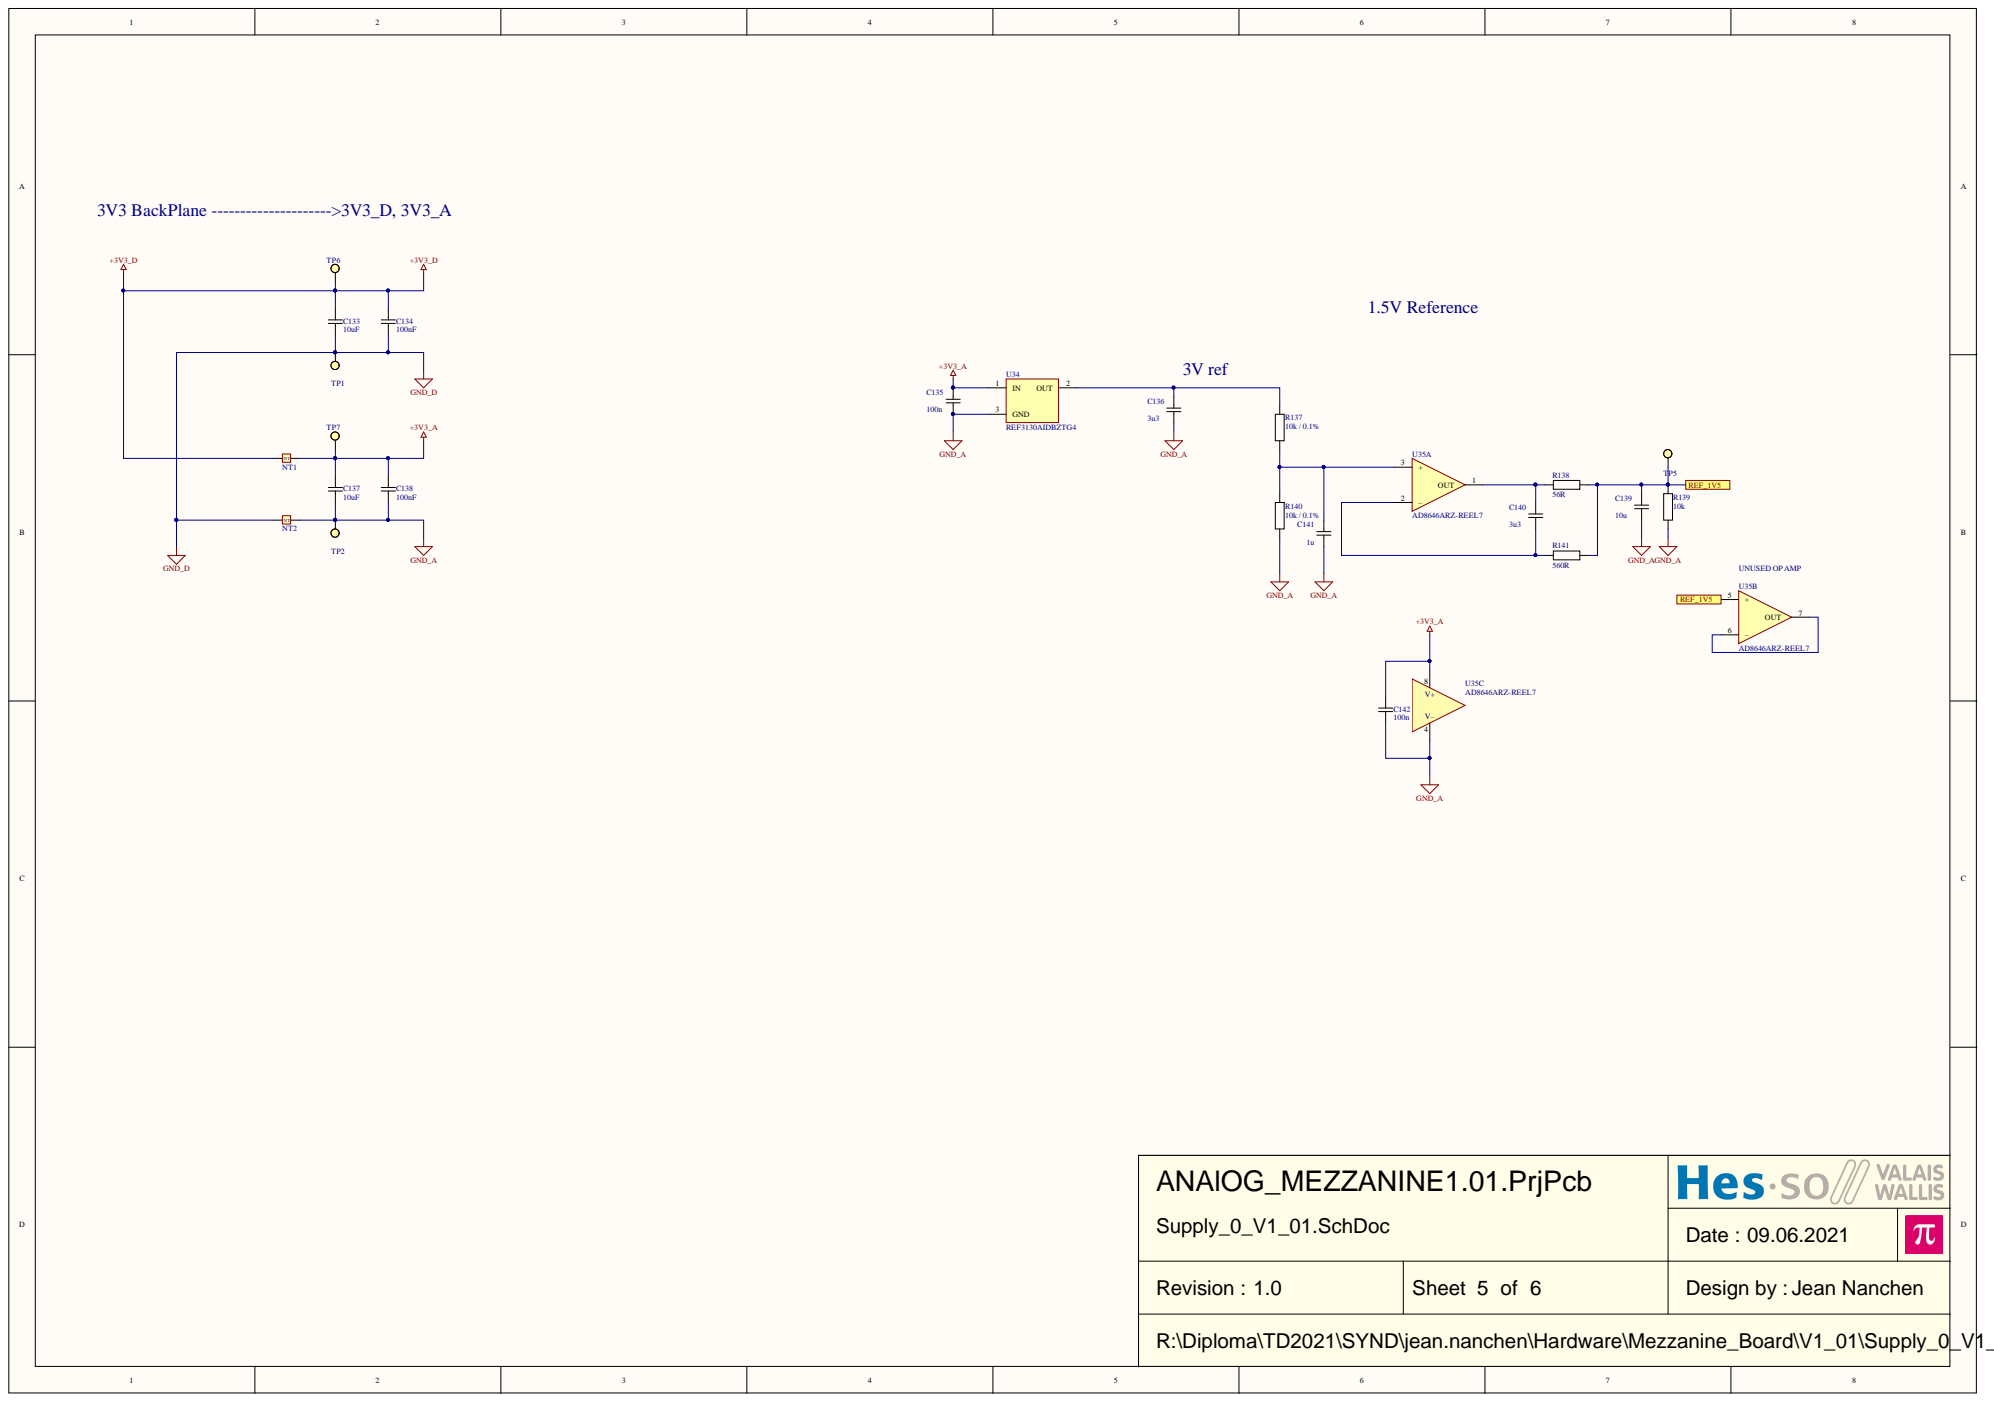
[picture p140: page 5]

ANAlOG_MEZ ZANINE1.01.PrjPcb Supply_0_V1_01.SchDoc

Date : 09.06.2021

Revision : 1.0 | Sheet 5 of 6 | Design by : Jean Nanchen

R:\Diploma\TD2021\SYND\jean.nanchen\Hardware\Mezzanine_Board\V1_01\Supply_0_V1_01.SchDoc

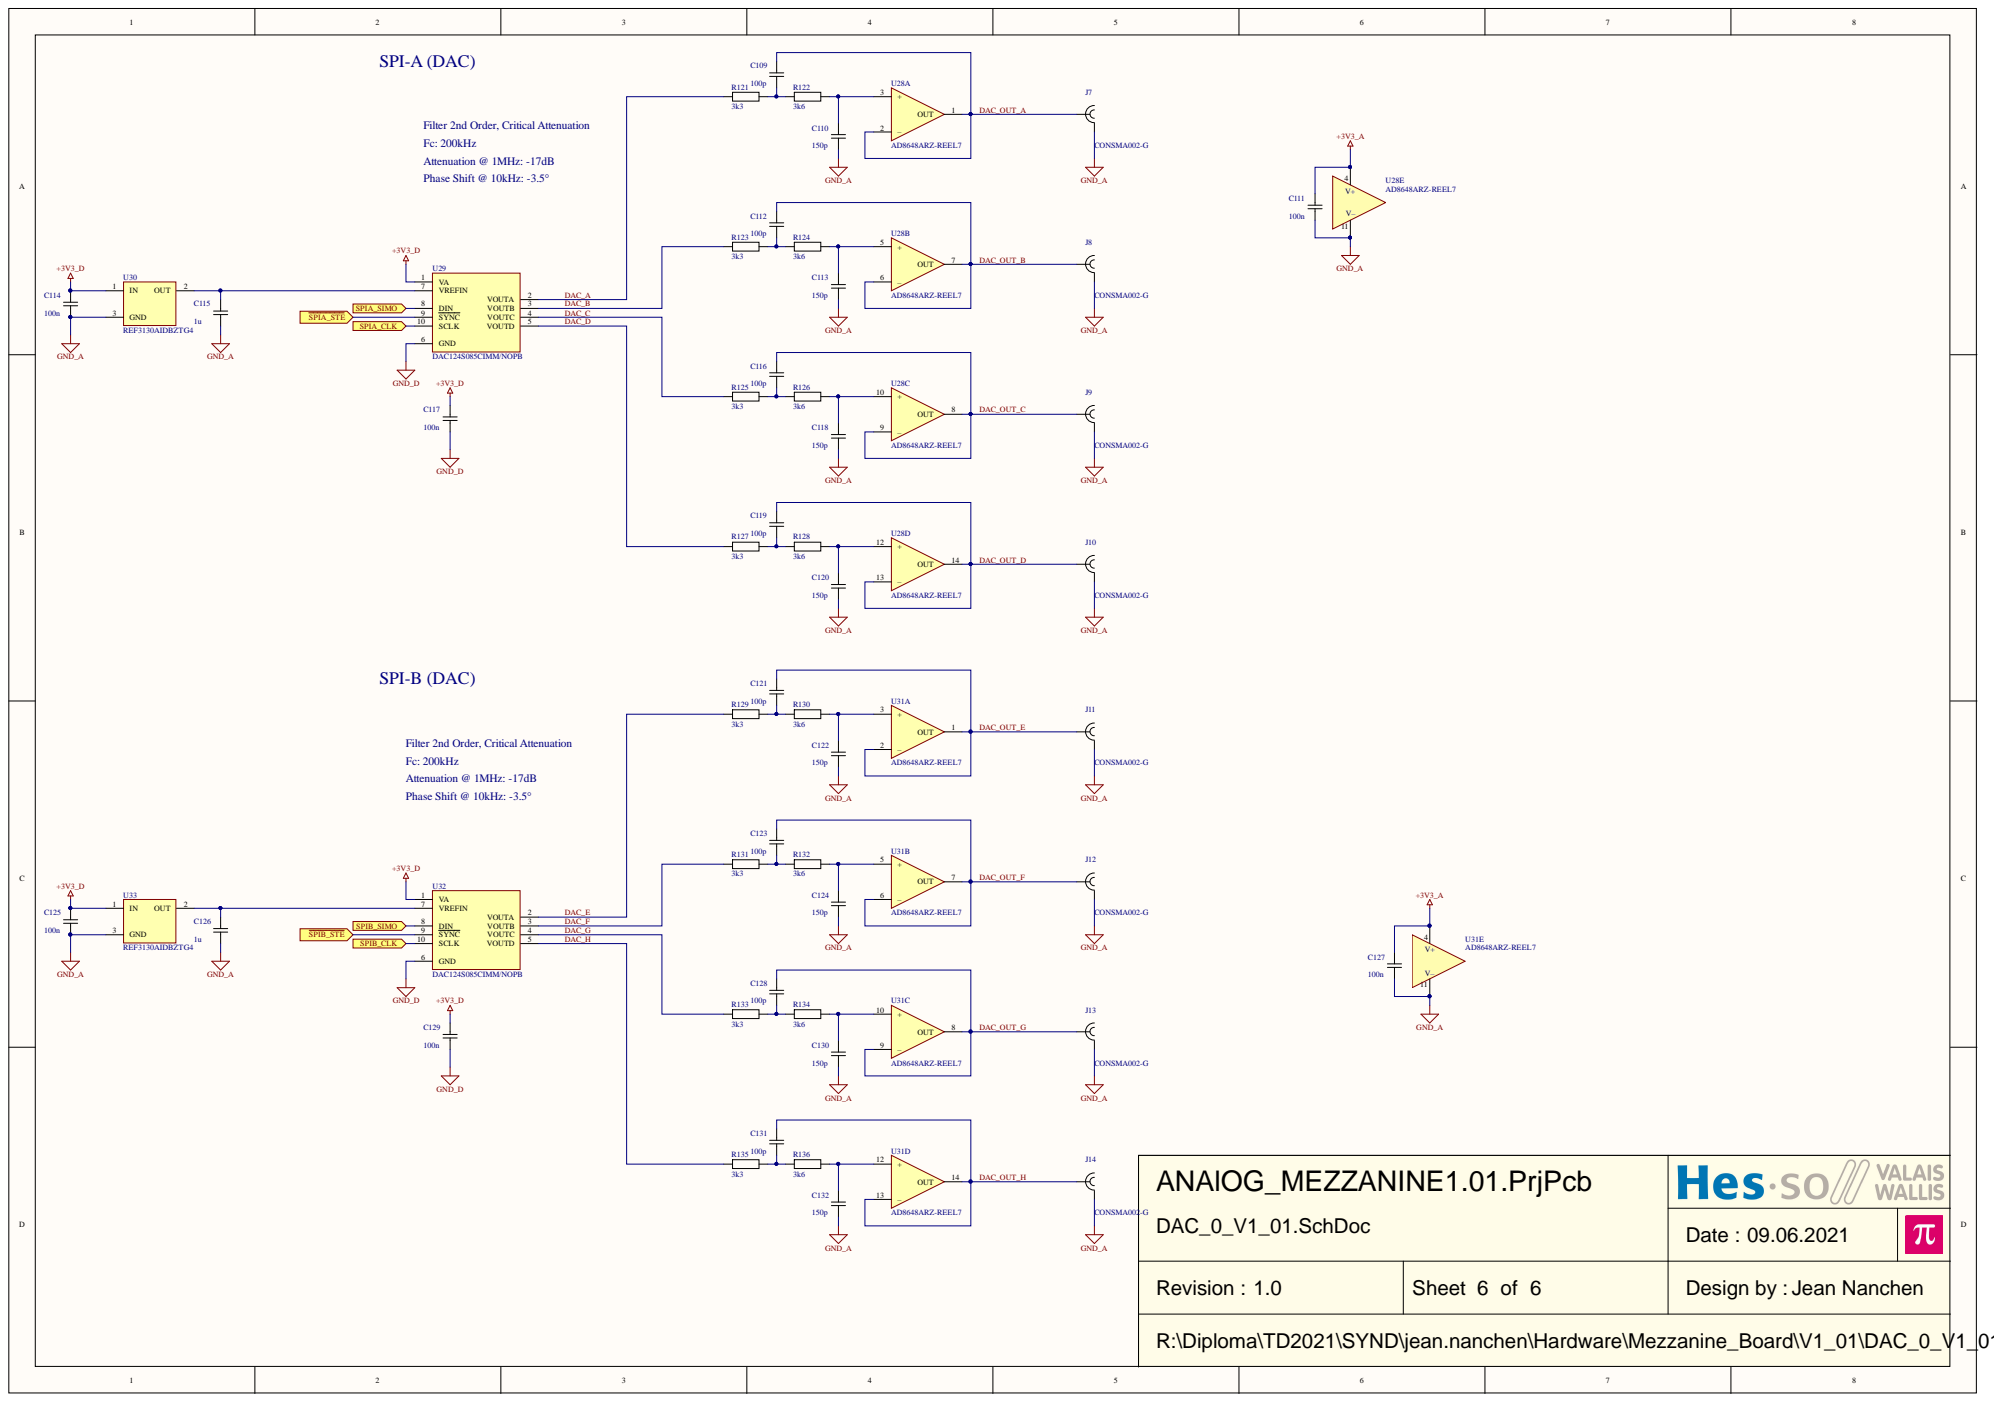
[picture p141: page 6]

3 | DAC_B

5 | DAC_D

3 | DAC_F

5 | DAC_H

ANAlOG_MEZ ZANINE1.01.PrjPcb G DAC_0_V1_01.SchDoc

Date : 09.06.2021

Revision : 1.0 | Sheet 6 of 6 | Design by : Jean Nanchen

R:\Diploma\TD2021\SYND\jean.nanchen\Hardware\Mezzanine_Board\V1_01\DAC_0_V1_01.SchDoc

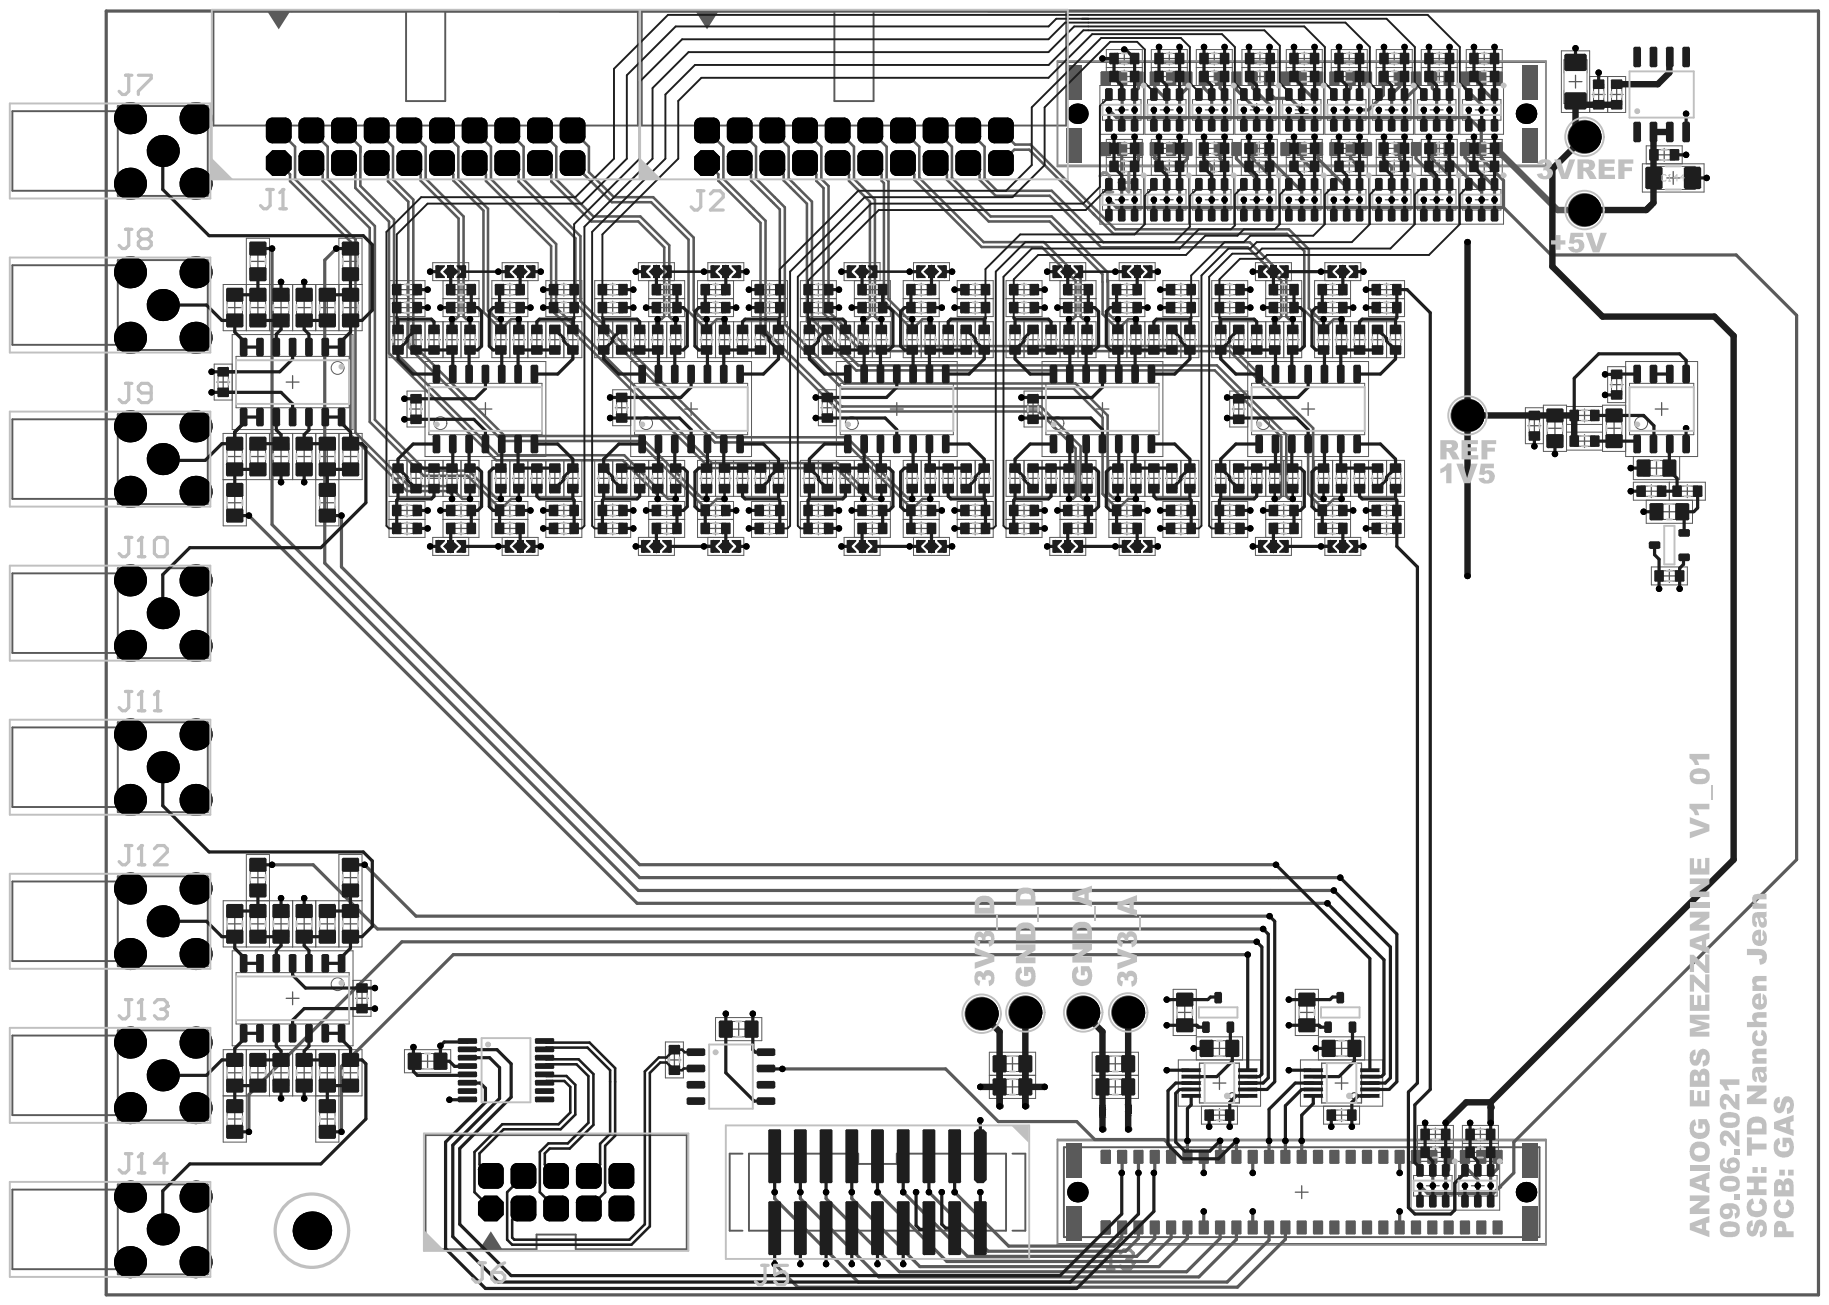
[picture p142: page 7]
