73jn/td-fpga-developing-board/FPGA-POETIC/ToBeDeleted/FPGA_Board/PCB_Project.pdf

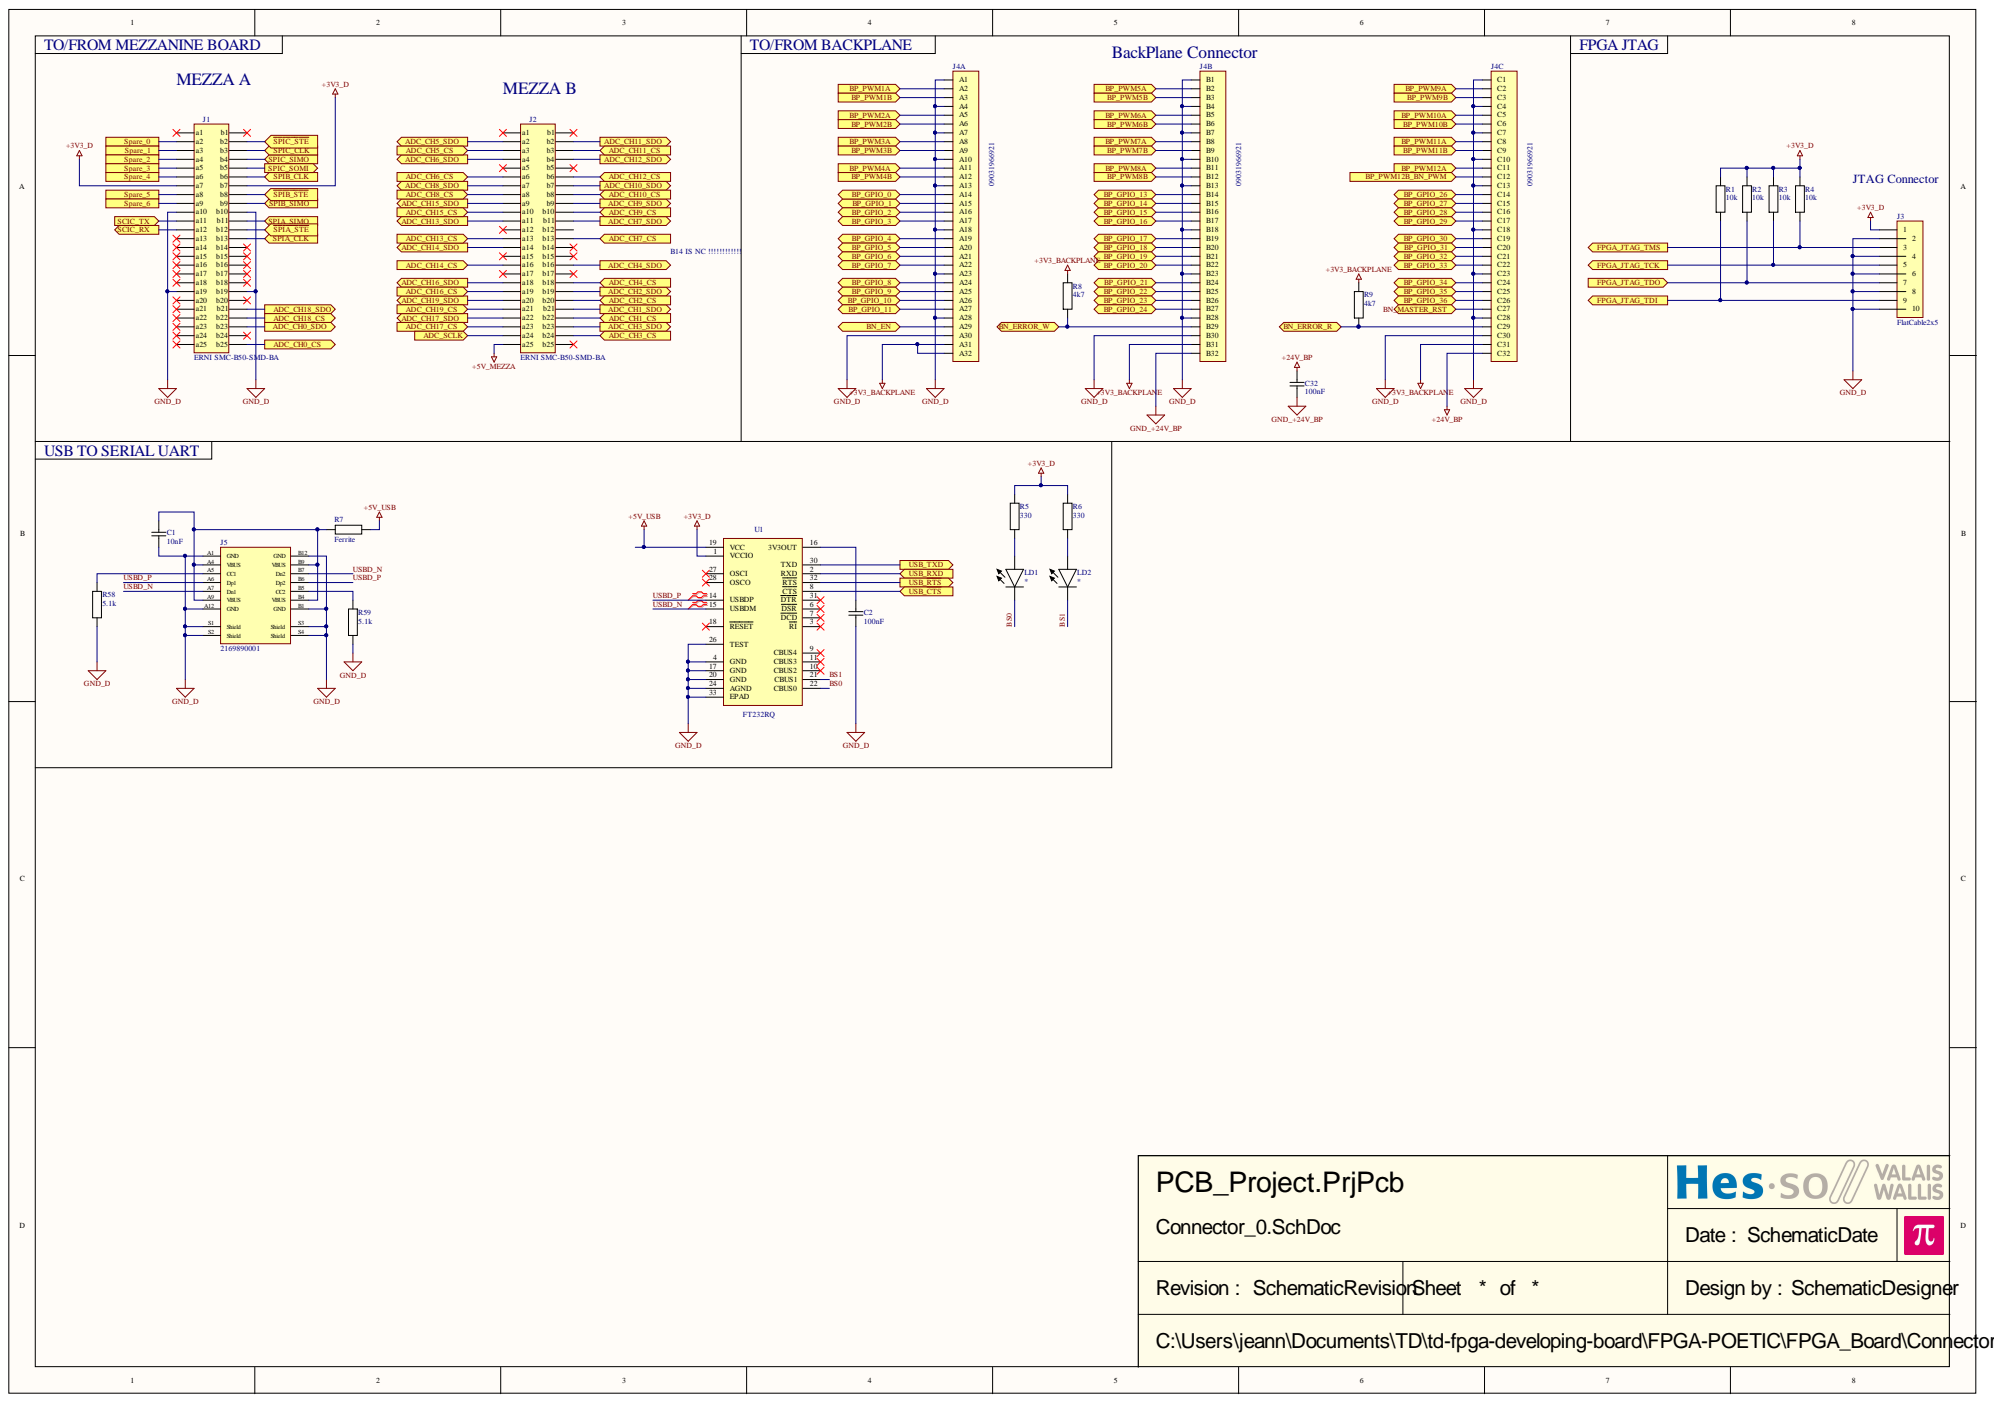
[picture p143: page 1]

USB TO SERIAL UART

PCB_Project.PrjPcb Connector_0.SchDoc

Date : SchematicDate

Revision : SchematicRevisionSheet * of * | Design by :

C:\Users\jeann\Documents\TD\td-fpga-developing-board\FPGA-POETIC\FPGA_Board\Connector_0.SchDoc

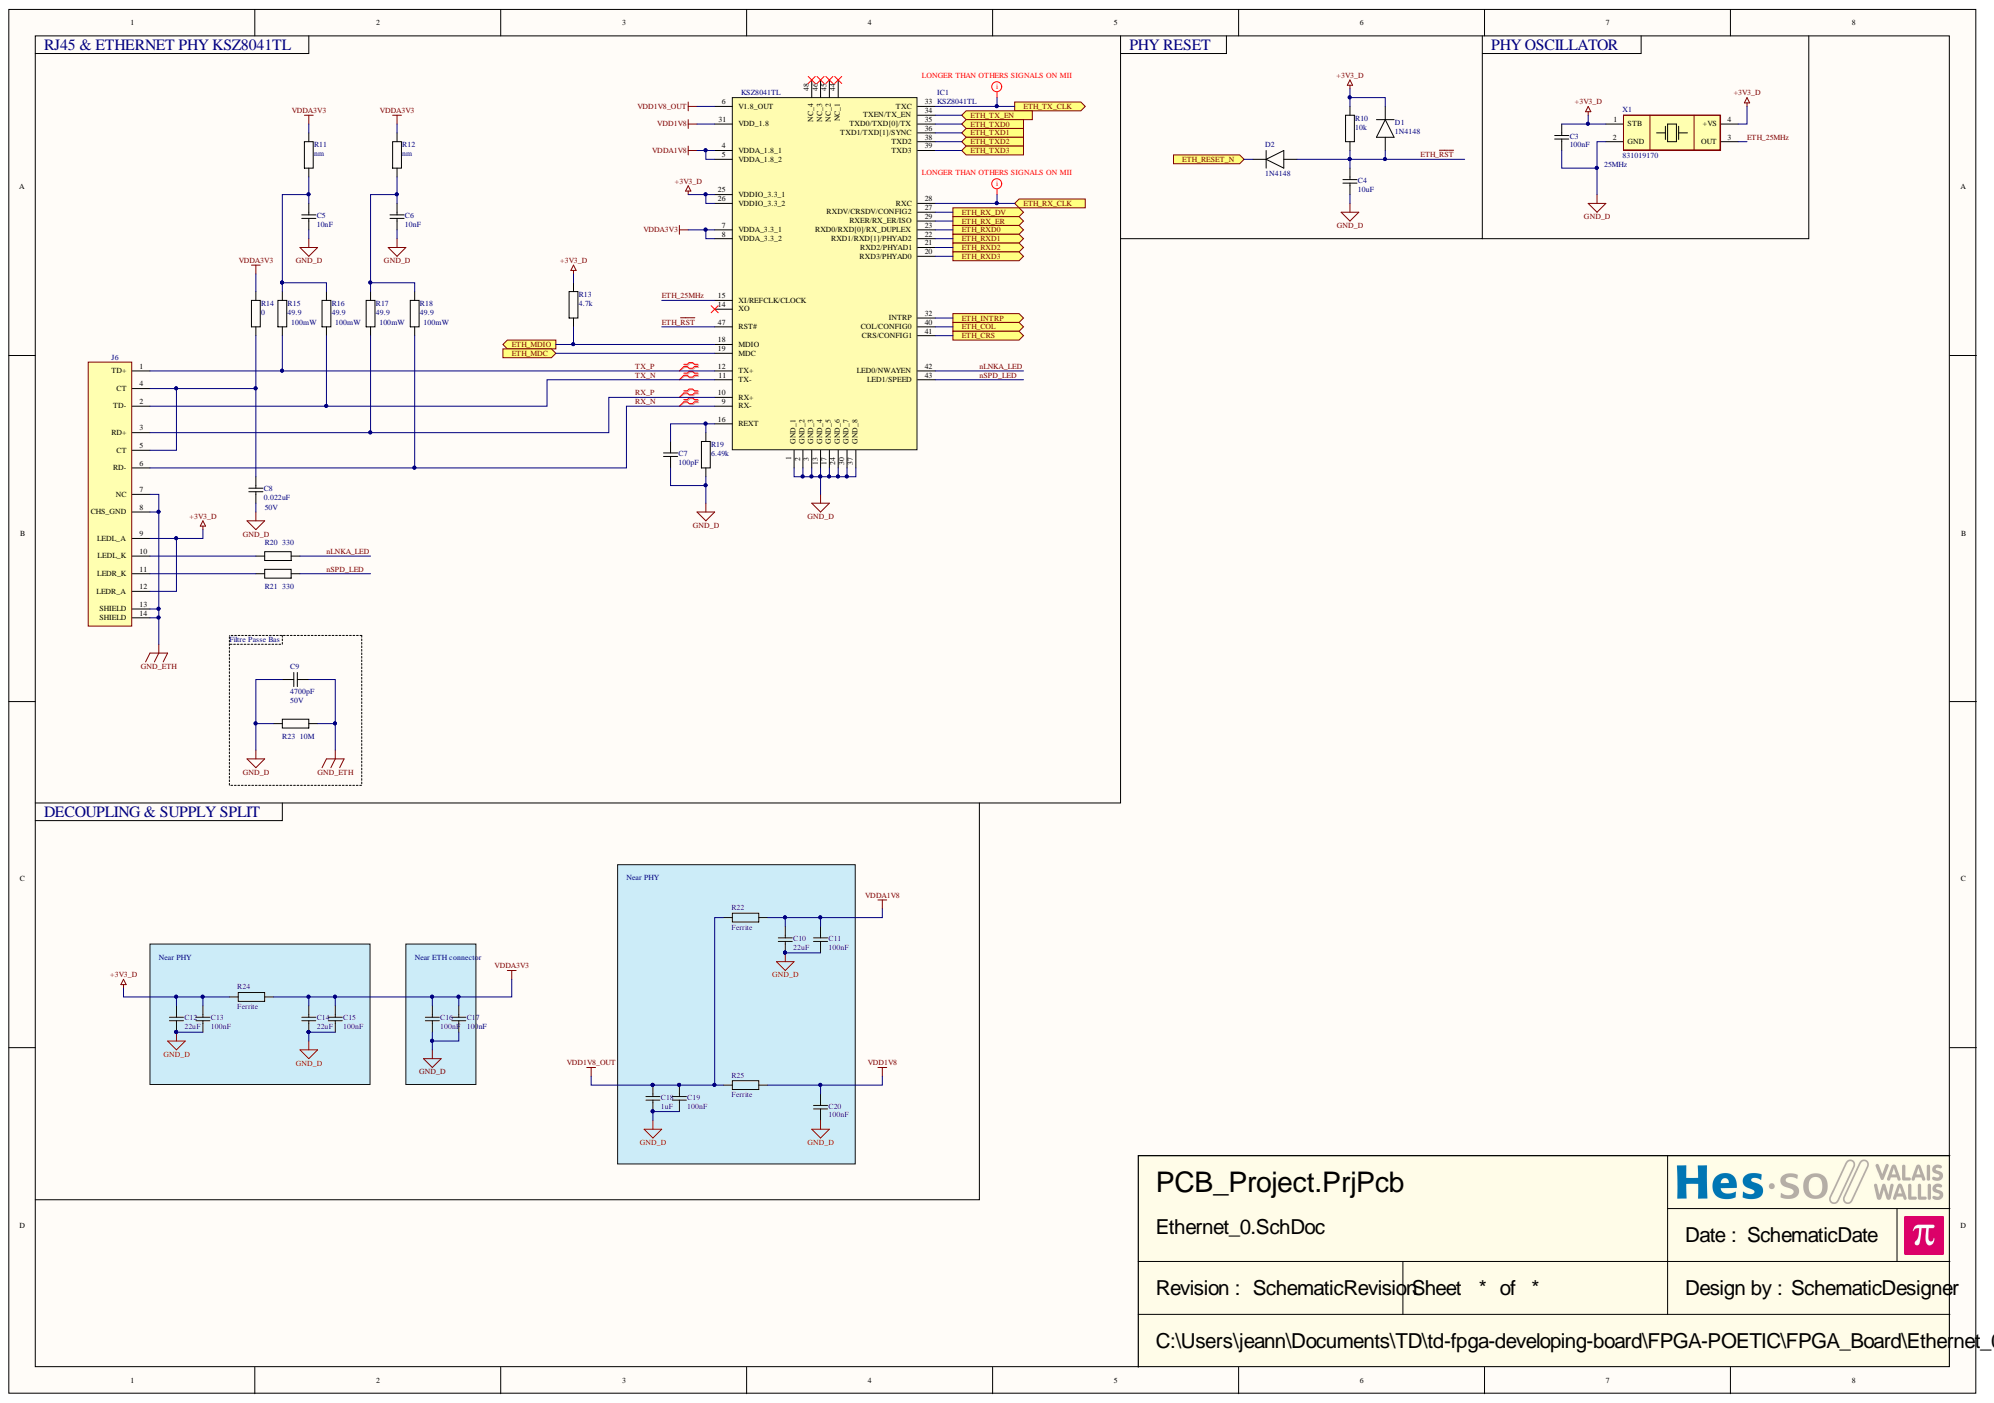
[picture p144: page 2]

LONGER THAN OTHERS SIGNALS ON MII

GND_6 24 TXD1/TXD[1]/SYNC 36 TXD0/TXD[0]/TX 35 TXEN/TX_EN 34 TXC 33

RX_P | | RX- 9 RX+ 10
RX_N

Near PHY C18 C19 1uF 100nF GND_D | R22 Ferrite C20 100nF

PCB_Project.PrjPcb Ethernet_0.SchDoc

Date : SchematicDate

Revision : SchematicRevisionSheet * of * | Design by :

C:\Users\jeann\Documents\TD\td-fpga-developing-board\FPGA-POETIC\FPGA_Board\Ethernet_0.SchDoc

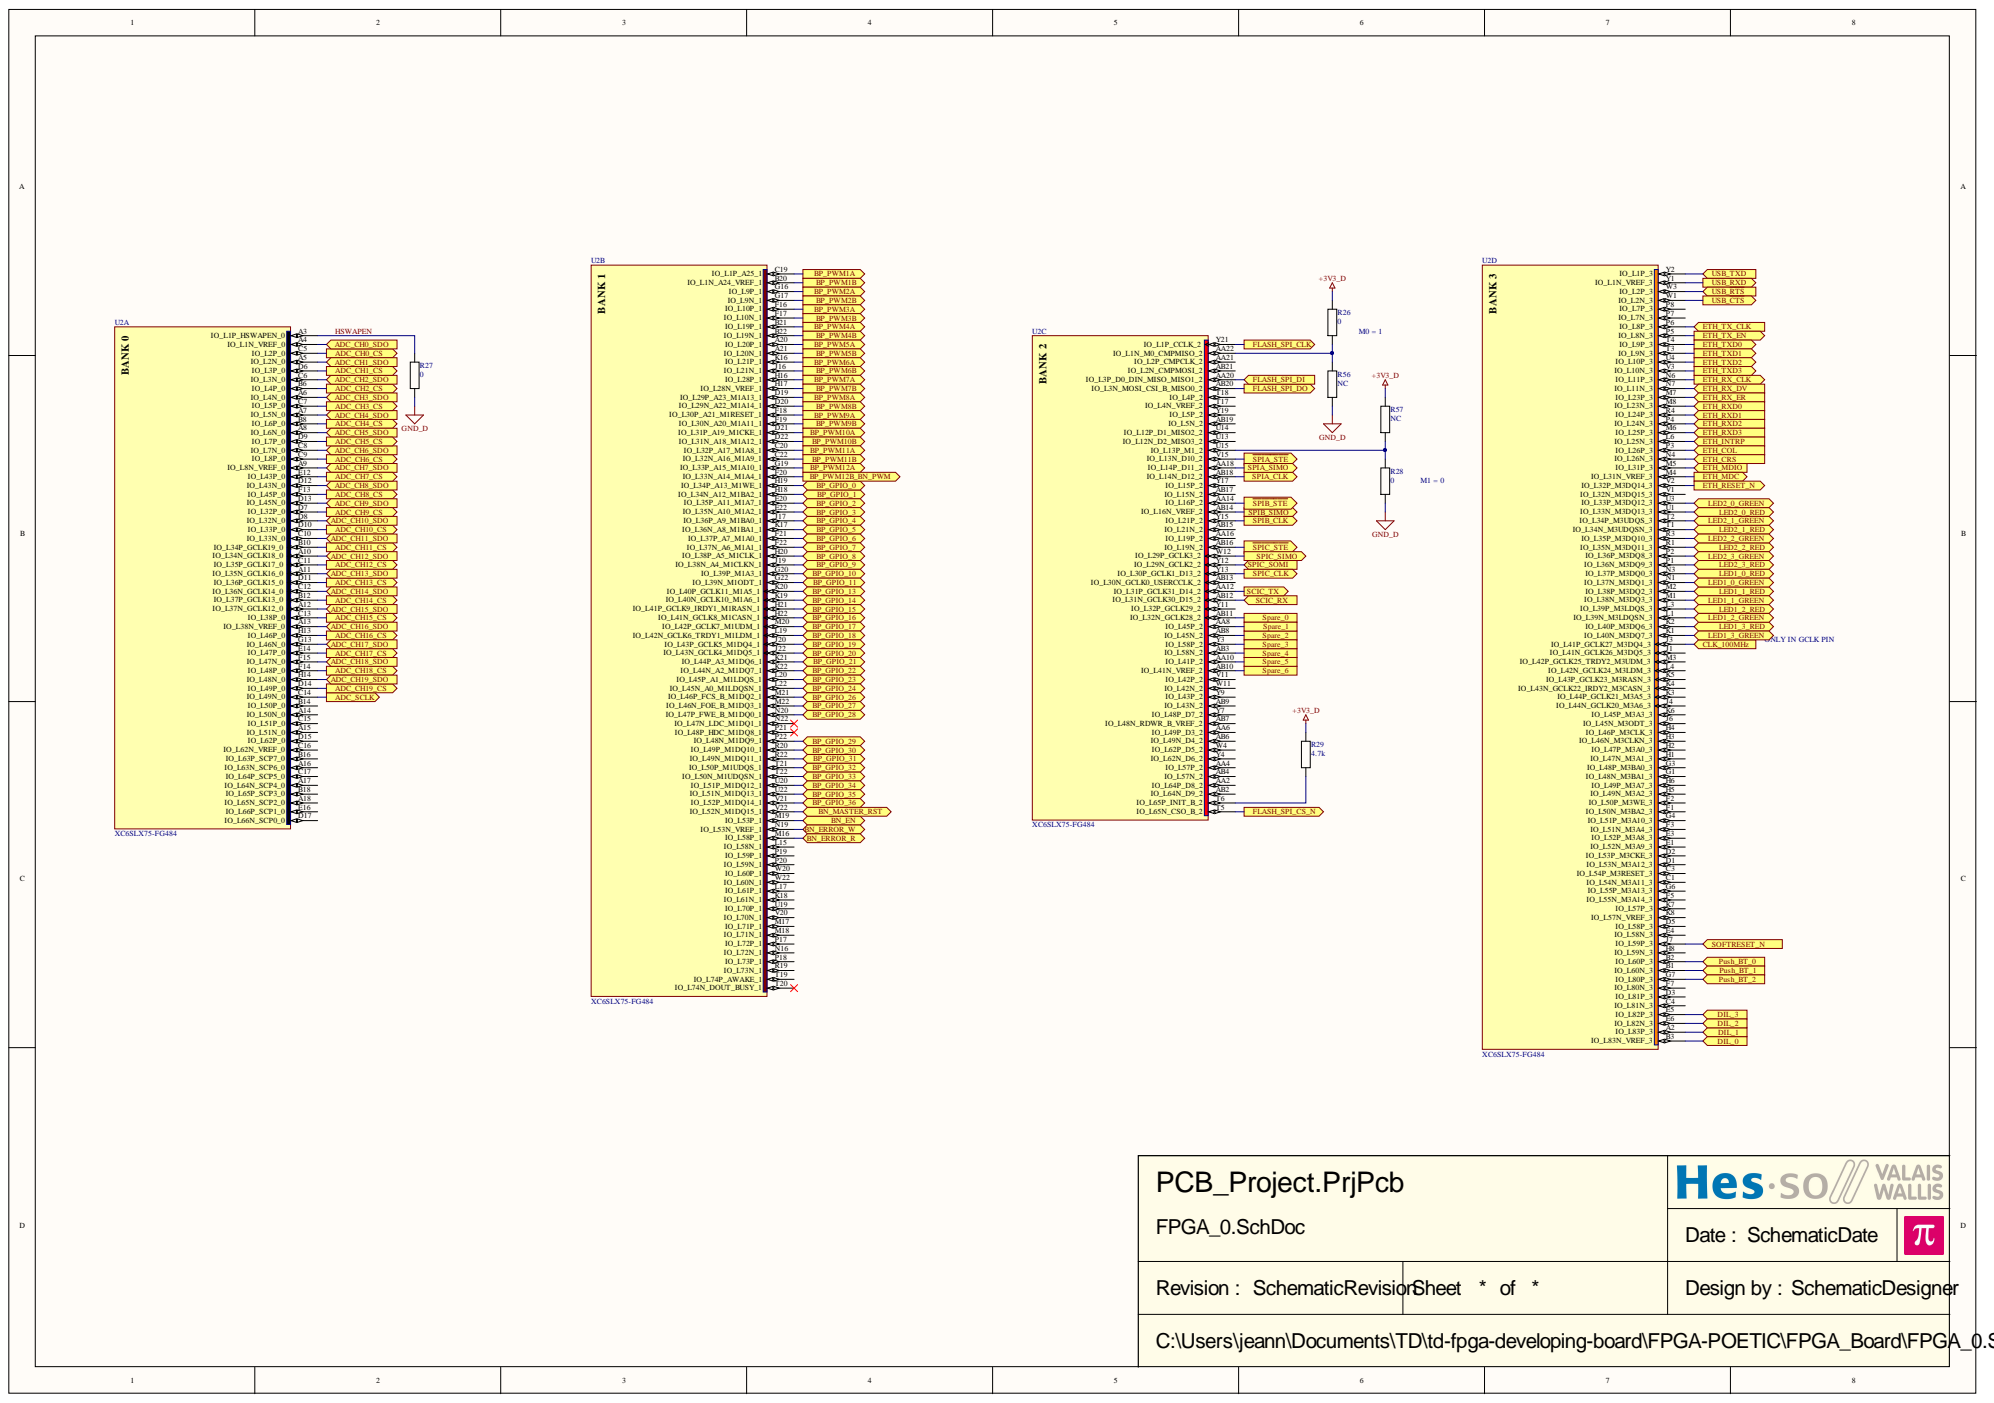
[picture p145: page 3]

PCB_Pr o j ect.PrjPcb F P G A_ 0.Sch D o c

D ate : Sch e m aticD ate

R ev isi o n : Sch e m aticR ev isi o | nS h e et * of * | D esi g n b y : Sch e m aticD esi g n e

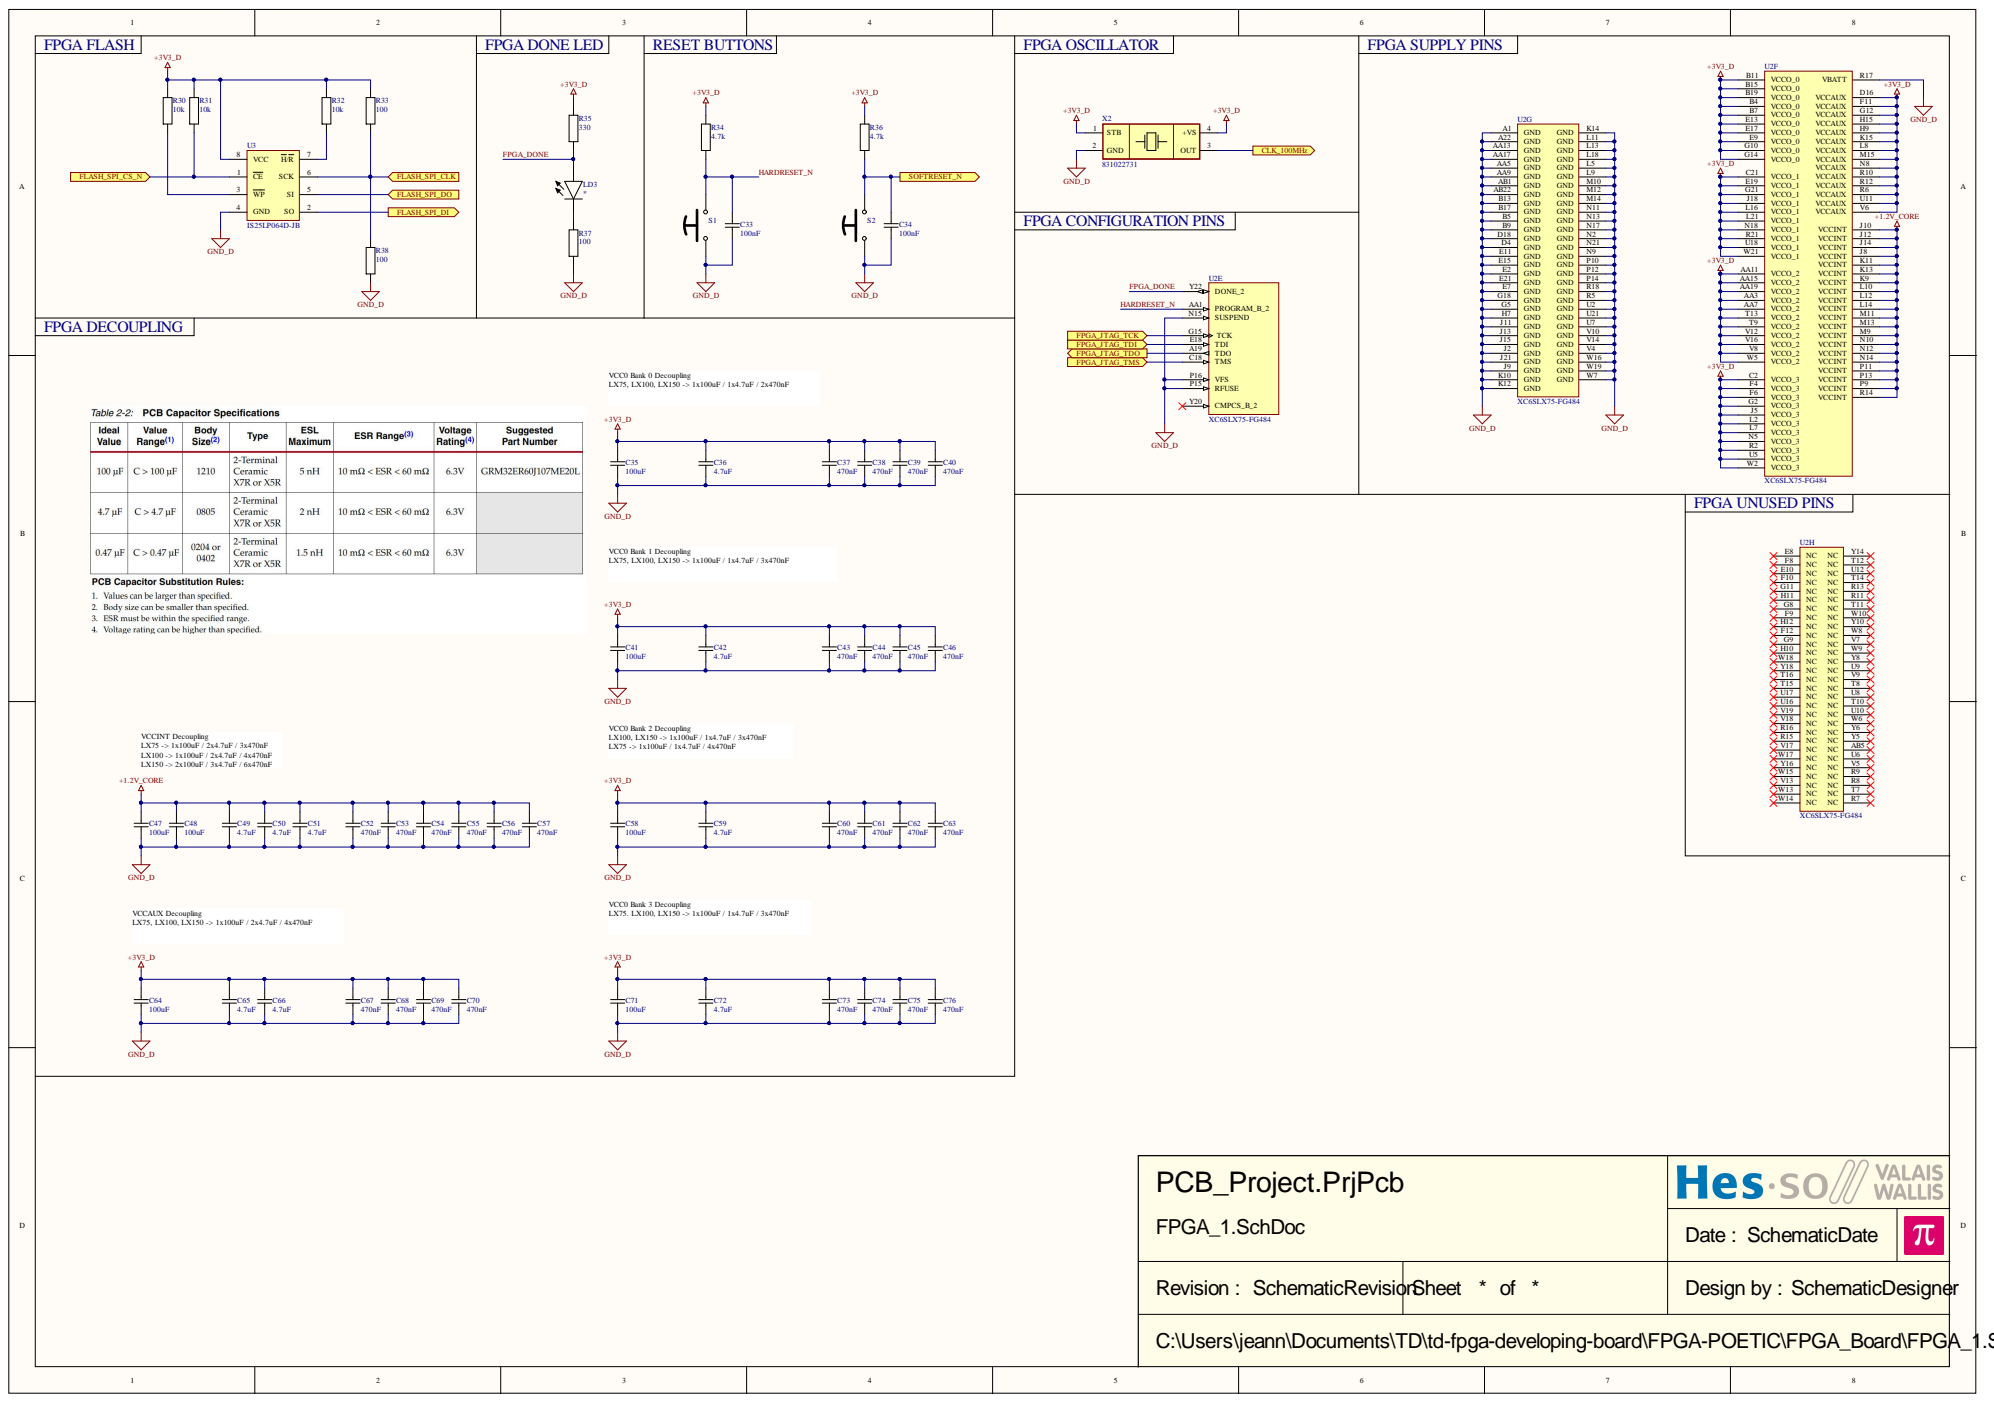
[picture p146: page 4]

FPGA FLASH | FPGA DONE LED | RESET BUTTONS | FPGA OSCILLATOR | +3V3_D | FPGA SUPPLY PINS

LD3 * | | +3V3_D X2 GND_D SOFTRESET_N

PCB_Project.PrjPcb FPGA_1.SchDoc

Date : SchematicDate

Revision : SchematicRevisionSheet * of * | Design by :

C:\Users\jeann\Documents\TD\td-fpga-developing-board\FPGA-POETIC\FPGA_Board\FPGA_1.SchDoc

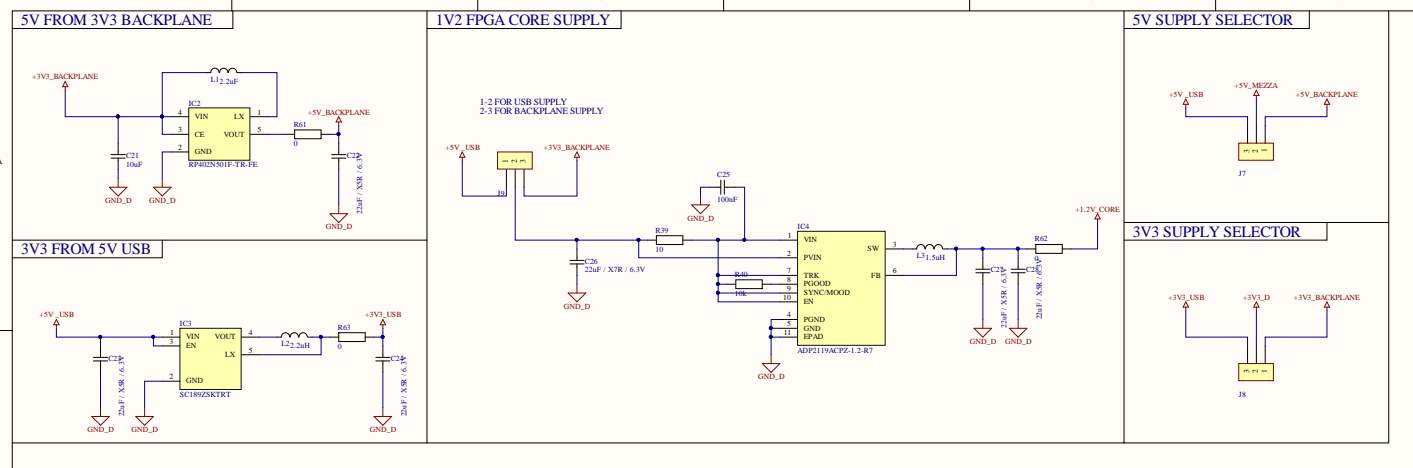
[picture p147: page 5]

+ 5 V _ US B GND _ D GND | 7

PCB_Pr o j ect.PrjPcb S u p p l y_ 0.Sch D o c

D ate : Sch e m aticD ate

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

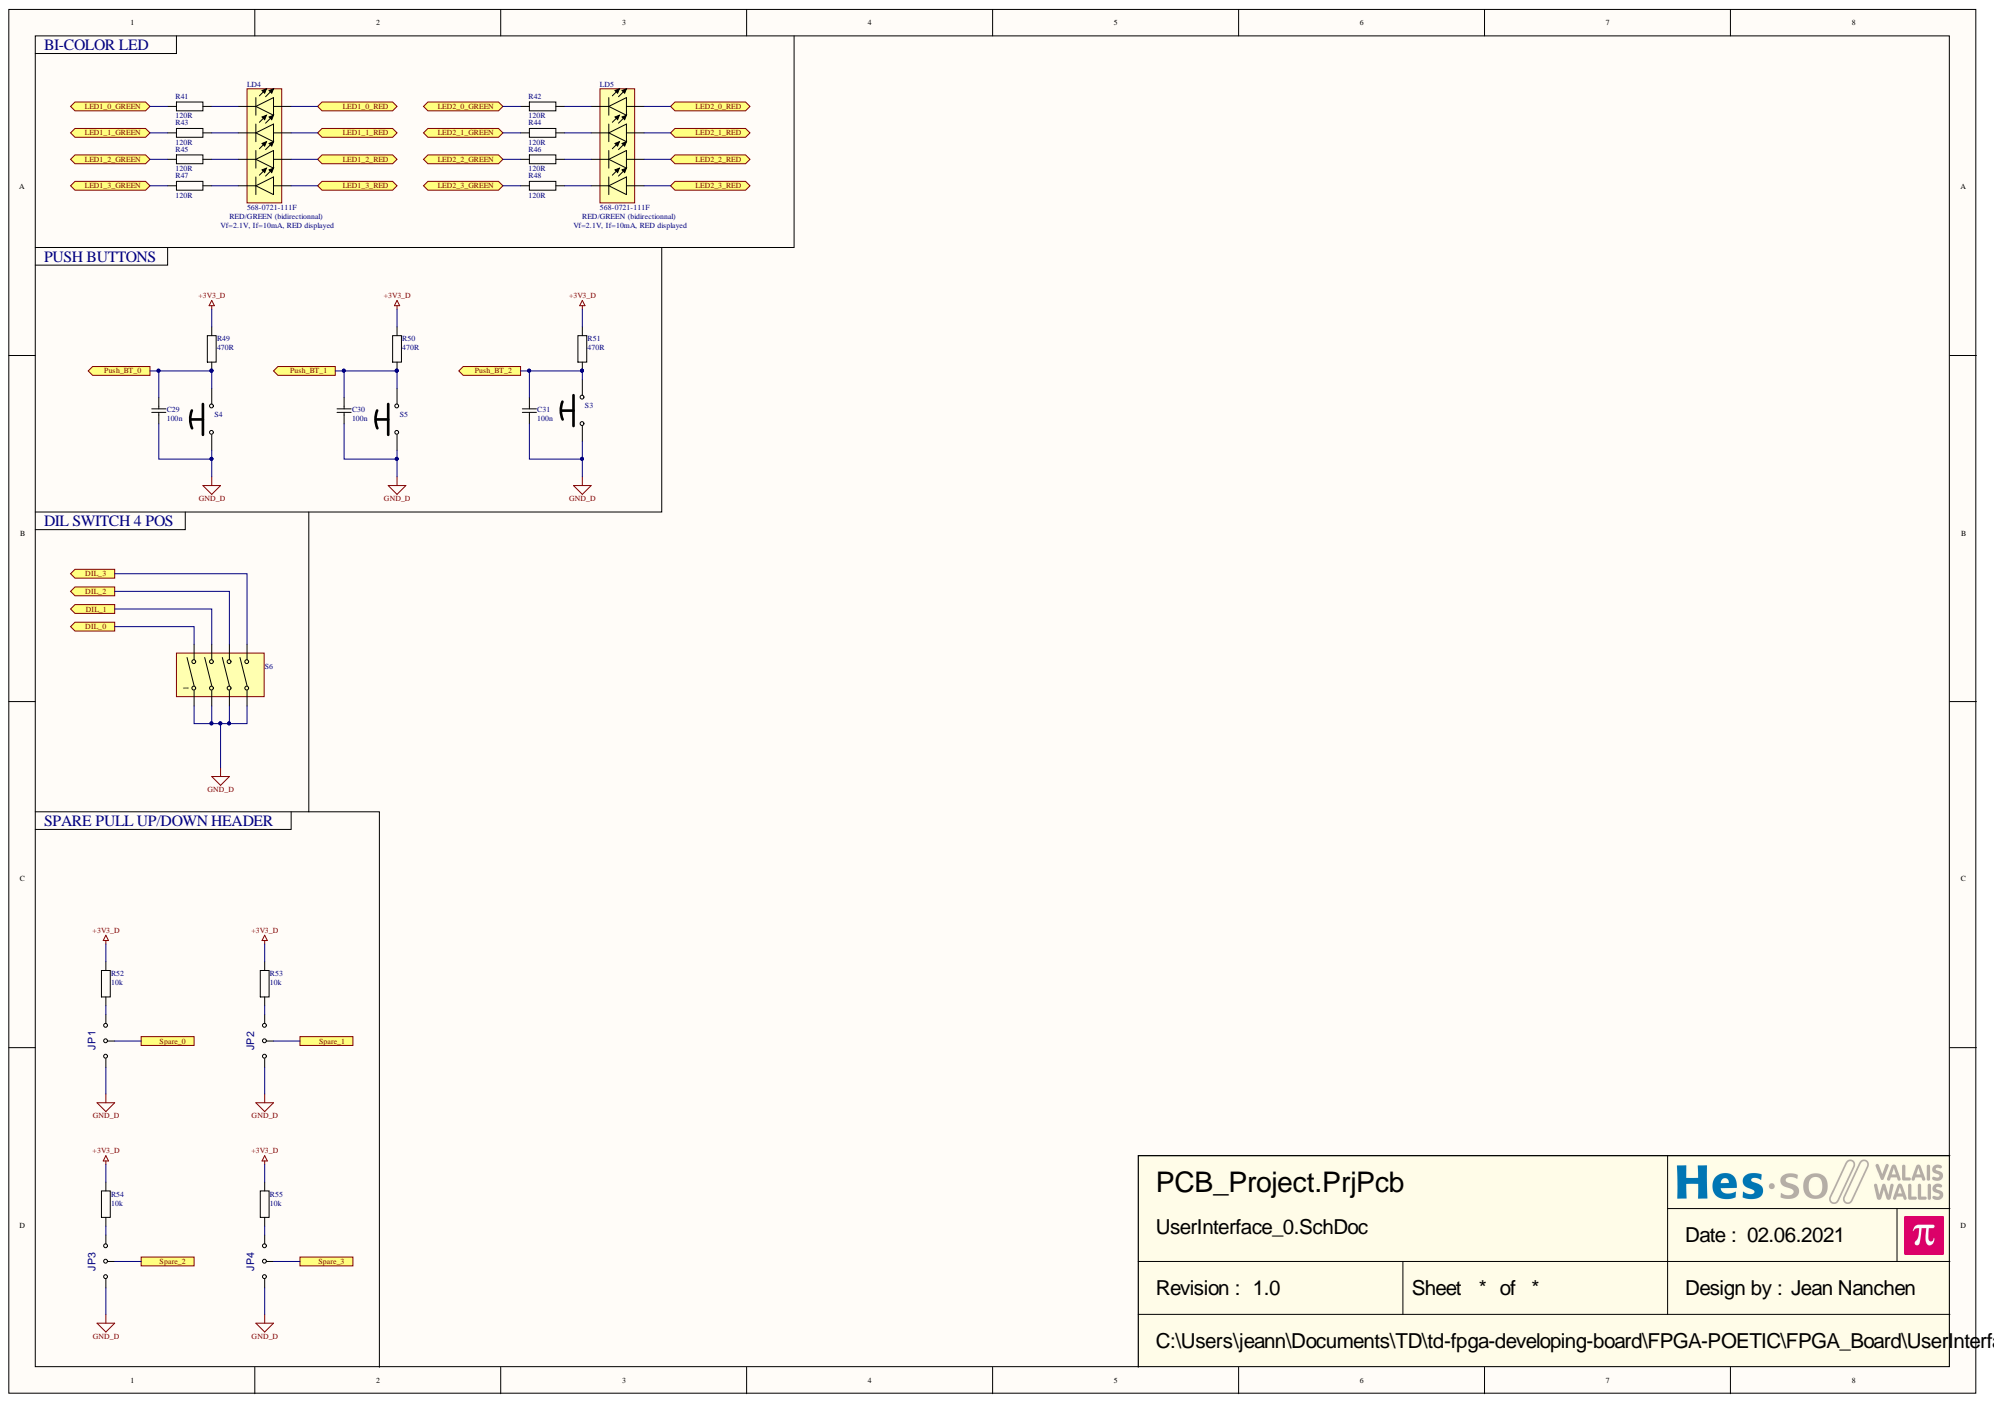
[picture p148: page 6]

RED/GREEN (bidirectionnal)
Vf=2.1V, If=10mA, RED displayed

SPARE PULL UP/DOWN HEADER

PCB_Project.PrjPcb UserInterface_0.SchDoc

Date : 02.06.2021

Revision : 1.0 | Sheet * of * | Design by : Jean Nanchen

C:\Users\jeann\Documents\TD\td-fpga-developing-board\FPGA-POETIC\FPGA_Board\UserInterface_0.SchDoc
