73jn/td-fpga-developing-board/FPGA-POETIC/ToBeDeleted/Mezzanine_Board/MEZZANINE-BOARD.pdf

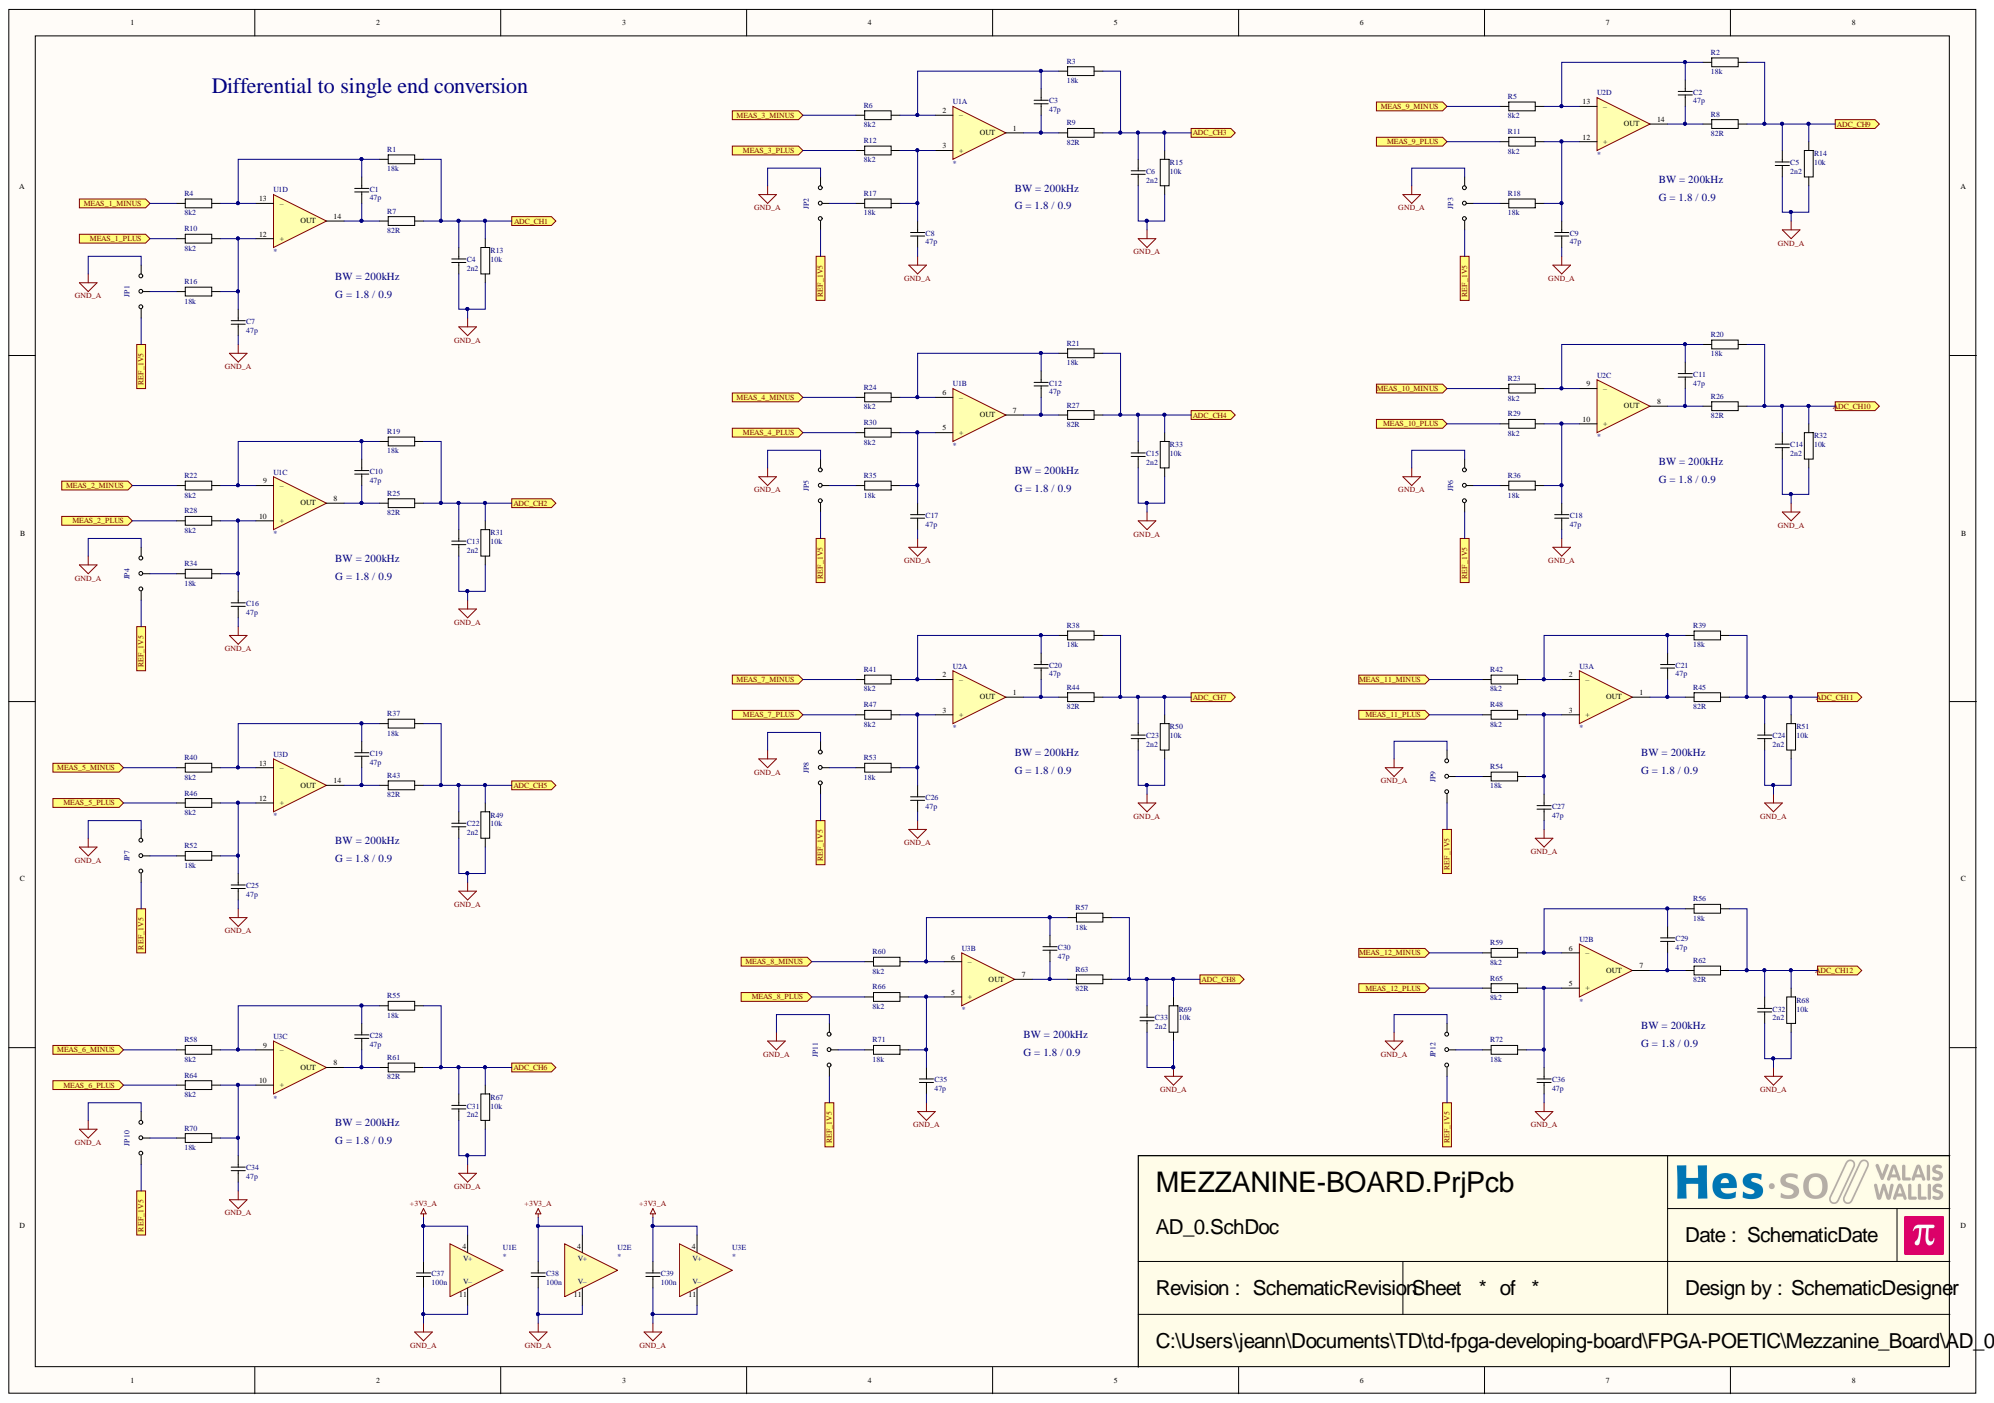
[picture p149: page 1]

MEZZANINE-BOAR D.PrjPcb A D _ 0.Sch D o c

D ate : Sch e m aticD ate

R ev isi o n : Sch e m aticR ev isi o | nS h e et * of * | D esi g n b y : Sch e m aticD esi g n e

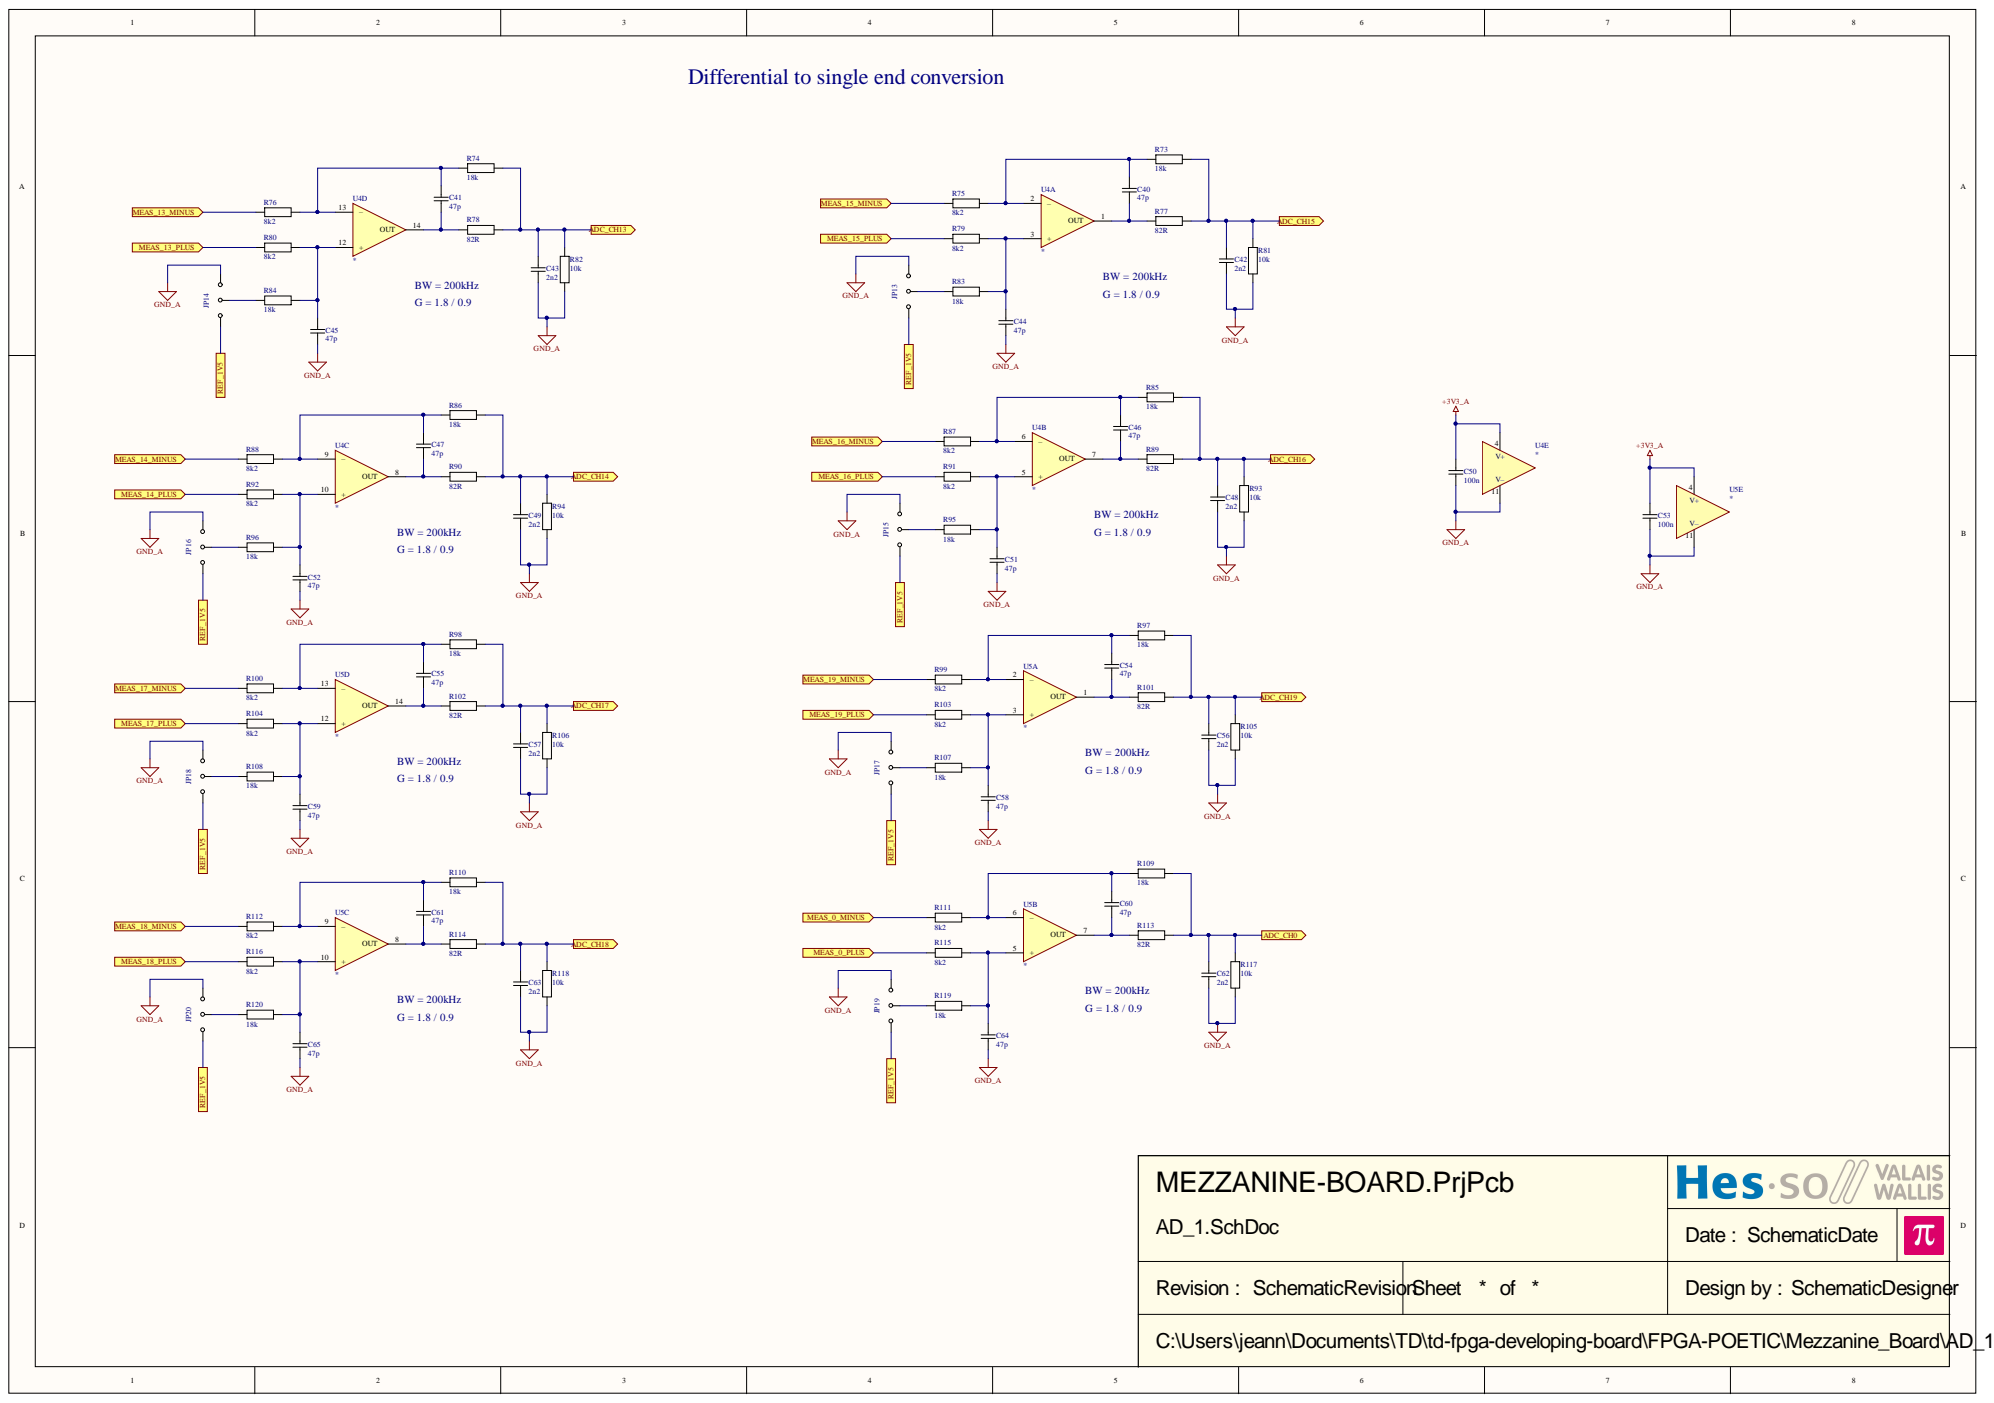
[picture p150: page 2]

MEZZANINE-BOAR D.PrjPcb A D _ 1.Sch D o c

D ate : Sch e m aticD ate

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

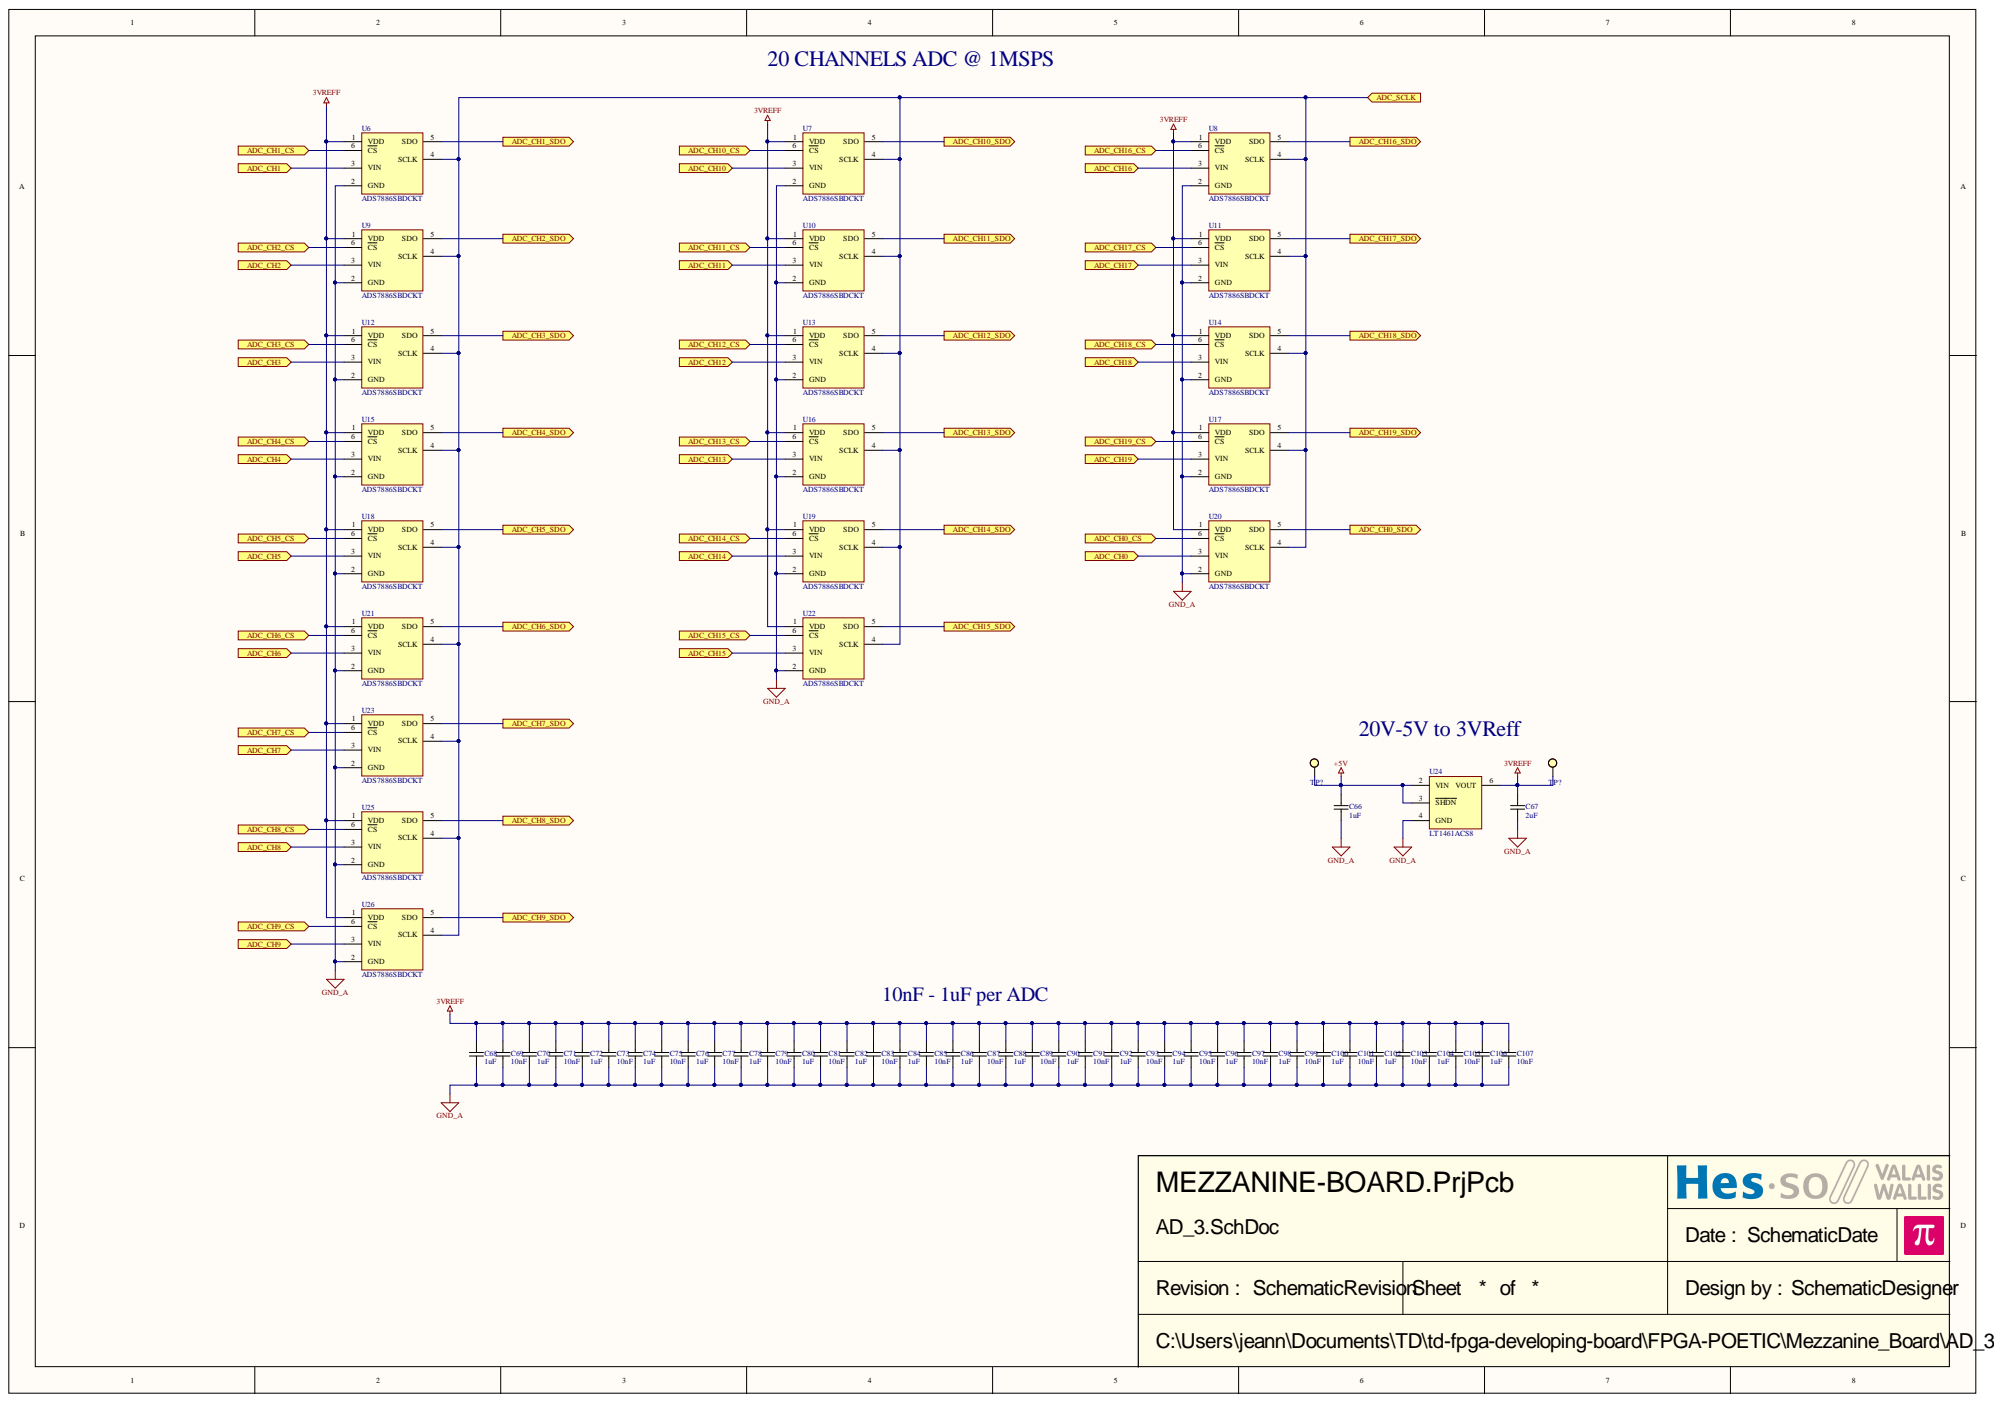
[picture p151: page 3]

VIN 3 GND 2

VIN 3 GND 2 | VIN 3

GND 2

MEZZANINE-BOARD.PrjPcb AD_3.SchDoc

Date : SchematicDate

Revision : SchematicRevisionSheet * of * | Design by :

C:\Users\jeann\Documents\TD\td-fpga-developing-board\FPGA-POETIC\Mezzanine_Board\AD_3.SchDoc

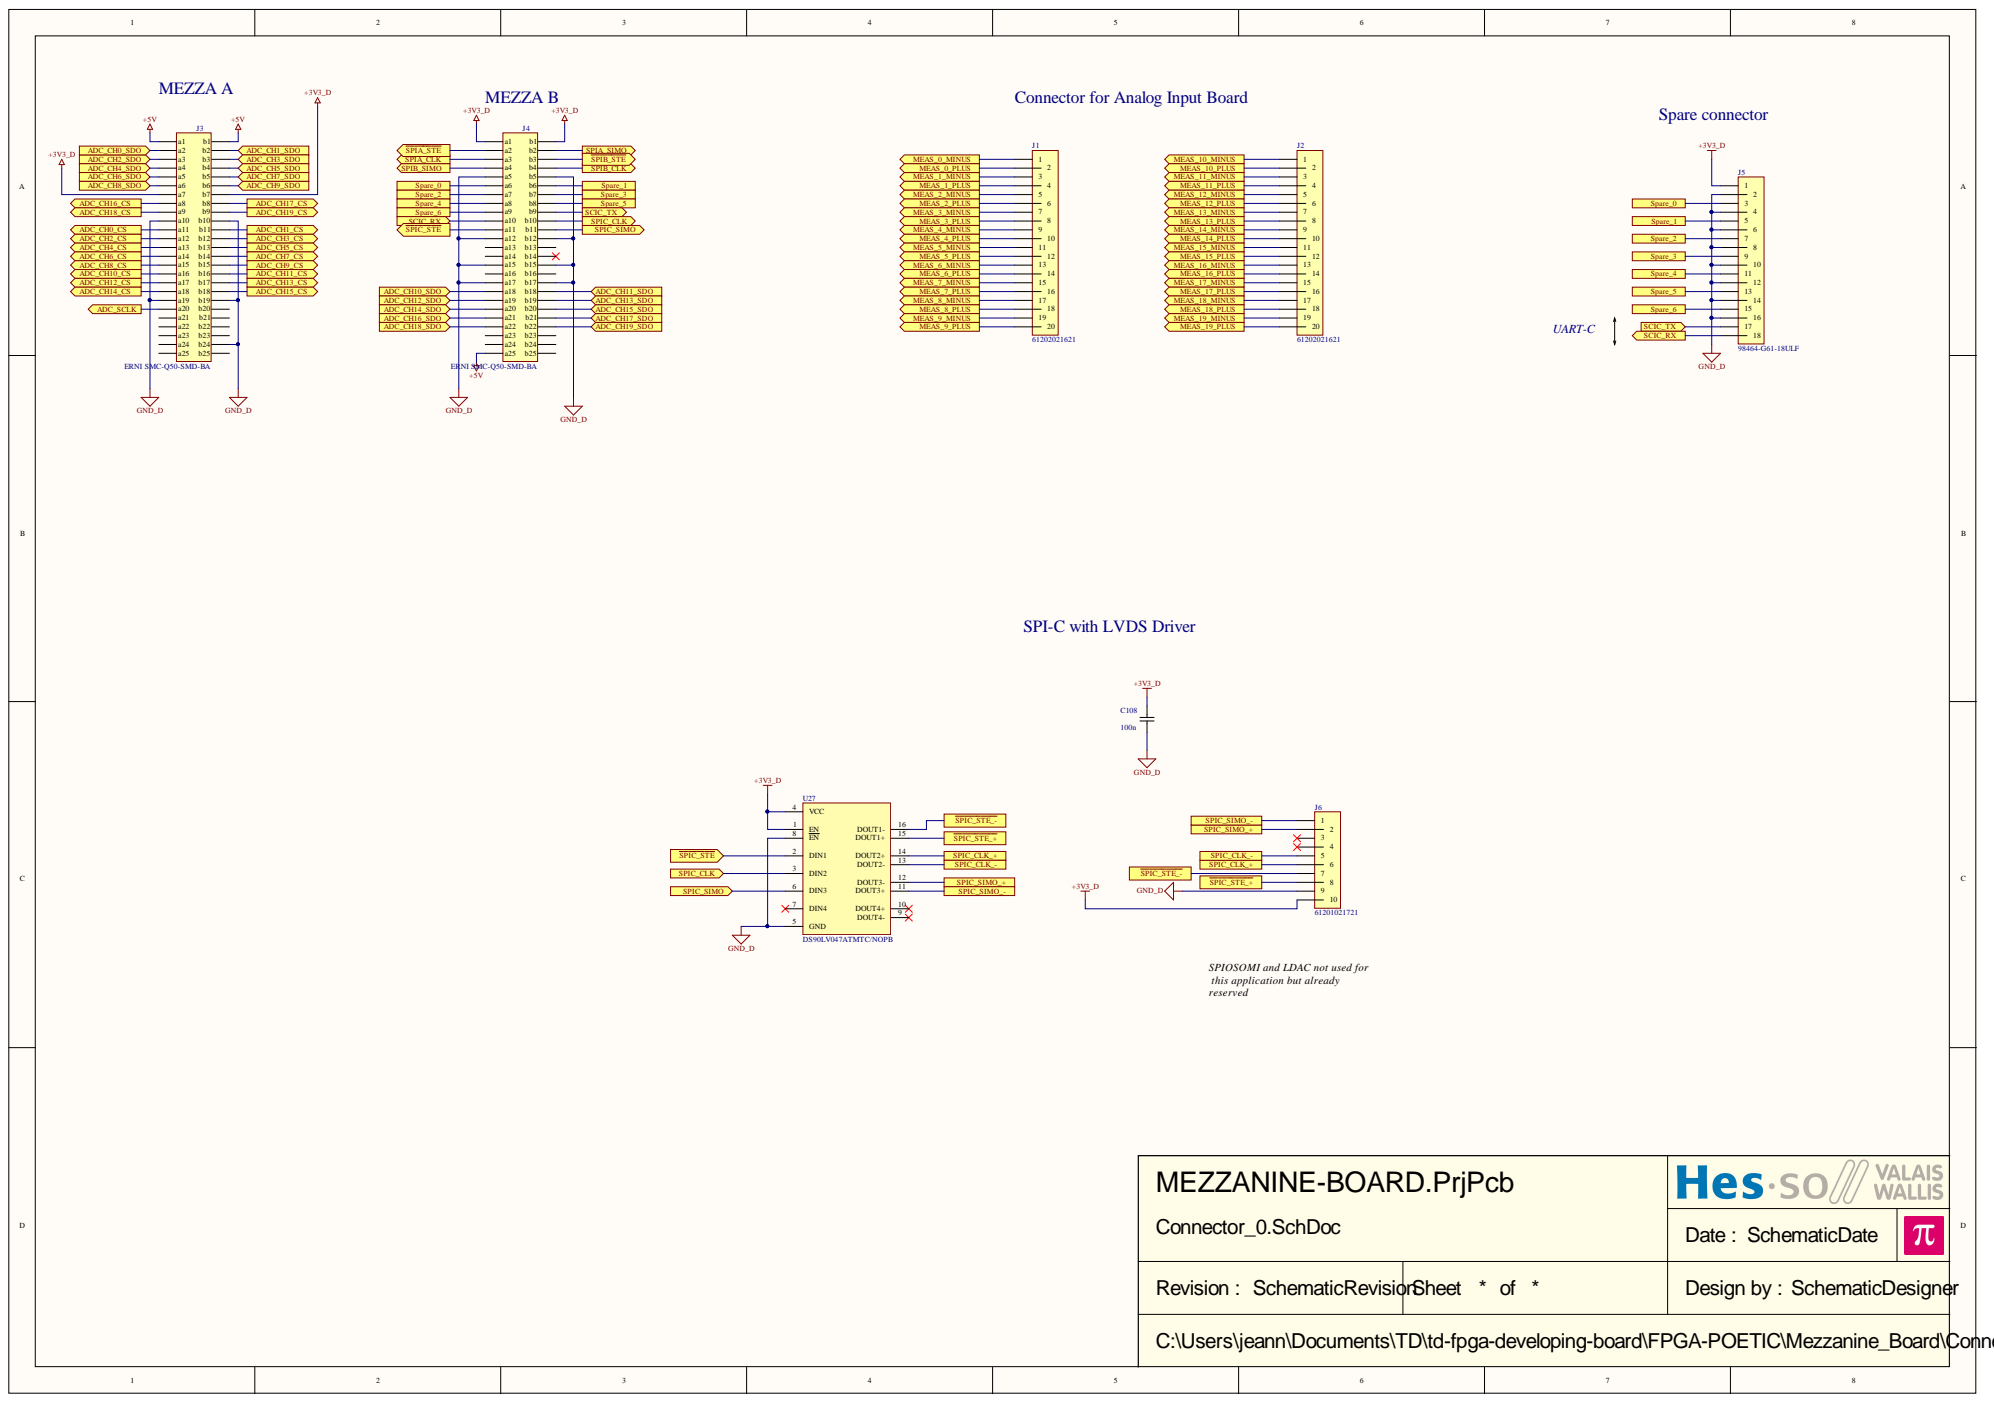
[picture p152: page 4]

Connector for Analog Input Board

ERNI SMC-Q50-SMD-BA

SPI-C with LVDS Driver

SPIOSOMI and LDAC not used for
this application but already
reserved

MEZZANINE-BOARD.PrjPcb Connector_0.SchDoc

Date : SchematicDate

Revision : SchematicRevisionSheet * of * | Design by :

C:\Users\jeann\Documents\TD\td-fpga-developing-board\FPGA-POETIC\Mezzanine_Board\Connector_0.SchDoc

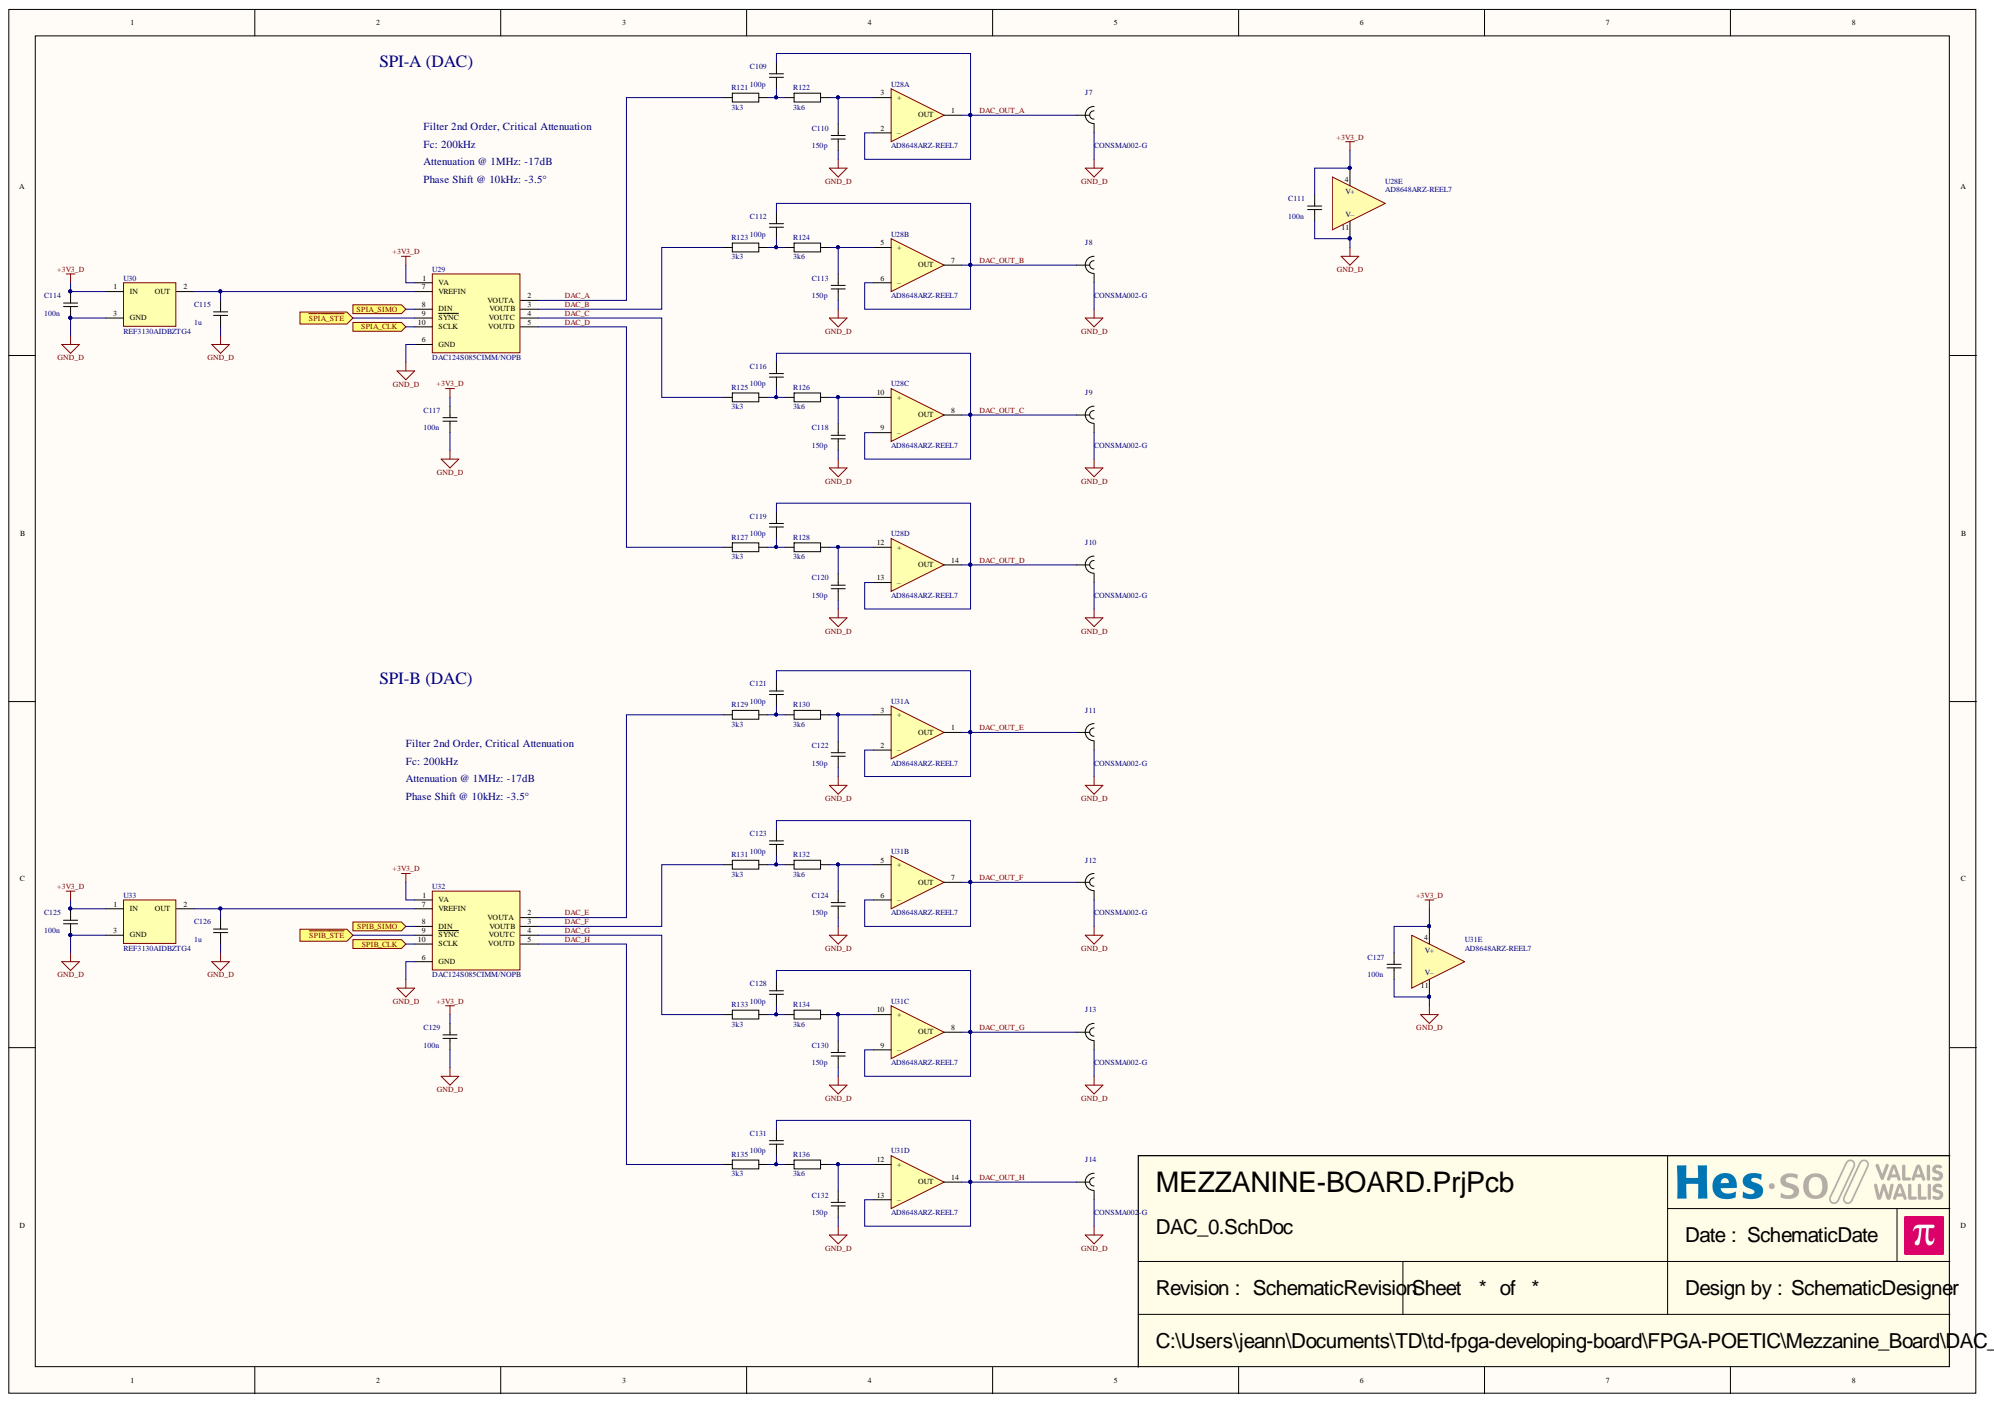
[picture p153: page 5]

MEZZANINE-BOAR D.PrjPcb 2 -G D A C _ 0.Sch D o c

D ate : Sch e m aticD ate

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

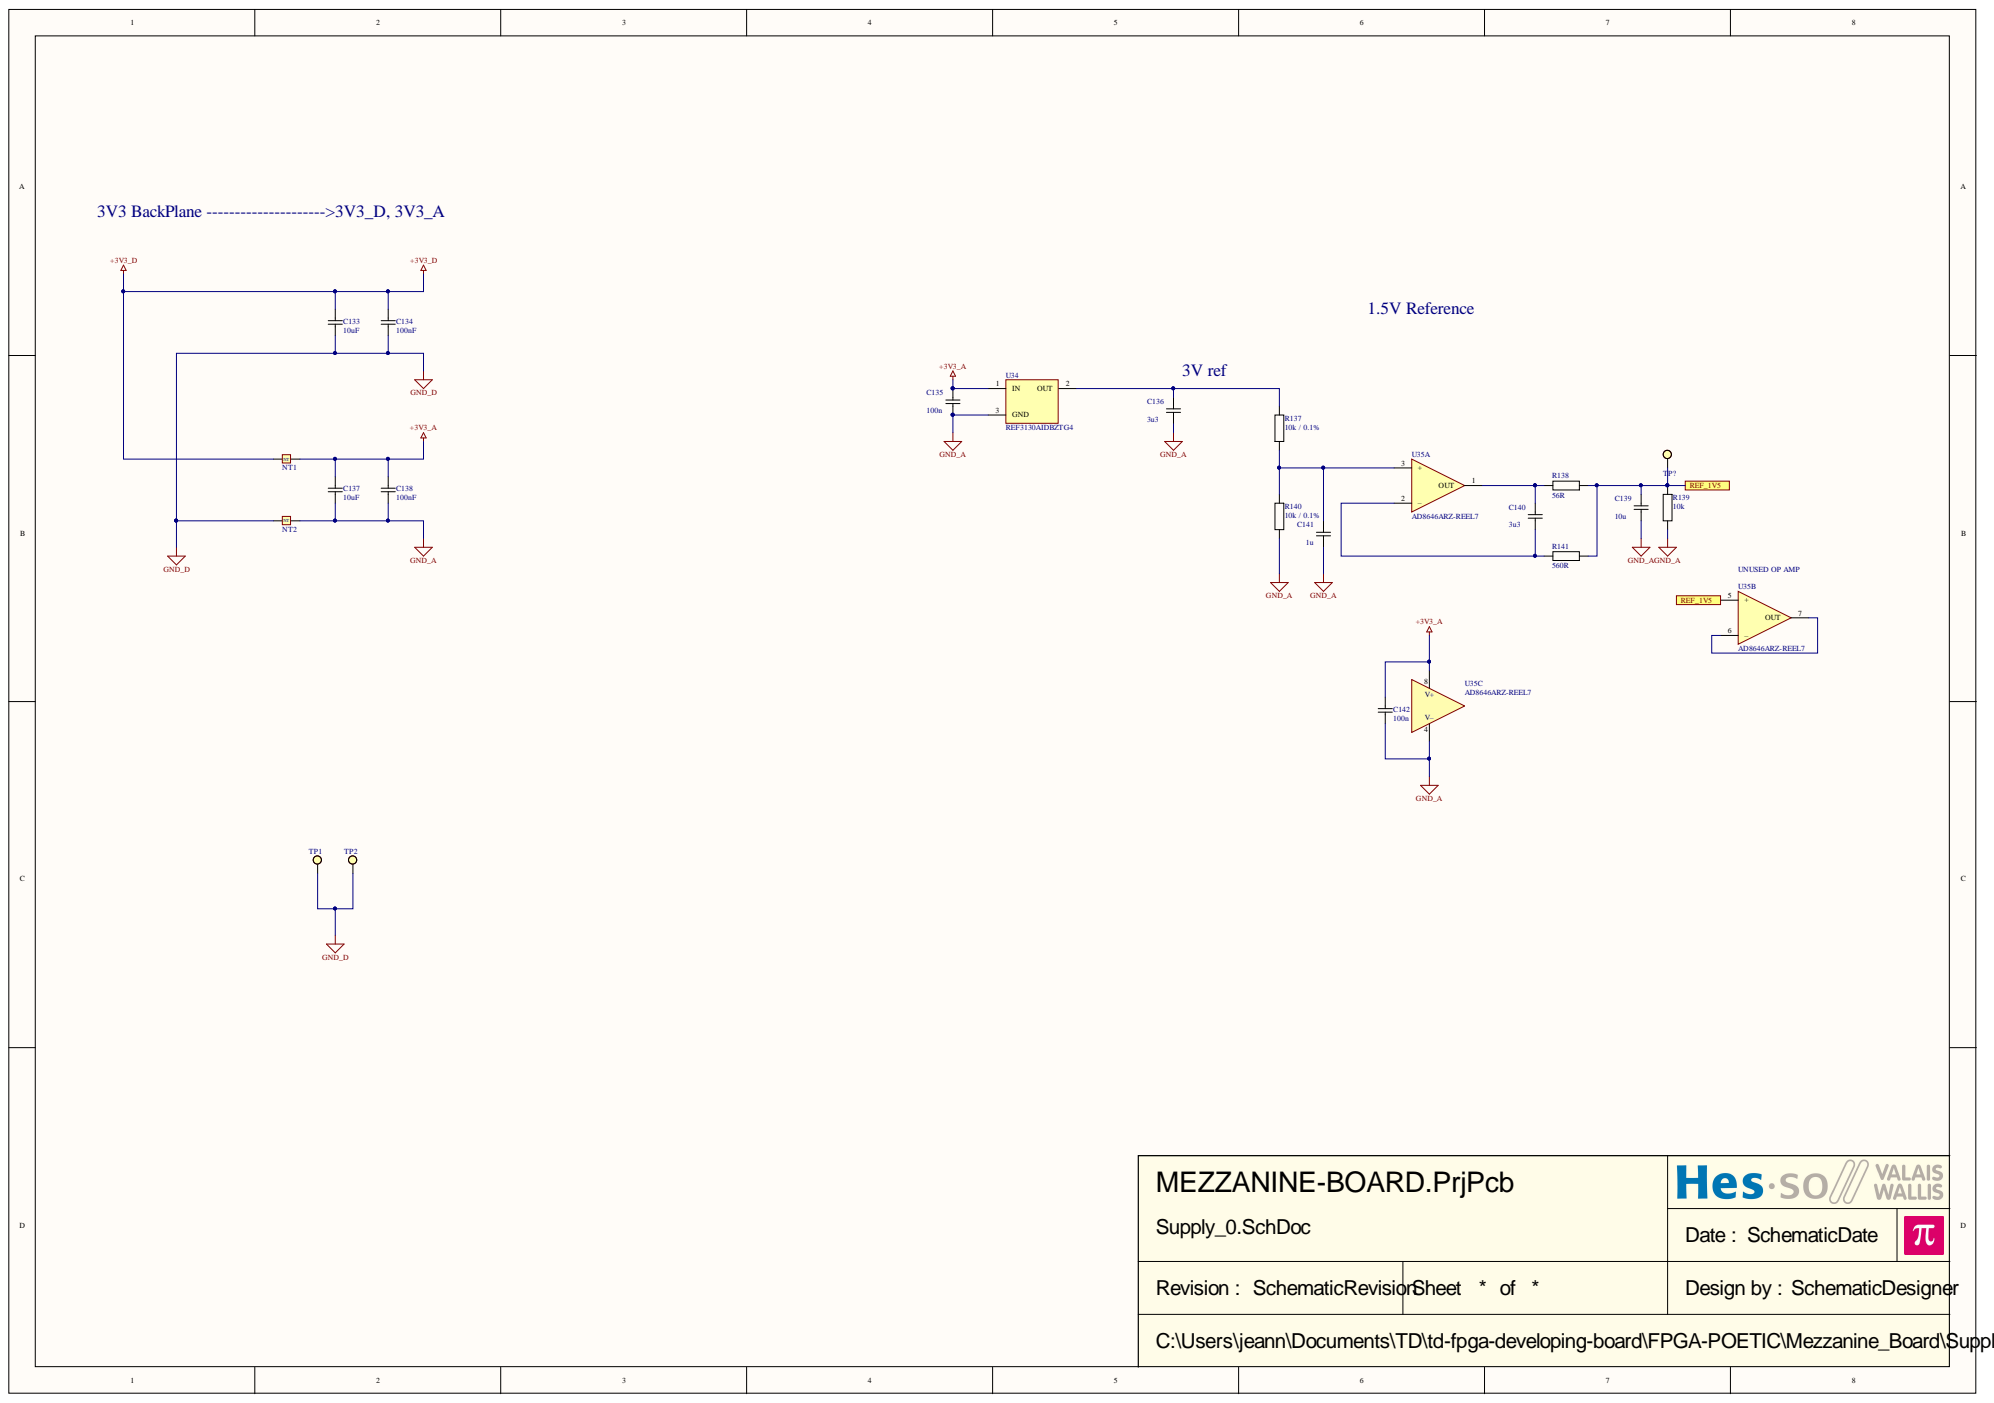
[picture p154: page 6]

MEZZANINE-BOAR D.PrjPcb S u p p l y_ 0.Sch D o c

D ate : Sch e m aticD ate

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
