73jn/td-fpga-developing-board/FPGA-POETIC/ReferenceBoards/FPGA-Rack_v1/04_PCB/FPGARack_v1_0_schematics.pdf

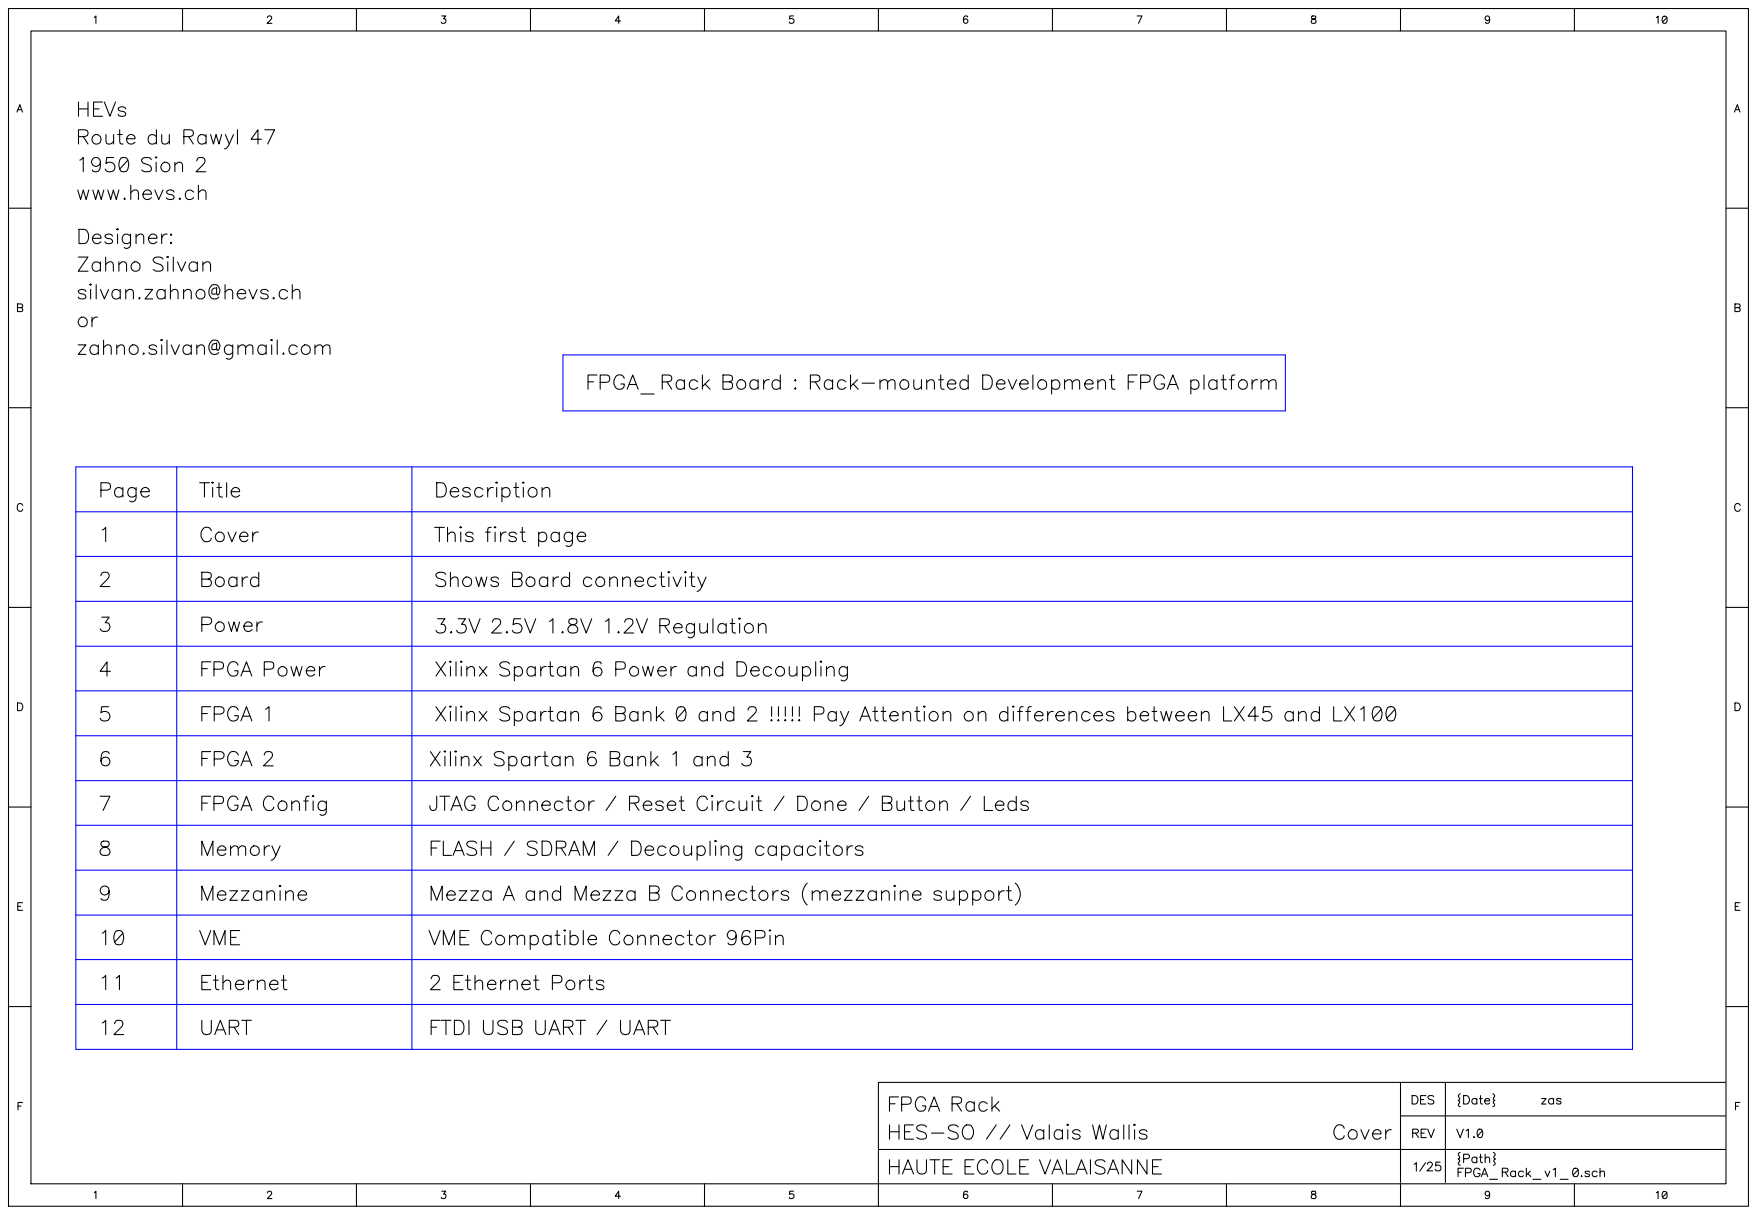
[picture p155: page 1]

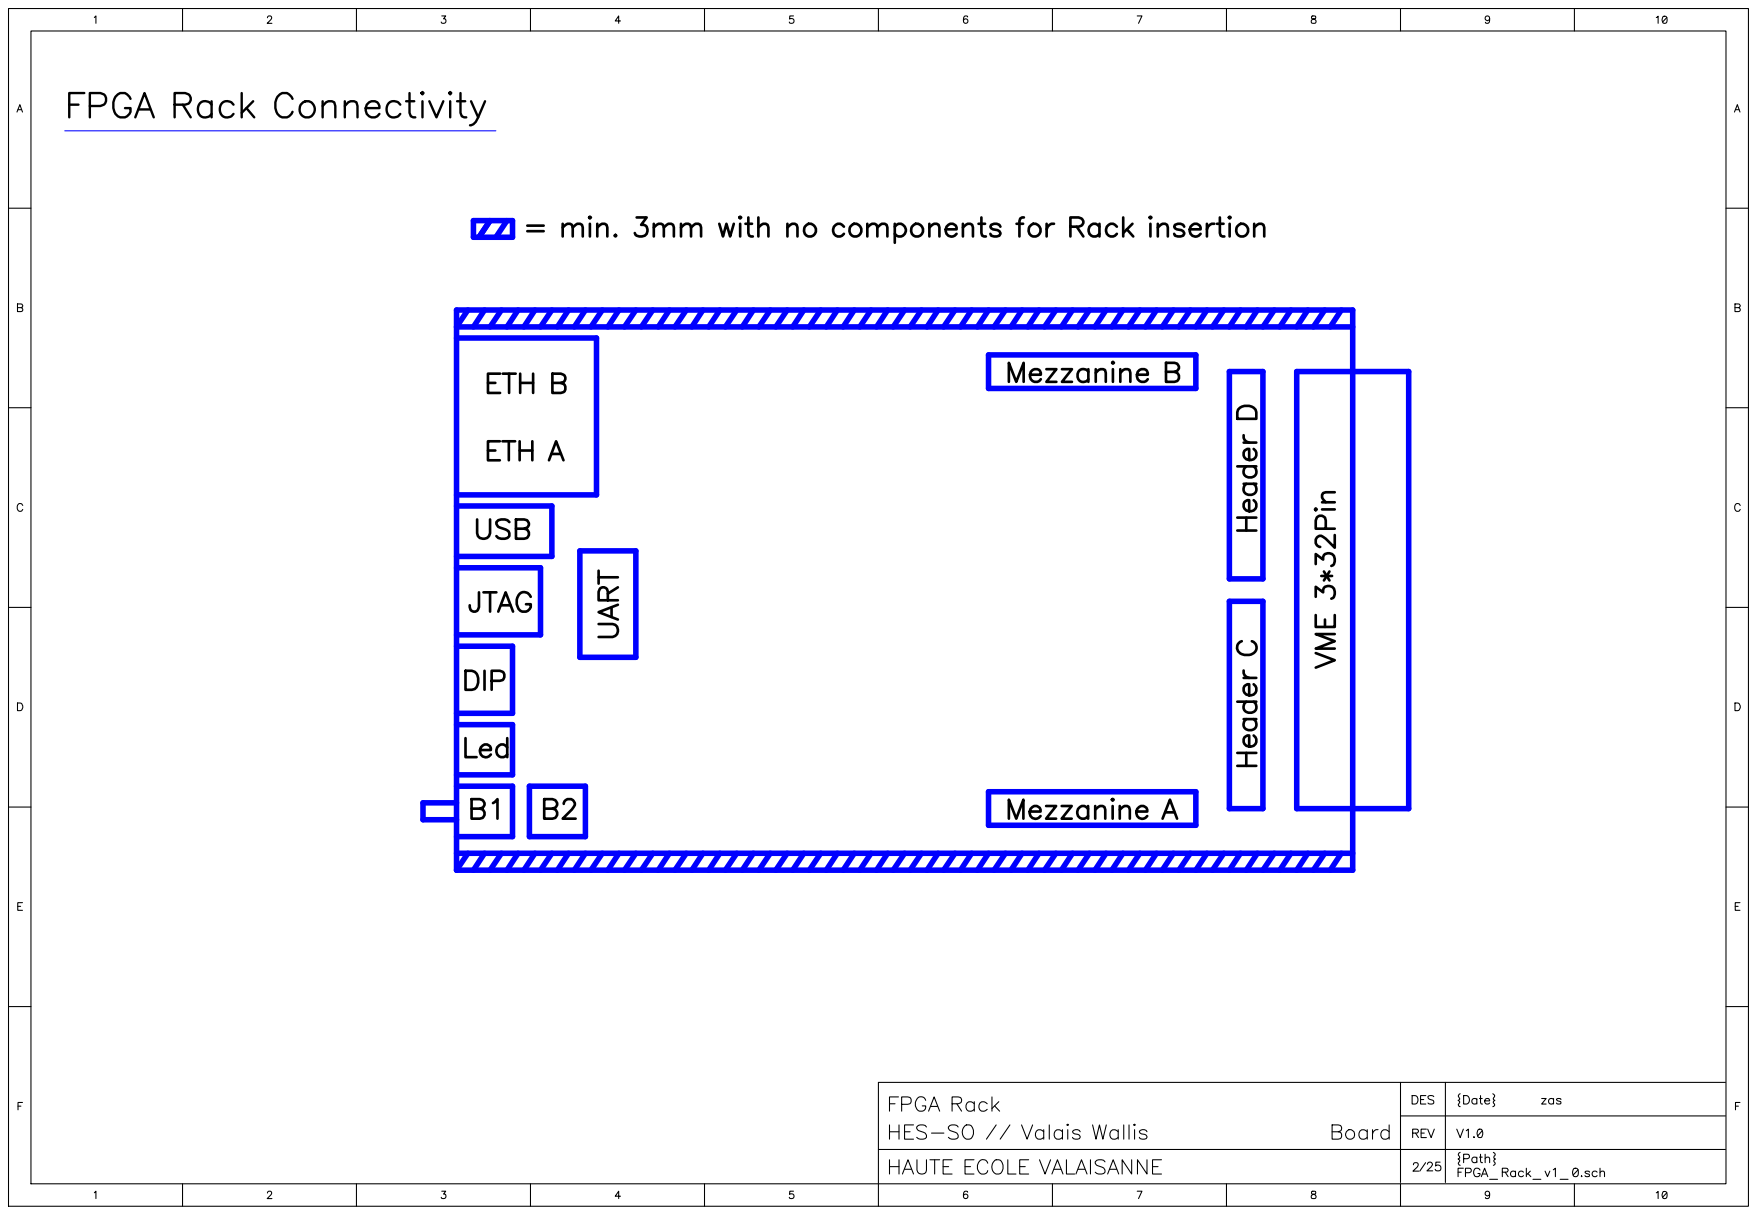
[picture p156: page 2]

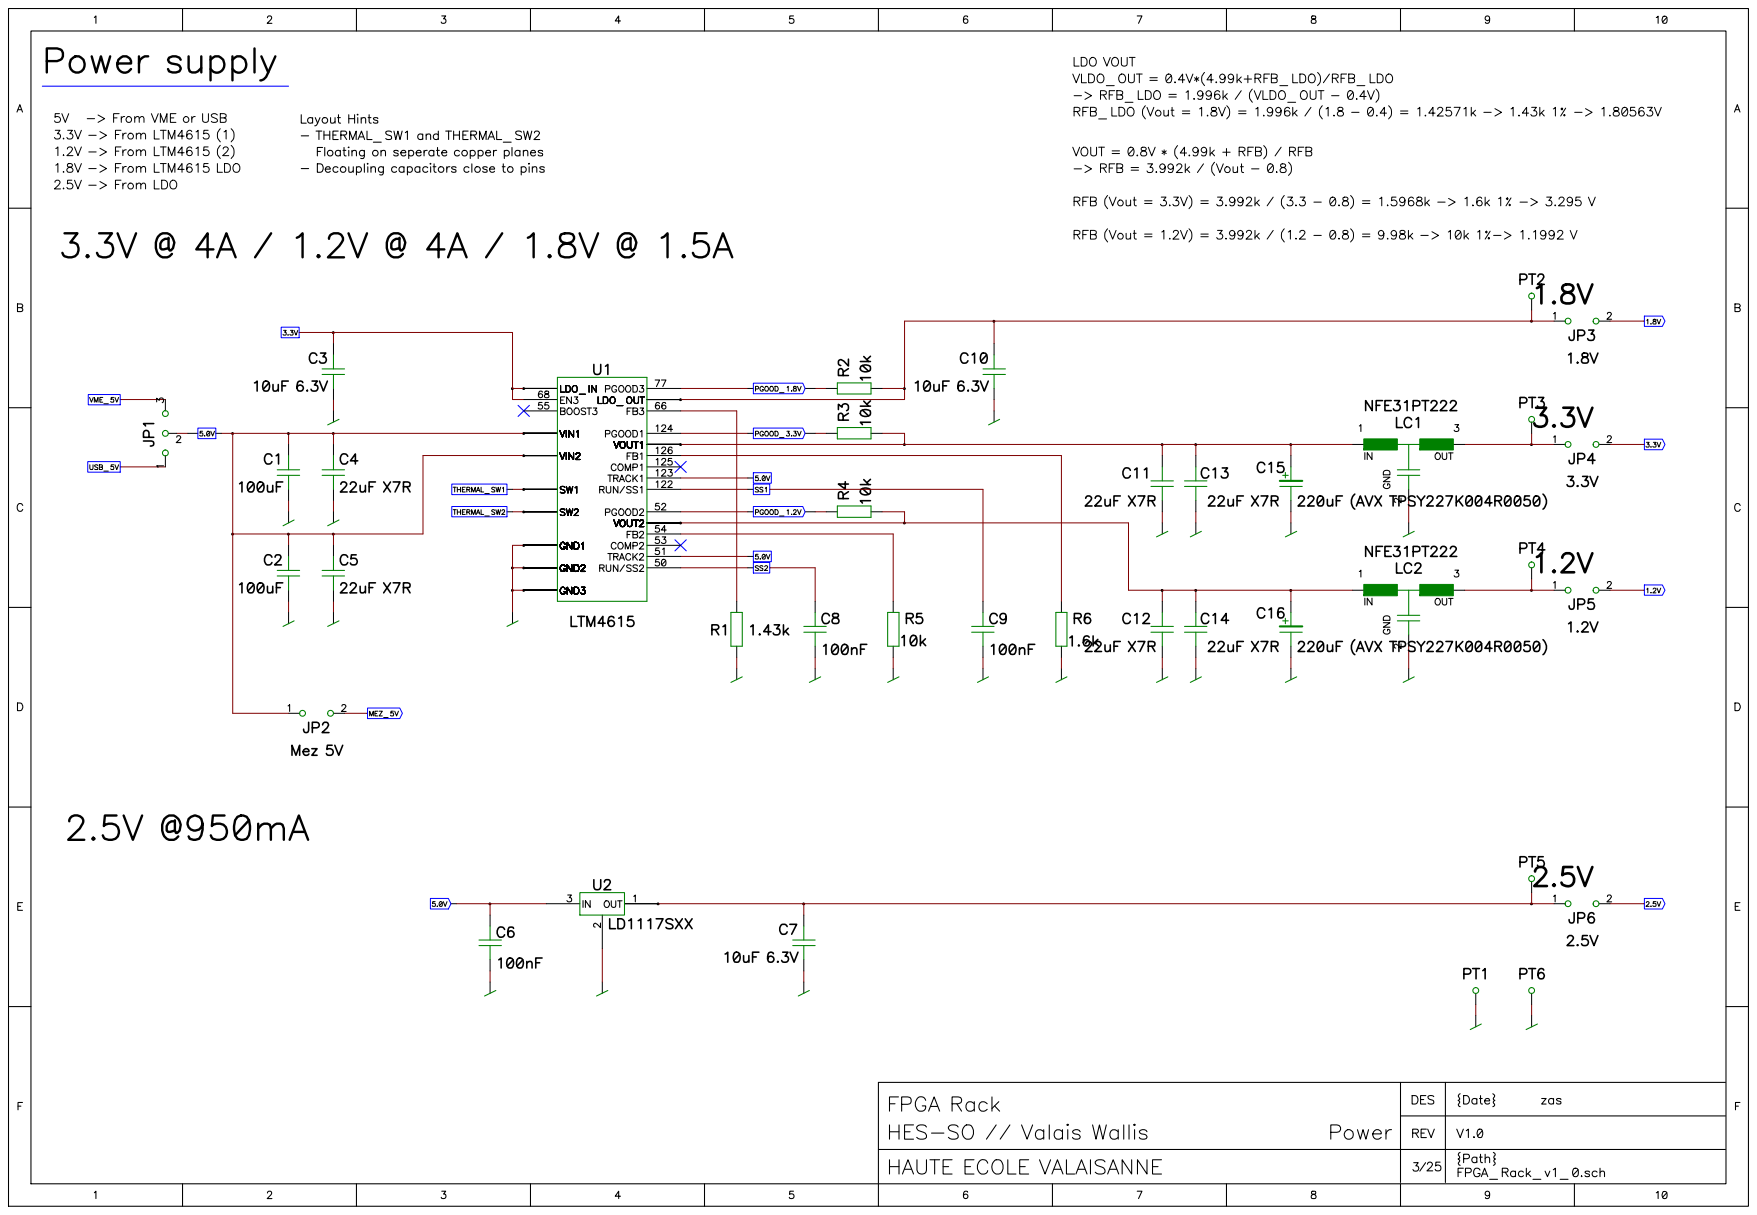
[picture p157: page 3]

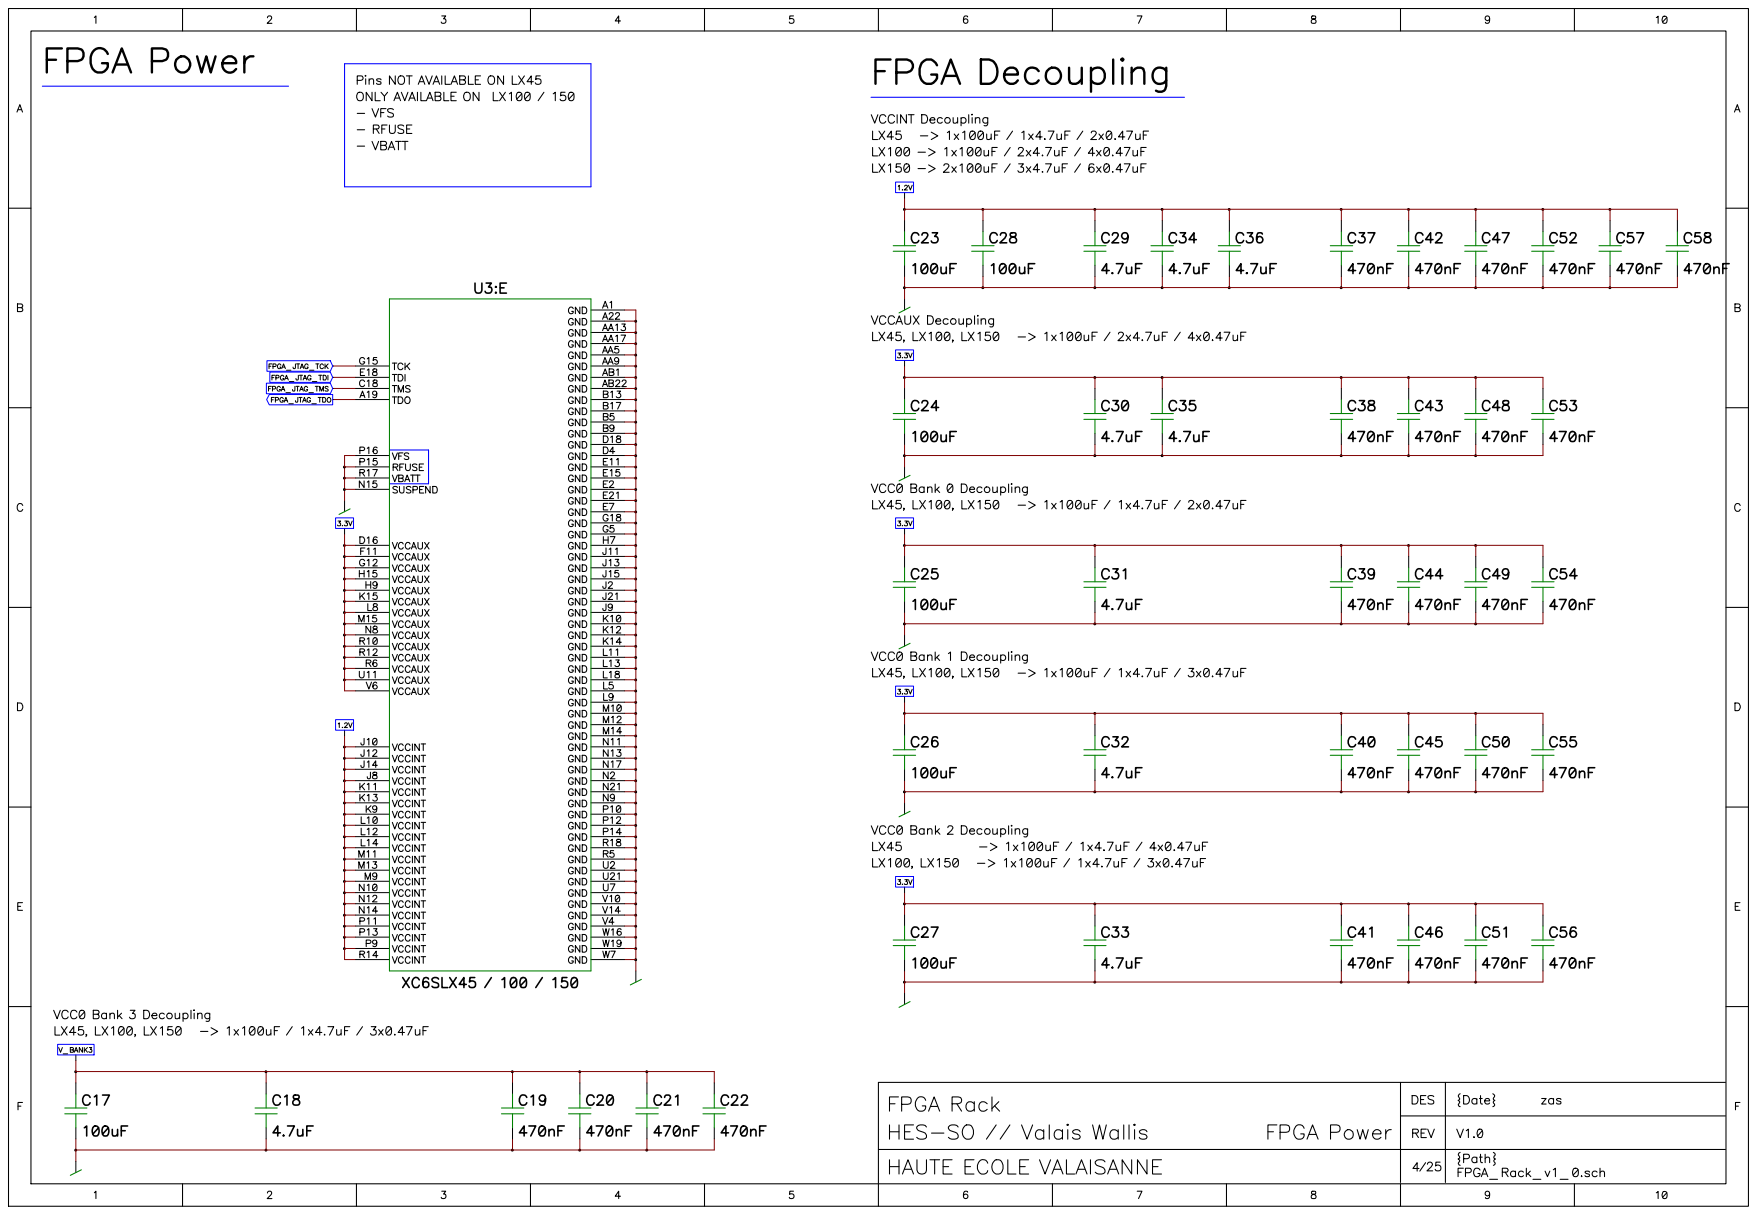
[picture p158: page 4]

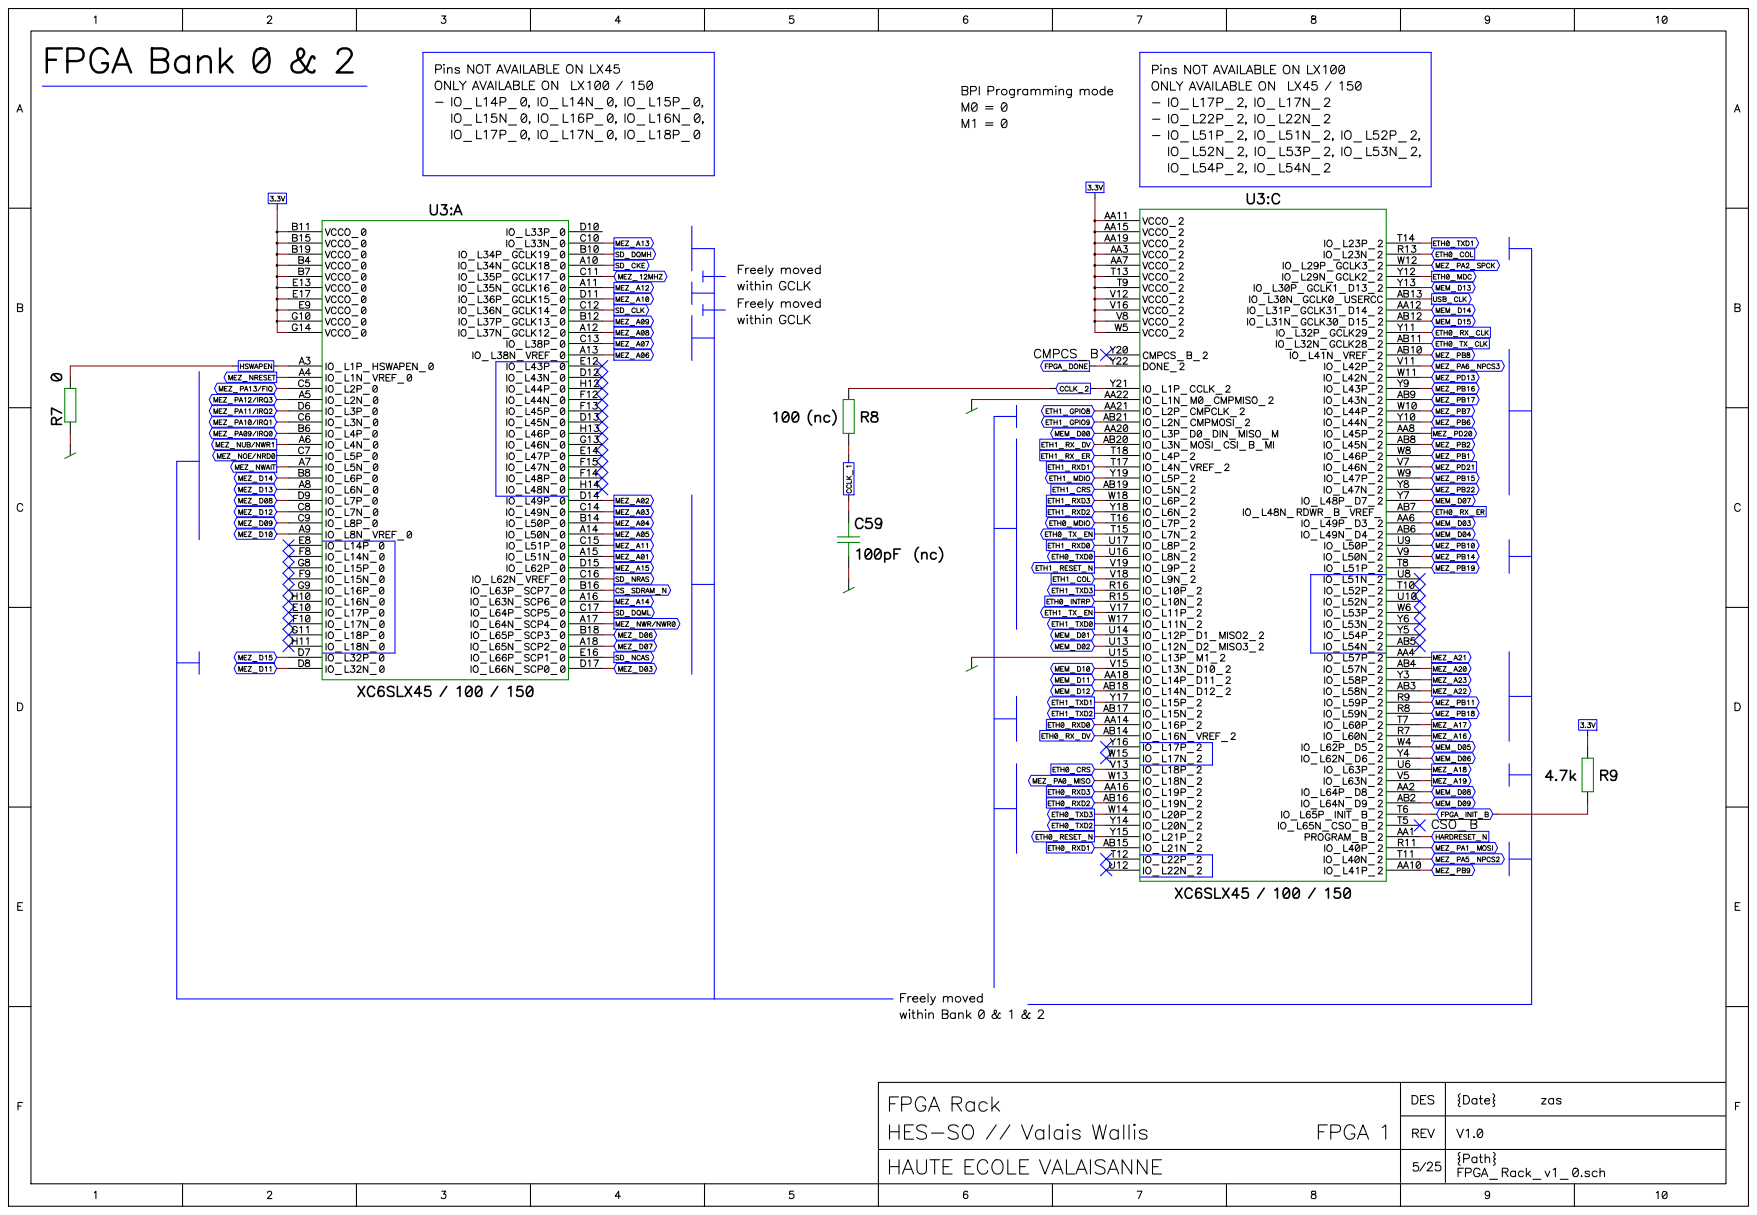
[picture p159: page 5]

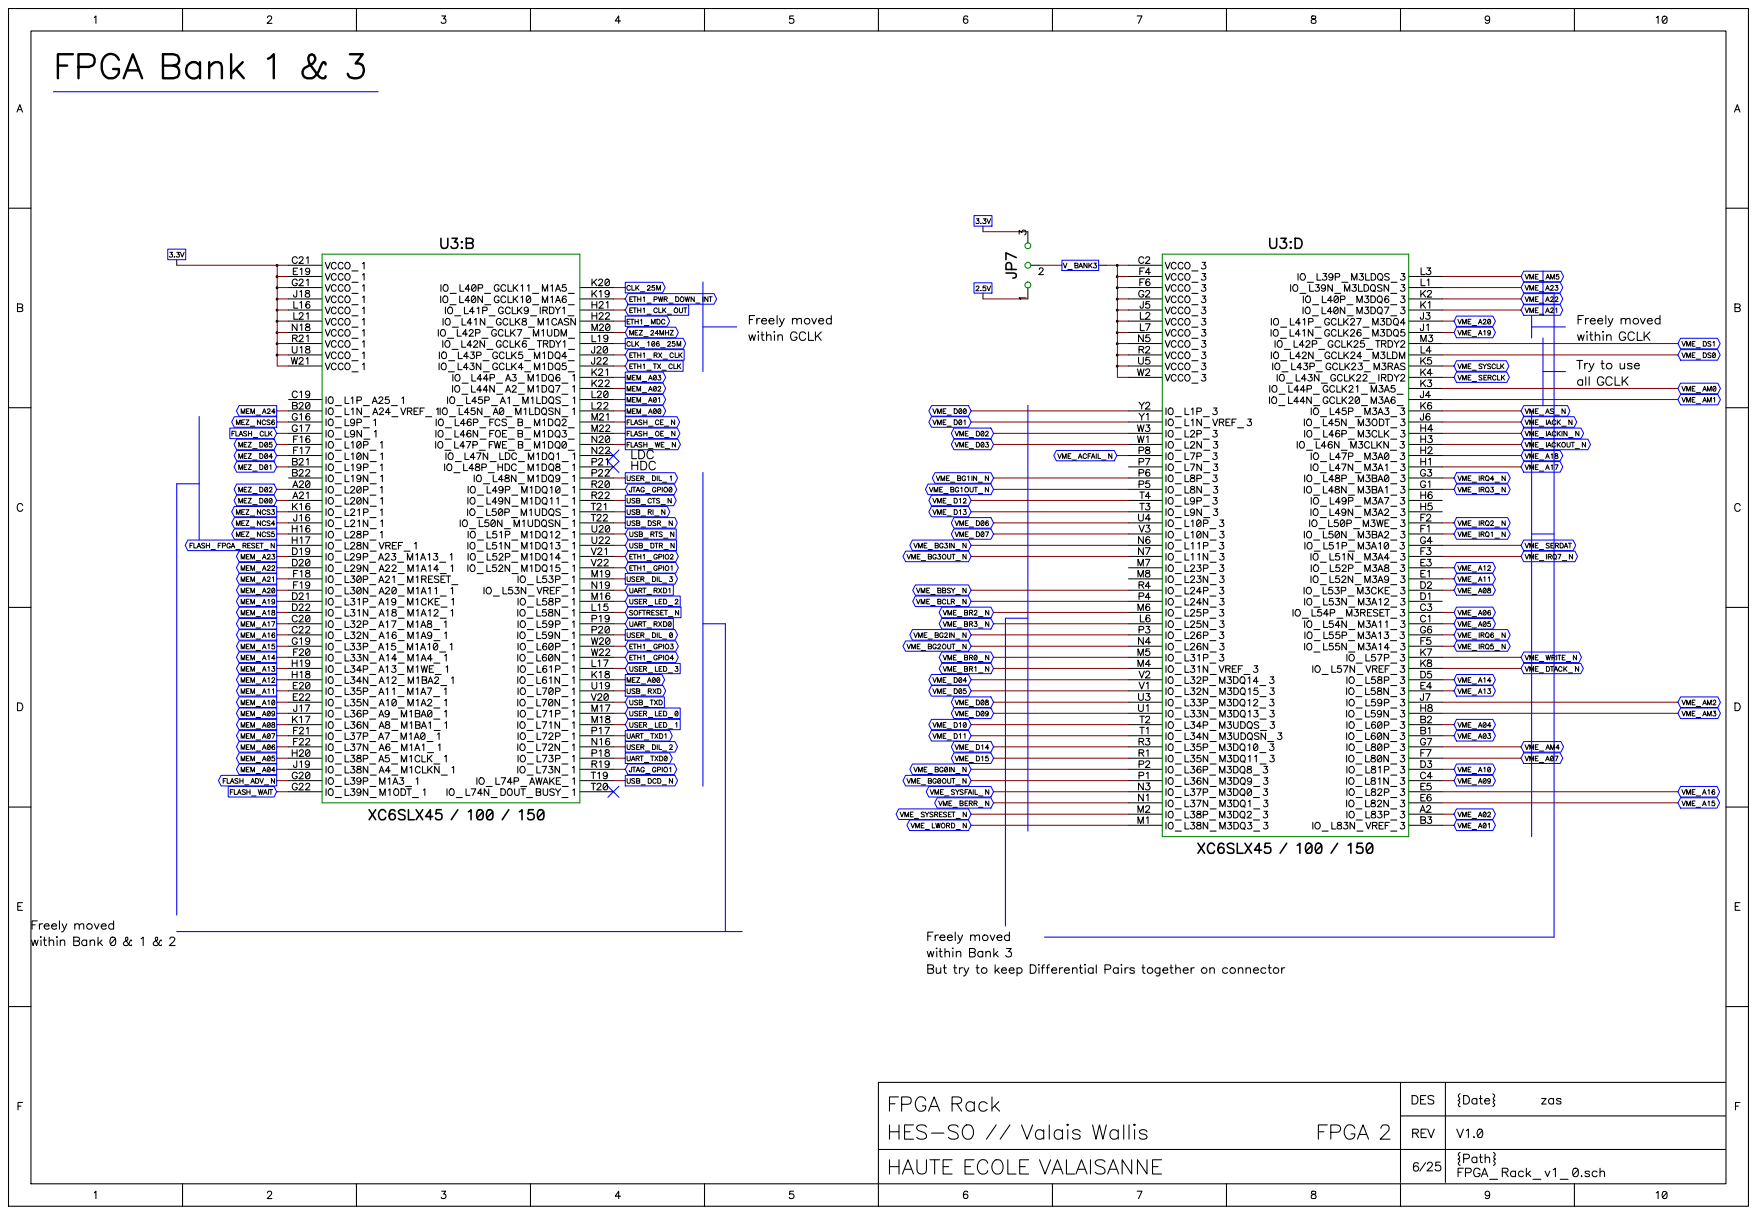
[picture p160: page 6]

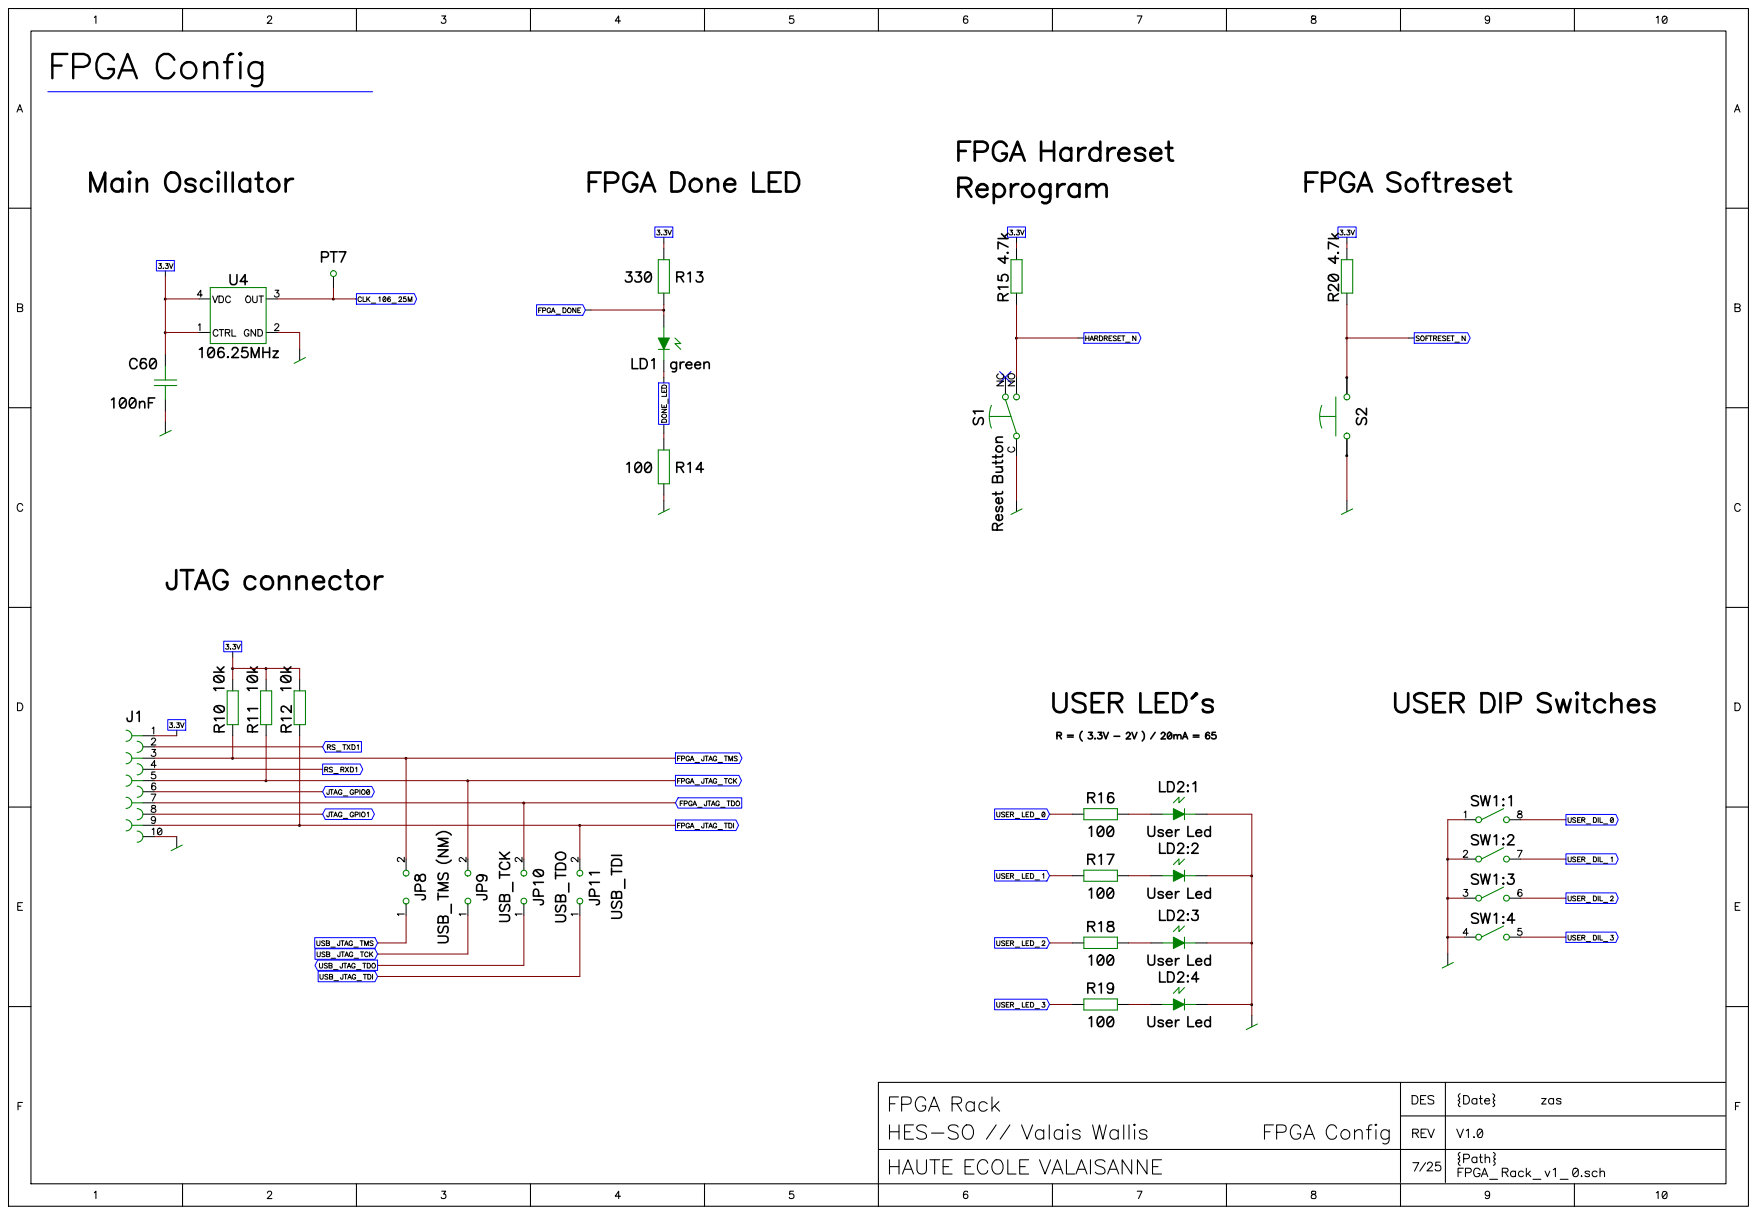
[picture p161: page 7]

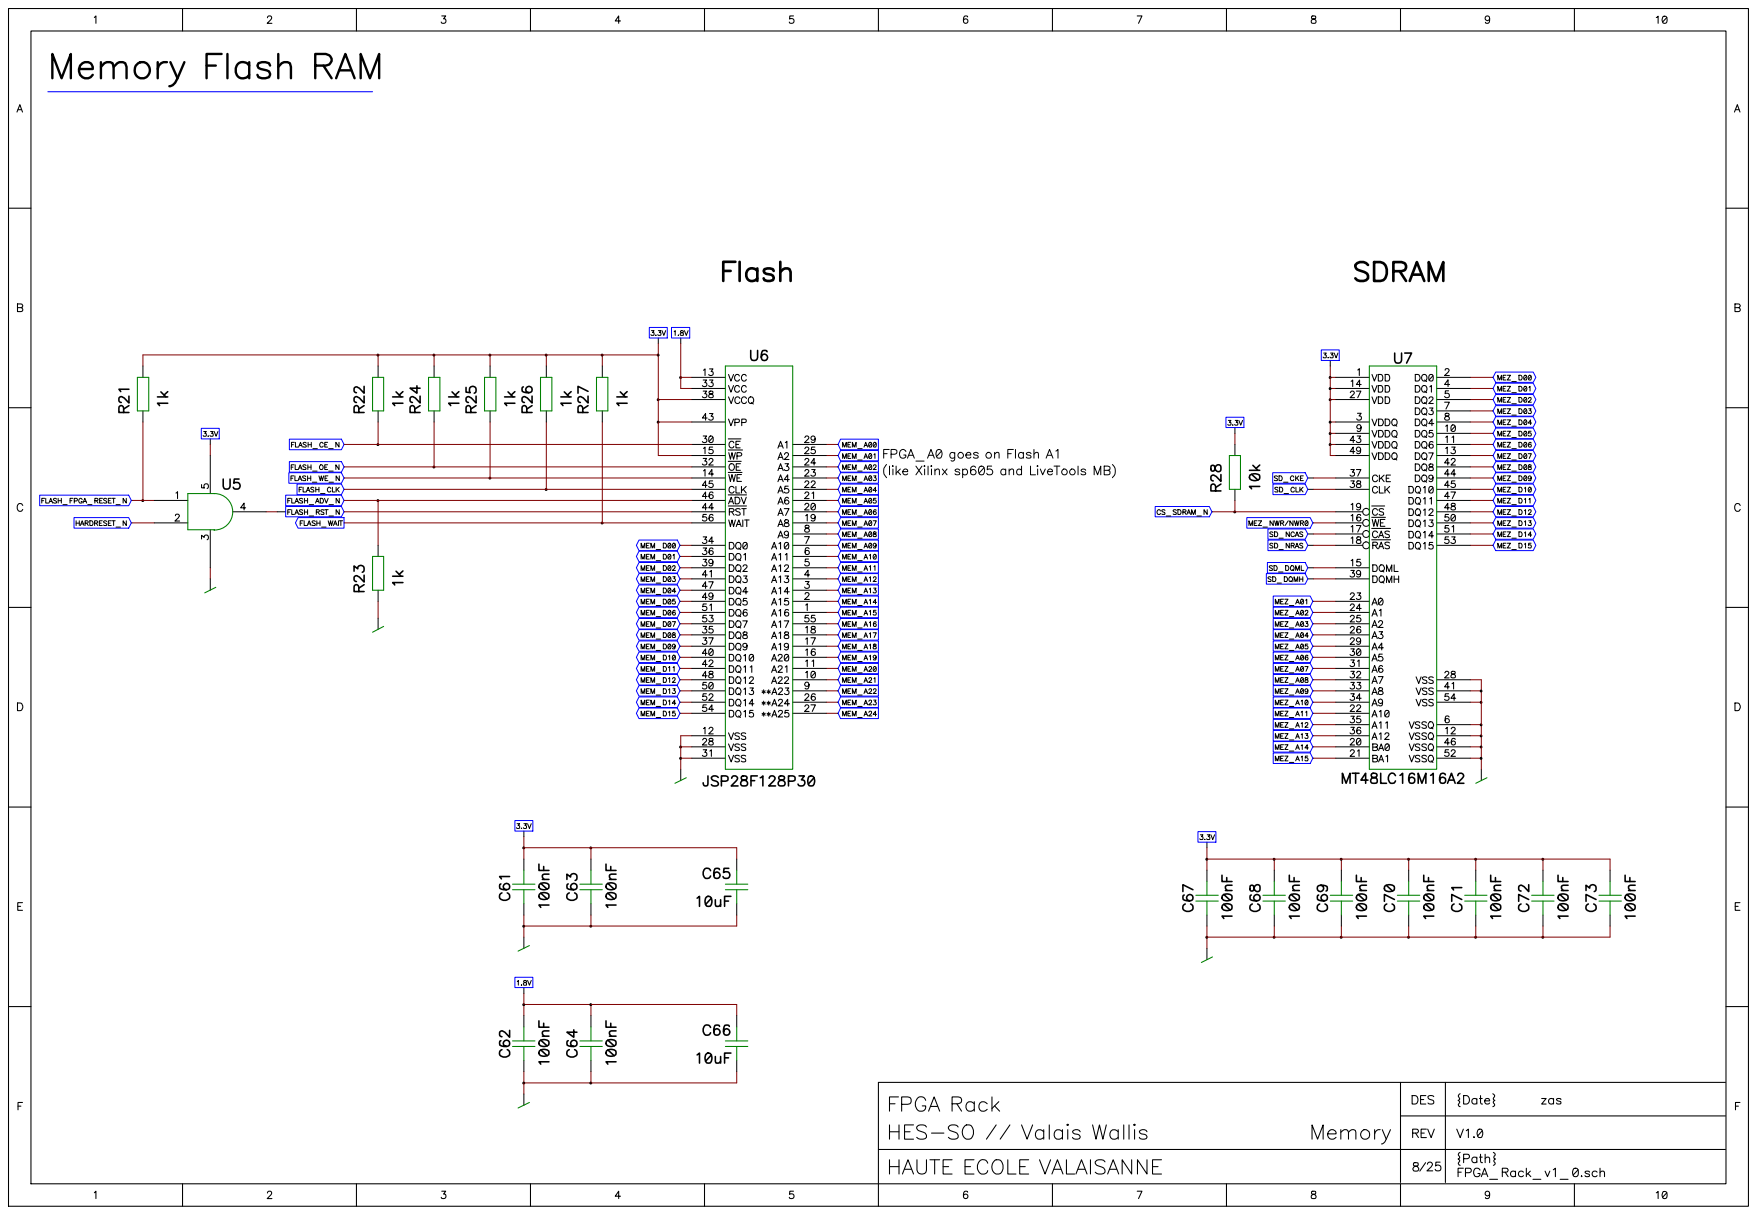
[picture p162: page 8]

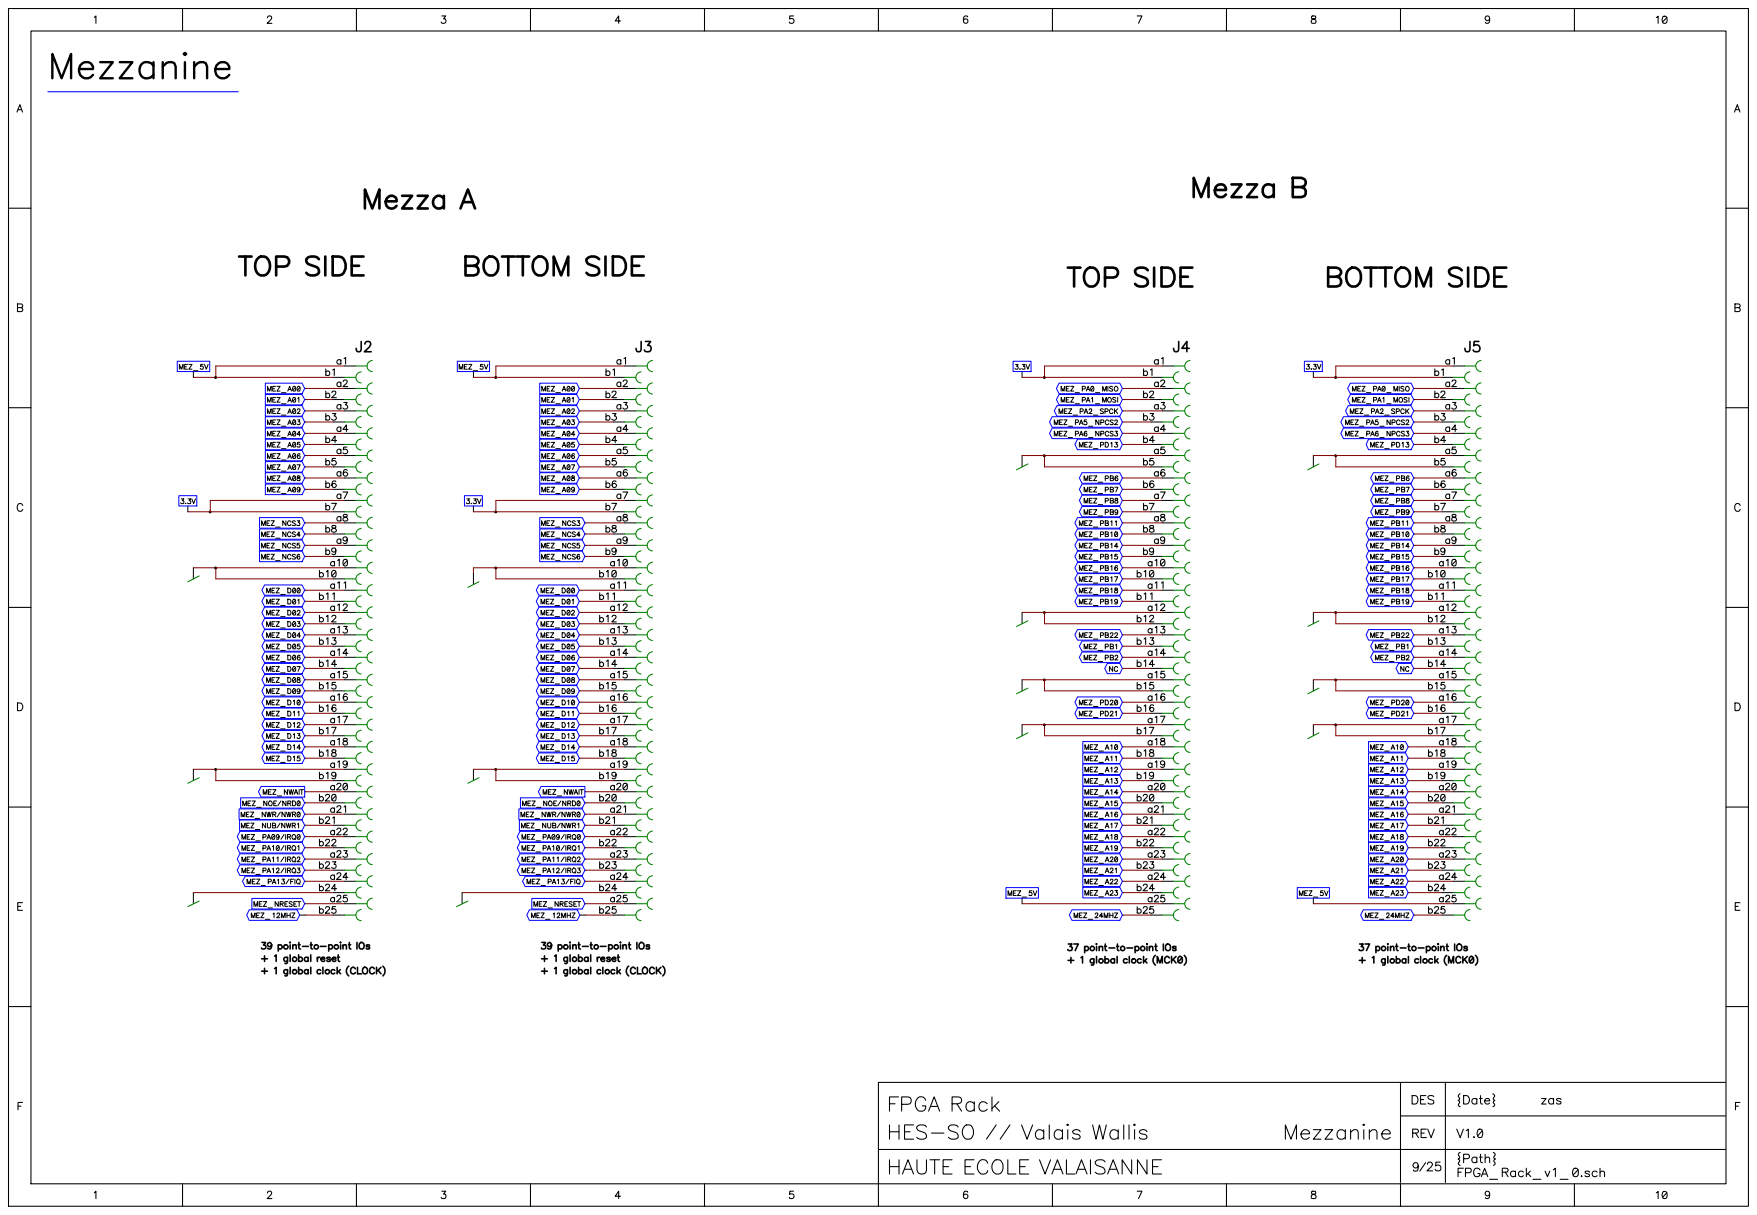
[picture p163: page 9]

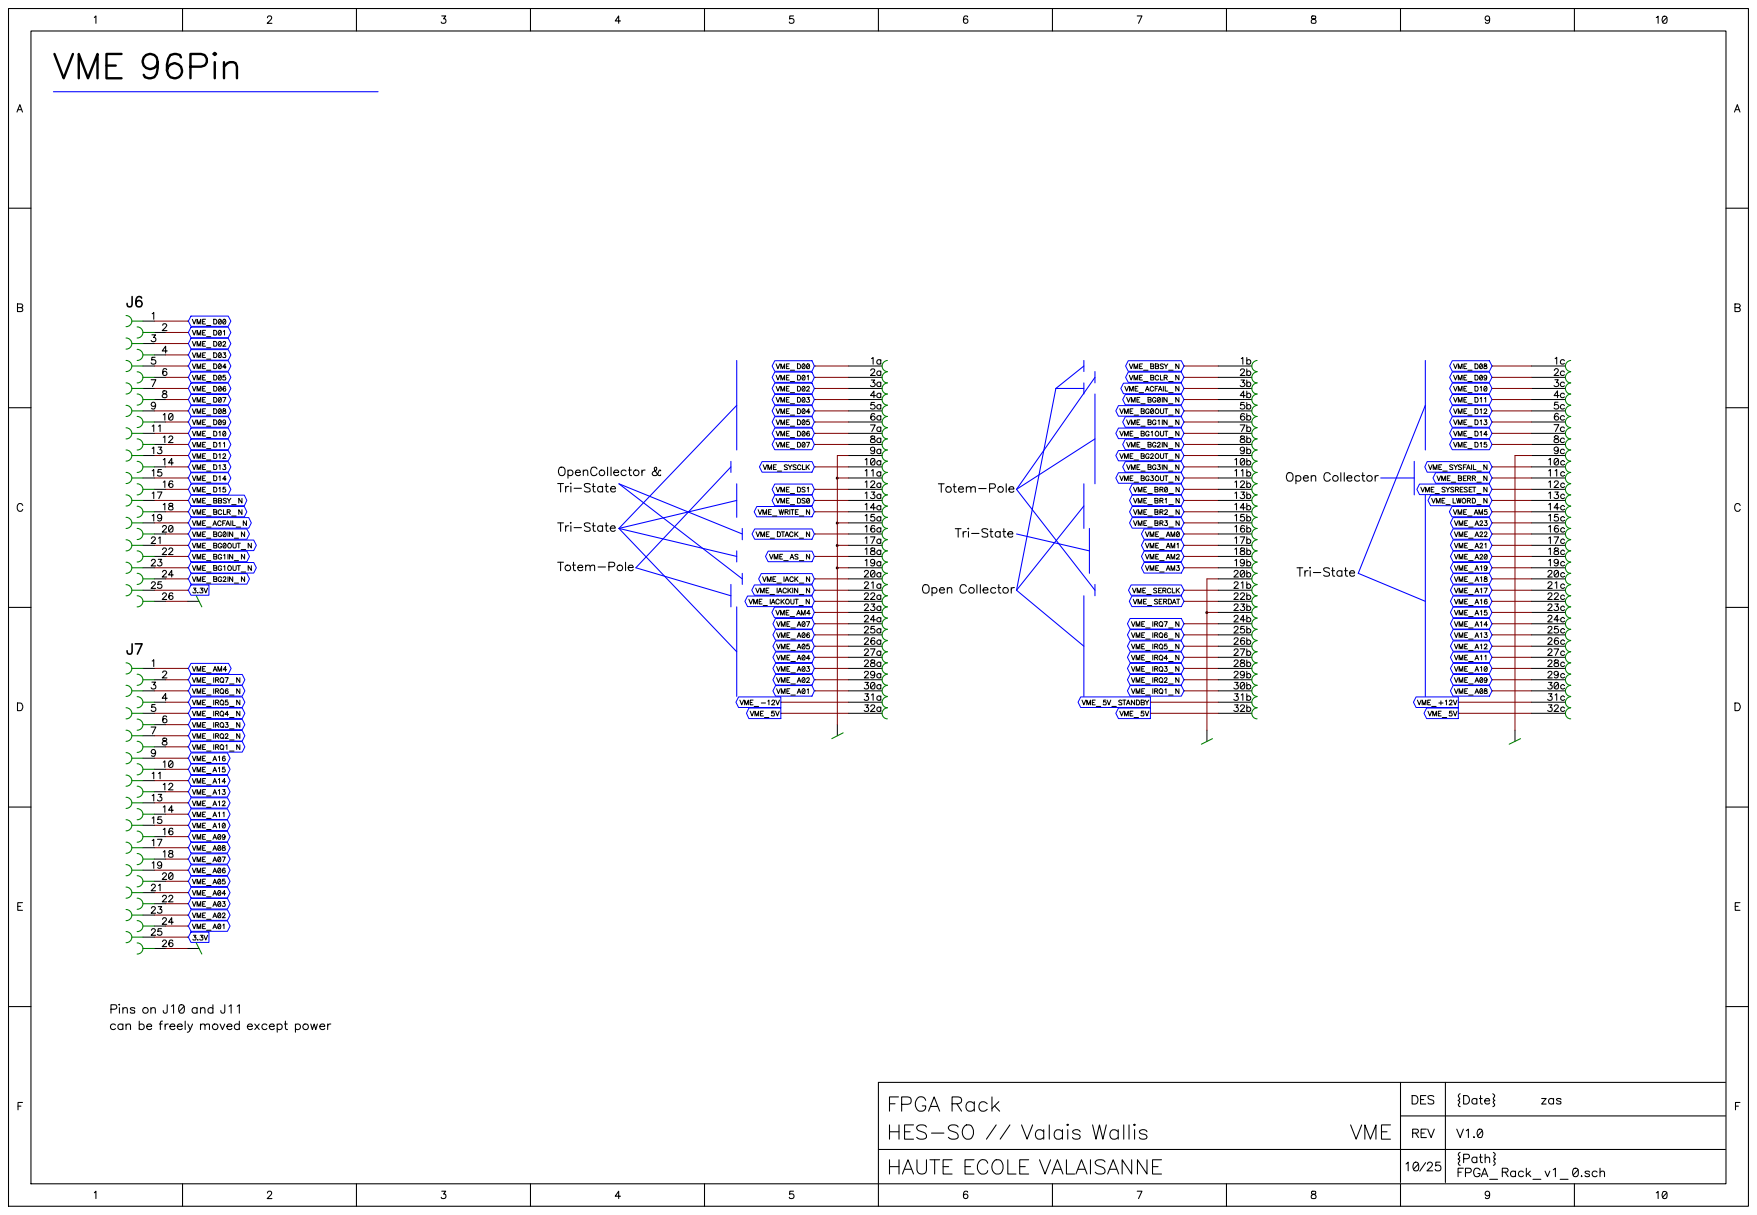
[picture p164: page 10]

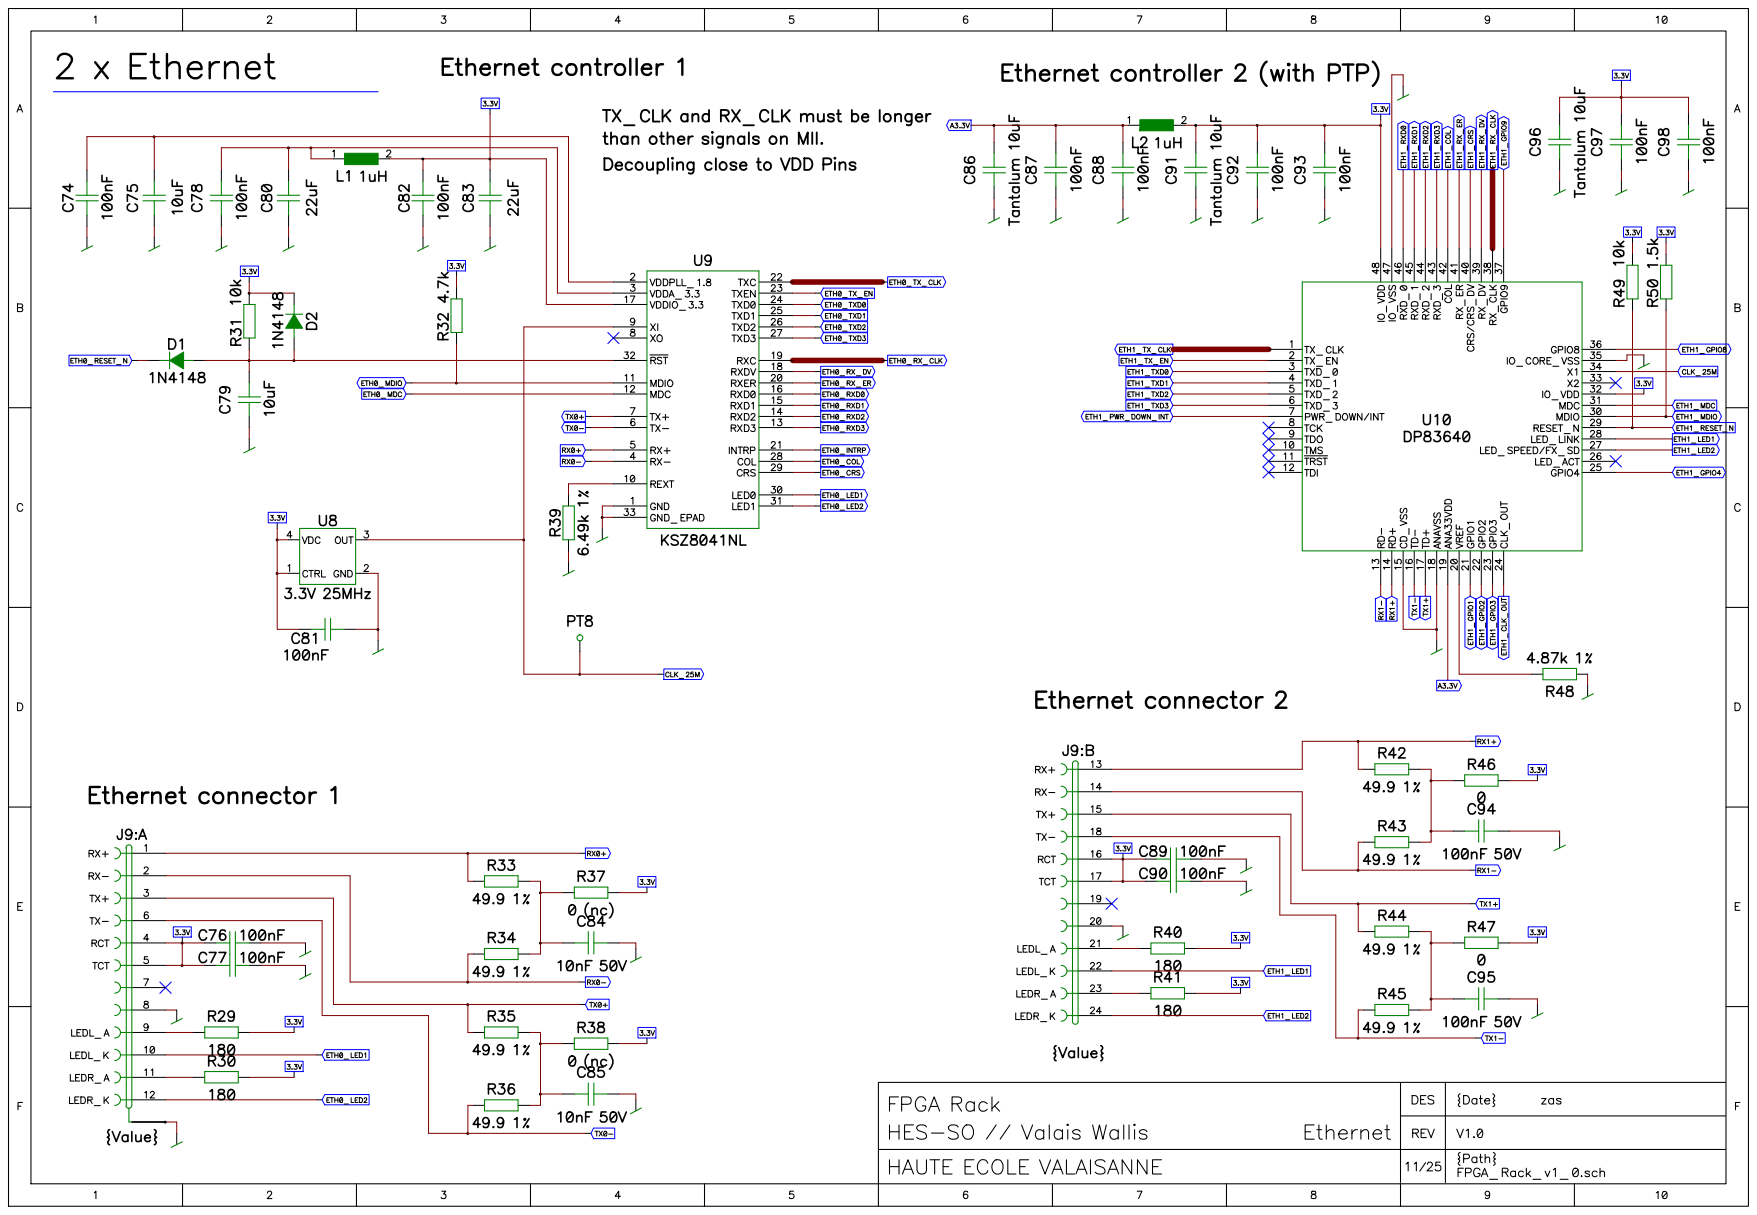
[picture p165: page 11]

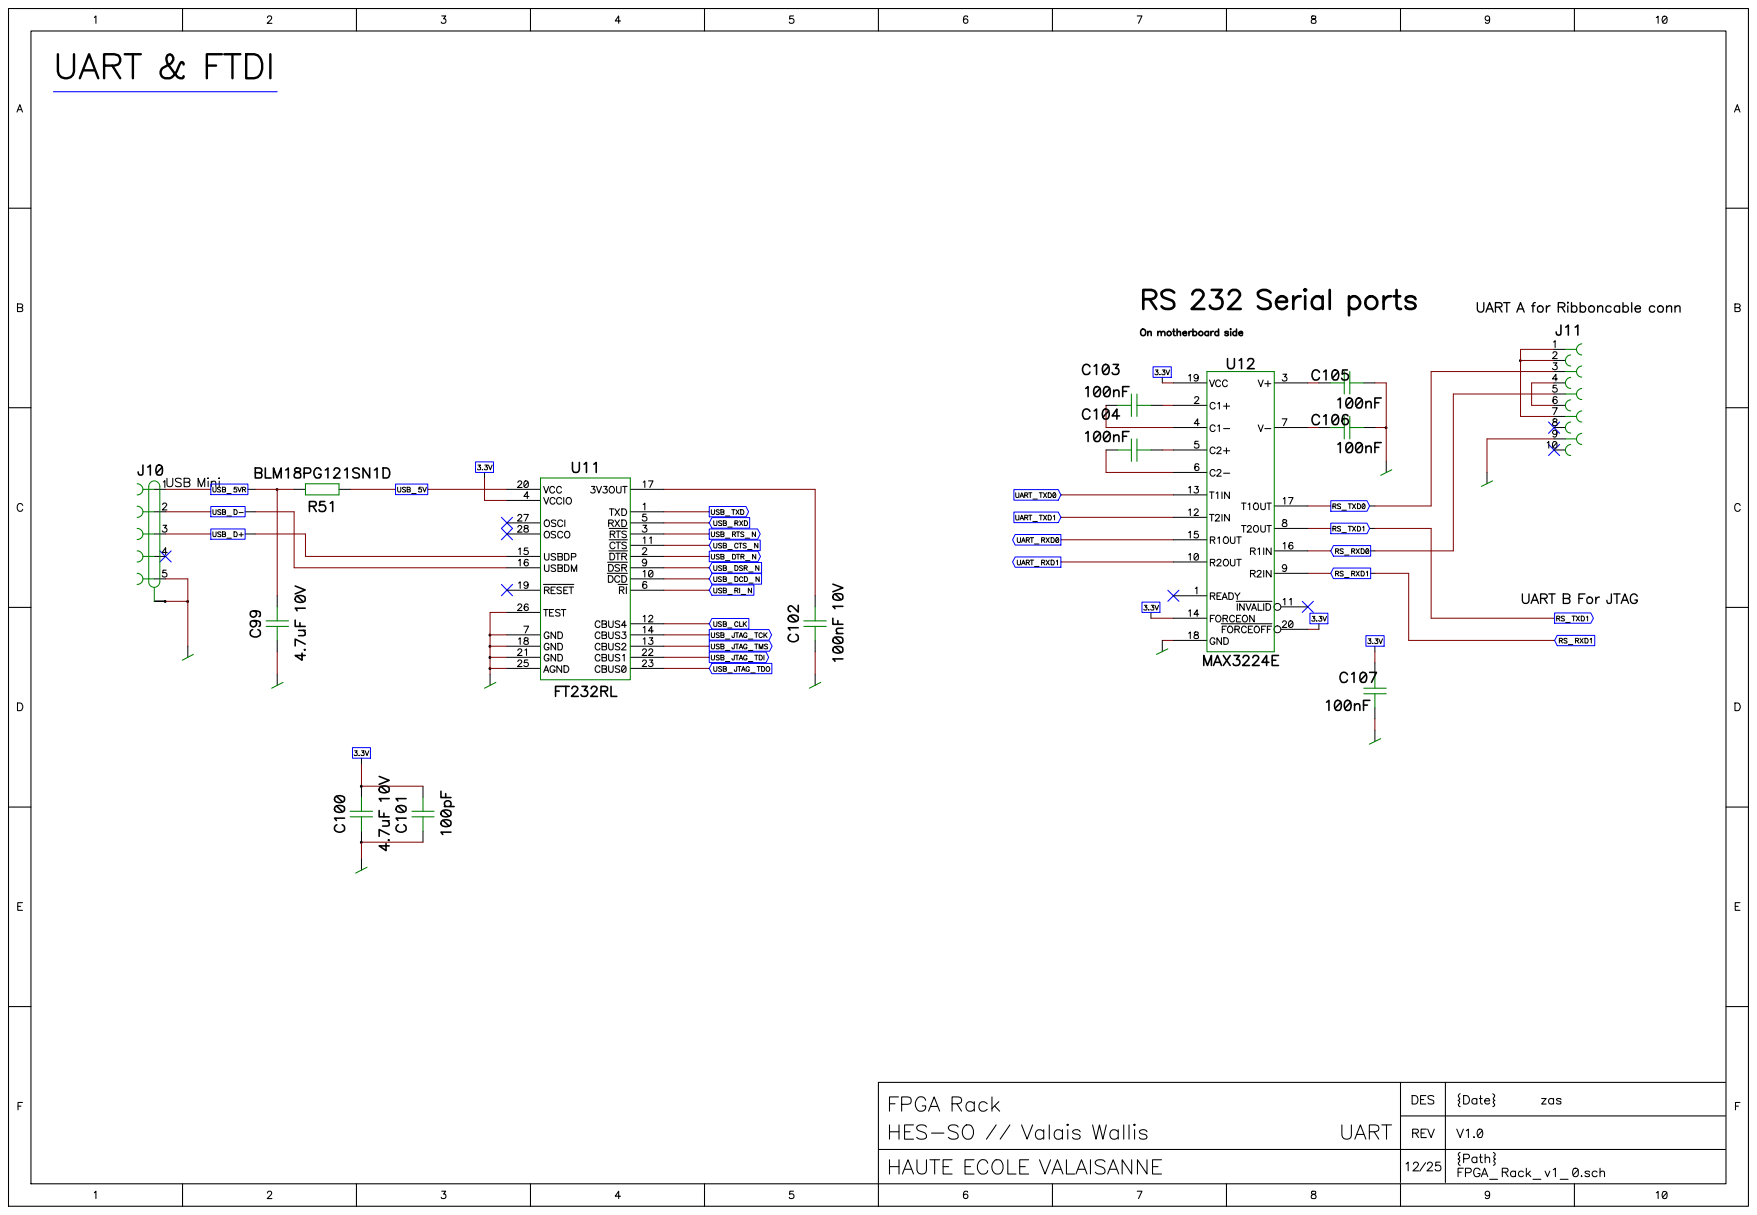
[picture p166: page 12]
