73jn/td-fpga-developing-board/Simulations/bridge_BLDC.asc

Sa_bot: nmos; ""
Sa_top: nmos; ""
Sb_bot: nmos; ""
Sb_top: nmos; ""
Sc_bot: nmos; ""
Sc_top: nmos; ""
V1: voltage; 24V
Named nets: Sa_top, Sa_bot, Sb_top, Sb_bot, Sc_top, Sc_bot, 0, A, B, C
Brushless DC
M
