73jn/td-fpga-developing-board/Simulations/AnalogIn.asc

C1: cap; 2n2
C2: cap; 47p
C3: cap; 47p
R1: res; 8k2
R2: res; 8k2
R3: res; 18k
R4: res; 18k
R5: res; 82
R6: res; 10k
U1: UniversalOpamp2
V1: voltage; 0
V2: voltage; 3.3
V3: voltage-; PULSE(0 0.4 0 0.01n 0.01n 10m 20m)
V4: voltage-; PULSE(0 0.4 10m 0.01n 0.01n 10m 20m)
Named nets: 0, 3.3V, VinP, VinM, Vout
.tran 100ms
