73jn/td-fpga-developing-board/(list of files, drawings)

Other design files:
FPGA-POETIC/FPGA_Board/LIBRAIRIE/SamacSys.PcbLib
FPGA-POETIC/FPGA_Board/LIBRAIRIE/SamacSys.SchLib
FPGA-POETIC/FPGA_Board/V1/Connector_0.SchDoc
FPGA-POETIC/FPGA_Board/V1/Ethernet_0.SchDoc
FPGA-POETIC/FPGA_Board/V1/FPGA_0.SchDoc
FPGA-POETIC/FPGA_Board/V1/FPGA_1.SchDoc
FPGA-POETIC/FPGA_Board/V1/FPGA_POETIC.PrjPcb
FPGA-POETIC/FPGA_Board/V1/HESSO Lanscape A2.SchDoc
FPGA-POETIC/FPGA_Board/V1/Supply_0.SchDoc
FPGA-POETIC/FPGA_Board/V1/UserInterface_0.SchDoc
FPGA-POETIC/FPGA_Board/V1_01/Connector_0_V1_01.SchDoc
FPGA-POETIC/FPGA_Board/V1_01/Ethernet_0_V1_01.SchDoc
FPGA-POETIC/FPGA_Board/V1_01/FPGA_0_V1_01.SchDoc
FPGA-POETIC/FPGA_Board/V1_01/FPGA_1_V1_01.SchDoc
FPGA-POETIC/FPGA_Board/V1_01/FPGA_POETIC_V1_01.PrjPcb
FPGA-POETIC/FPGA_Board/V1_01/HESSO Lanscape A2.SchDoc
FPGA-POETIC/FPGA_Board/V1_01/Supply_0_V1_01.SchDoc
FPGA-POETIC/FPGA_Board/V1_01/UserInterface_0_V1_01.SchDoc
FPGA-POETIC/Front_Pannel/FA_CPU_V01_1X.PcbDoc
FPGA-POETIC/Front_Pannel/FA_CPU_V01_1X.PrjPcb
FPGA-POETIC/Mezzanine_Board/V1_0/AD_0.SchDoc
FPGA-POETIC/Mezzanine_Board/V1_0/AD_1.SchDoc
FPGA-POETIC/Mezzanine_Board/V1_0/AD_3.SchDoc
FPGA-POETIC/Mezzanine_Board/V1_0/ANAlOG_MEZZANINE.PrjPcb
FPGA-POETIC/Mezzanine_Board/V1_0/Connector_0.SchDoc
FPGA-POETIC/Mezzanine_Board/V1_0/DAC_0.SchDoc
FPGA-POETIC/Mezzanine_Board/V1_0/HESSO Lanscape A2.SchDoc
FPGA-POETIC/Mezzanine_Board/V1_0/MEZZANINE-BOARD.PrjPcb
FPGA-POETIC/Mezzanine_Board/V1_0/Supply_0.SchDoc
FPGA-POETIC/Mezzanine_Board/V1_01/AD_0_V1_01.SchDoc
FPGA-POETIC/Mezzanine_Board/V1_01/AD_1_V1_01.SchDoc
FPGA-POETIC/Mezzanine_Board/V1_01/AD_3_V1_01.SchDoc
FPGA-POETIC/Mezzanine_Board/V1_01/ANAlOG_MEZZANINE1.01.PrjPcb
FPGA-POETIC/Mezzanine_Board/V1_01/ANAlOG_MEZZANINE_V1_01.PrjPcb
FPGA-POETIC/Mezzanine_Board/V1_01/Connector_0_V1_01.SchDoc
FPGA-POETIC/Mezzanine_Board/V1_01/DAC_0_V1_01.SchDoc
FPGA-POETIC/Mezzanine_Board/V1_01/Supply_0_V1_01.SchDoc
FPGA-POETIC/PCB_Project/PCB-FPGA.PcbDoc
FPGA-POETIC/ReferenceBoards/1_POETIC/POETIC_AD_input_V2/AD_0.SchDoc
FPGA-POETIC/ReferenceBoards/1_POETIC/POETIC_AD_input_V2/POETIC_AD_Input_V2.PcbDoc
FPGA-POETIC/ReferenceBoards/1_POETIC/POETIC_AD_input_V2/POETIC_AD_Input_V2.PrjPcb
FPGA-POETIC/ReferenceBoards/1_POETIC/POETIC_AD_input_V2/POETIC_AD_Input_V2_Panel.PcbDoc
FPGA-POETIC/ReferenceBoards/1_POETIC/POETIC_Backplane_V2/Connector_0.SchDoc
FPGA-POETIC/ReferenceBoards/1_POETIC/POETIC_Backplane_V2/Connector_1.SchDoc
FPGA-POETIC/ReferenceBoards/1_POETIC/POETIC_Backplane_V2/Connector_2.SchDoc
FPGA-POETIC/ReferenceBoards/1_POETIC/POETIC_Backplane_V2/Connector_3.SchDoc
FPGA-POETIC/ReferenceBoards/1_POETIC/POETIC_Backplane_V2/POETIC_Backplane_V2.PcbDoc
FPGA-POETIC/ReferenceBoards/1_POETIC/POETIC_Backplane_V2/POETIC_Backplane_V2.PrjPcb
FPGA-POETIC/ReferenceBoards/1_POETIC/POETIC_Backplane_V2/Supply.SchDoc
FPGA-POETIC/ReferenceBoards/1_POETIC/POETIC_Processor_V2/AD_0.SchDoc
FPGA-POETIC/ReferenceBoards/1_POETIC/POETIC_Processor_V2/AD_1.SchDoc
FPGA-POETIC/ReferenceBoards/1_POETIC/POETIC_Processor_V2/AD_2.SchDoc
FPGA-POETIC/ReferenceBoards/1_POETIC/POETIC_Processor_V2/Connector_0.SchDoc
FPGA-POETIC/ReferenceBoards/1_POETIC/POETIC_Processor_V2/CPLD.SchDoc
FPGA-POETIC/ReferenceBoards/1_POETIC/POETIC_Processor_V2/Mezz_Board.SchDoc
FPGA-POETIC/ReferenceBoards/1_POETIC/POETIC_Processor_V2/POETIC_Processor_V2.PrjPcb
FPGA-POETIC/ReferenceBoards/1_POETIC/POETIC_Processor_V2/POETIC_Processor_V2b.PcbDoc
FPGA-POETIC/ReferenceBoards/1_POETIC/POETIC_Processor_V2/Processor.SchDoc
FPGA-POETIC/ReferenceBoards/1_POETIC/POETIC_Processor_V2/Supply.SchDoc
FPGA-POETIC/ReferenceBoards/FPGA-Rack_v1/04_PCB/FPGA_Rack_v1_0.pcb
FPGA-POETIC/ReferenceBoards/FPGA-Rack_v1/04_PCB/Imported FPGA_Rack_v1_0.PrjPcb/Board.SCHDOC
FPGA-POETIC/ReferenceBoards/FPGA-Rack_v1/04_PCB/Imported FPGA_Rack_v1_0.PrjPcb/Cover.SCHDOC
FPGA-POETIC/ReferenceBoards/FPGA-Rack_v1/04_PCB/Imported FPGA_Rack_v1_0.PrjPcb/Ethernet.SCHDOC
FPGA-POETIC/ReferenceBoards/FPGA-Rack_v1/04_PCB/Imported FPGA_Rack_v1_0.PrjPcb/First_Sheet.SCHDOC
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
