73jn/td-fpga-developing-board/FPGA/Messy_test/hdl/poetic_tester_test.vhd

--
-- VHDL Architecture Messy_test.poetic_tester.test
--
-- Created:
--          by - jeann.UNKNOWN (DESKTOP-V46KISN)
--          at - 11:10:26 11.08.2021
--
-- using Mentor Graphics HDL Designer(TM) 2019.2 (Build 5)
--
ARCHITECTURE test OF poetic_tester IS
  constant clockPeriod: time := (1.0/clockFrequency) * 1 sec;
  signal sClock: std_uLogic := '1';
BEGIN
  ------------------------------------------------------------------------------
                                                              -- clock and reset
  sClock <= not sClock after clockPeriod/2;
  clock <= transport sClock after clockPeriod*9/10;
  reset <= '1', '0' after 2*clockPeriod;
  
  enable <= '0', '1' after 1 us;
  P <= '0', '1' after 1 us;
  I <= '0', '1' after 1 us;
  D <= '0', '1' after 1 us;
END ARCHITECTURE test;
