73jn/td-fpga-developing-board/(commit log)

2021-05-17 Add Schema Block, LtSpice Simulation, Matlab sample renderer, and PCB files of previous projects
    [20120427_FPGARack_command1.xls, 20120427_FPGARack_command1.xlsx, 20140714_FPGARack_command.xls, AD_0.SchDoc, AD_1.SchDoc, AD_2.SchDoc, Alim_BOT.pcb, Alim_TOP.pcb]
2021-05-17 Add sample sine200k in pdf, change in schema block
2021-05-19 Order file and schema block
    [FichierDeCommandeFpgaDevelopingBoard.xls]
2021-05-20 Schematic Altium
    [FPGA-1.SchDoc, FPGA-2.SchDoc, FPGA-3.SchDoc, FPGA-4.SchDoc, FPGA-5.SchDoc, FPGA-6.SchDoc, FPGA-7.SchDoc, FPGA-8.SchDoc]
2021-05-25 Working on schematic
    [Connector.SchDoc, FPGA-1.SchDoc, FPGA-2.SchDoc, FPGA-3.SchDoc, FPGA-4.SchDoc, FPGA-5.SchDoc, FPGA-6.SchDoc, FPGA-7.SchDoc]
2021-05-25 V0.1 Mezzanine
    [1WB_DS2406_EPROM.SchDoc, 1WB_DS2406_PROTECTED.SchDoc, 3M Footprints.PcbLib, ADC_MAX1037.SchDoc, AD_0.SchDoc, AD_1.SchDoc, AD_3.SchDoc, AMCC Footprints.PcbLib]
2021-05-26 Some modification to the Mezzanine Schematique (differential) & Connector Locked on PCB
    [AD_0.SchDoc, AD_1.SchDoc, AD_3.SchDoc, Connector_0.SchDoc, DAC_0.SchDoc, MEZZANINE-BOARD.PrjPcb, Supply_0.SchDoc]
2021-05-26 Working on Mezza schematic
    [AD_0.SchDoc, AD_1.SchDoc, AD_3.SchDoc, Connector_0.SchDoc, DAC_0.SchDoc, HESSO Lanscape A2.SchDoc, MEZZANINE-BOARD.PrjPcb, Supply_0.SchDoc]
2021-05-27 Last version of mezzanine schematic
    [AD_0.SchDoc, AD_1.SchDoc, Connector_0.SchDoc, DAC_0.SchDoc, MEZZANINE-BOARD.PrjPcb, Mezz_Board.SchDoc, Supply_0.SchDoc]
2021-05-27 Working On Main Board
    [FPGA-Supply.SchDoc, FPGA.SchDoc]
2021-05-28 FPGA Board : Power Supply Done !
    [Connector_0.SchDoc, FPGA_0.SchDoc, FPGA_1.SchDoc, HESSO Lanscape A2.SchDoc, PCB_Project.PrjPcb, Supply_0.SchDoc]
2021-05-31 Working on ethernet part
    [Connector_0.SchDoc, PCB_Project.PrjPcb, Supply_0.SchDoc, UserInterface_0.SchDoc]
2021-05-31 Phy Ethernet, Mezzanine Connector pinout changes on the mezza board
    [AD_0.SchDoc, AD_1.SchDoc, AD_3.SchDoc, Connector_0.SchDoc, DAC_0.SchDoc, Ethernet_0.SchDoc, FPGA_0.SchDoc, HESSO Lanscape A2.SchDoc]
2021-06-01 Need to redo the mezz connector on the fpga board, near the end of the schematic, report
    [Connector_0.SchDoc, Ethernet_0.SchDoc, FPGA_0.SchDoc, FPGA_1.SchDoc, MEZZANINE-BOARD.PrjPcb, PCB-Mezzanine.PcbDoc, PCB_Project.PrjPcb, Supply_0.SchDoc]
2021-06-04 Rapport and planning
    [AD_3.SchDoc, Gestion.xlsx, PCB_Project.PrjPcb, PlanningTD.xlsx, Supply_0.SchDoc]
2021-06-08 Intermediate presentation, order xlsx
    [FichierDeCommandeFpgaDevelopingBoard.xls, Mezza_FichierDeCommandeFpgaDevelopingBoard.xls]
2021-06-14 Need to add usb c for fpga board
    [Connector_0.SchDoc, Ethernet_0.SchDoc, FPGA_0.SchDoc, FichierDeCommandeFpgaDevelopingBoard.xls, Mezza_FichierDeCommandeFpgaDevelopingBoard.xls, PCB_Project.PrjPcb]
2021-06-17 Add fpga hdl designer
    [Connector_0.SchDoc, FPGA_0.SchDoc, FPGA_1.SchDoc, FichierDeCommandeFpgaDevelopingBoard.xls, Mezza_FichierDeCommandeFpgaDevelopingBoard.xls, PCB_Project.PrjPcb, Supply_0.SchDoc]
2021-06-22 VHDL very cool
    [FichierDeCommandeFpgaDevelopingBoard.xls]
2021-06-30 Add ADC Simul
    [FichierDeCommandeFpgaDevelopingBoard.xls, Mezza_FichierDeCommandeFpgaDevelopingBoard.xls]
2021-07-01 Fix ADC Model and Add DC motor Model
    [ADC_ads7886_decoder.vhd, AD_ADS7886.vhd, motor_dc.vhd, poetic_tester_test.vhd]
2021-07-06 Fix PID, regulation is working
    [converterSignedToUnsigned_signed_to_unsigned.vhd, converter_std_uLogic_to_signed.vhd, motor_dc.vhd, poetic_tester_test.vhd, regulator_pid.vhd]
2021-07-08 Can be flash on the board, ucf has a probleme with somes pins...
    [clockGenerator_clockDivider.vhd]
2021-07-13 Try to read on uart the ADC
2021-07-13 CH0 on Uart is working
2021-07-14 New Board with DAC, not finished
2021-07-14 DAC IS WORKING !
    [poetic_circuit_pad.csv]
2021-07-15 Fix SerialAsciiDecoder
    [poetic_circuit_pad.csv]
2021-07-15 Fix uart controller
    [poetic_circuit_pad.csv]
2021-07-15 Fix asciiDecoder
    [FichierDeCommandeFpgaDevelopingBoard.xls, poetic_circuit_pad.csv]
2021-07-16 Faster ADC and DAC
    [FichierDeCommandeFpgaDevelopingBoard.xls, poetic_circuit_pad.csv]
2021-07-21 Add resistor & capa in command file
    [FichierDeCommandeFpgaDevelopingBoard.xls]
2021-07-21 Add pinning xslx
    [Pinning_BP.xlsx]
2021-07-22 PID is shitty, i have to redo everything :(
    [poetic_circuit_pad.csv]
2021-07-23 P is working on the board, i not tested but simulation ok
    [poetic_circuit_pad.csv]
2021-07-23 Integral is working, tested on the board
    [poetic_circuit_pad.csv]
2021-07-23 BLDC Speed Detector is working
2021-07-27 Next step is bldc testing
2021-07-27 Try to pilot bldc, not working yet
    [poetic_circuit_pad.csv]
2021-07-28 Regulation with analog speed on CH0
    [poetic_circuit_pad.csv]
2021-07-30 Change Generics and add constant to the clock divider
    [poetic_circuit_pad.csv]
2021-07-30 Fix maxspeed problem with ADC, no 50 ohm line terminaison, so we have to delay the read data... but work at 10MHz perfectly
    [poetic_circuit_pad.csv]
2021-08-05 Working on report, actually simul is ok
    [FichierDeCommandeFpgaDevelopingBoard.xls, poetic_circuit_pad.csv]
2021-08-09 Add simulation for ADC, fix adc
    [poetic_circuit_pad.csv]
2021-08-11 Fix Uart & Add uml state machine for uart
    [motor_dc.vhd, poetic_tester_test.vhd, regulator_PDI3.vhd, serialAsciiDecoder_serialAsciiDecoder.vhd]
2021-08-17 order files changes
    [FichierDeCommandeFpgaDevelopingBoard.xls, Mezza_FichierDeCommandeFpgaDevelopingBoard.xls]
2021-08-17 work in real life, need to fix the clock divider
    the frequency of the dac was too high. It has been reduce about 20MHz
    [poetic_circuit_pad.csv]
2021-08-19 Order all the folders
    [1WB_DS2406_EPROM.SchDoc, 1WB_DS2406_PROTECTED.SchDoc, 20120427_FPGARack_command1.xls, 20120427_FPGARack_command1.xlsx, 20140714_FPGARack_command.xls, 3M Footprints.PcbLib, 950V_Measure.SchDoc, ADC_MAX1037.SchDoc]
